ubparot/AQUAScan/deliverables/aquascan-nationals-update/AquaScan_Nationals_Update_Pages.docx

NATIONALS DEVELOPMENT UPDATE MAP

AquaScan did not remain frozen after the TSA States submission. The earlier portfolio documents the system that proved the core concept: a mobile vessel, deployable probe, Unity visualization, and field data workflow. The pages identified below document the next engineering cycle completed for Nationals.

How to read this revision: the original pages remain as evidence of the States baseline. These inserted pages show the problem identified after States, the refinement made, and the verified result.

Post-States Development Sequence

Stage | Engineering Focus | Result
States baseline | Prove collection, control, and visualization concept | Unity-based interface and working depth-aware data workflow
Field-access refinement | Reduce setup friction and improve operator access | Browser-based mission-control dashboard
Control-chain refinement | Improve communication reliability and safety feedback | WebSocket, ESP32, Arduino Mega, ESC, winch, and RS-485 telemetry chain
Data-use refinement | Move from viewing measurements toward interpreting patterns | MARIS experimental predictive-analysis model and research-analysis tools
Verification | Test software behavior and model pipeline | 26 web tests, production build, lint, and 7 ML tests passed on June 14, 2026

Inserted Page Guide

- Pages 16A-16B: web mission control and embedded communications iteration.
- Page 16C: MARIS experimental predictive analysis, placed directly before “What This Data Can Reveal.”
- Page 28A: problem-change-evidence-impact iteration record and current verification results.
- Page 29A: post-States development record showing continued engineering activity.

Current System Position

AquaScan is currently a working integrated prototype for calm, shallow, and sheltered water environments. Manual control, telemetry, mission replay, data visualization, probe communications, and the training/export path for MARIS have been implemented. Full autonomous route execution and field-validated MARIS inference remain future development.

POST-STATES ITERATION: FROM UNITY PROTOTYPE TO WEB MISSION CONTROL

The Unity interface shown on the preceding original portfolio page was the States baseline. It demonstrated that AquaScan data could be replayed, mapped, and connected to the vessel. After States, the team identified a field-use limitation: Unity required a dedicated installed application and made it harder to open the controls quickly on different operator devices.

Iteration decision: retain the proven mission-data and control concepts, but rebuild the operator interface as a browser-based field dashboard that can run locally and be opened from devices on the same network.

States Baseline | Post-States Web Refinement | Engineering Benefit
Unity desktop application | Local browser-based dashboard | Faster access and no Unity installation on the operator device
Mission replay and map layers | Replay, route planning, saved project files, and exportable bundles | Supports repeatable mission preparation and review
Live control concept | Direct WebSocket connection to the boat with visible connection state | Improves field awareness and troubleshooting
Single presentation-focused layout | Simple/advanced drive modes, light/dark themes, and tabbed controls | Separates essential control from detailed diagnostics

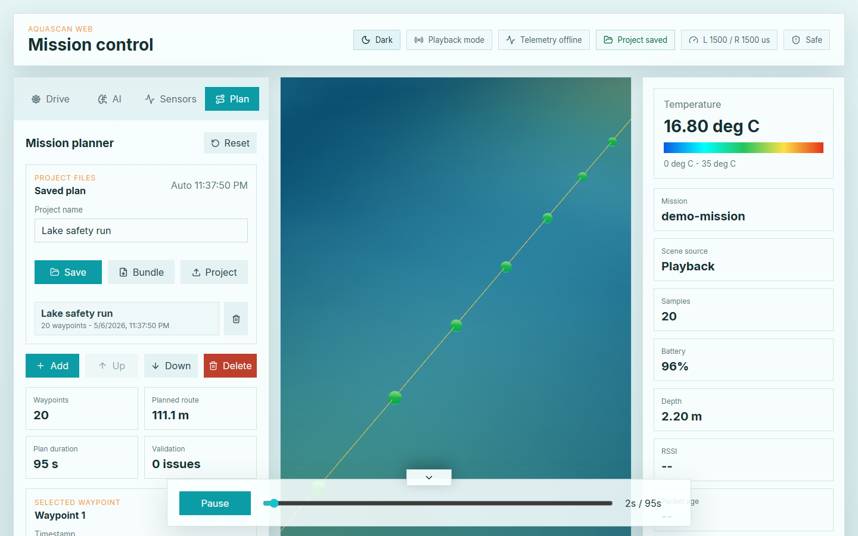
[picture p5: figure]

Current web mission planner showing saved route data, validation status, playback, and telemetry.

- Preserved capability: CSV/JSON mission loading, GPS route projection, sample points, heat maps, and timeline playback.
- Added capability: mission-plan editing, local project saving, preflight checks, direct live control, and browser-accessible operation.
- Current validation: the web application passes 26 automated tests, production build, and lint checks.

WEB FIELD SYSTEM AND EMBEDDED COMMUNICATIONS ITERATION

The interface change was paired with a deeper electronics and firmware refinement. The post-States system separates high-level operator commands, motor control, and probe sensing across communication links chosen for each task.

Current End-to-End Control and Data Path

Link | Current Function | Reason for Refinement
Browser dashboard → ESP32 | WebSocket commands, status, arming, E-stop, and live telemetry | Provides direct network control and immediate operator feedback
ESP32 → Arduino Mega | Full-duplex hardware UART control bridge | More reliable than the earlier bridge approach and keeps USB debug available
Arduino Mega → ESCs/winch | Applies motor pulses and deployment commands | Centralizes real-time actuator control and neutral-output behavior
Arduino Mega ↔ probe | Half-duplex RS-485 sensor communication | Supports longer tether communication and separates sensor traffic from drive control
Telemetry → dashboard | Sensor values, battery, RSSI, depth, motor output, and status | Turns hidden system state into visible diagnostic evidence


Browser mission-control dashboard showing route visualization, operator controls, and live system status.

Safety and Reliability Behaviors

- Safe startup: the system begins disarmed and commands neutral motor output.
- Loss-of-command response: disconnects, malformed messages, or command timeout force neutral output.
- Operator override: E-stop is visible in the dashboard and latches until reset.
- Debug visibility: Arduino and ESP32 status output makes command sequence, arm state, winch state, and motor outputs inspectable.

MARIS: EXPERIMENTAL PREDICTIVE ANALYSIS

MARIS is AquaScan’s first-pass machine-learning model for turning structured mission data into predictive research signals. It is an implemented proof of concept, not a field-validated decision system. MARIS demonstrates how future AquaScan missions could move beyond displaying measurements and begin forecasting or flagging conditions that deserve closer investigation.

Accurate framing: MARIS has been trained, evaluated, and exported as an ONNX model. The current primary dashboard still uses a transparent heuristic fallback while larger independent field datasets and live model integration are developed.

What MARIS Produces

- Current dissolved oxygen estimate: provides the model’s present-condition regression output.
- Dissolved oxygen forecasts: predicts values at +30, +60, and +120 minutes.
- Bloom-risk probability: identifies combinations of conditions associated with elevated bloom risk.
- Anomaly probability: flags unusual or potentially concerning water-quality patterns.

Development Evidence | Current Result | Interpretation
Training data | 3 real missions + 12 synthetic missions; 1,158 windows | Sufficient for proof of concept, not broad field validation
Evaluation data | 232 evaluation windows | Preliminary internal evaluation
Oxygen RMSE | 1.92 mg/L | Shows the current model still requires accuracy improvement
Forecast RMSE | 2.08 mg/L | Useful as a development benchmark, not a validated forecast claim
Bloom accuracy | 59.5% | Early-stage result; larger labeled datasets are required
Anomaly accuracy | 93.5% | Promising internal result, subject to label and dataset limitations
ONNX export | Validated; max output difference 0.00000095 | Confirms exported model matches the PyTorch output


Current dashboard research-analysis interface; the visible fallback label prevents experimental output from being presented as validated inference.

NATIONALS ITERATION EVIDENCE: PROBLEM → CHANGE → EVIDENCE → IMPACT

The largest post-States refinement was not one isolated feature. It was a system-level iteration focused on field usability, communications reliability, diagnostic visibility, and future data interpretation.

Problem Identified | Refinement Made | Evidence Available | Impact
Unity was effective for demonstration but less convenient across field devices. | Rebuilt the operator interface as a local React/Vite web dashboard. | Current dashboard screenshots; passing build and automated tests. | Faster access and a clearer path to use on laptops or tablets.
The earlier communications chain exposed limited diagnostic information. | Added explicit WebSocket status, sequence tracking, hardware UART bridge, and RS-485 probe telemetry. | Firmware source, serial-monitor output, and UI telemetry cards. | Makes failures easier to locate and system state easier to verify.
Operator controls needed stronger safety behavior. | Added disarmed startup, neutral timeout behavior, arm/disarm state, and latched E-stop. | Control contract and automated drive-mapping tests. | Reduces risk of unintended motor output during setup or communication loss.
Mission data existed as CSV/JSON but was difficult to organize as a repeatable project. | Added mission planning, validation, local project saving, and exportable bundles. | Saved-plan UI and route-tool tests. | Supports repeatable setup, review, and communication of mission data.
Visualizations explained the past but did not explore predictive use. | Developed MARIS training/export pipeline and research-analysis scaffolding. | PyTorch/ONNX artifacts, metrics report, and 7 passing ML tests. | Demonstrates a realistic future path while clearly documenting present limitations.

Verified June 14, 2026

- Web tests: 26 passed across mission loading, route planning, project files, control math, research metadata, and RS-485 sensor averaging.
- Web release checks: production build completed and lint completed without errors.
- ML checks: 7 tests passed across data loading, feature engineering, normalization, and training outputs.
- Model export: ONNX artifact exported and numerically validated against the PyTorch model.

Engineering significance: the system now preserves the functioning States prototype as evidence while showing a traceable cycle of limitation identification, redesign, implementation, and verification.

POST-STATES DEVELOPMENT RECORD

The following record supplements the original TSA work log by documenting major repository-backed development completed after the April 29, 2026 States portfolio submission.

Date | Development Activity | Result / Evidence
04/30/26 | Expanded live-control WebSocket and metrics integration. | Control and data behavior incorporated into the evolving software system.
05/05/26 | Developed and tested first-pass multi-task ML pipeline. | MARIS training code, PyTorch checkpoint, ONNX export, normalization data, and metrics report.
05/06/26 | Created the browser-based AquaScan dashboard. | React/Vite/Three.js dashboard with mission loading, visualization, drive controls, and tests.
05/08-05/10/26 | Integrated project-wide software, visualization, and control updates. | Consolidated system capable of playback, live control, and expanded data interpretation.
05/28/26 | Expanded planning, project-file, preflight, and research-analysis tools. | Saved routes, validation feedback, project bundles, and research-analysis scaffolding.
06/07/26 | Added RS-485 sensor pipeline and UI telemetry. | Separated probe sensing from motor-control communications and surfaced telemetry in the dashboard.
06/11-06/12/26 | Validated current bridge/control behavior and captured evidence. | Serial-monitor and connected-dashboard evidence of the control chain.
06/14/26 | Ran current verification suite and prepared Nationals portfolio update. | 26 web tests passed; build/lint passed; 7 ML tests passed.

Current Limitations Carried Forward

- MARIS validation: requires substantially more independent real-water mission data and external validation.
- Autonomy: manual control and mission planning are implemented; full autonomous route execution remains a planned refinement.
- Depth accuracy: probe depth is still estimated from tether deployment rather than measured with a pressure sensor.
- Sensor accuracy: continued calibration and optical-window refinement are required for stronger scientific claims.

These limitations are included because the purpose of iteration is not to claim that every problem is solved. They define the next measurable engineering cycle for AquaScan.
