ubparot/AQUAScan/.codex_arduino_monitor.png

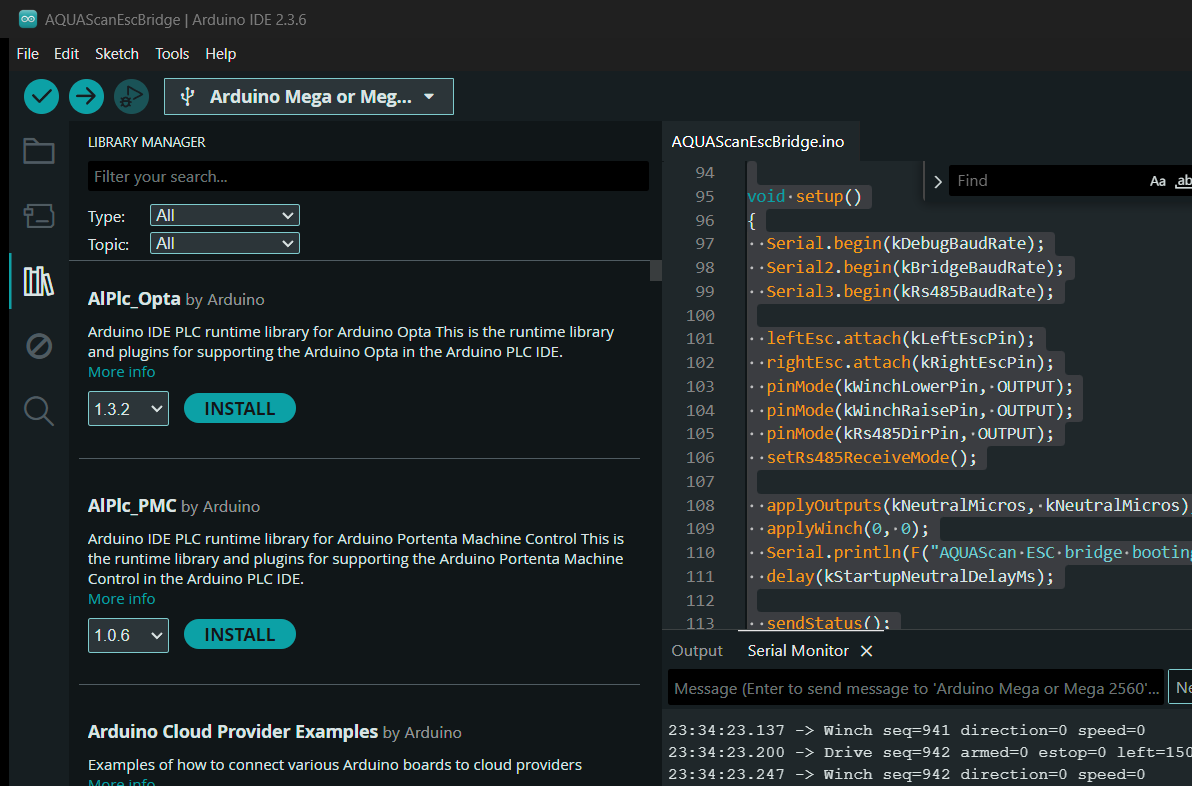
.codex_arduino_monitor.png
