ubparot/AQUAScan/.codex_arduino_monitor_crop.png

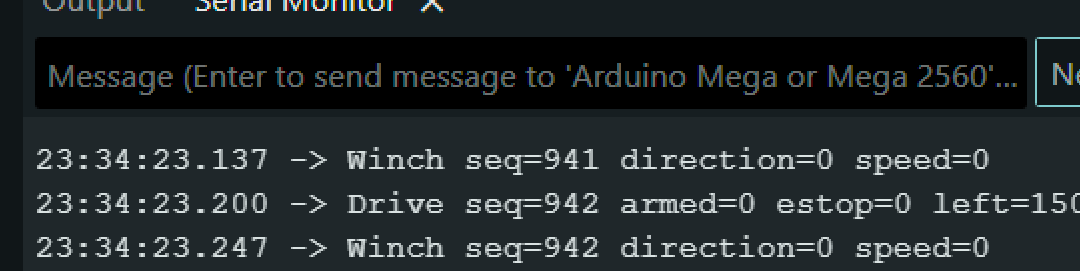
.codex_arduino_monitor_crop.png
