ubparot/AQUAScan/.codex_web_deep.png

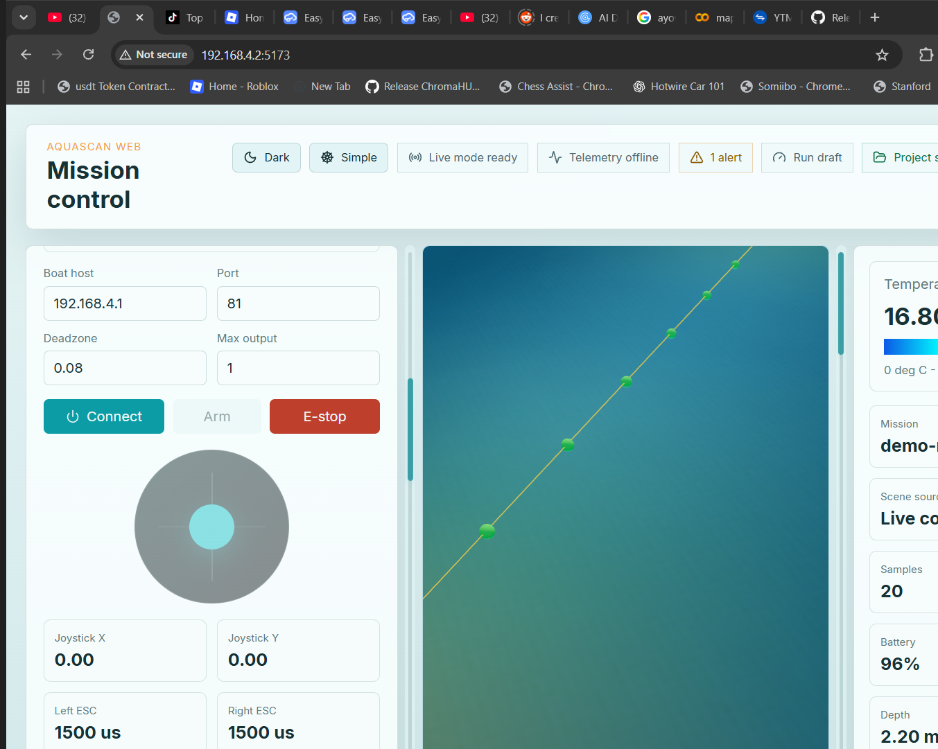
.codex_web_deep.png
