ubparot/AQUAScan/.codex_web_now.png

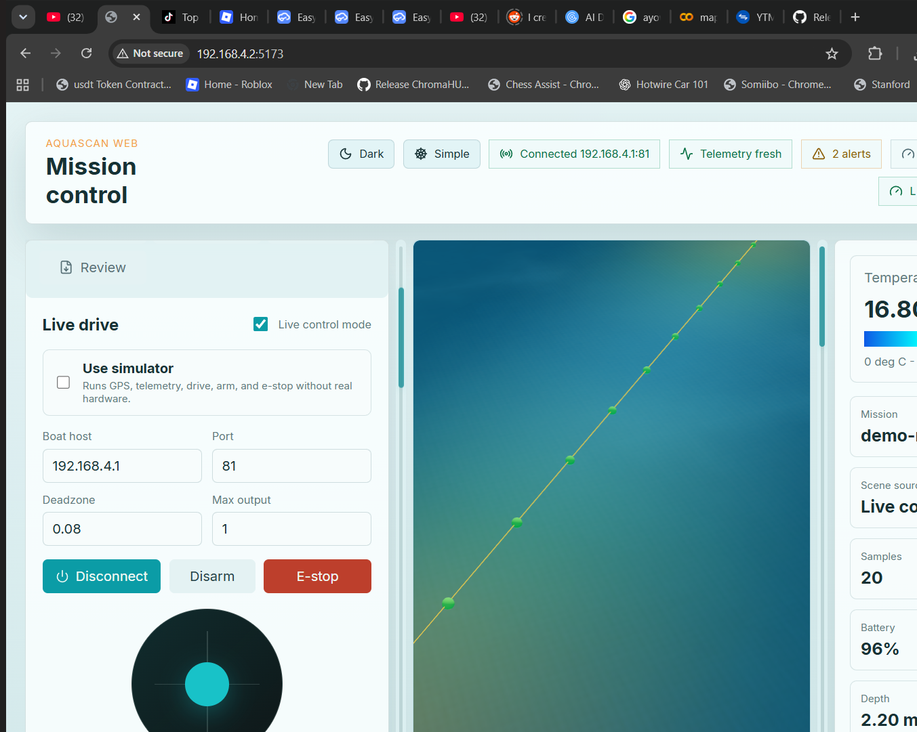
.codex_web_now.png
