ubparot/AQUAScan/Assets/Alstra Infinite/Props LowPoly/Previews/LowPoly_Furnace.png

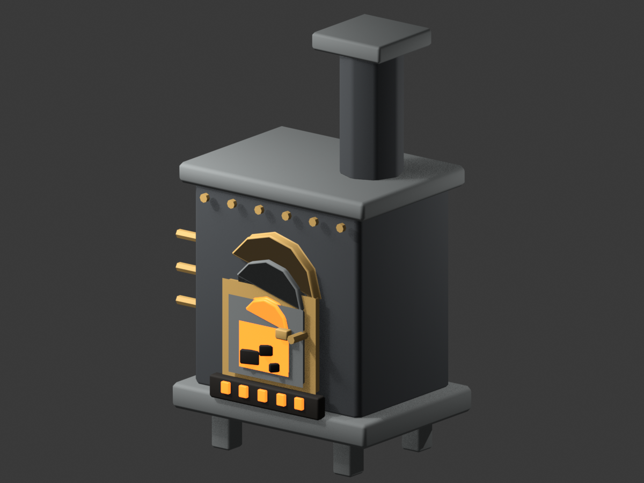
Assets/Alstra Infinite/Props LowPoly/Previews/LowPoly_Furnace.png
