ubparot/AQUAScan/deliverables/aquascan-nationals-update/merged-preview/page-01.png

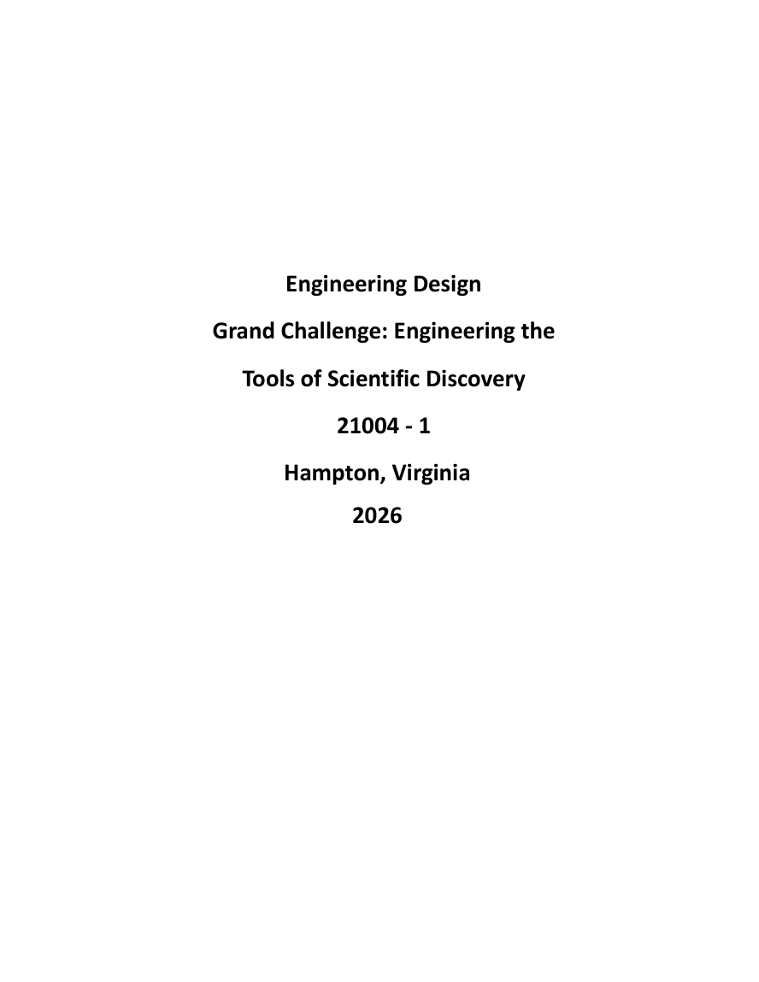
deliverables/aquascan-nationals-update/merged-preview/page-01.png
