ubparot/AQUAScan/deliverables/maris-visuals/maris-mission-interpretation.png

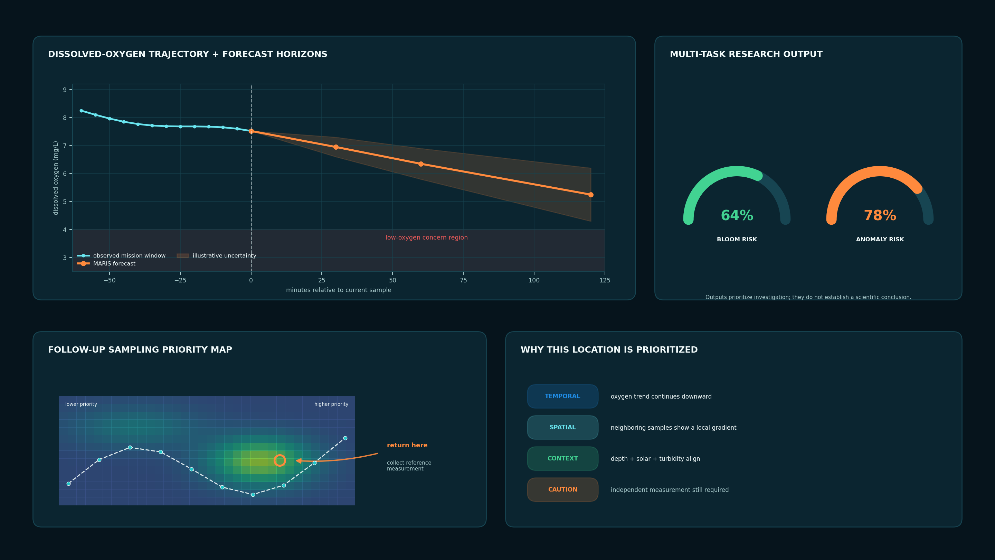
deliverables/maris-visuals/maris-mission-interpretation.png
