ubparot/AQUAScan/deliverables/maris-visuals/maris-model-architecture.png

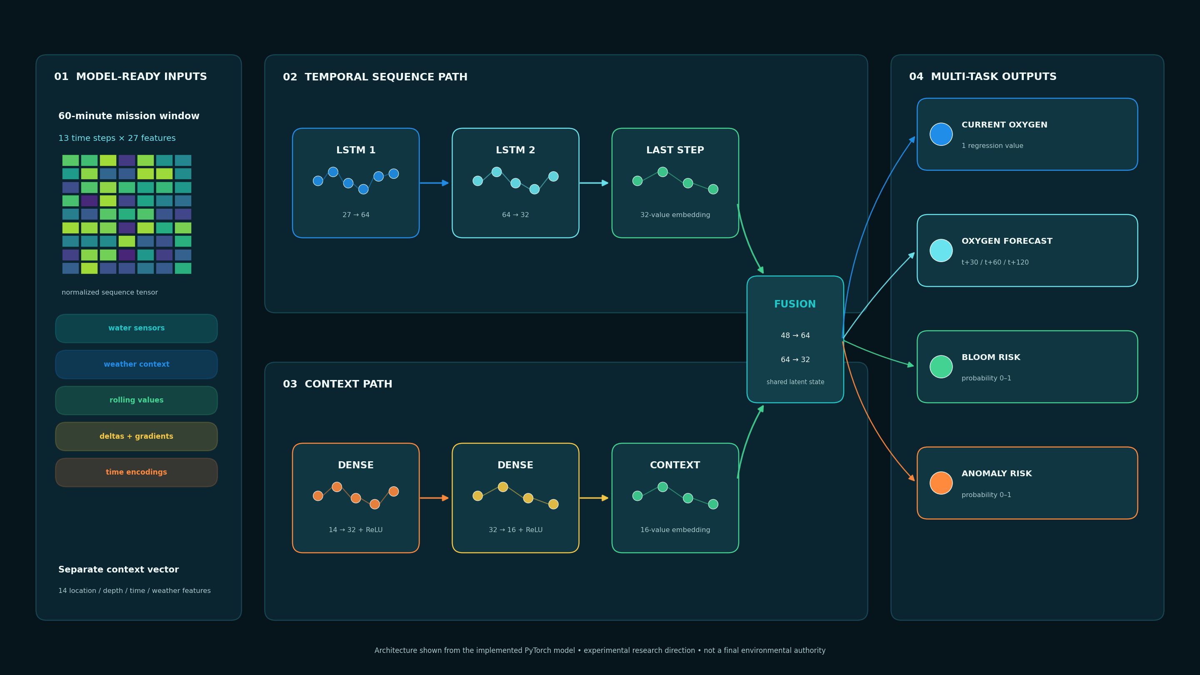
deliverables/maris-visuals/maris-model-architecture.png
