ubparot/AQUAScan/deliverables/visuals/aquascan-probe-deployment-system.png

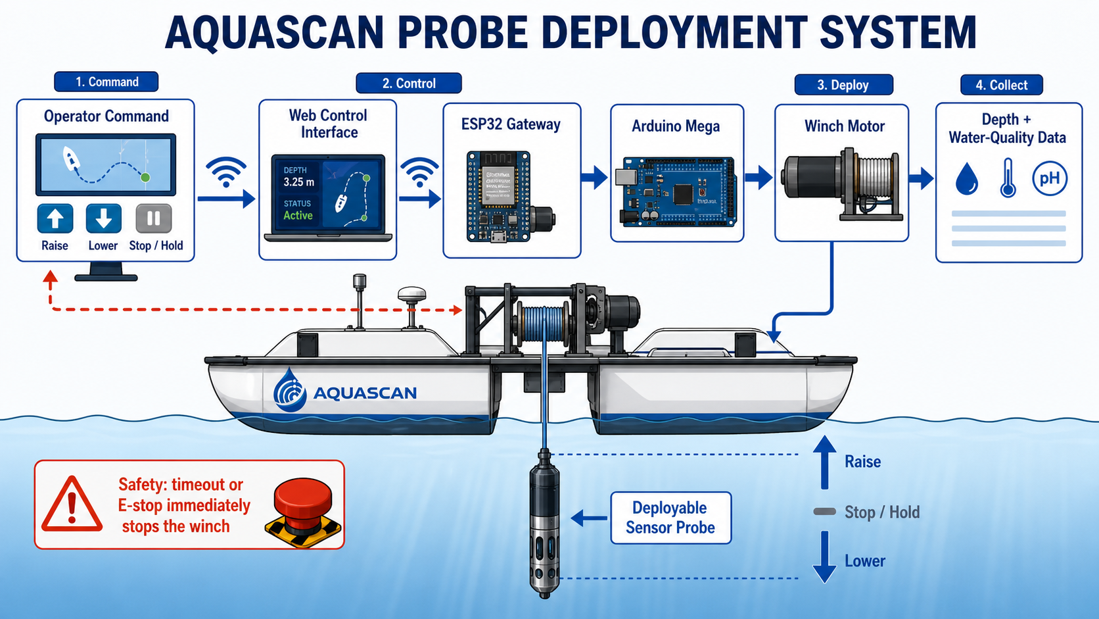
deliverables/visuals/aquascan-probe-deployment-system.png
