ubparot/AQUAScan/EngineeringDesignAQUASCAN/_analysis_outputs/21004 - 1_contact_sheet.png

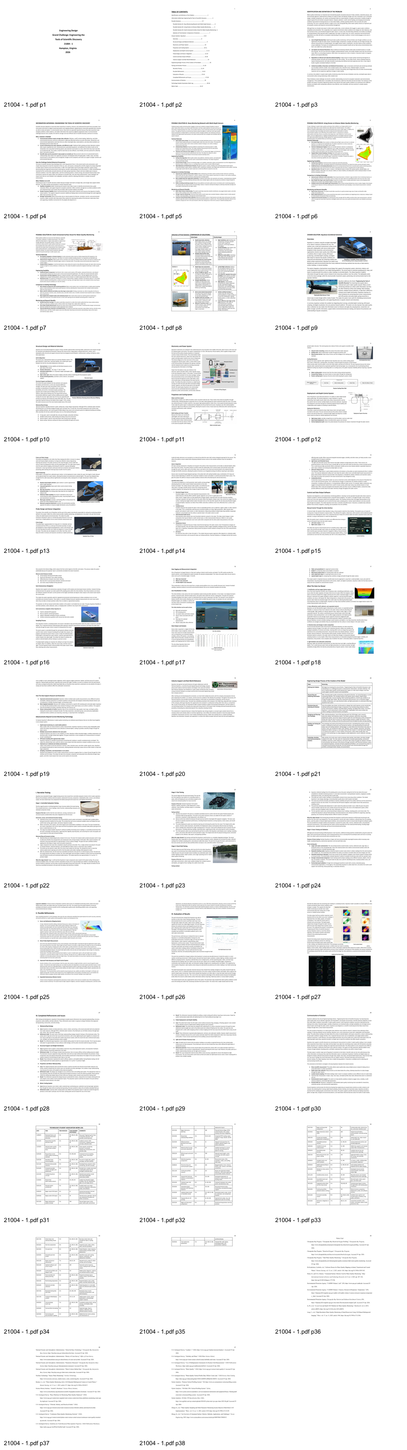
EngineeringDesignAQUASCAN/_analysis_outputs/21004 - 1_contact_sheet.png
