ubparot/AQUAScan/EngineeringDesignAQUASCAN/_analysis_outputs/21004 - 1_pages/page-20.png

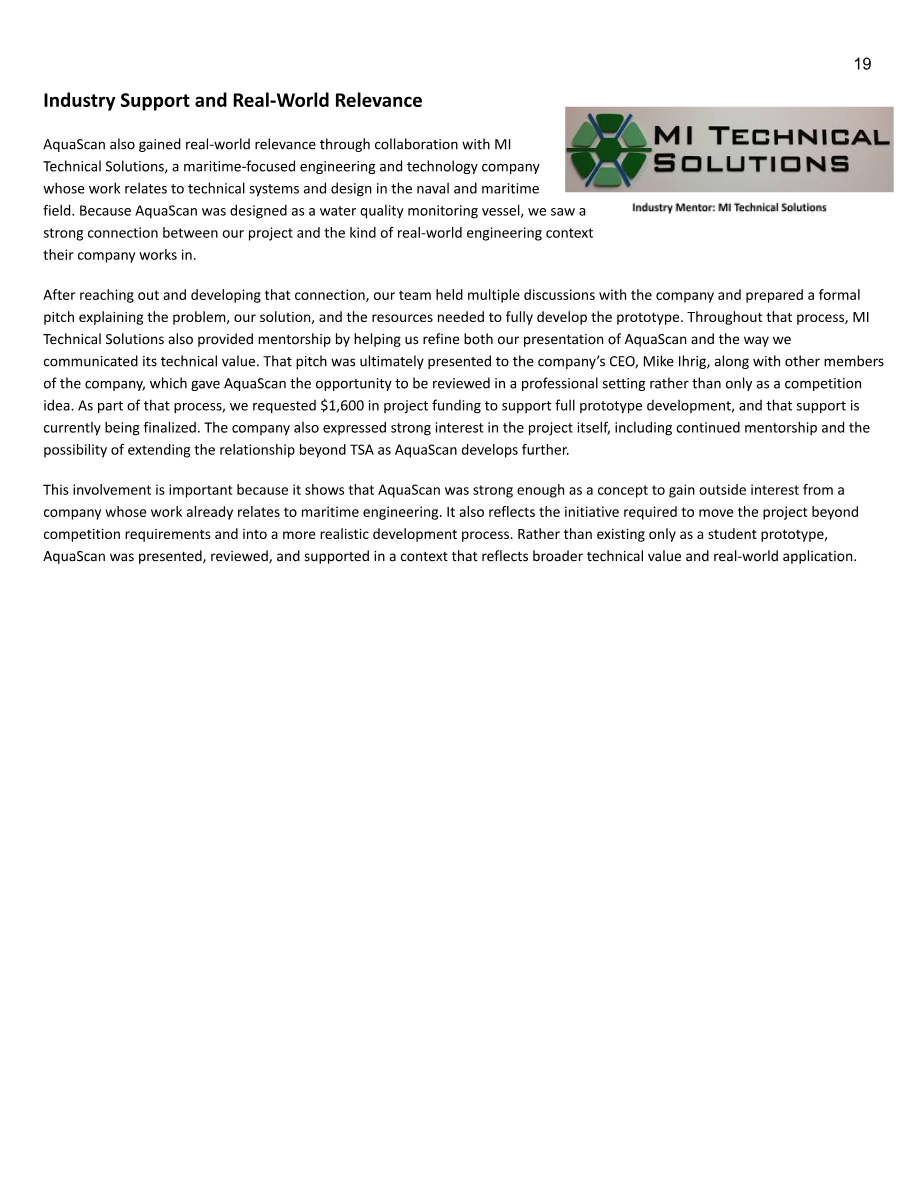
EngineeringDesignAQUASCAN/_analysis_outputs/21004 - 1_pages/page-20.png
