ubparot/AQUAScan/EngineeringDesignAQUASCAN/_analysis_outputs/21004 - 1_pages/page-35.png

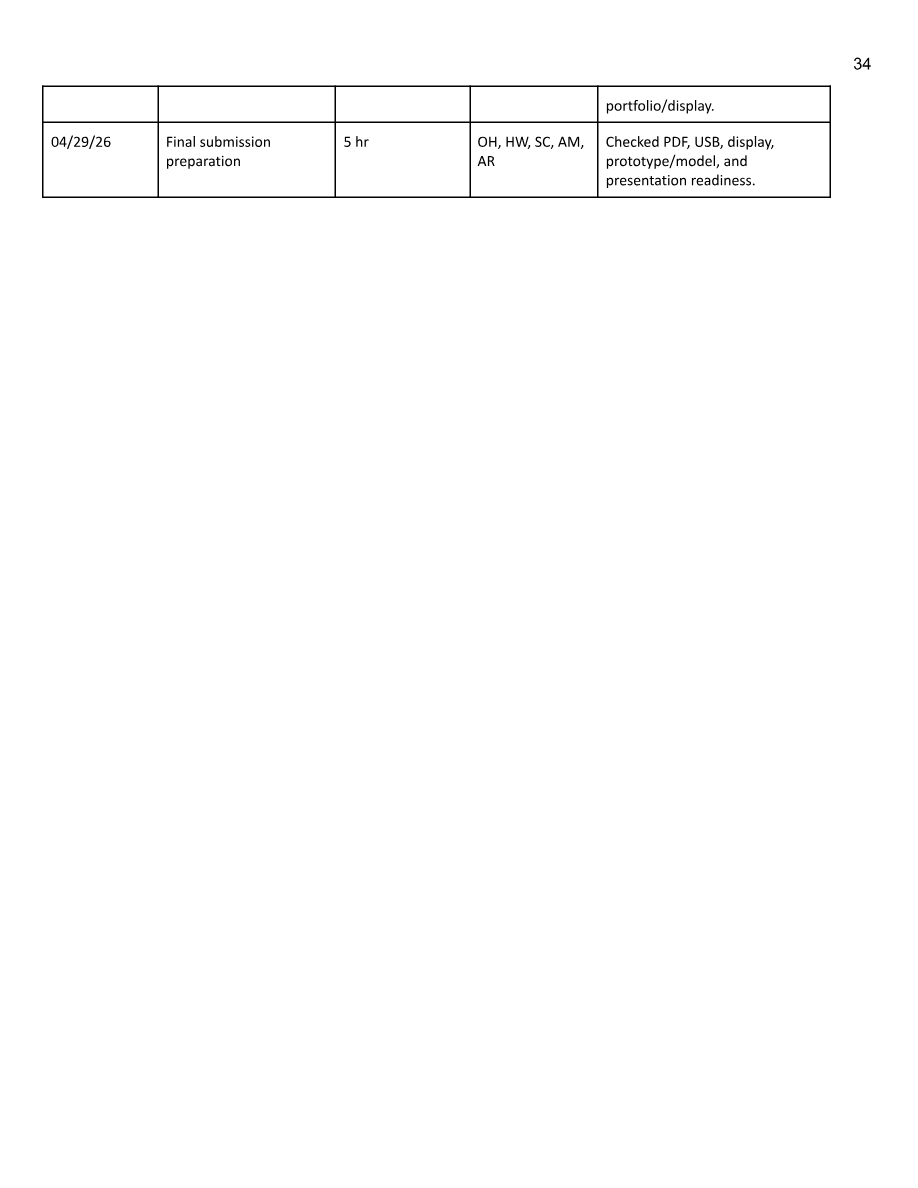
EngineeringDesignAQUASCAN/_analysis_outputs/21004 - 1_pages/page-35.png
