ubparot/AQUAScan/EngineeringDesignAQUASCAN/_analysis_outputs/21004 - 1_pages/thumb-31.png

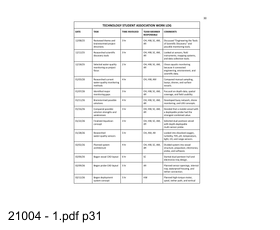
EngineeringDesignAQUASCAN/_analysis_outputs/21004 - 1_pages/thumb-31.png
