ubparot/AQUAScan/EngineeringDesignAQUASCAN/_analysis_outputs/AquaScan Presentation_contact_sheet.png

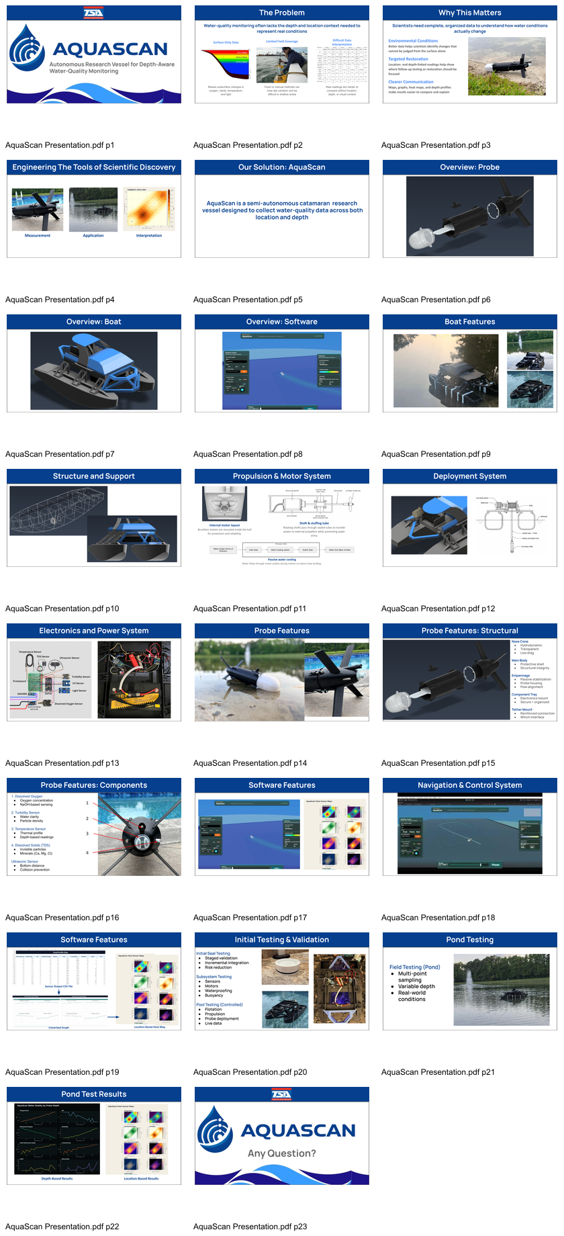
EngineeringDesignAQUASCAN/_analysis_outputs/AquaScan Presentation_contact_sheet.png
