ubparot/AQUAScan/EngineeringDesignAQUASCAN/_analysis_outputs/AquaScan Presentation_pages/page-13.png

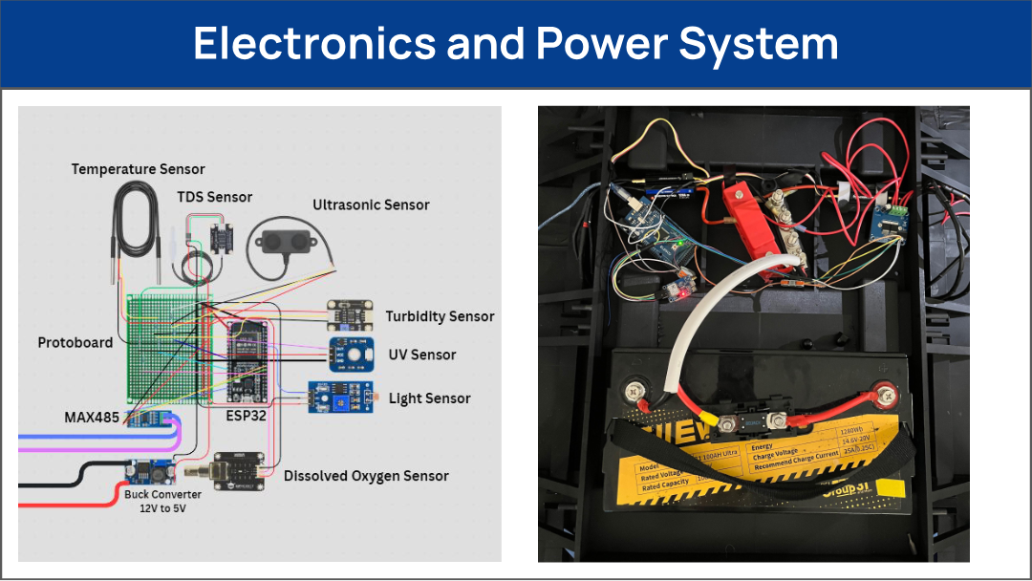
EngineeringDesignAQUASCAN/_analysis_outputs/AquaScan Presentation_pages/page-13.png
