ubparot/AQUAScan/EngineeringDesignAQUASCAN/_analysis_outputs/AquaScan Presentation_pages/page-19.png

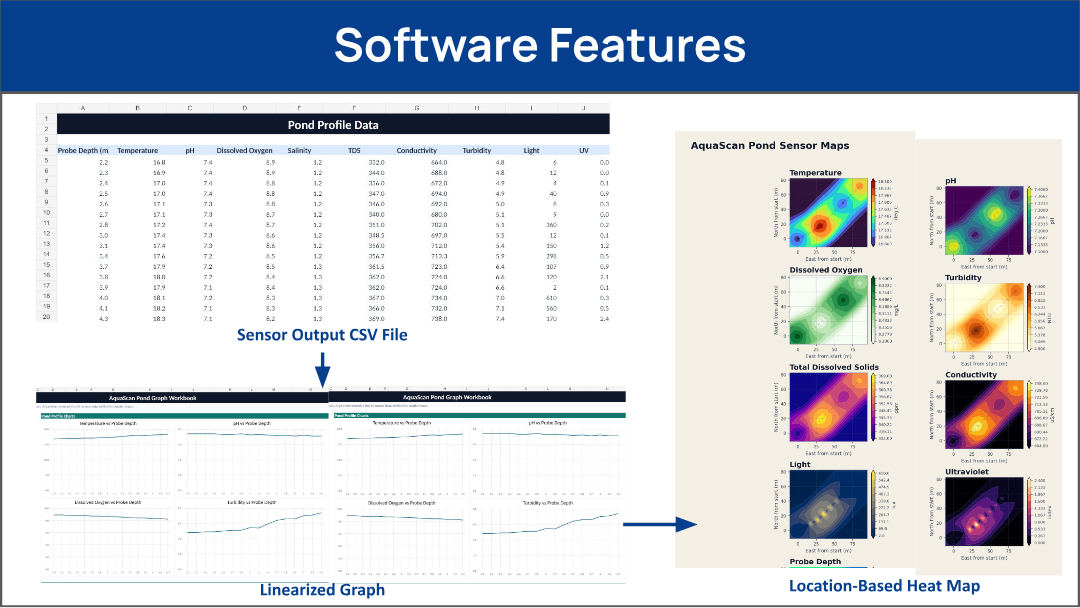
EngineeringDesignAQUASCAN/_analysis_outputs/AquaScan Presentation_pages/page-19.png
