ubparot/AQUAScan/EngineeringDesignAQUASCAN/_analysis_outputs/AquaScan Presentation_pages/page-22.png

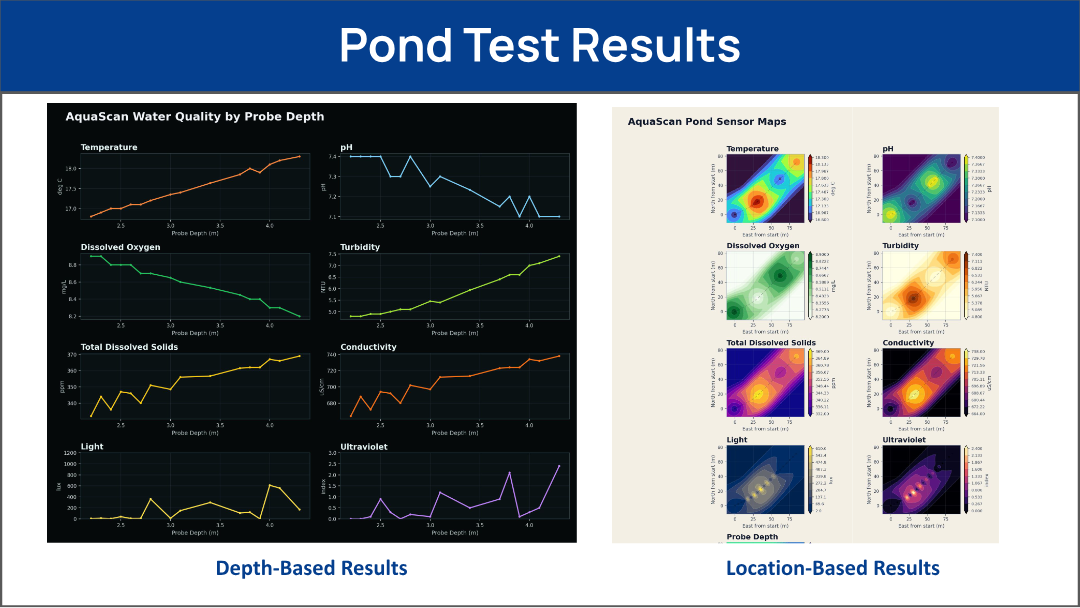
EngineeringDesignAQUASCAN/_analysis_outputs/AquaScan Presentation_pages/page-22.png
