ubparot/AQUAScan/EngineeringDesignAQUASCAN/_analysis_outputs/AquaScan Presentation_pages/page-23.png

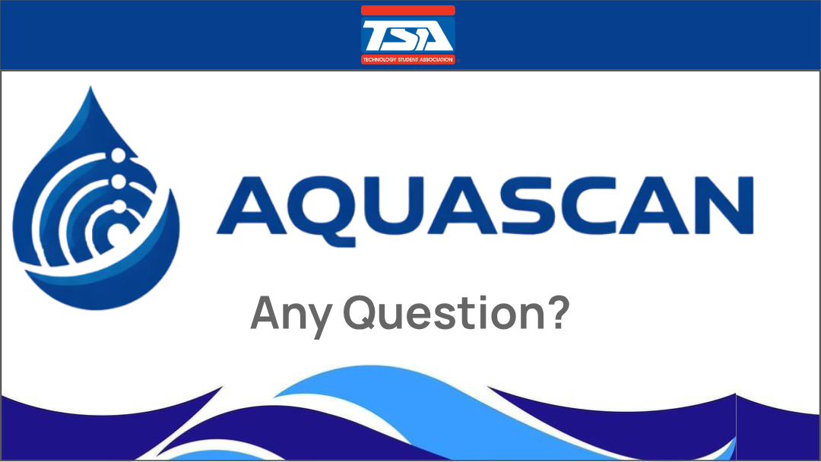
EngineeringDesignAQUASCAN/_analysis_outputs/AquaScan Presentation_pages/page-23.png
