ubparot/AQUAScan/EngineeringDesignAQUASCAN/_analysis_outputs/AquaScan Presentation_pages/thumb-02.png

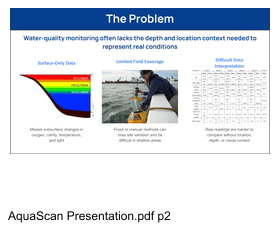
EngineeringDesignAQUASCAN/_analysis_outputs/AquaScan Presentation_pages/thumb-02.png
