ubparot/AQUAScan/EngineeringDesignAQUASCAN/_analysis_outputs/AquaScan Presentation_pages/thumb-03.png

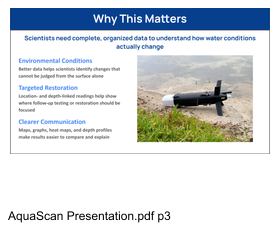
EngineeringDesignAQUASCAN/_analysis_outputs/AquaScan Presentation_pages/thumb-03.png
