ubparot/AQUAScan/EngineeringDesignAQUASCAN/_analysis_outputs/AquaScan Presentation_pages/thumb-05.png

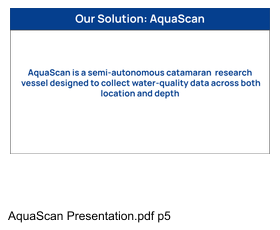
EngineeringDesignAQUASCAN/_analysis_outputs/AquaScan Presentation_pages/thumb-05.png
