ubparot/AQUAScan/EngineeringDesignAQUASCAN/_analysis_outputs/AquaScan_Nationals_Critique_preview/contact_sheet.png

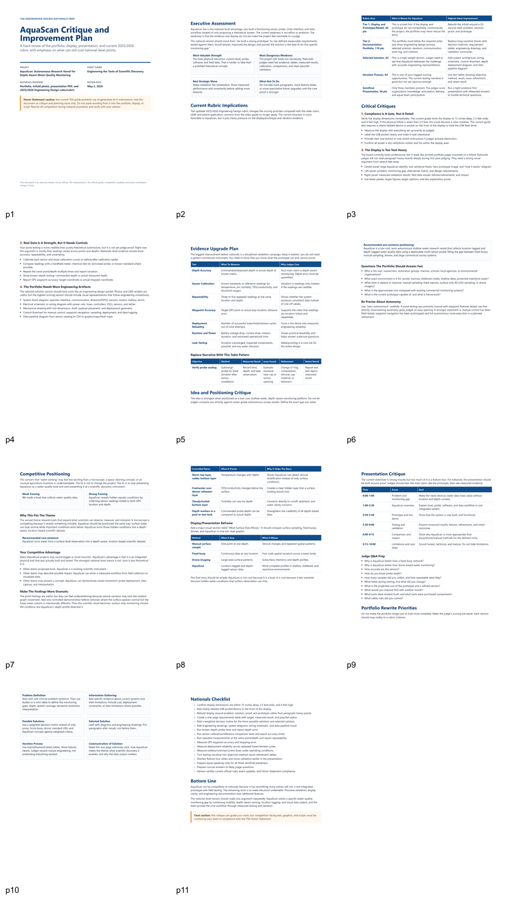
EngineeringDesignAQUASCAN/_analysis_outputs/AquaScan_Nationals_Critique_preview/contact_sheet.png
