ubparot/AQUAScan/EngineeringDesignAQUASCAN/_analysis_outputs/AquaScan_Nationals_Critique_preview/page-01.png

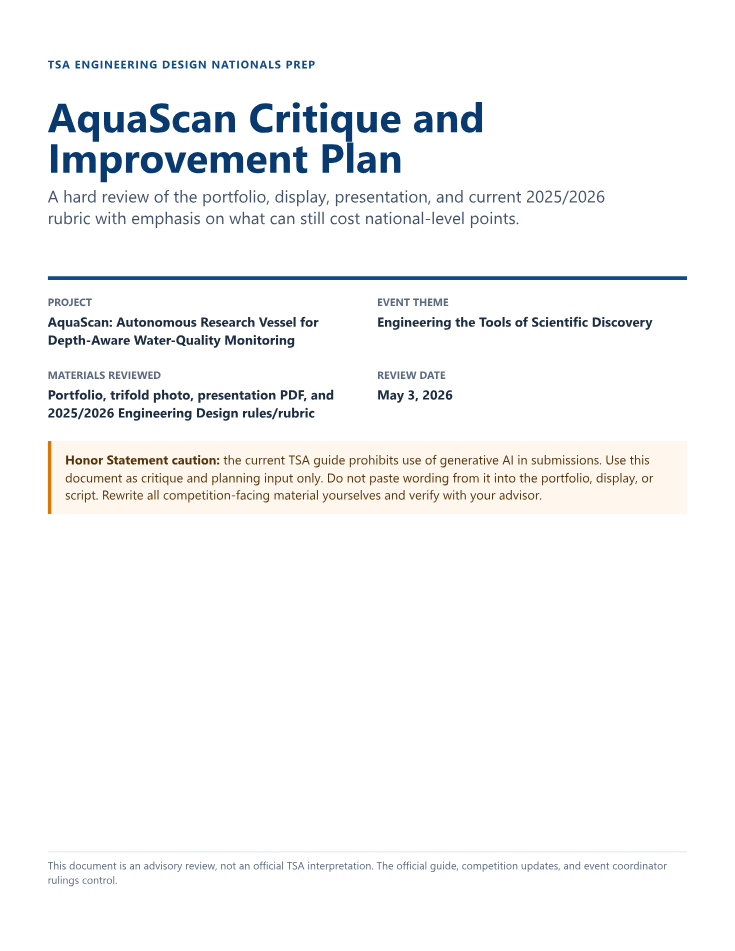
EngineeringDesignAQUASCAN/_analysis_outputs/AquaScan_Nationals_Critique_preview/page-01.png
