ubparot/AQUAScan/EngineeringDesignAQUASCAN/_analysis_outputs/AquaScan_Nationals_Critique_preview/page-04.png

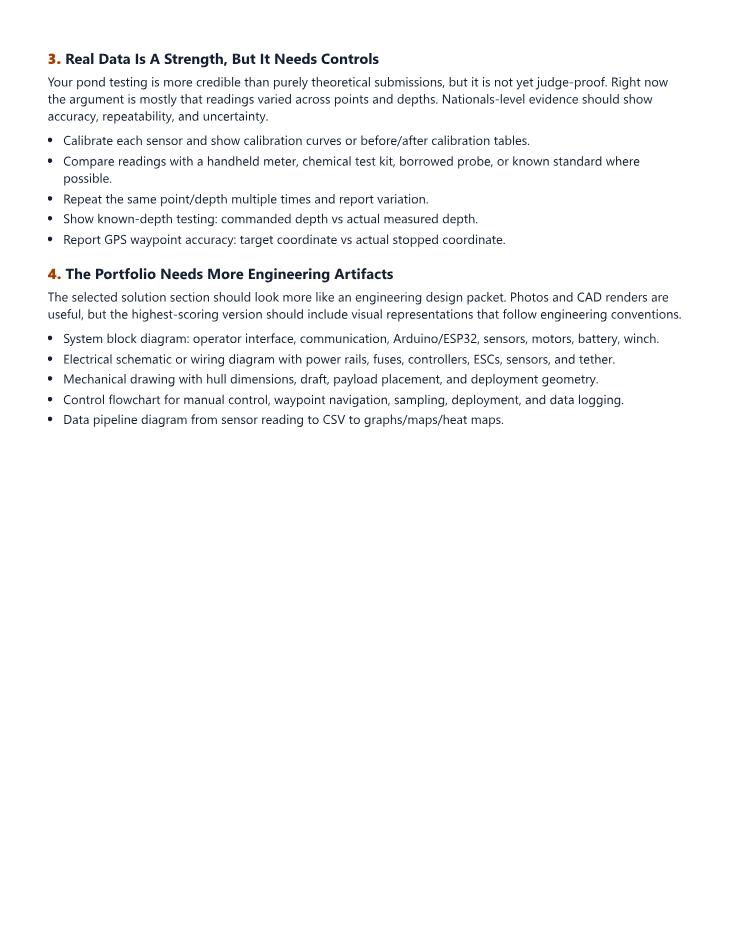
EngineeringDesignAQUASCAN/_analysis_outputs/AquaScan_Nationals_Critique_preview/page-04.png
