ubparot/AQUAScan/EngineeringDesignAQUASCAN/_analysis_outputs/engineering_design_contact_sheet.png

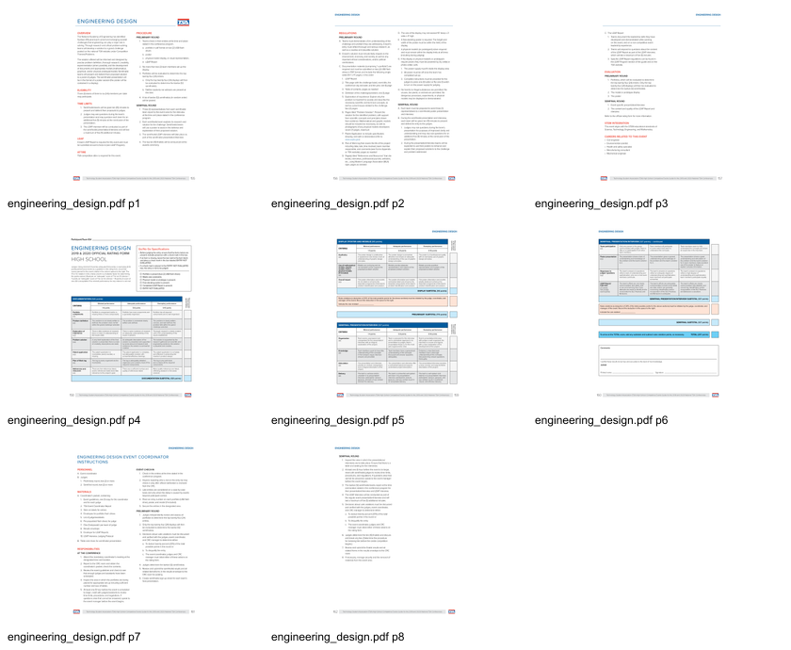
EngineeringDesignAQUASCAN/_analysis_outputs/engineering_design_contact_sheet.png
