ubparot/AQUAScan/EngineeringDesignAQUASCAN/_analysis_outputs/engineering_design_pages/page-04.png

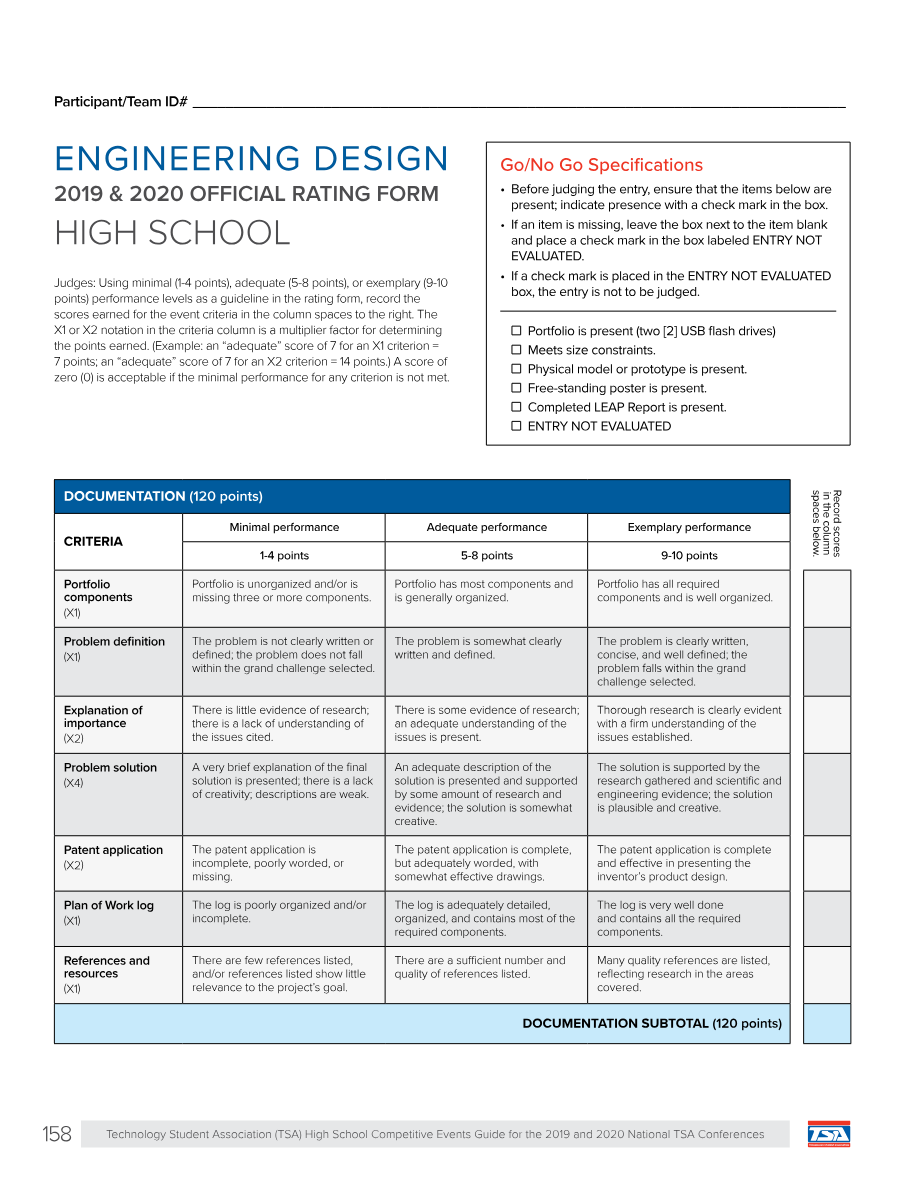
EngineeringDesignAQUASCAN/_analysis_outputs/engineering_design_pages/page-04.png
