ubparot/AQUAScan/EngineeringDesignAQUASCAN/_analysis_outputs/engineering_design_pages/page-05.png

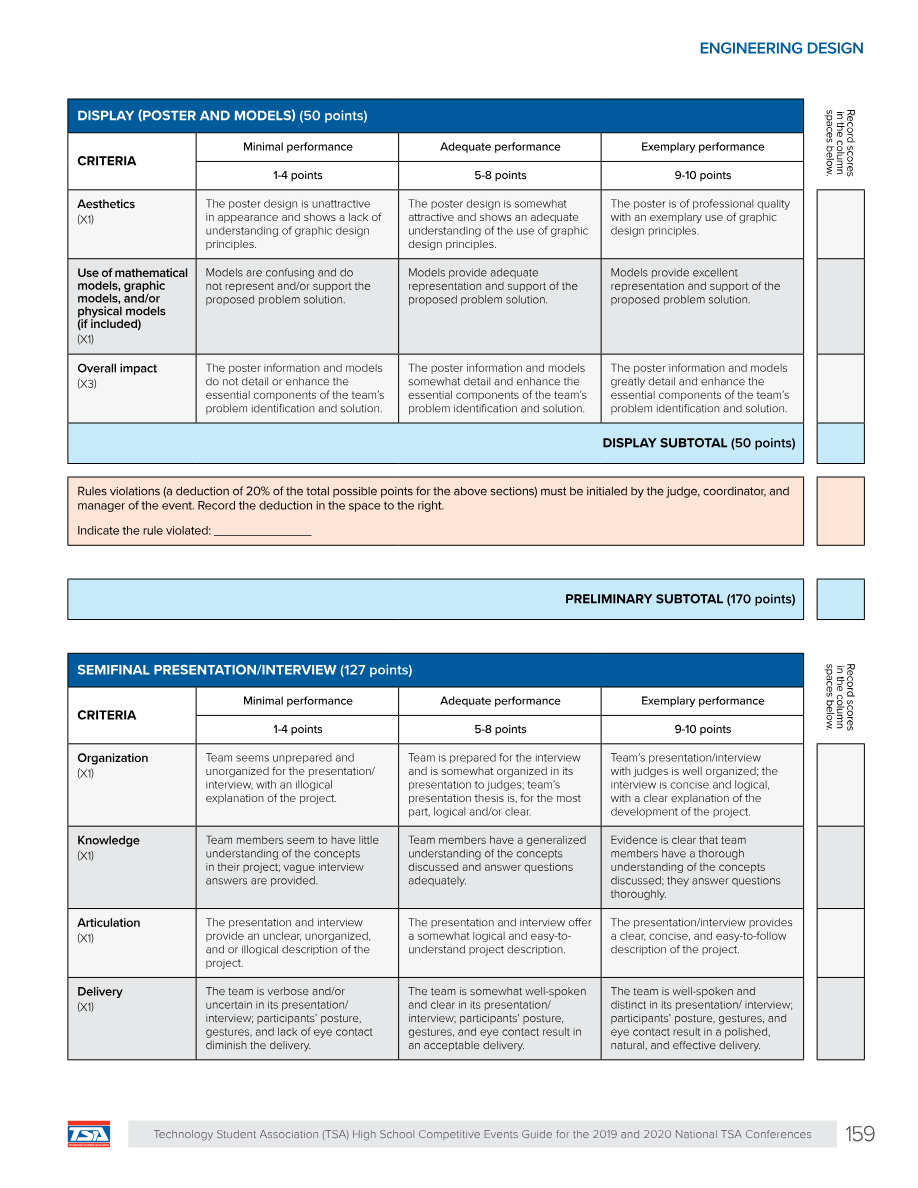
EngineeringDesignAQUASCAN/_analysis_outputs/engineering_design_pages/page-05.png
