ubparot/AQUAScan/EngineeringDesignAQUASCAN/_analysis_outputs/engineering_design_pages/page-08.png

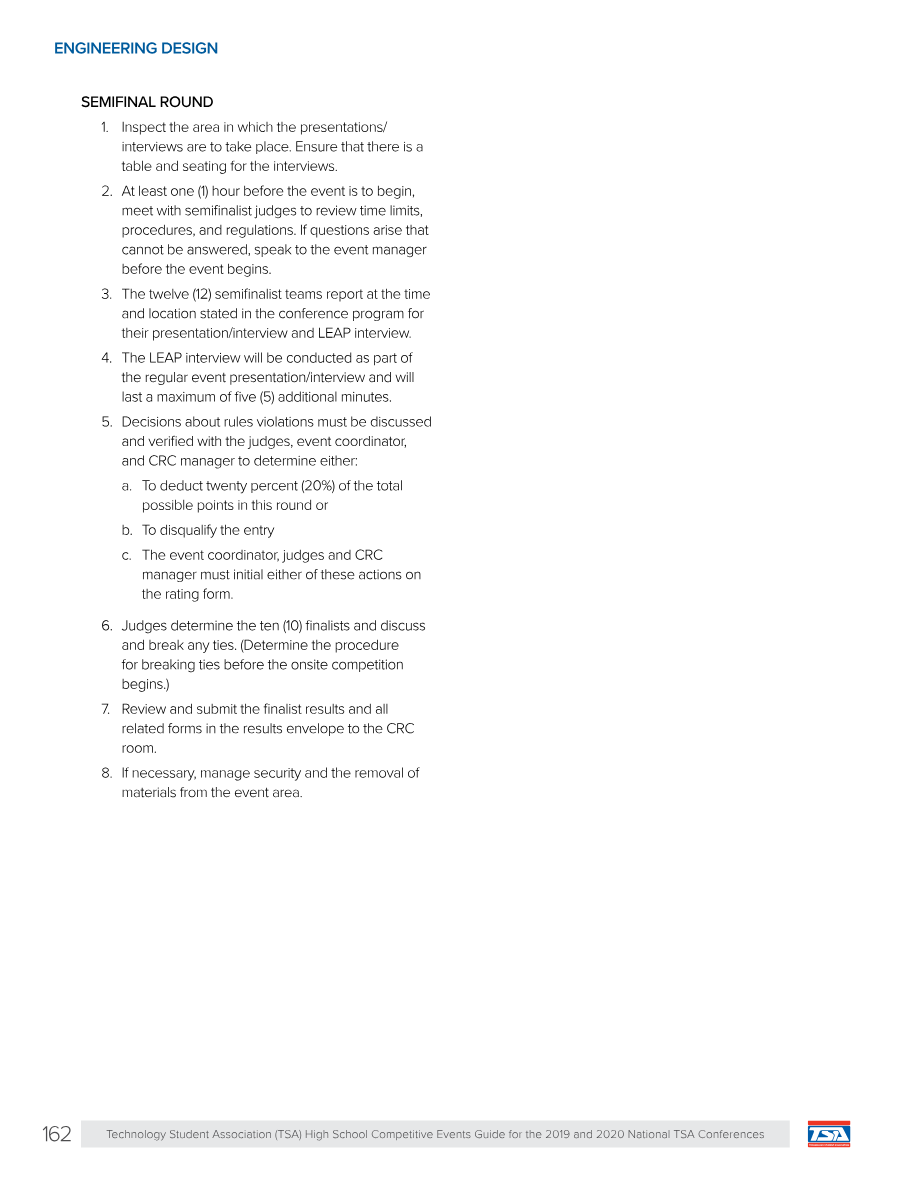
EngineeringDesignAQUASCAN/_analysis_outputs/engineering_design_pages/page-08.png
