ubparot/AQUAScan/EngineeringDesignAQUASCAN/_analysis_outputs/engineering_design_pages/thumb-02.png

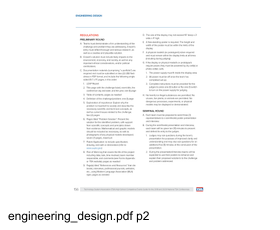
EngineeringDesignAQUASCAN/_analysis_outputs/engineering_design_pages/thumb-02.png
