ubparot/AQUAScan/EngineeringDesignAQUASCAN/_analysis_outputs/engineering_design_pages/thumb-03.png

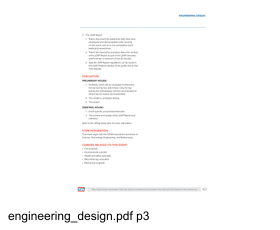
EngineeringDesignAQUASCAN/_analysis_outputs/engineering_design_pages/thumb-03.png
