ubparot/AQUAScan/EngineeringDesignAQUASCAN/_analysis_outputs/engineering_design_pages/thumb-04.png

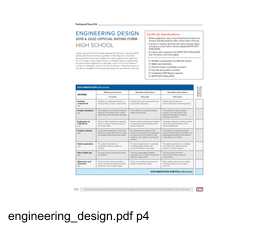
EngineeringDesignAQUASCAN/_analysis_outputs/engineering_design_pages/thumb-04.png
