ubparot/AQUAScan/EngineeringDesignAQUASCAN/_analysis_outputs/engineering_design_pages/thumb-06.png

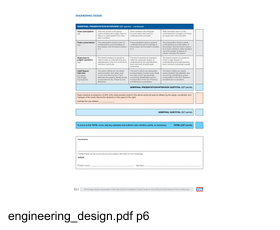
EngineeringDesignAQUASCAN/_analysis_outputs/engineering_design_pages/thumb-06.png
