ubparot/AQUAScan/EngineeringDesignAQUASCAN/_analysis_outputs/HS - Engineering Design_contact_sheet.png

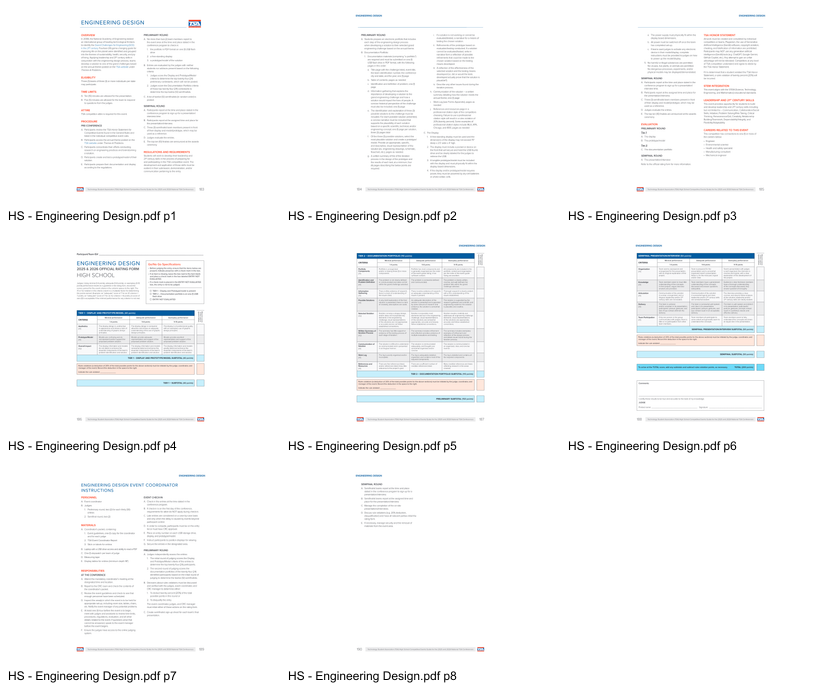
EngineeringDesignAQUASCAN/_analysis_outputs/HS - Engineering Design_contact_sheet.png
