ubparot/AQUAScan/EngineeringDesignAQUASCAN/_analysis_outputs/HS - Engineering Design_pages/page-02.png

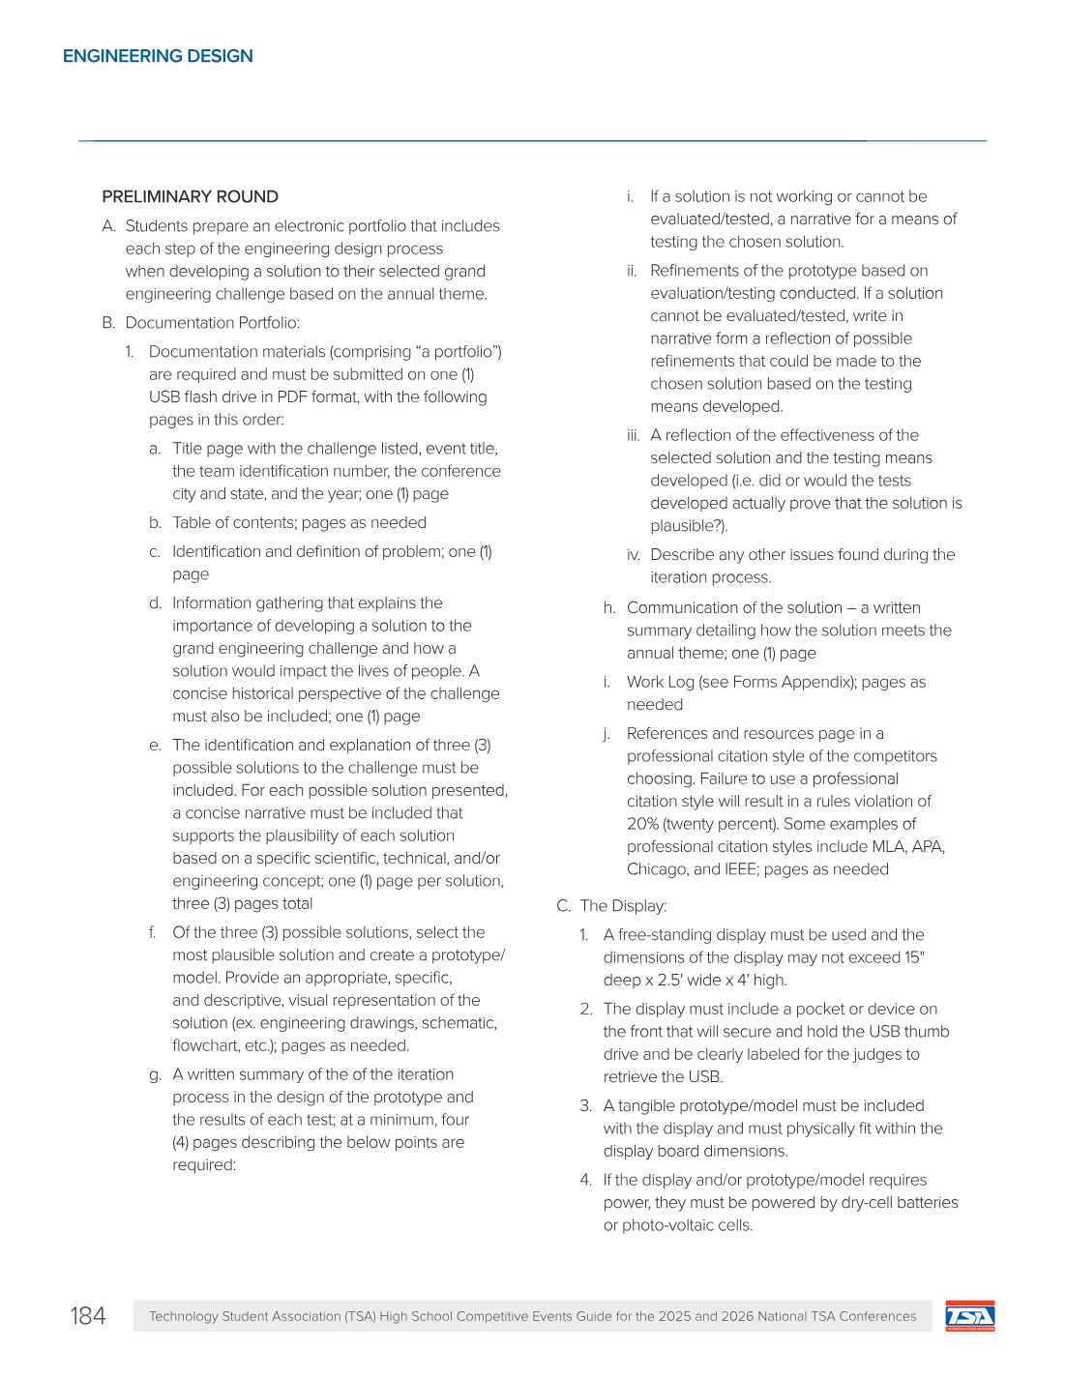
EngineeringDesignAQUASCAN/_analysis_outputs/HS - Engineering Design_pages/page-02.png
