ubparot/AQUAScan/EngineeringDesignAQUASCAN/_analysis_outputs/HS - Engineering Design_pages/page-03.png

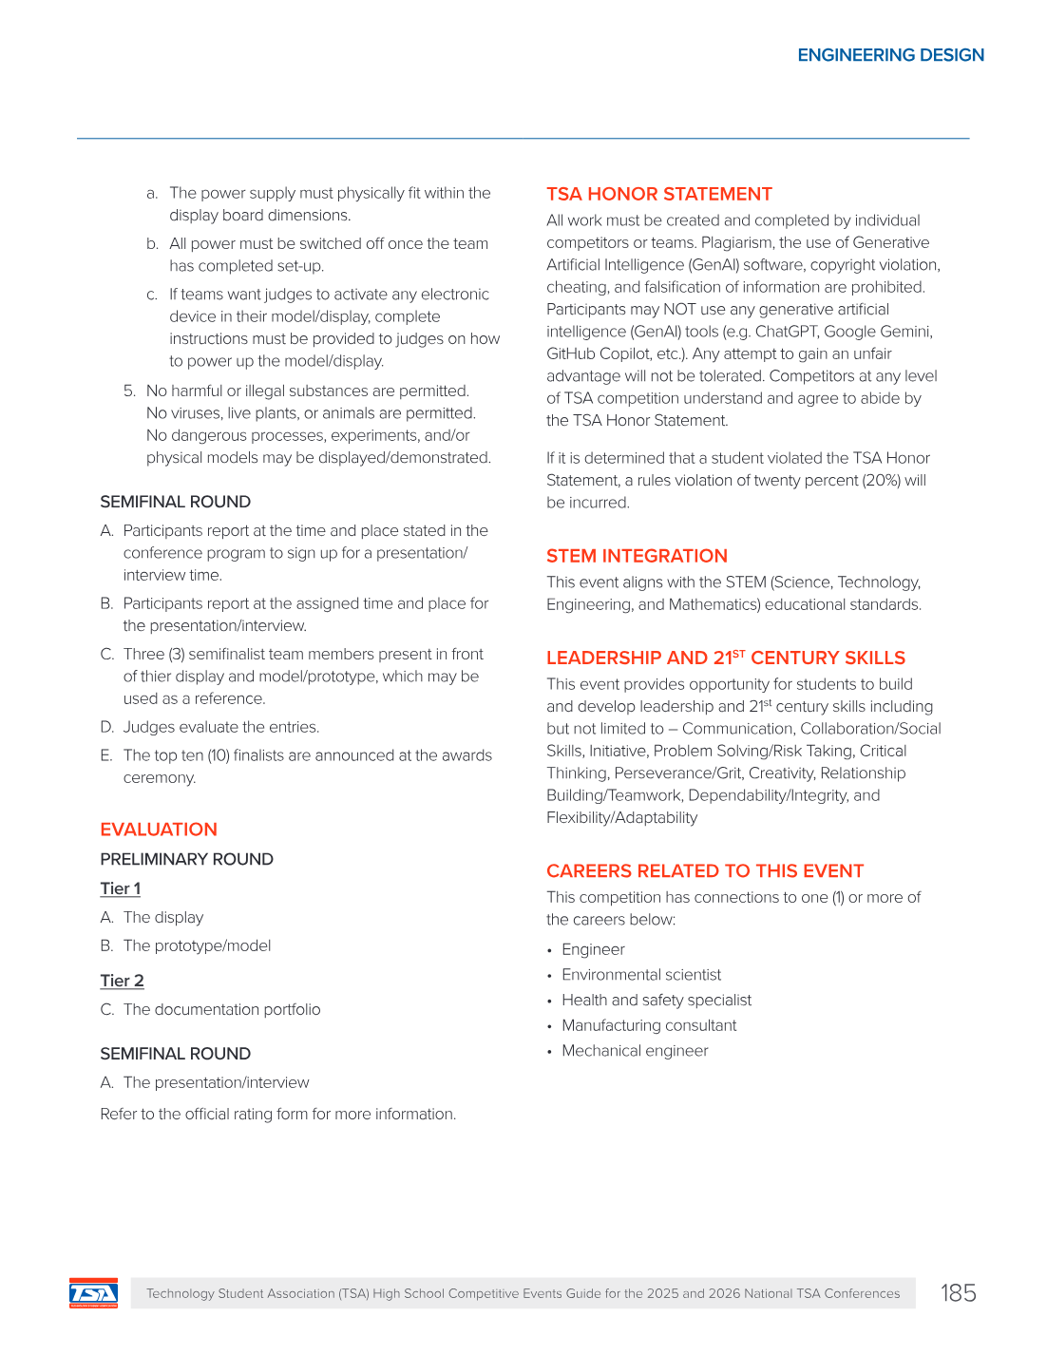
EngineeringDesignAQUASCAN/_analysis_outputs/HS - Engineering Design_pages/page-03.png
