ubparot/AQUAScan/EngineeringDesignAQUASCAN/_analysis_outputs/HS - Engineering Design_pages/page-05.png

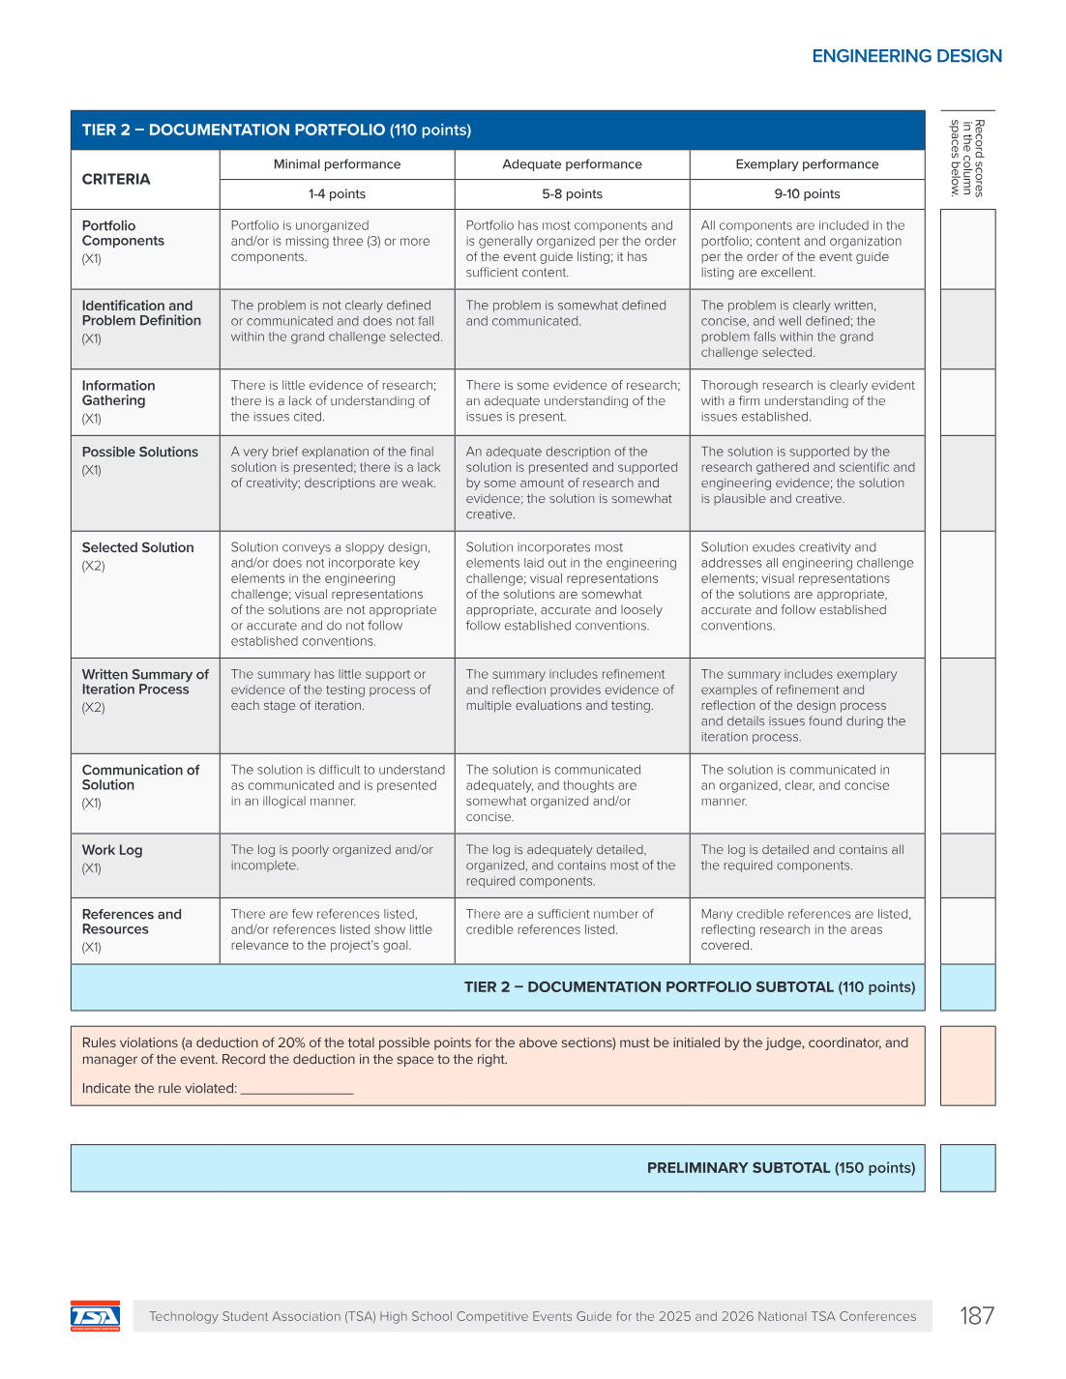
EngineeringDesignAQUASCAN/_analysis_outputs/HS - Engineering Design_pages/page-05.png
