ubparot/AQUAScan/EngineeringDesignAQUASCAN/_analysis_outputs/HS - Engineering Design_pages/thumb-02.png

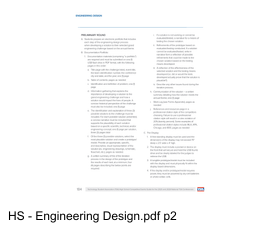
EngineeringDesignAQUASCAN/_analysis_outputs/HS - Engineering Design_pages/thumb-02.png
