ubparot/AQUAScan/EngineeringDesignAQUASCAN/_analysis_outputs/HS - Engineering Design_pages/thumb-04.png

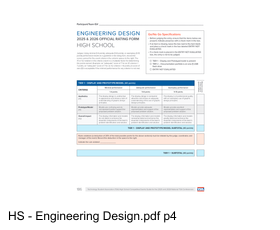
EngineeringDesignAQUASCAN/_analysis_outputs/HS - Engineering Design_pages/thumb-04.png
