ubparot/AQUAScan/PortfolioAreaGraphs/area_conductivity.png

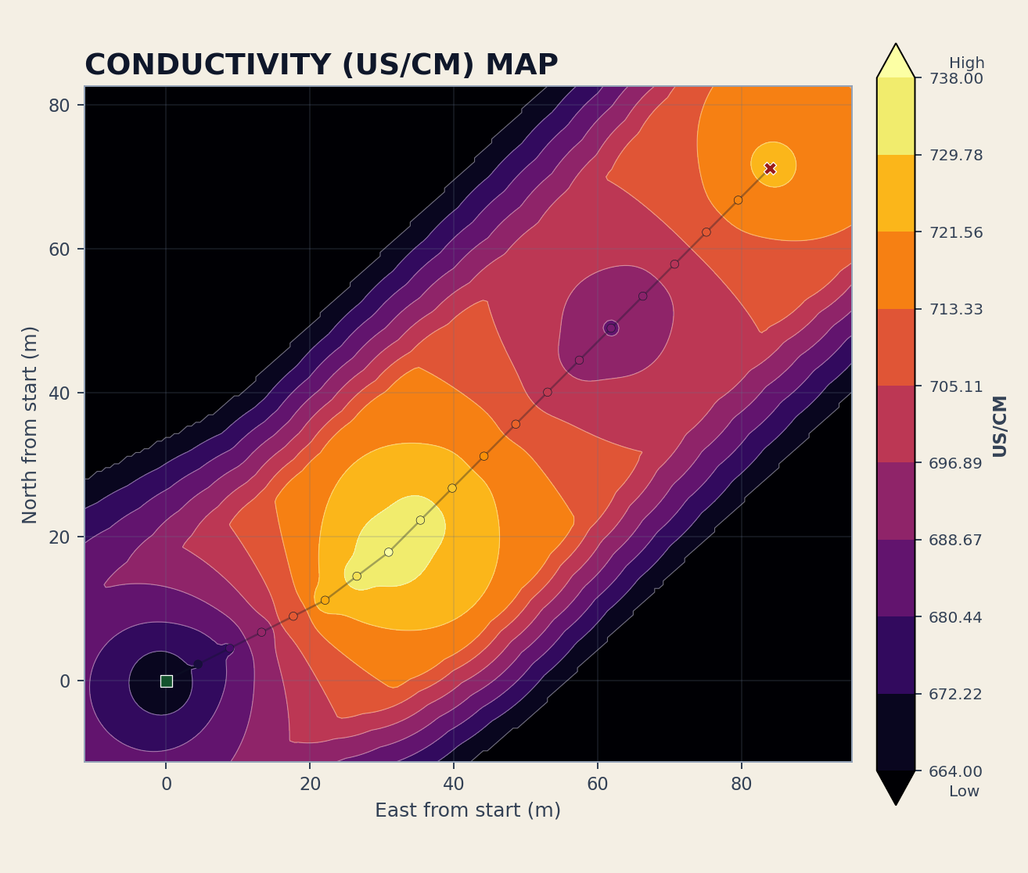
PortfolioAreaGraphs/area_conductivity.png
