ubparot/AQUAScan/PortfolioAreaGraphs/area_depth.png

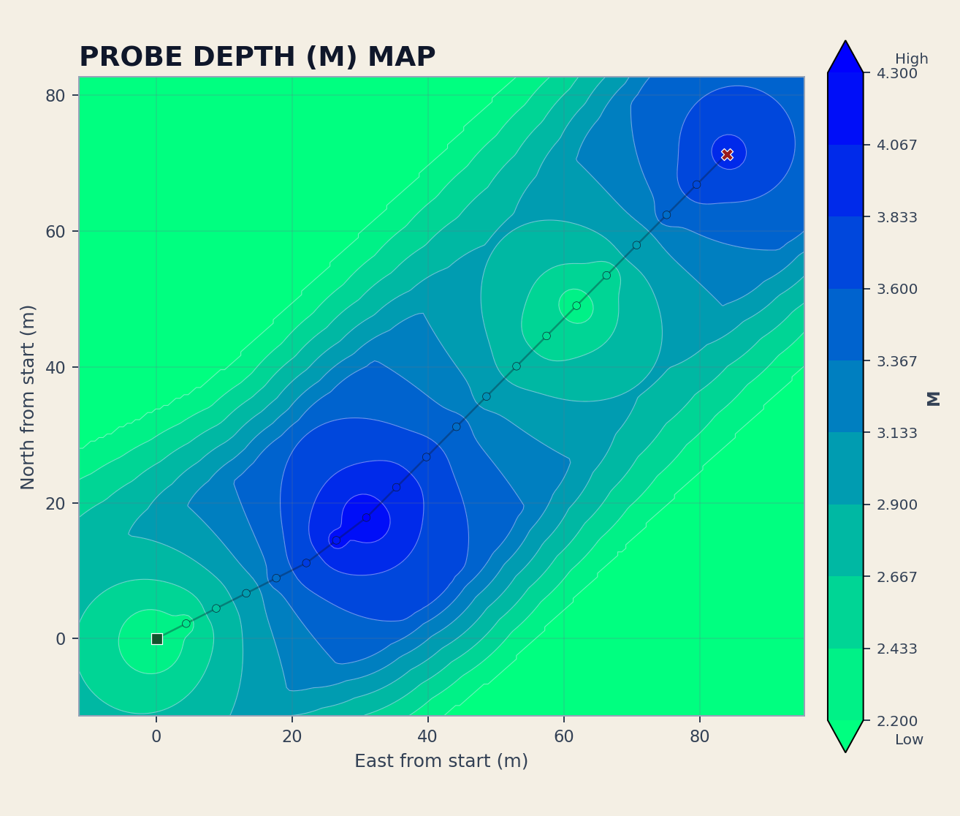
PortfolioAreaGraphs/area_depth.png
