ubparot/AQUAScan/PortfolioAreaGraphs/area_do.png

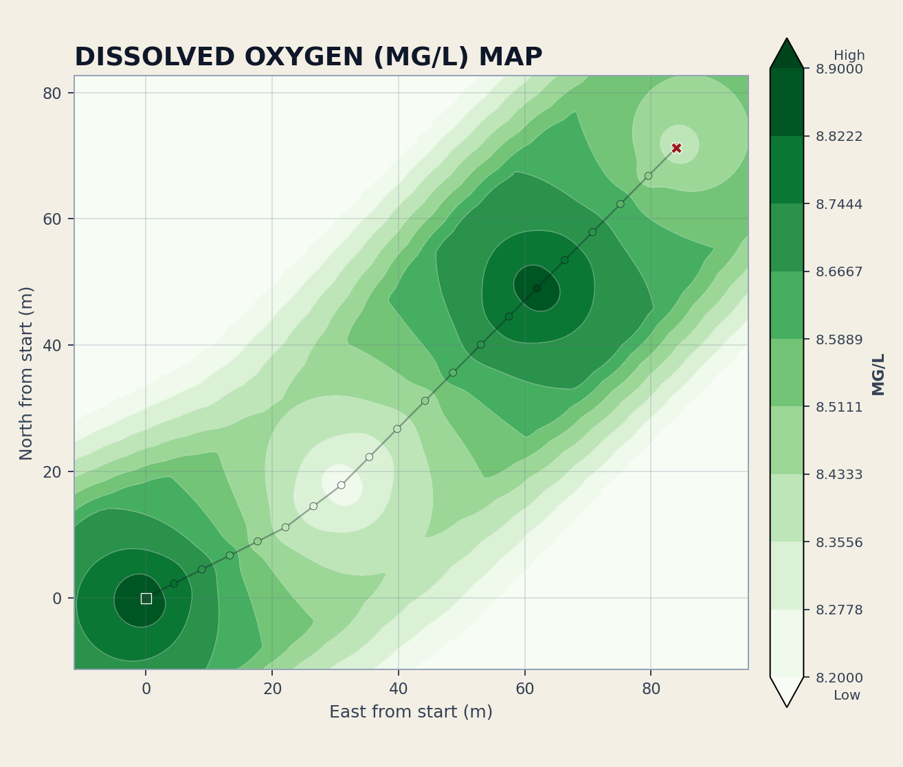
PortfolioAreaGraphs/area_do.png
