ubparot/AQUAScan/PortfolioAreaGraphs/area_light.png

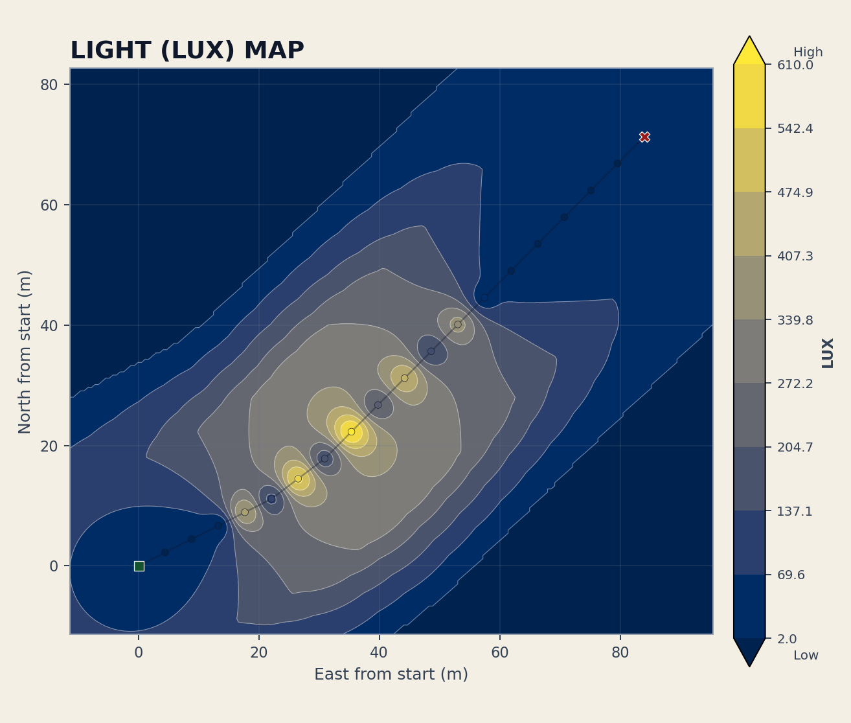
PortfolioAreaGraphs/area_light.png
