ubparot/AQUAScan/PortfolioAreaGraphs/area_ph.png

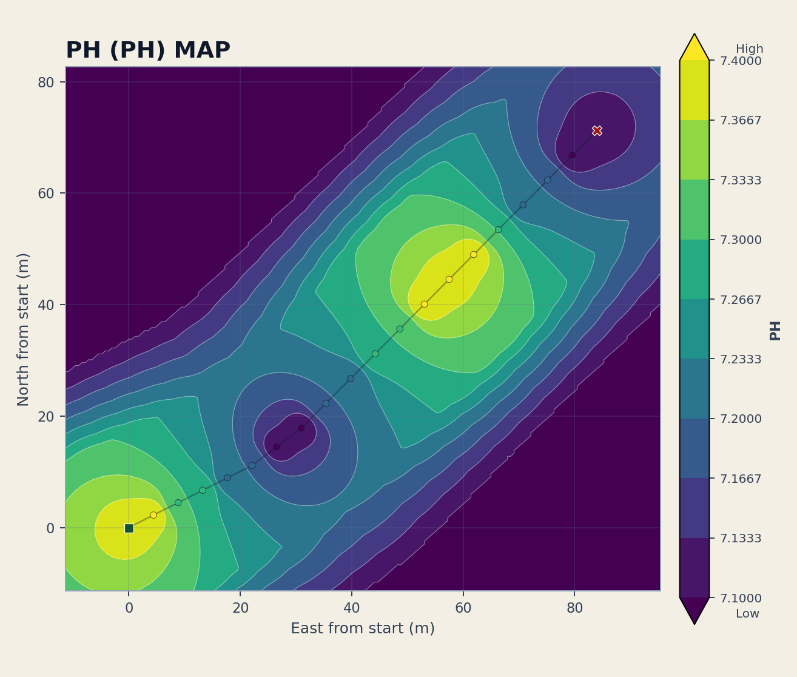
PortfolioAreaGraphs/area_ph.png
