ubparot/AQUAScan/PortfolioAreaGraphs/area_salinity.png

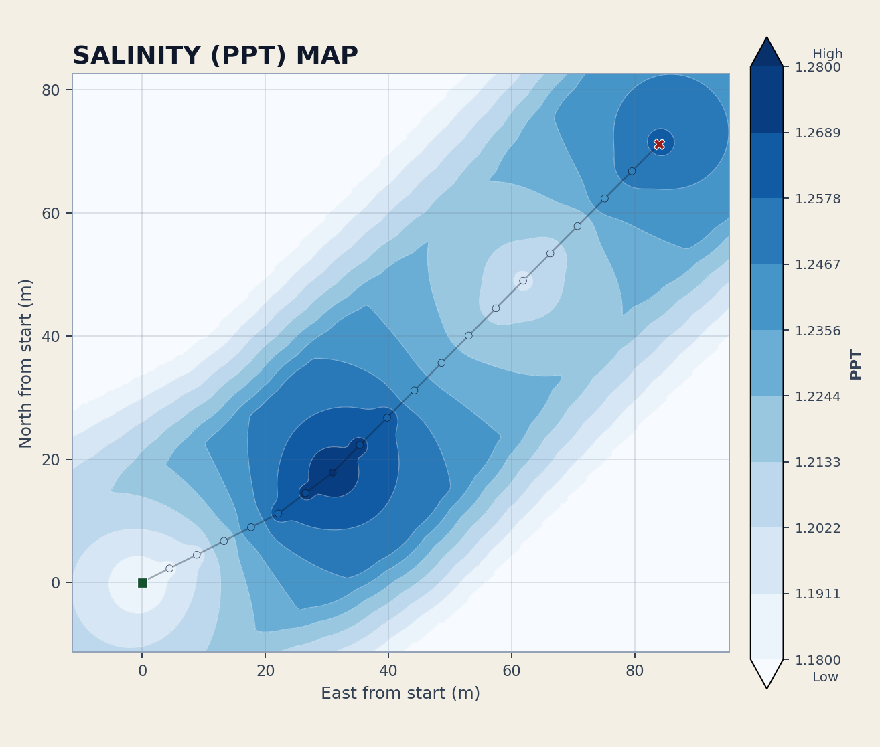
PortfolioAreaGraphs/area_salinity.png
