ubparot/AQUAScan/PortfolioAreaGraphs/area_temperature.png

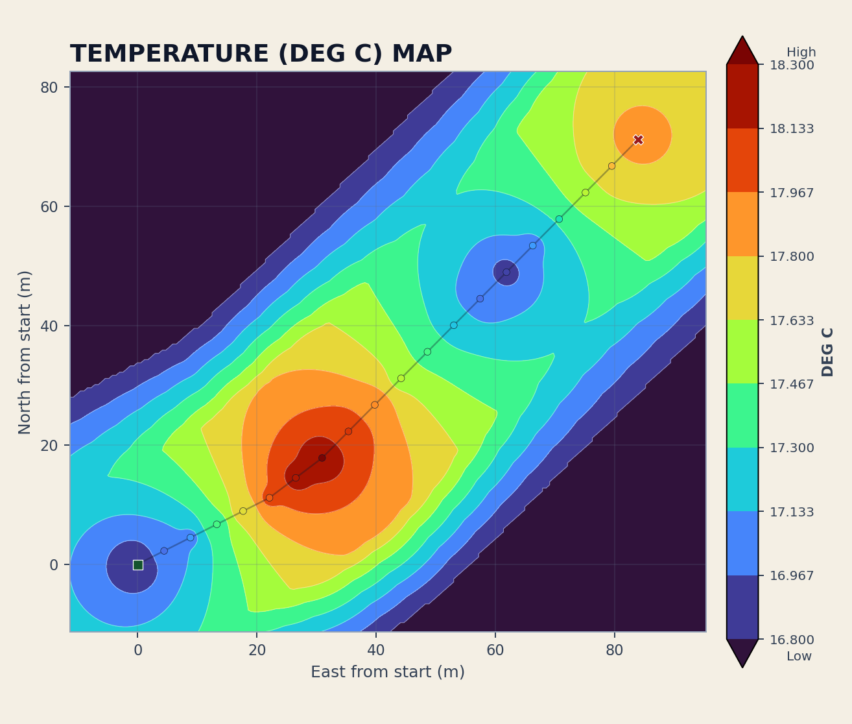
PortfolioAreaGraphs/area_temperature.png
