ubparot/AQUAScan/PortfolioAreaGraphs/area_turbidity.png

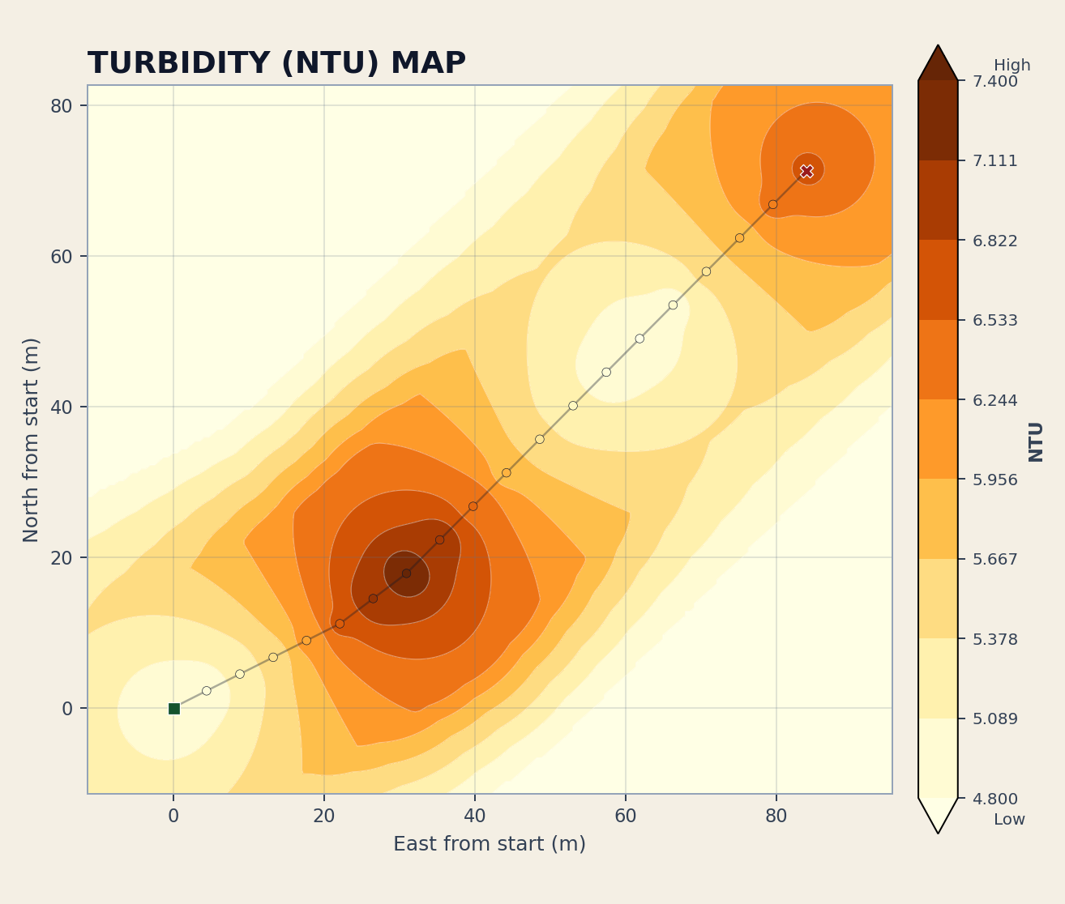
PortfolioAreaGraphs/area_turbidity.png
