ubparot/AQUAScan/PortfolioAreaGraphs/ops_battery.png

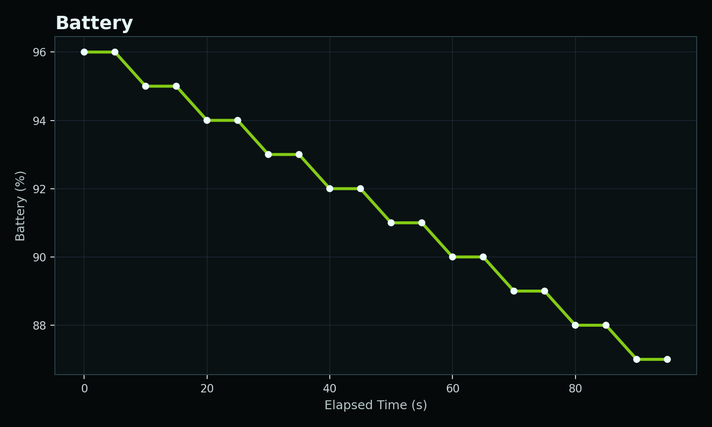
PortfolioAreaGraphs/ops_battery.png
