ubparot/AQUAScan/PortfolioAreaGraphs/ops_speed.png

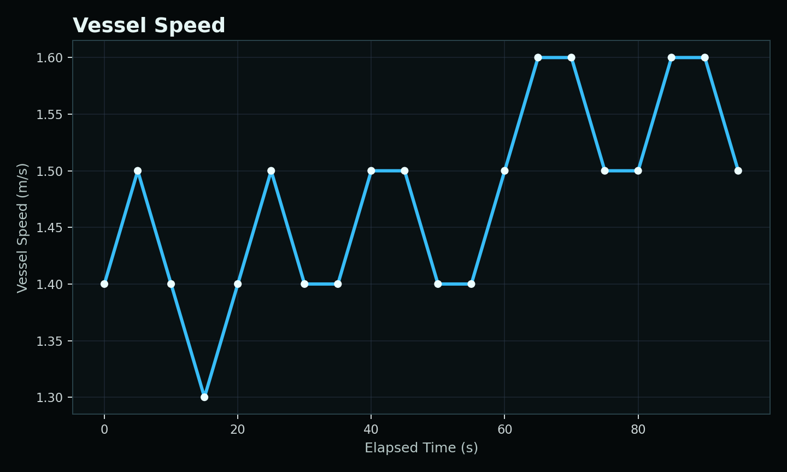
PortfolioAreaGraphs/ops_speed.png
