ubparot/AQUAScan/PortfolioGraphs/conductivity.png

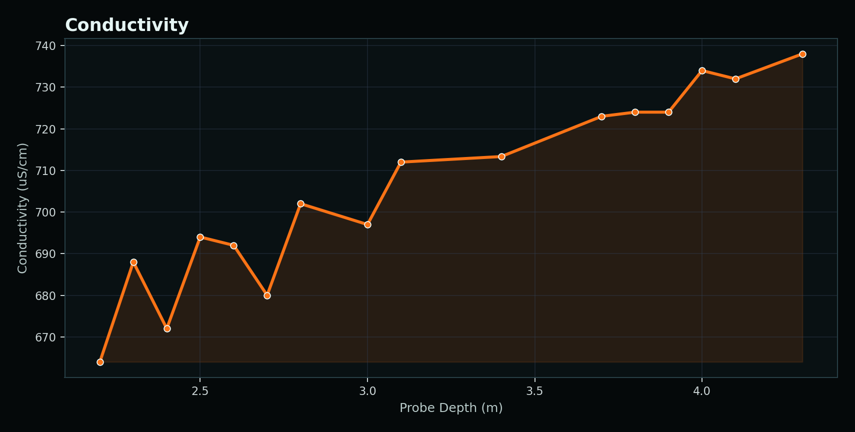
PortfolioGraphs/conductivity.png
