ubparot/AQUAScan/PortfolioGraphs/do.png

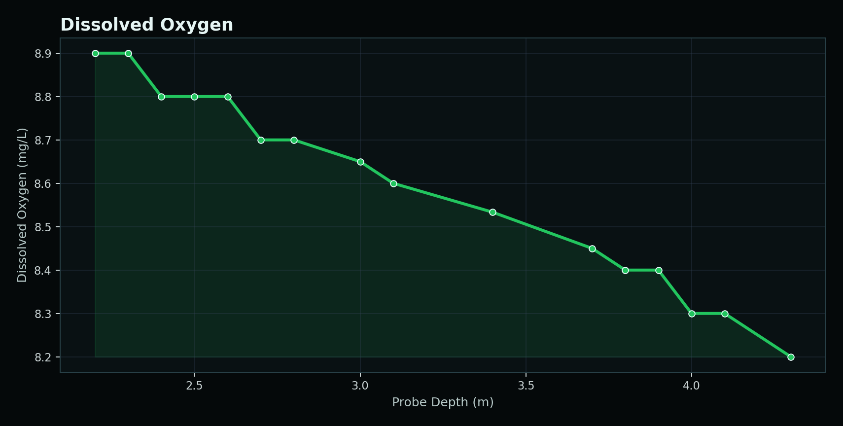
PortfolioGraphs/do.png
