ubparot/AQUAScan/PortfolioGraphs/gps_track_by_temperature.png

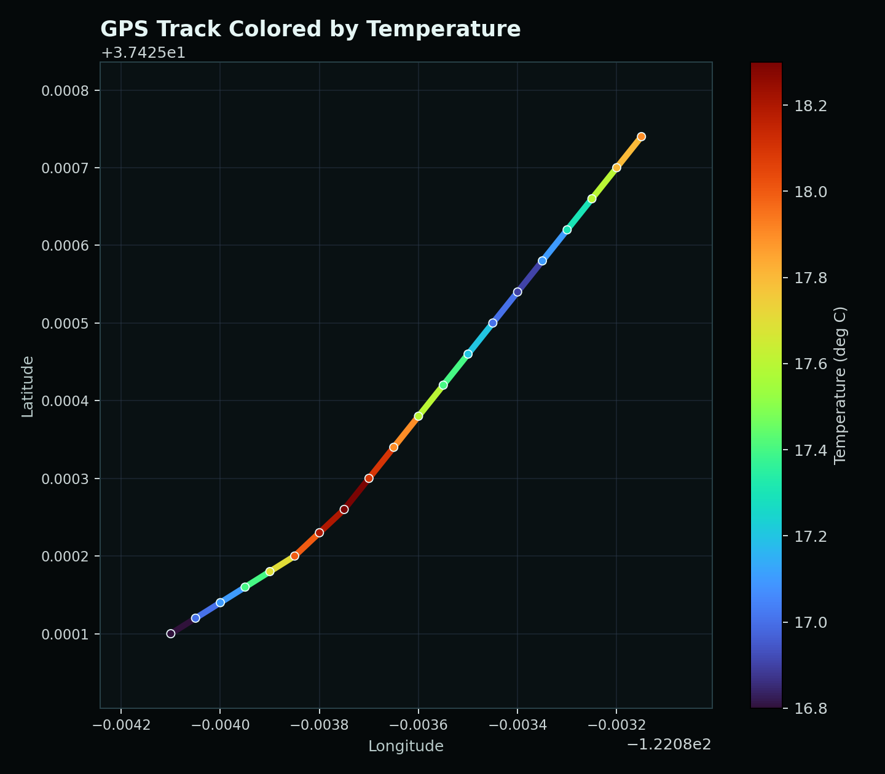
PortfolioGraphs/gps_track_by_temperature.png
