ubparot/AQUAScan/PortfolioGraphs/light.png

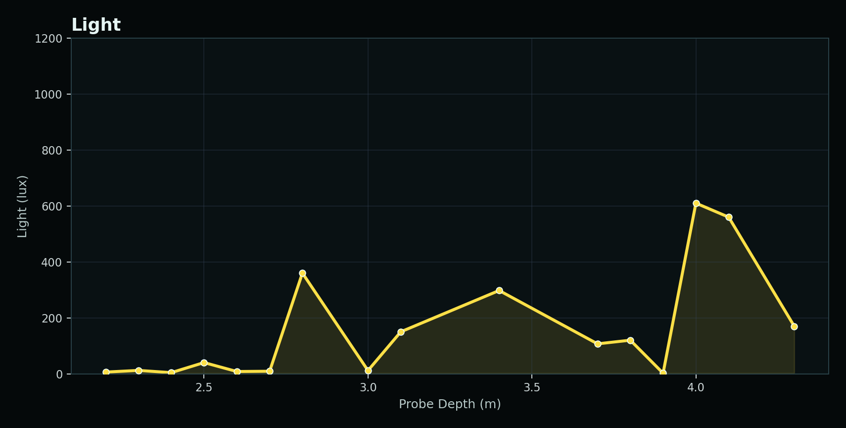
PortfolioGraphs/light.png
