ubparot/AQUAScan/PortfolioGraphs/ops_speed.png

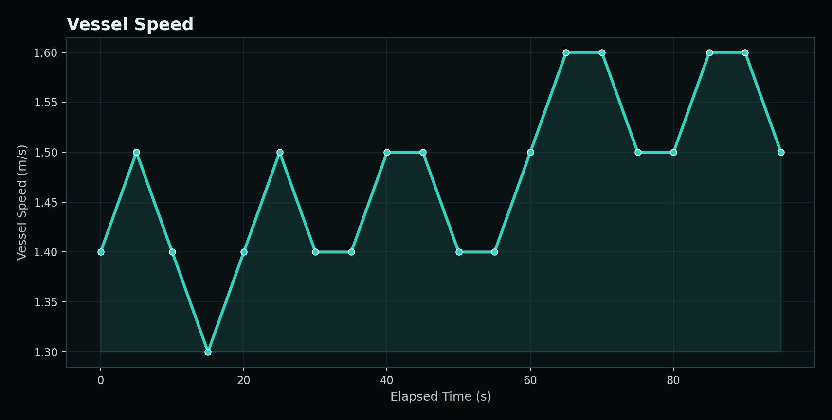
PortfolioGraphs/ops_speed.png
