ubparot/AQUAScan/PortfolioGraphs/ph.png

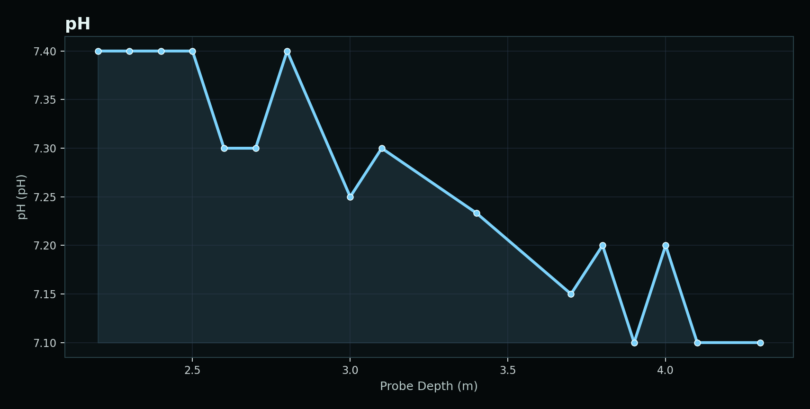
PortfolioGraphs/ph.png
