ubparot/AQUAScan/PortfolioGraphs/salinity.png

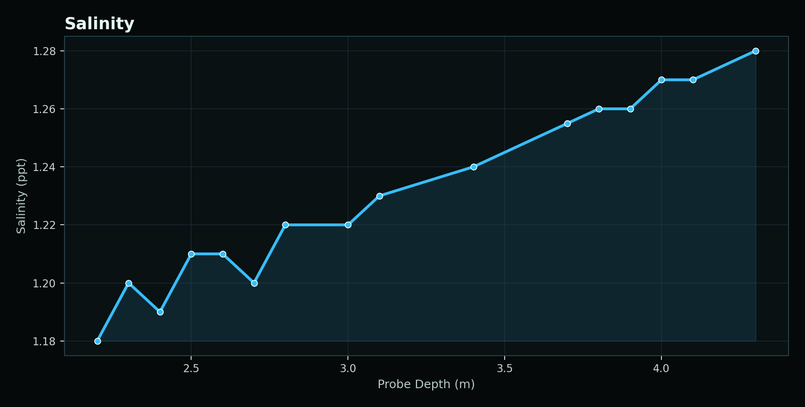
PortfolioGraphs/salinity.png
