ubparot/AQUAScan/PortfolioGraphs/sensor_overview.png

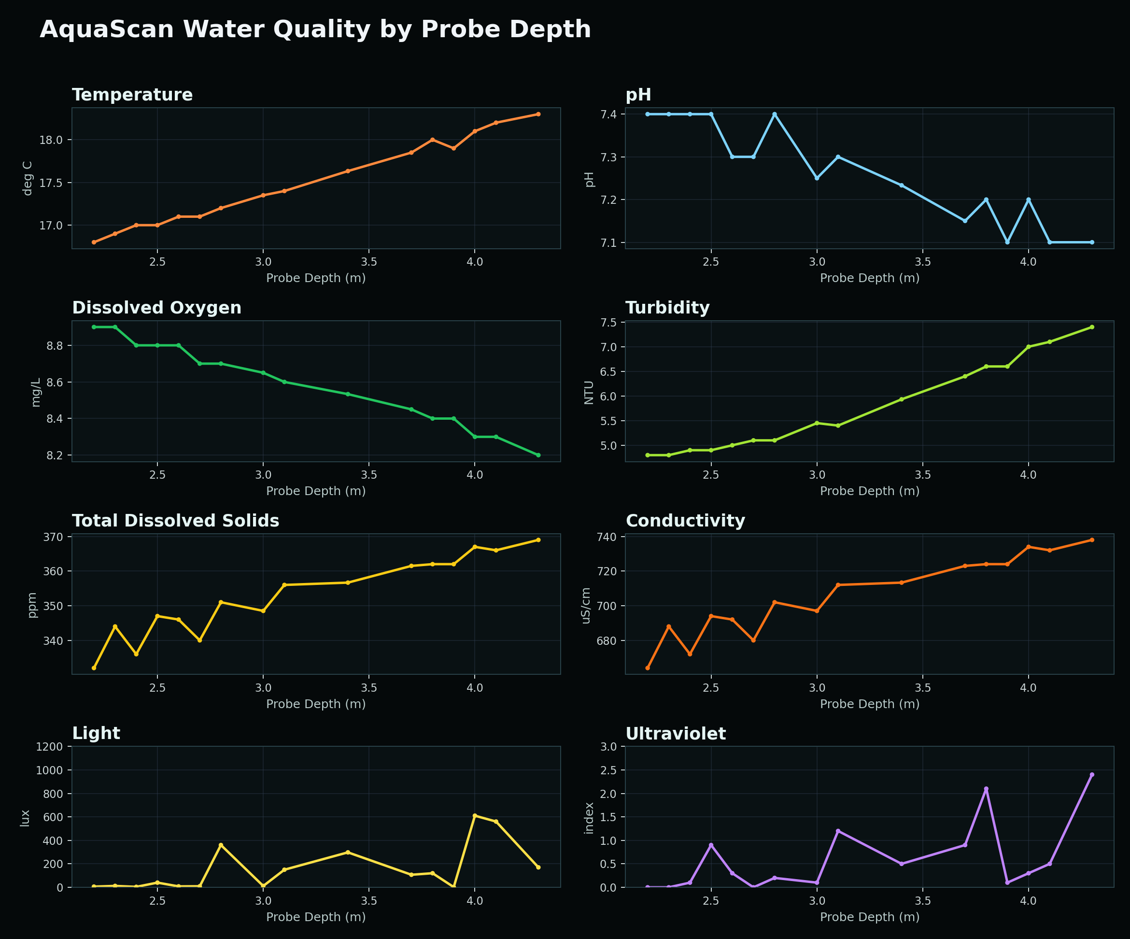
PortfolioGraphs/sensor_overview.png
