ubparot/AQUAScan/PortfolioGraphs/temperature.png

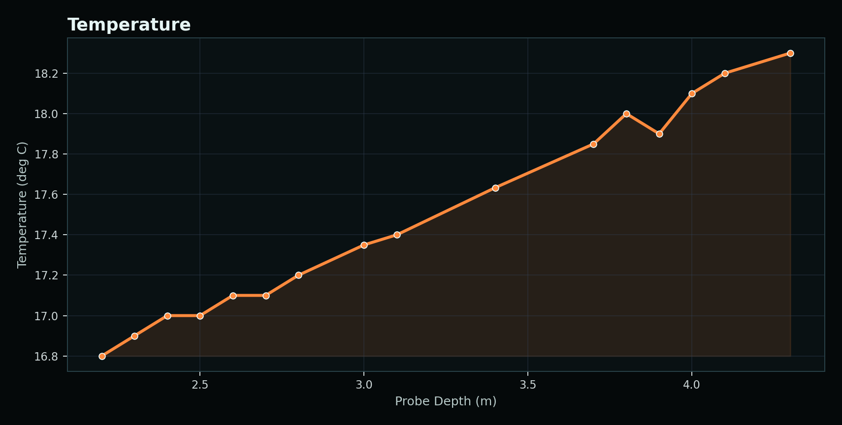
PortfolioGraphs/temperature.png
