ubparot/AQUAScan/PortfolioGraphs/turbidity.png

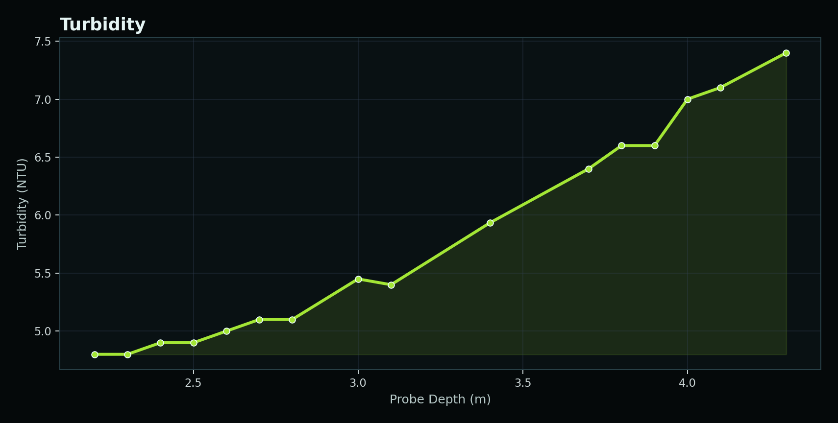
PortfolioGraphs/turbidity.png
