ubparot/AQUAScan/PortfolioGraphs/uv.png

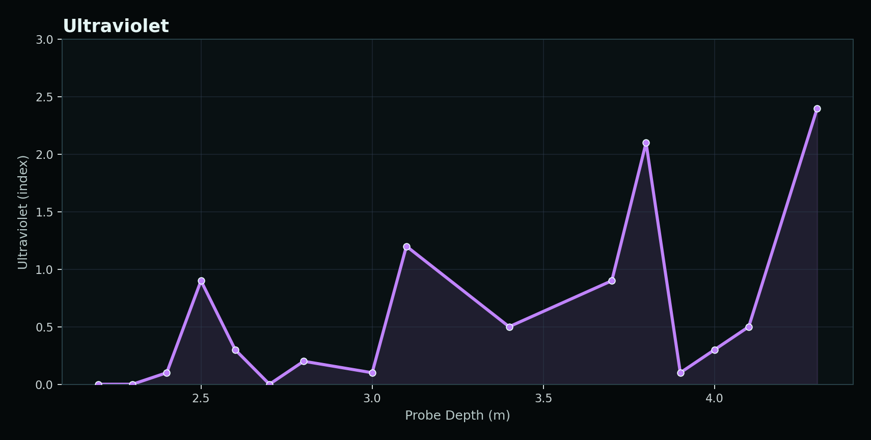
PortfolioGraphs/uv.png
