ubparot/AQUAScan/PortfolioGraphsPool/conductivity.png

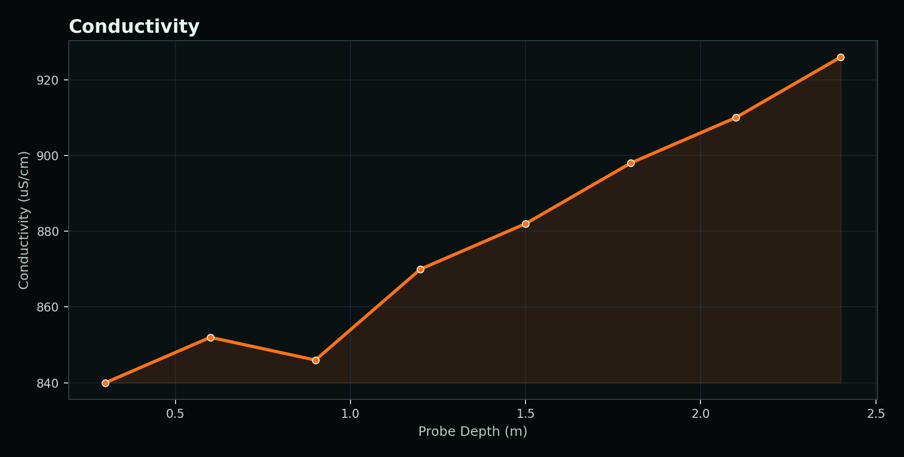
PortfolioGraphsPool/conductivity.png
