ubparot/AQUAScan/PortfolioGraphsPool/do.png

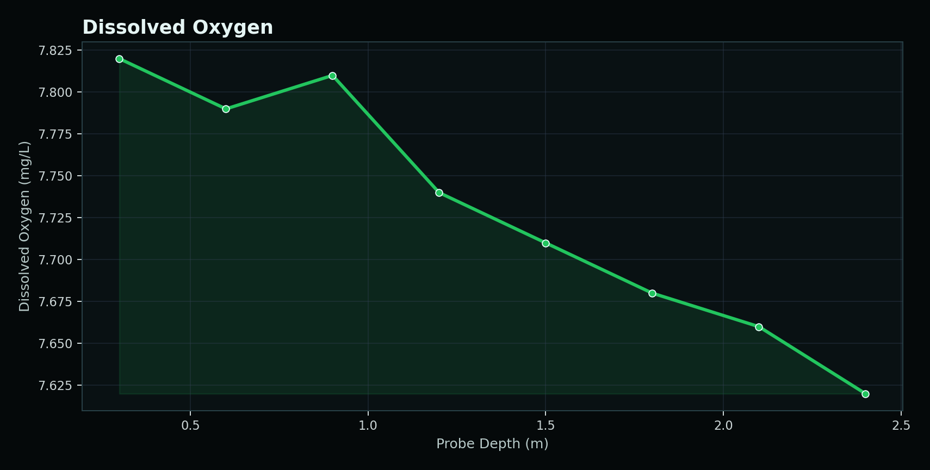
PortfolioGraphsPool/do.png
