ubparot/AQUAScan/PortfolioGraphsPool/light.png

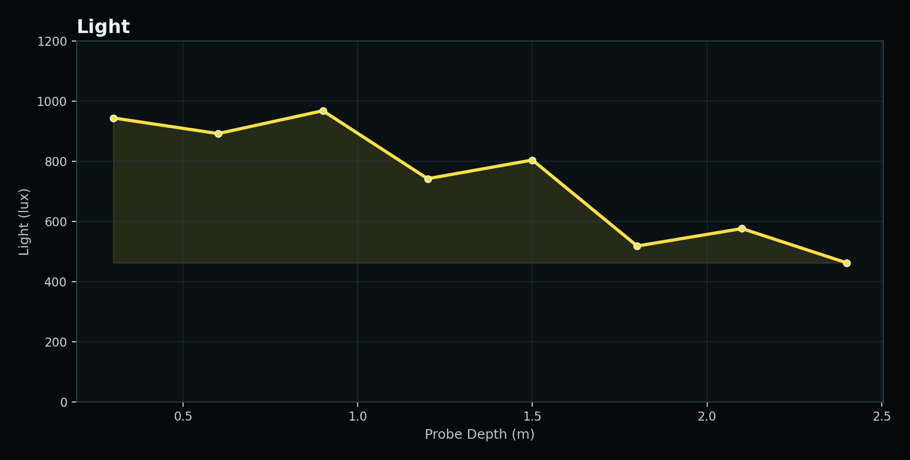
PortfolioGraphsPool/light.png
