ubparot/AQUAScan/PortfolioGraphsPool/ops_battery.png

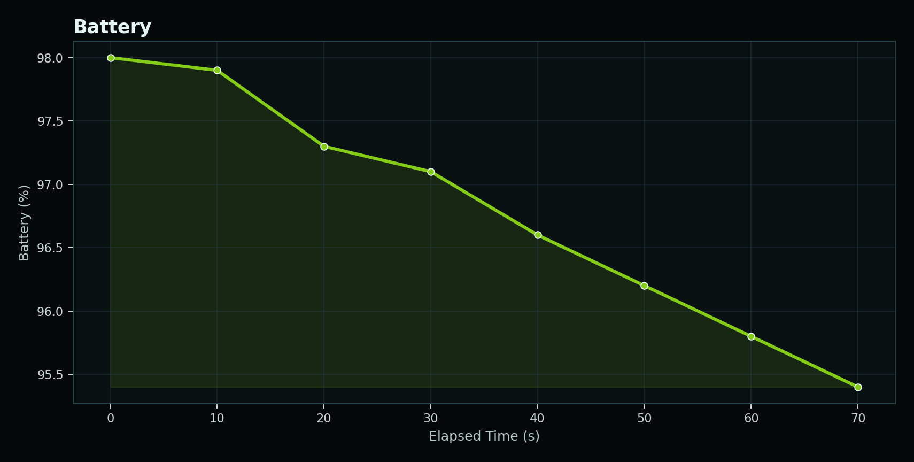
PortfolioGraphsPool/ops_battery.png
