ubparot/AQUAScan/PortfolioGraphsPool/ops_speed.png

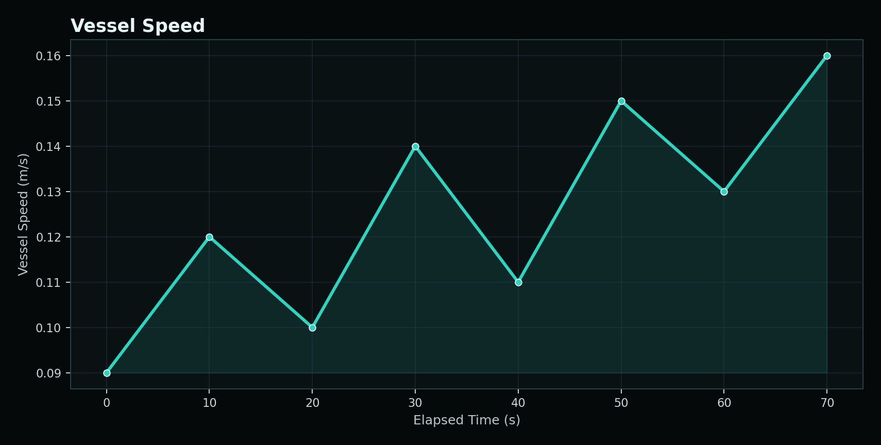
PortfolioGraphsPool/ops_speed.png
