ubparot/AQUAScan/PortfolioGraphsPool/ph.png

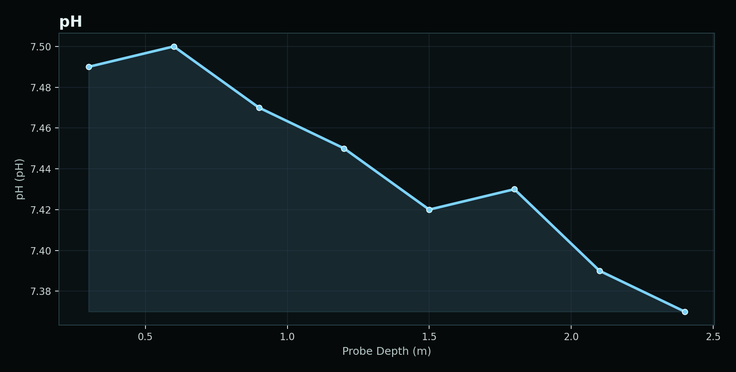
PortfolioGraphsPool/ph.png
