ubparot/AQUAScan/PortfolioGraphsPool/salinity.png

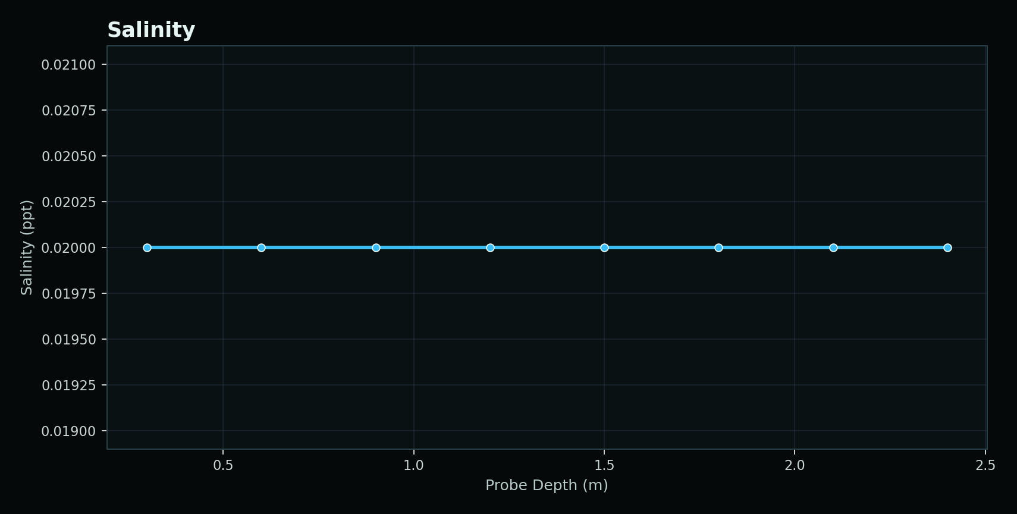
PortfolioGraphsPool/salinity.png
