ubparot/AQUAScan/PortfolioGraphsPool/sensor_overview.png

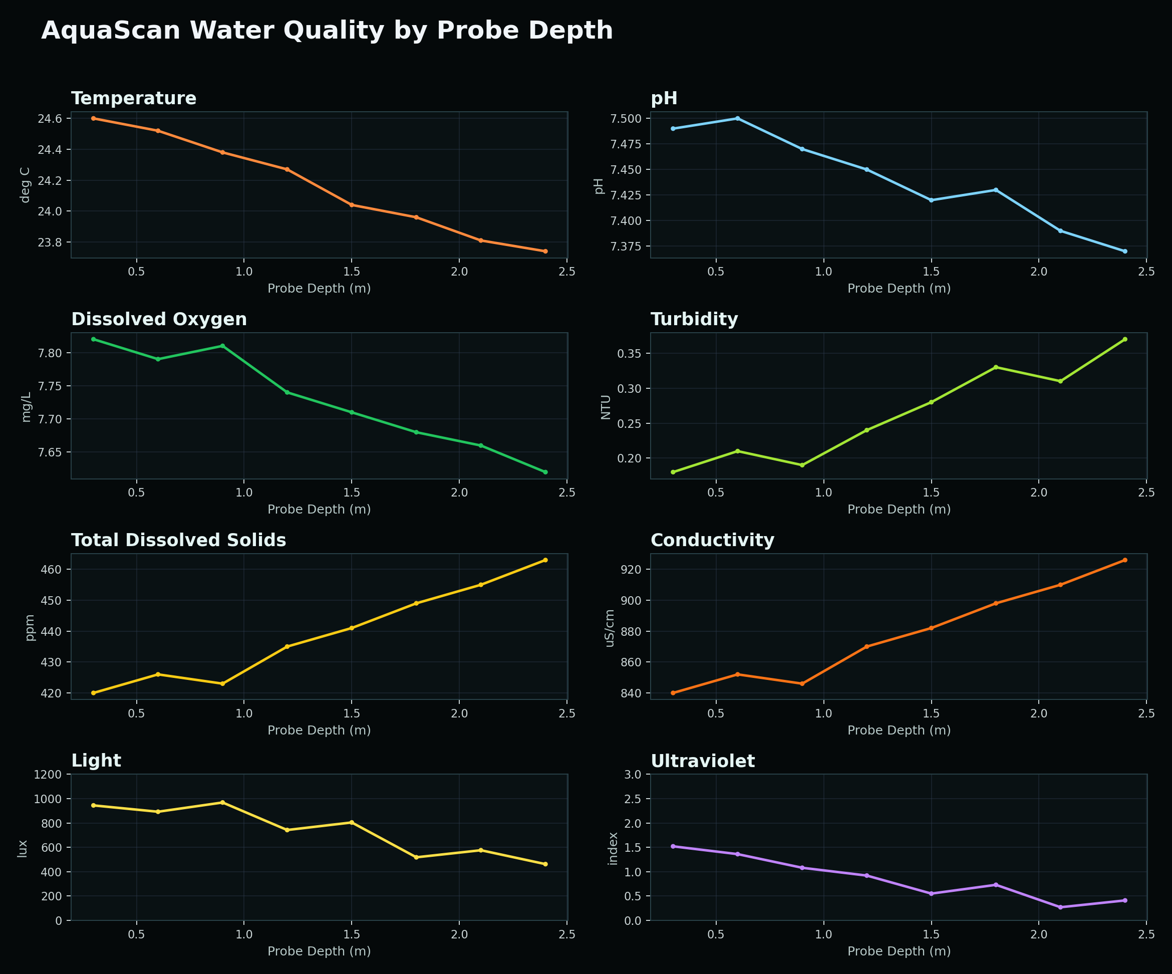
PortfolioGraphsPool/sensor_overview.png
