ubparot/AQUAScan/PortfolioGraphsPool/temperature.png

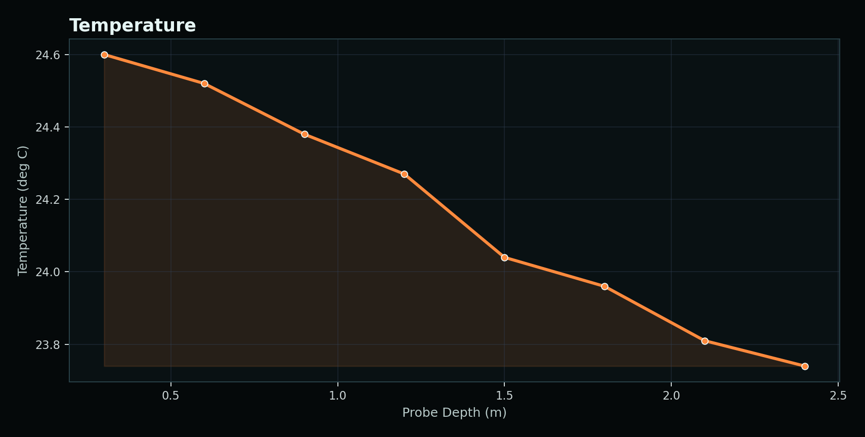
PortfolioGraphsPool/temperature.png
