ubparot/AQUAScan/PortfolioGraphsPool/turbidity.png

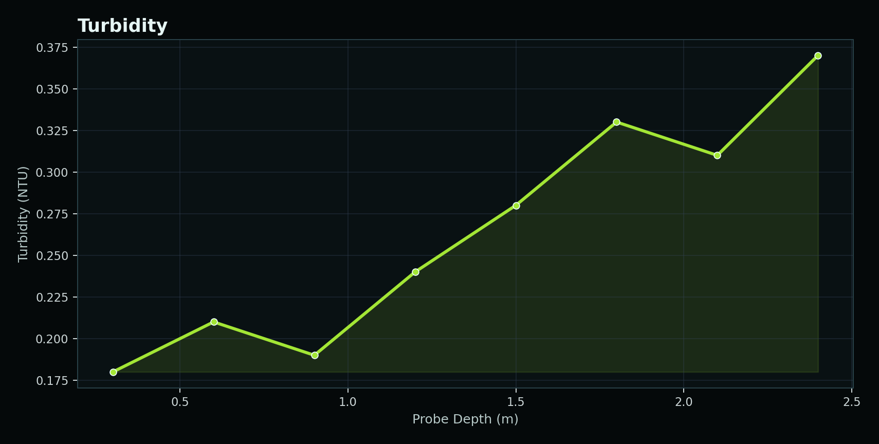
PortfolioGraphsPool/turbidity.png
