ubparot/AQUAScan/PortfolioGraphsPool/uv.png

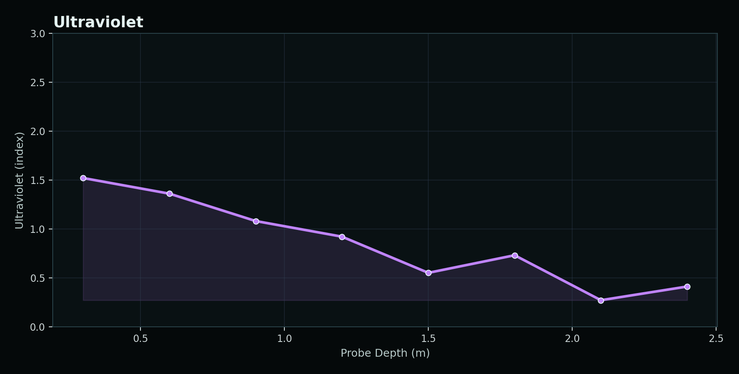
PortfolioGraphsPool/uv.png
