ubparot/AQUAScan/web/tmp-simulator-upload.png

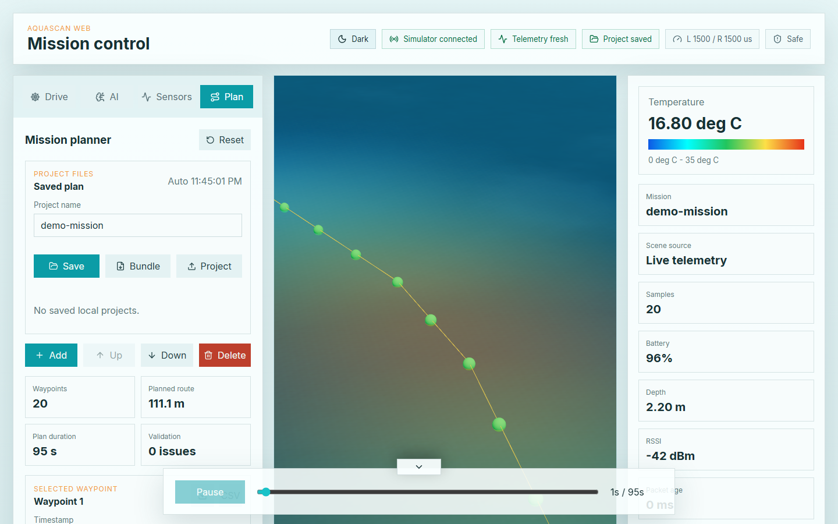
web/tmp-simulator-upload.png
