ubparot/AQUAScan/deliverables/aquascan-nationals-update/technical-symbol-inventory.txt

Firmware\ESP32\AQUAScanESP32\AQUAScanESP32.ino:42:  const char* kStaSsid = "SETUP-C4AF";
Firmware\ESP32\AQUAScanESP32\AQUAScanESP32.ino:43:  const char* kStaPassword = "county5845drain";
Firmware\ESP32\AQUAScanESP32\AQUAScanESP32.ino:44:  const unsigned long kStaConnectTimeoutMs = 15000;
Firmware\ESP32\AQUAScanESP32\AQUAScanESP32.ino:47:  const char* kApSsid = "Aquascan";
Firmware\ESP32\AQUAScanESP32\AQUAScanESP32.ino:48:  const char* kApPassword = "aquascan";
Firmware\ESP32\AQUAScanESP32\AQUAScanESP32.ino:50:  const uint16_t kWebSocketPort = 81;
Firmware\ESP32\AQUAScanESP32\AQUAScanESP32.ino:51:  const unsigned long kCommandTimeoutMs = 15000;
Firmware\ESP32\AQUAScanESP32\AQUAScanESP32.ino:52:  const unsigned long kBridgeKeepaliveIntervalMs = 100;
Firmware\ESP32\AQUAScanESP32\AQUAScanESP32.ino:53:  const unsigned long kStatusBroadcastIntervalMs = 250;
Firmware\ESP32\AQUAScanESP32\AQUAScanESP32.ino:54:  const unsigned long kBatterySampleIntervalMs = 1000;
Firmware\ESP32\AQUAScanESP32\AQUAScanESP32.ino:55:  const unsigned long kGpsFreshMs = 3000;
Firmware\ESP32\AQUAScanESP32\AQUAScanESP32.ino:56:  const unsigned long kSensorFreshMs = 3000;
Firmware\ESP32\AQUAScanESP32\AQUAScanESP32.ino:58:  const long kDebugBaudRate = 115200;
Firmware\ESP32\AQUAScanESP32\AQUAScanESP32.ino:59:  const long kBridgeBaudRate = 115200;
Firmware\ESP32\AQUAScanESP32\AQUAScanESP32.ino:60:  const int kBridgeRxPin = 16;
Firmware\ESP32\AQUAScanESP32\AQUAScanESP32.ino:61:  const int kBridgeTxPin = 17;
Firmware\ESP32\AQUAScanESP32\AQUAScanESP32.ino:62:  const bool kUseArduinoBridge = true;
Firmware\ESP32\AQUAScanESP32\AQUAScanESP32.ino:65:  const bool kUseDirectEscOutputs = false;
Firmware\ESP32\AQUAScanESP32\AQUAScanESP32.ino:66:  const int kLeftEscPin = 18;
Firmware\ESP32\AQUAScanESP32\AQUAScanESP32.ino:67:  const int kRightEscPin = 19;
Firmware\ESP32\AQUAScanESP32\AQUAScanESP32.ino:68:  const int kLeftEscChannel = 0;
Firmware\ESP32\AQUAScanESP32\AQUAScanESP32.ino:69:  const int kRightEscChannel = 1;
Firmware\ESP32\AQUAScanESP32\AQUAScanESP32.ino:70:  const int kEscPwmHz = 50;
Firmware\ESP32\AQUAScanESP32\AQUAScanESP32.ino:71:  const int kEscPwmResolutionBits = 16;
Firmware\ESP32\AQUAScanESP32\AQUAScanESP32.ino:72:  const uint32_t kEscPwmPeriodUs = 20000;
Firmware\ESP32\AQUAScanESP32\AQUAScanESP32.ino:73:  const uint32_t kEscPwmMaxDuty = (1UL << kEscPwmResolutionBits) - 1;
Firmware\ESP32\AQUAScanESP32\AQUAScanESP32.ino:76:  const long kGpsBaudRate = 9600;
Firmware\ESP32\AQUAScanESP32\AQUAScanESP32.ino:77:  const int kGpsRxPin = 25;
Firmware\ESP32\AQUAScanESP32\AQUAScanESP32.ino:78:  const int kGpsTxPin = 26;
Firmware\ESP32\AQUAScanESP32\AQUAScanESP32.ino:81:  const int kBatterySensePin = -1; // Example: 35
Firmware\ESP32\AQUAScanESP32\AQUAScanESP32.ino:82:  const float kAdcReferenceVoltage = 3.3f;
Firmware\ESP32\AQUAScanESP32\AQUAScanESP32.ino:83:  const float kAdcMaxValue = 4095.0f;
Firmware\ESP32\AQUAScanESP32\AQUAScanESP32.ino:84:  const float kBatteryDividerScale = 1.0f;
Firmware\ESP32\AQUAScanESP32\AQUAScanESP32.ino:85:  const float kBatteryEmptyVoltage = 10.5f;
Firmware\ESP32\AQUAScanESP32\AQUAScanESP32.ino:86:  const float kBatteryFullVoltage = 12.6f;
Firmware\ESP32\AQUAScanESP32\AQUAScanESP32.ino:88:  const int kNeutralMicros = 1500;
Firmware\ESP32\AQUAScanESP32\AQUAScanESP32.ino:89:  const int kMinMicros = 1000;
Firmware\ESP32\AQUAScanESP32\AQUAScanESP32.ino:90:  const int kMaxMicros = 2000;
Firmware\ESP32\AQUAScanESP32\AQUAScanESP32.ino:91:  const size_t kMaxBridgeCommandLength = 64;
Firmware\ESP32\AQUAScanESP32\AQUAScanESP32.ino:92:  const size_t kMaxBridgeLineLength = 256;
Firmware\ESP32\AQUAScanESP32\AQUAScanESP32.ino:93:  const size_t kBridgeReadBudget = 256;
Firmware\ESP32\AQUAScanESP32\AQUAScanESP32.ino:94:  const size_t kGpsReadBudget = 128;
Firmware\ESP32\AQUAScanESP32\AQUAScanESP32.ino:95:  const size_t kUsbReadBudget = 64;
Firmware\ESP32\AQUAScanESP32\AQUAScanESP32.ino:96:  const uint8_t kTrackedSocketSlots = 8;
Firmware\ESP32\AQUAScanESP32\AQUAScanESP32.ino:100:WebSocketsServer webSocket(kWebSocketPort);
Firmware\ESP32\AQUAScanESP32\AQUAScanESP32.ino:107:char bridgeLine[kMaxBridgeLineLength];
Firmware\ESP32\AQUAScanESP32\AQUAScanESP32.ino:111:bool socketSlots[kTrackedSocketSlots] = { false };
Firmware\ESP32\AQUAScanESP32\AQUAScanESP32.ino:117:int leftMicros = kNeutralMicros;
Firmware\ESP32\AQUAScanESP32\AQUAScanESP32.ino:118:int rightMicros = kNeutralMicros;
Firmware\ESP32\AQUAScanESP32\AQUAScanESP32.ino:124:int bridgeLeftMicros = kNeutralMicros;
Firmware\ESP32\AQUAScanESP32\AQUAScanESP32.ino:125:int bridgeRightMicros = kNeutralMicros;
Firmware\ESP32\AQUAScanESP32\AQUAScanESP32.ino:174:void startNetwork();
Firmware\ESP32\AQUAScanESP32\AQUAScanESP32.ino:176:void startFallbackAccessPoint();
Firmware\ESP32\AQUAScanESP32\AQUAScanESP32.ino:177:void handleSocketEvent(uint8_t clientNum, WStype_t type, uint8_t* payload, size_t length);
Firmware\ESP32\AQUAScanESP32\AQUAScanESP32.ino:178:void handleTextMessage(uint8_t clientNum, const char* payload, size_t length);
Firmware\ESP32\AQUAScanESP32\AQUAScanESP32.ino:179:void handleDriveMessage(uint8_t clientNum, const String& message);
Firmware\ESP32\AQUAScanESP32\AQUAScanESP32.ino:180:void handleEstopMessage(uint8_t clientNum, const String& message);
Firmware\ESP32\AQUAScanESP32\AQUAScanESP32.ino:181:void handleProbeControlMessage(uint8_t clientNum, const String& message);
Firmware\ESP32\AQUAScanESP32\AQUAScanESP32.ino:182:void handleMissionUploadMessage(uint8_t clientNum, const String& type, const String& message);
Firmware\ESP32\AQUAScanESP32\AQUAScanESP32.ino:183:void readUsbSerialCommands();
Firmware\ESP32\AQUAScanESP32\AQUAScanESP32.ino:184:void handleUsbSerialCommand(String command);
Firmware\ESP32\AQUAScanESP32\AQUAScanESP32.ino:185:void printUsbHelp();
Firmware\ESP32\AQUAScanESP32\AQUAScanESP32.ino:186:void applyManualEscCommand(int left, int right);
Firmware\ESP32\AQUAScanESP32\AQUAScanESP32.ino:187:void setupEscOutputs();
Firmware\ESP32\AQUAScanESP32\AQUAScanESP32.ino:188:void applyEscOutputs(int left, int right);
Firmware\ESP32\AQUAScanESP32\AQUAScanESP32.ino:189:void writeEscPulse(int pin, int channel, int micros);
Firmware\ESP32\AQUAScanESP32\AQUAScanESP32.ino:190:void readBridgeStatus();
Firmware\ESP32\AQUAScanESP32\AQUAScanESP32.ino:191:void applyBridgeStatus(const char* line);
Firmware\ESP32\AQUAScanESP32\AQUAScanESP32.ino:192:void applyBridgeProbeStatus(const char* line);
Firmware\ESP32\AQUAScanESP32\AQUAScanESP32.ino:193:void applyBridgeSensorStatus(const char* line);
Firmware\ESP32\AQUAScanESP32\AQUAScanESP32.ino:194:bool writeBridgeLine(const char* line);
Firmware\ESP32\AQUAScanESP32\AQUAScanESP32.ino:195:void sendBridgeCommand();
Firmware\ESP32\AQUAScanESP32\AQUAScanESP32.ino:196:void sendBridgeProbeCommand();
Firmware\ESP32\AQUAScanESP32\AQUAScanESP32.ino:197:void stopProbe(const char* reason);
Firmware\ESP32\AQUAScanESP32\AQUAScanESP32.ino:198:void neutralize(const char* reason);
Firmware\ESP32\AQUAScanESP32\AQUAScanESP32.ino:199:void updateTelemetry();
Firmware\ESP32\AQUAScanESP32\AQUAScanESP32.ino:200:void updateGps();
Firmware\ESP32\AQUAScanESP32\AQUAScanESP32.ino:201:void updateBattery();
Firmware\ESP32\AQUAScanESP32\AQUAScanESP32.ino:202:void sendStatus(uint8_t clientNum);
Firmware\ESP32\AQUAScanESP32\AQUAScanESP32.ino:203:void sendStatusBroadcast();
Firmware\ESP32\AQUAScanESP32\AQUAScanESP32.ino:204:void sendSensorBroadcast();
Firmware\ESP32\AQUAScanESP32\AQUAScanESP32.ino:207:void sendMissionAck(uint8_t clientNum, const String& missionId, int seq, bool accepted, const String& text);
Firmware\ESP32\AQUAScanESP32\AQUAScanESP32.ino:208:void sendMissionProgress(uint8_t clientNum);
Firmware\ESP32\AQUAScanESP32\AQUAScanESP32.ino:210:void markSocketConnected(uint8_t clientNum);
Firmware\ESP32\AQUAScanESP32\AQUAScanESP32.ino:211:void markSocketDisconnected(uint8_t clientNum);
Firmware\ESP32\AQUAScanESP32\AQUAScanESP32.ino:212:bool parseCsvIntegers(const char* line, int* values, int expectedCount);
Firmware\ESP32\AQUAScanESP32\AQUAScanESP32.ino:213:bool parseCsvFloats(const char* line, float* values, int expectedCount);
Firmware\ESP32\AQUAScanESP32\AQUAScanESP32.ino:215:String socketPayloadToString(const char* payload, size_t length);
Firmware\ESP32\AQUAScanESP32\AQUAScanESP32.ino:216:String readJsonString(const String& message, const char* key, const String& fallback);
Firmware\ESP32\AQUAScanESP32\AQUAScanESP32.ino:217:bool readJsonBool(const String& message, const char* key, bool fallback);
Firmware\ESP32\AQUAScanESP32\AQUAScanESP32.ino:218:int readJsonInt(const String& message, const char* key, int fallback);
Firmware\ESP32\AQUAScanESP32\AQUAScanESP32.ino:219:float readJsonFloat(const String& message, const char* key, float fallback);
Firmware\ESP32\AQUAScanESP32\AQUAScanESP32.ino:220:int findJsonValueStart(const String& message, const char* key);
Firmware\ESP32\AQUAScanESP32\AQUAScanESP32.ino:221:String escapeJson(const String& value);
Firmware\ESP32\AQUAScanESP32\AQUAScanESP32.ino:222:void appendSensorJsonFields(String& message);
Firmware\ESP32\AQUAScanESP32\AQUAScanESP32.ino:223:void appendJsonNumber(String& json, const char* key, double value, int decimals);
Firmware\ESP32\AQUAScanESP32\AQUAScanESP32.ino:225:void setup()
Firmware\ESP32\AQUAScanESP32\AQUAScanESP32.ino:227:  Serial.begin(kDebugBaudRate);
Firmware\ESP32\AQUAScanESP32\AQUAScanESP32.ino:235:  if (kUseArduinoBridge)
Firmware\ESP32\AQUAScanESP32\AQUAScanESP32.ino:237:    BridgeSerial.begin(kBridgeBaudRate, SERIAL_8N1, kBridgeRxPin, kBridgeTxPin);
Firmware\ESP32\AQUAScanESP32\AQUAScanESP32.ino:239:    Serial.print(kBridgeBaudRate);
Firmware\ESP32\AQUAScanESP32\AQUAScanESP32.ino:241:    Serial.print(kBridgeRxPin);
Firmware\ESP32\AQUAScanESP32\AQUAScanESP32.ino:243:    Serial.println(kBridgeTxPin);
Firmware\ESP32\AQUAScanESP32\AQUAScanESP32.ino:252:  GpsSerial.begin(kGpsBaudRate, SERIAL_8N1, kGpsRxPin, kGpsTxPin);
Firmware\ESP32\AQUAScanESP32\AQUAScanESP32.ino:258:  if (kBatterySensePin >= 0)
Firmware\ESP32\AQUAScanESP32\AQUAScanESP32.ino:261:    analogSetPinAttenuation(kBatterySensePin, ADC_11db);
Firmware\ESP32\AQUAScanESP32\AQUAScanESP32.ino:266:    Serial.println(F("Battery telemetry: disabled. Set kBatterySensePin after wiring a divider."));
Firmware\ESP32\AQUAScanESP32\AQUAScanESP32.ino:283:void loop()
Firmware\ESP32\AQUAScanESP32\AQUAScanESP32.ino:287:  if (kUseArduinoBridge)
Firmware\ESP32\AQUAScanESP32\AQUAScanESP32.ino:291:  const unsigned long now = millis();
Firmware\ESP32\AQUAScanESP32\AQUAScanESP32.ino:293:  if (hasSocketClient() && now - lastStatusBroadcastAt >= kStatusBroadcastIntervalMs)
Firmware\ESP32\AQUAScanESP32\AQUAScanESP32.ino:299:  if (kUseArduinoBridge && hasSocketClient() && lastCommandAt > 0 && now - lastBridgeCommandAt >= kBridgeKeepaliveIntervalMs)
Firmware\ESP32\AQUAScanESP32\AQUAScanESP32.ino:302:  if (kUseArduinoBridge && probeDirection != 0 && now - lastProbeBridgeCommandAt >= kBridgeKeepaliveIntervalMs)
Firmware\ESP32\AQUAScanESP32\AQUAScanESP32.ino:305:  if (armed && lastCommandAt > 0 && now - lastCommandAt > kCommandTimeoutMs)
Firmware\ESP32\AQUAScanESP32\AQUAScanESP32.ino:308:  if (lastProbeCommandAt > 0 && now - lastProbeCommandAt > kCommandTimeoutMs)
Firmware\ESP32\AQUAScanESP32\AQUAScanESP32.ino:312:void handleSocketEvent(uint8_t clientNum, WStype_t type, uint8_t* payload, size_t length)
Firmware\ESP32\AQUAScanESP32\AQUAScanESP32.ino:317:      markSocketConnected(clientNum);
Firmware\ESP32\AQUAScanESP32\AQUAScanESP32.ino:323:      markSocketDisconnected(clientNum);
Firmware\ESP32\AQUAScanESP32\AQUAScanESP32.ino:330:      handleTextMessage(clientNum, reinterpret_cast<const char*>(payload), length);
Firmware\ESP32\AQUAScanESP32\AQUAScanESP32.ino:338:void handleTextMessage(uint8_t clientNum, const char* payload, size_t length)
Firmware\ESP32\AQUAScanESP32\AQUAScanESP32.ino:343:  const String type = readJsonString(message, "type", "");
Firmware\ESP32\AQUAScanESP32\AQUAScanESP32.ino:345:  if (type == "hello")
Firmware\ESP32\AQUAScanESP32\AQUAScanESP32.ino:351:  if (type == "drive")
Firmware\ESP32\AQUAScanESP32\AQUAScanESP32.ino:357:  if (type == "estop")
Firmware\ESP32\AQUAScanESP32\AQUAScanESP32.ino:363:  if (type == "probe_control")
Firmware\ESP32\AQUAScanESP32\AQUAScanESP32.ino:369:  if (type == "mission_upload_begin" || type == "mission_waypoint" || type == "mission_upload_commit" || type == "mission_upload_abort")
Firmware\ESP32\AQUAScanESP32\AQUAScanESP32.ino:375:  Serial.printf("Ignoring unknown WebSocket message type '%s'.\n", type.c_str());
Firmware\ESP32\AQUAScanESP32\AQUAScanESP32.ino:379:void handleDriveMessage(uint8_t clientNum, const String& message)
Firmware\ESP32\AQUAScanESP32\AQUAScanESP32.ino:392:  const int nextSeq = readJsonInt(message, "seq", lastSeq);
Firmware\ESP32\AQUAScanESP32\AQUAScanESP32.ino:393:  const bool nextArmed = readJsonBool(message, "armed", armed);
Firmware\ESP32\AQUAScanESP32\AQUAScanESP32.ino:394:  const bool nextEstop = readJsonBool(message, "estop", estop);
Firmware\ESP32\AQUAScanESP32\AQUAScanESP32.ino:395:  const int nextLeft = readJsonInt(message, "left", leftMicros);
Firmware\ESP32\AQUAScanESP32\AQUAScanESP32.ino:396:  const int nextRight = readJsonInt(message, "right", rightMicros);
Firmware\ESP32\AQUAScanESP32\AQUAScanESP32.ino:398:  if (nextLeft < kMinMicros || nextLeft > kMaxMicros || nextRight < kMinMicros || nextRight > kMaxMicros)
Firmware\ESP32\AQUAScanESP32\AQUAScanESP32.ino:410:  leftMicros = armed ? nextLeft : kNeutralMicros;
Firmware\ESP32\AQUAScanESP32\AQUAScanESP32.ino:411:  rightMicros = armed ? nextRight : kNeutralMicros;
Firmware\ESP32\AQUAScanESP32\AQUAScanESP32.ino:416:  const unsigned long now = millis();
Firmware\ESP32\AQUAScanESP32\AQUAScanESP32.ino:424:void handleEstopMessage(uint8_t clientNum, const String& message)
Firmware\ESP32\AQUAScanESP32\AQUAScanESP32.ino:429:  leftMicros = kNeutralMicros;
Firmware\ESP32\AQUAScanESP32\AQUAScanESP32.ino:430:  rightMicros = kNeutralMicros;
Firmware\ESP32\AQUAScanESP32\AQUAScanESP32.ino:439:void handleProbeControlMessage(uint8_t clientNum, const String& message)
Firmware\ESP32\AQUAScanESP32\AQUAScanESP32.ino:442:  const String direction = readJsonString(message, "direction", "stop");
Firmware\ESP32\AQUAScanESP32\AQUAScanESP32.ino:443:  const int speed = constrain(readJsonInt(message, "speed", 0), 0, 255);
Firmware\ESP32\AQUAScanESP32\AQUAScanESP32.ino:473:void handleMissionUploadMessage(uint8_t clientNum, const String& type, const String& message)
Firmware\ESP32\AQUAScanESP32\AQUAScanESP32.ino:475:  const int seq = readJsonInt(message, "seq", lastSeq);
Firmware\ESP32\AQUAScanESP32\AQUAScanESP32.ino:476:  const String missionId = readJsonString(message, "missionId", uploadMissionId);
Firmware\ESP32\AQUAScanESP32\AQUAScanESP32.ino:478:  if (type == "mission_upload_begin")
Firmware\ESP32\AQUAScanESP32\AQUAScanESP32.ino:492:  if (type == "mission_waypoint")
Firmware\ESP32\AQUAScanESP32\AQUAScanESP32.ino:494:    const int index = readJsonInt(message, "index", -1);
Firmware\ESP32\AQUAScanESP32\AQUAScanESP32.ino:495:    const bool accepted = missionUploadActive && missionId == uploadMissionId && index >= 0 && index < uploadWaypointCount;
Firmware\ESP32\AQUAScanESP32\AQUAScanESP32.ino:505:  if (type == "mission_upload_commit")
Firmware\ESP32\AQUAScanESP32\AQUAScanESP32.ino:507:    const String checksum = readJsonString(message, "checksum", "");
Firmware\ESP32\AQUAScanESP32\AQUAScanESP32.ino:508:    const bool accepted = missionUploadActive && missionId == uploadMissionId && checksum == uploadChecksum && uploadReceivedWaypoints == uploadWaypointCount;
Firmware\ESP32\AQUAScanESP32\AQUAScanESP32.ino:518:  if (type == "mission_upload_abort")
Firmware\ESP32\AQUAScanESP32\AQUAScanESP32.ino:530:void readUsbSerialCommands()
Firmware\ESP32\AQUAScanESP32\AQUAScanESP32.ino:533:  while (Serial.available() > 0 && processed < kUsbReadBudget)
Firmware\ESP32\AQUAScanESP32\AQUAScanESP32.ino:535:    const char incoming = static_cast<char>(Serial.read());
Firmware\ESP32\AQUAScanESP32\AQUAScanESP32.ino:553:void handleUsbSerialCommand(String command)
Firmware\ESP32\AQUAScanESP32\AQUAScanESP32.ino:574:    leftMicros = kNeutralMicros;
Firmware\ESP32\AQUAScanESP32\AQUAScanESP32.ino:575:    rightMicros = kNeutralMicros;
Firmware\ESP32\AQUAScanESP32\AQUAScanESP32.ino:588:    leftMicros = kNeutralMicros;
Firmware\ESP32\AQUAScanESP32\AQUAScanESP32.ino:589:    rightMicros = kNeutralMicros;
Firmware\ESP32\AQUAScanESP32\AQUAScanESP32.ino:602:    leftMicros = kNeutralMicros;
Firmware\ESP32\AQUAScanESP32\AQUAScanESP32.ino:603:    rightMicros = kNeutralMicros;
Firmware\ESP32\AQUAScanESP32\AQUAScanESP32.ino:616:    leftMicros = kNeutralMicros;
Firmware\ESP32\AQUAScanESP32\AQUAScanESP32.ino:617:    rightMicros = kNeutralMicros;
Firmware\ESP32\AQUAScanESP32\AQUAScanESP32.ino:627:    const int separator = command.indexOf(' ', 4);
Firmware\ESP32\AQUAScanESP32\AQUAScanESP32.ino:634:    const int nextLeft = command.substring(4, separator).toInt();
Firmware\ESP32\AQUAScanESP32\AQUAScanESP32.ino:635:    const int nextRight = command.substring(separator + 1).toInt();
Firmware\ESP32\AQUAScanESP32\AQUAScanESP32.ino:642:    const int pulse = command.substring(5).toInt();
Firmware\ESP32\AQUAScanESP32\AQUAScanESP32.ino:650:void printUsbHelp()
Firmware\ESP32\AQUAScanESP32\AQUAScanESP32.ino:665:void applyManualEscCommand(int left, int right)
Firmware\ESP32\AQUAScanESP32\AQUAScanESP32.ino:679:  if (left < kMinMicros || left > kMaxMicros || right < kMinMicros || right > kMaxMicros)
Firmware\ESP32\AQUAScanESP32\AQUAScanESP32.ino:698:void setupEscOutputs()
Firmware\ESP32\AQUAScanESP32\AQUAScanESP32.ino:700:  if (!kUseDirectEscOutputs)
Firmware\ESP32\AQUAScanESP32\AQUAScanESP32.ino:707:  ledcAttach(kLeftEscPin, kEscPwmHz, kEscPwmResolutionBits);
Firmware\ESP32\AQUAScanESP32\AQUAScanESP32.ino:708:  ledcAttach(kRightEscPin, kEscPwmHz, kEscPwmResolutionBits);
Firmware\ESP32\AQUAScanESP32\AQUAScanESP32.ino:710:  ledcSetup(kLeftEscChannel, kEscPwmHz, kEscPwmResolutionBits);
Firmware\ESP32\AQUAScanESP32\AQUAScanESP32.ino:711:  ledcSetup(kRightEscChannel, kEscPwmHz, kEscPwmResolutionBits);
Firmware\ESP32\AQUAScanESP32\AQUAScanESP32.ino:712:  ledcAttachPin(kLeftEscPin, kLeftEscChannel);
Firmware\ESP32\AQUAScanESP32\AQUAScanESP32.ino:713:  ledcAttachPin(kRightEscPin, kRightEscChannel);
Firmware\ESP32\AQUAScanESP32\AQUAScanESP32.ino:716:  applyEscOutputs(kNeutralMicros, kNeutralMicros);
Firmware\ESP32\AQUAScanESP32\AQUAScanESP32.ino:718:  Serial.print(kLeftEscPin);
Firmware\ESP32\AQUAScanESP32\AQUAScanESP32.ino:720:  Serial.print(kRightEscPin);
Firmware\ESP32\AQUAScanESP32\AQUAScanESP32.ino:724:void applyEscOutputs(int left, int right)
Firmware\ESP32\AQUAScanESP32\AQUAScanESP32.ino:726:  if (!kUseDirectEscOutputs)
Firmware\ESP32\AQUAScanESP32\AQUAScanESP32.ino:729:  writeEscPulse(kLeftEscPin, kLeftEscChannel, left);
Firmware\ESP32\AQUAScanESP32\AQUAScanESP32.ino:730:  writeEscPulse(kRightEscPin, kRightEscChannel, right);
Firmware\ESP32\AQUAScanESP32\AQUAScanESP32.ino:733:void writeEscPulse(int pin, int channel, int micros)
Firmware\ESP32\AQUAScanESP32\AQUAScanESP32.ino:735:  const int clampedMicros = clampPulse(micros);
Firmware\ESP32\AQUAScanESP32\AQUAScanESP32.ino:736:  const uint32_t duty = (static_cast<uint32_t>(clampedMicros) * kEscPwmMaxDuty + (kEscPwmPeriodUs / 2)) / kEscPwmPeriodUs;
Firmware\ESP32\AQUAScanESP32\AQUAScanESP32.ino:745:void readBridgeStatus()
Firmware\ESP32\AQUAScanESP32\AQUAScanESP32.ino:748:  while (BridgeSerial.available() > 0 && processed < kBridgeReadBudget)
Firmware\ESP32\AQUAScanESP32\AQUAScanESP32.ino:750:    const char incoming = static_cast<char>(BridgeSerial.read());
Firmware\ESP32\AQUAScanESP32\AQUAScanESP32.ino:783:    if (bridgeLineLength < kMaxBridgeLineLength - 1)
Firmware\ESP32\AQUAScanESP32\AQUAScanESP32.ino:795:void applyBridgeStatus(const char* line)
Firmware\ESP32\AQUAScanESP32\AQUAScanESP32.ino:808:void applyBridgeProbeStatus(const char* line)
Firmware\ESP32\AQUAScanESP32\AQUAScanESP32.ino:819:void applyBridgeSensorStatus(const char* line)
Firmware\ESP32\AQUAScanESP32\AQUAScanESP32.ino:824:  const char* payload = line + 2;
Firmware\ESP32\AQUAScanESP32\AQUAScanESP32.ino:862:void sendBridgeCommand()
Firmware\ESP32\AQUAScanESP32\AQUAScanESP32.ino:864:  if (!kUseArduinoBridge)
Firmware\ESP32\AQUAScanESP32\AQUAScanESP32.ino:867:  char line[kMaxBridgeCommandLength];
Firmware\ESP32\AQUAScanESP32\AQUAScanESP32.ino:868:  const int length = snprintf(
Firmware\ESP32\AQUAScanESP32\AQUAScanESP32.ino:882:void sendBridgeProbeCommand()
Firmware\ESP32\AQUAScanESP32\AQUAScanESP32.ino:884:  if (!kUseArduinoBridge)
Firmware\ESP32\AQUAScanESP32\AQUAScanESP32.ino:887:  char line[kMaxBridgeCommandLength];
Firmware\ESP32\AQUAScanESP32\AQUAScanESP32.ino:888:  const int length = snprintf(
Firmware\ESP32\AQUAScanESP32\AQUAScanESP32.ino:900:bool writeBridgeLine(const char* line)
Firmware\ESP32\AQUAScanESP32\AQUAScanESP32.ino:902:  const size_t length = strlen(line);
Firmware\ESP32\AQUAScanESP32\AQUAScanESP32.ino:903:  const size_t written = BridgeSerial.write(
Firmware\ESP32\AQUAScanESP32\AQUAScanESP32.ino:904:    reinterpret_cast<const uint8_t*>(line),
Firmware\ESP32\AQUAScanESP32\AQUAScanESP32.ino:918:void stopProbe(const char* reason)
Firmware\ESP32\AQUAScanESP32\AQUAScanESP32.ino:930:void neutralize(const char* reason)
Firmware\ESP32\AQUAScanESP32\AQUAScanESP32.ino:935:  leftMicros = kNeutralMicros;
Firmware\ESP32\AQUAScanESP32\AQUAScanESP32.ino:936:  rightMicros = kNeutralMicros;
Firmware\ESP32\AQUAScanESP32\AQUAScanESP32.ino:951:void updateTelemetry()
Firmware\ESP32\AQUAScanESP32\AQUAScanESP32.ino:957:void updateGps()
Firmware\ESP32\AQUAScanESP32\AQUAScanESP32.ino:961:  while (GpsSerial.available() > 0 && processed < kGpsReadBudget)
Firmware\ESP32\AQUAScanESP32\AQUAScanESP32.ino:982:  if (gpsFix && millis() - lastGpsFixAt > kGpsFreshMs)
Firmware\ESP32\AQUAScanESP32\AQUAScanESP32.ino:987:void updateBattery()
Firmware\ESP32\AQUAScanESP32\AQUAScanESP32.ino:989:  if (kBatterySensePin < 0)
Firmware\ESP32\AQUAScanESP32\AQUAScanESP32.ino:992:  const unsigned long now = millis();
Firmware\ESP32\AQUAScanESP32\AQUAScanESP32.ino:993:  if (now - lastBatterySampleAt < kBatterySampleIntervalMs)
Firmware\ESP32\AQUAScanESP32\AQUAScanESP32.ino:997:  const int raw = analogRead(kBatterySensePin);
Firmware\ESP32\AQUAScanESP32\AQUAScanESP32.ino:998:  const float sensedVoltage = (static_cast<float>(raw) / kAdcMaxValue) * kAdcReferenceVoltage;
Firmware\ESP32\AQUAScanESP32\AQUAScanESP32.ino:999:  batteryVoltage = sensedVoltage * kBatteryDividerScale;
Firmware\ESP32\AQUAScanESP32\AQUAScanESP32.ino:1000:  batteryPercent = constrain(((batteryVoltage - kBatteryEmptyVoltage) / (kBatteryFullVoltage - kBatteryEmptyVoltage)) * 100.0f, 0.0f, 100.0f);
Firmware\ESP32\AQUAScanESP32\AQUAScanESP32.ino:1003:void sendStatus(uint8_t clientNum)
Firmware\ESP32\AQUAScanESP32\AQUAScanESP32.ino:1009:void sendStatusBroadcast()
Firmware\ESP32\AQUAScanESP32\AQUAScanESP32.ino:1015:void sendSensorBroadcast()
Firmware\ESP32\AQUAScanESP32\AQUAScanESP32.ino:1083:void sendMissionAck(uint8_t clientNum, const String& missionId, int seq, bool accepted, const String& text)
Firmware\ESP32\AQUAScanESP32\AQUAScanESP32.ino:1099:void sendMissionProgress(uint8_t clientNum)
Firmware\ESP32\AQUAScanESP32\AQUAScanESP32.ino:1127:void markSocketConnected(uint8_t clientNum)
Firmware\ESP32\AQUAScanESP32\AQUAScanESP32.ino:1129:  if (clientNum >= kTrackedSocketSlots)
Firmware\ESP32\AQUAScanESP32\AQUAScanESP32.ino:1143:void markSocketDisconnected(uint8_t clientNum)
Firmware\ESP32\AQUAScanESP32\AQUAScanESP32.ino:1145:  if (clientNum >= kTrackedSocketSlots)
Firmware\ESP32\AQUAScanESP32\AQUAScanESP32.ino:1160:bool parseCsvIntegers(const char* line, int* values, int expectedCount)
Firmware\ESP32\AQUAScanESP32\AQUAScanESP32.ino:1165:  const char* cursor = line + 2;
Firmware\ESP32\AQUAScanESP32\AQUAScanESP32.ino:1169:    const long parsed = strtol(cursor, &endPointer, 10);
Firmware\ESP32\AQUAScanESP32\AQUAScanESP32.ino:1188:bool parseCsvFloats(const char* line, float* values, int expectedCount)
Firmware\ESP32\AQUAScanESP32\AQUAScanESP32.ino:1190:  const char* cursor = line;
Firmware\ESP32\AQUAScanESP32\AQUAScanESP32.ino:1195:    const float parsed = strtof(cursor, &endPointer);
Firmware\ESP32\AQUAScanESP32\AQUAScanESP32.ino:1216:  if (value < kMinMicros)
Firmware\ESP32\AQUAScanESP32\AQUAScanESP32.ino:1217:    return kMinMicros;
Firmware\ESP32\AQUAScanESP32\AQUAScanESP32.ino:1218:  if (value > kMaxMicros)
Firmware\ESP32\AQUAScanESP32\AQUAScanESP32.ino:1219:    return kMaxMicros;
Firmware\ESP32\AQUAScanESP32\AQUAScanESP32.ino:1223:String socketPayloadToString(const char* payload, size_t length)
Firmware\ESP32\AQUAScanESP32\AQUAScanESP32.ino:1232:String readJsonString(const String& message, const char* key, const String& fallback)
Firmware\ESP32\AQUAScanESP32\AQUAScanESP32.ino:1242:    const char current = message[index++];
Firmware\ESP32\AQUAScanESP32\AQUAScanESP32.ino:1254:bool readJsonBool(const String& message, const char* key, bool fallback)
Firmware\ESP32\AQUAScanESP32\AQUAScanESP32.ino:1256:  const int index = findJsonValueStart(message, key);
Firmware\ESP32\AQUAScanESP32\AQUAScanESP32.ino:1267:int readJsonInt(const String& message, const char* key, int fallback)
Firmware\ESP32\AQUAScanESP32\AQUAScanESP32.ino:1269:  const int index = findJsonValueStart(message, key);
Firmware\ESP32\AQUAScanESP32\AQUAScanESP32.ino:1274:  const char* start = message.c_str() + index;
Firmware\ESP32\AQUAScanESP32\AQUAScanESP32.ino:1275:  const long parsed = strtol(start, &endPointer, 10);
Firmware\ESP32\AQUAScanESP32\AQUAScanESP32.ino:1282:float readJsonFloat(const String& message, const char* key, float fallback)
Firmware\ESP32\AQUAScanESP32\AQUAScanESP32.ino:1284:  const int index = findJsonValueStart(message, key);
Firmware\ESP32\AQUAScanESP32\AQUAScanESP32.ino:1289:  const char* start = message.c_str() + index;
Firmware\ESP32\AQUAScanESP32\AQUAScanESP32.ino:1290:  const float parsed = strtof(start, &endPointer);
Firmware\ESP32\AQUAScanESP32\AQUAScanESP32.ino:1297:int findJsonValueStart(const String& message, const char* key)
Firmware\ESP32\AQUAScanESP32\AQUAScanESP32.ino:1318:String escapeJson(const String& value)
Firmware\ESP32\AQUAScanESP32\AQUAScanESP32.ino:1324:    const char current = value[i];
Firmware\ESP32\AQUAScanESP32\AQUAScanESP32.ino:1332:void appendSensorJsonFields(String& message)
Firmware\ESP32\AQUAScanESP32\AQUAScanESP32.ino:1337:  const unsigned long sensorAgeMs = millis() - lastSensorAt;
Firmware\ESP32\AQUAScanESP32\AQUAScanESP32.ino:1339:  message += sensorAgeMs <= kSensorFreshMs ? F("true") : F("false");
Firmware\ESP32\AQUAScanESP32\AQUAScanESP32.ino:1377:void appendJsonNumber(String& json, const char* key, double value, int decimals)
Firmware\ESP32\AQUAScanESP32\AQUAScanESP32.ino:1385:void startNetwork()
Firmware\ESP32\AQUAScanESP32\AQUAScanESP32.ino:1389:  startFallbackAccessPoint();
Firmware\ESP32\AQUAScanESP32\AQUAScanESP32.ino:1394:  if (String(kStaSsid) == "YOUR_ROUTER_SSID" || String(kStaPassword) == "YOUR_ROUTER_PASSWORD" || strlen(kStaSsid) == 0)
Firmware\ESP32\AQUAScanESP32\AQUAScanESP32.ino:1401:  WiFi.begin(kStaSsid, kStaPassword);
Firmware\ESP32\AQUAScanESP32\AQUAScanESP32.ino:1403:  Serial.printf("Connecting to router SSID '%s'", kStaSsid);
Firmware\ESP32\AQUAScanESP32\AQUAScanESP32.ino:1404:  const unsigned long startedAt = millis();
Firmware\ESP32\AQUAScanESP32\AQUAScanESP32.ino:1405:  while (WiFi.status() != WL_CONNECTED && millis() - startedAt < kStaConnectTimeoutMs)
Firmware\ESP32\AQUAScanESP32\AQUAScanESP32.ino:1424:void startFallbackAccessPoint()
Firmware\ESP32\AQUAScanESP32\AQUAScanESP32.ino:1427:  WiFi.softAP(kApSsid, kApPassword);
Firmware\ESP32\AQUAScanESP32\AQUAScanESP32.ino:1429:  Serial.println(kApSsid);
Firmware\Arduino\AQUAScanEscBridge\AQUAScanEscBridge.ino:29:  const uint8_t kLeftEscPin = 9;
Firmware\Arduino\AQUAScanEscBridge\AQUAScanEscBridge.ino:30:  const uint8_t kRightEscPin = 10;
Firmware\Arduino\AQUAScanEscBridge\AQUAScanEscBridge.ino:31:  const uint8_t kWinchLowerPin = 7;
Firmware\Arduino\AQUAScanEscBridge\AQUAScanEscBridge.ino:32:  const uint8_t kWinchRaisePin = 6;
Firmware\Arduino\AQUAScanEscBridge\AQUAScanEscBridge.ino:33:  const uint8_t kRs485DirPin = 45;
Firmware\Arduino\AQUAScanEscBridge\AQUAScanEscBridge.ino:35:  const unsigned long kBridgeBaudRate = 115200;
Firmware\Arduino\AQUAScanEscBridge\AQUAScanEscBridge.ino:36:  const unsigned long kRs485BaudRate = 19200;
Firmware\Arduino\AQUAScanEscBridge\AQUAScanEscBridge.ino:37:  const unsigned long kDebugBaudRate = 115200;
Firmware\Arduino\AQUAScanEscBridge\AQUAScanEscBridge.ino:38:  const unsigned long kStartupNeutralDelayMs = 5000;
Firmware\Arduino\AQUAScanEscBridge\AQUAScanEscBridge.ino:39:  const unsigned long kCommandTimeoutMs = 3500;
Firmware\Arduino\AQUAScanEscBridge\AQUAScanEscBridge.ino:40:  const unsigned long kStatusIntervalMs = 1000;
Firmware\Arduino\AQUAScanEscBridge\AQUAScanEscBridge.ino:41:  const unsigned long kRs485DiagnosticIntervalMs = 2000;
Firmware\Arduino\AQUAScanEscBridge\AQUAScanEscBridge.ino:42:  const size_t kBridgeReadBudget = 48;
Firmware\Arduino\AQUAScanEscBridge\AQUAScanEscBridge.ino:43:  const size_t kRs485ReadBudget = 128;
Firmware\Arduino\AQUAScanEscBridge\AQUAScanEscBridge.ino:45:  const int kNeutralMicros = 1500;
Firmware\Arduino\AQUAScanEscBridge\AQUAScanEscBridge.ino:46:  const int kMinMicros = 1000;
Firmware\Arduino\AQUAScanEscBridge\AQUAScanEscBridge.ino:47:  const int kMaxMicros = 2000;
Firmware\Arduino\AQUAScanEscBridge\AQUAScanEscBridge.ino:48:  const size_t kMaxLineLength = 96;
Firmware\Arduino\AQUAScanEscBridge\AQUAScanEscBridge.ino:49:  const size_t kMaxRs485LineLength = 220;
Firmware\Arduino\AQUAScanEscBridge\AQUAScanEscBridge.ino:55:char serialLine[kMaxLineLength];
Firmware\Arduino\AQUAScanEscBridge\AQUAScanEscBridge.ino:57:char rs485Line[kMaxRs485LineLength];
Firmware\Arduino\AQUAScanEscBridge\AQUAScanEscBridge.ino:63:int leftMicros = kNeutralMicros;
Firmware\Arduino\AQUAScanEscBridge\AQUAScanEscBridge.ino:64:int rightMicros = kNeutralMicros;
Firmware\Arduino\AQUAScanEscBridge\AQUAScanEscBridge.ino:76:void applyOutputs(int left, int right);
Firmware\Arduino\AQUAScanEscBridge\AQUAScanEscBridge.ino:77:void readBridgeCommands();
Firmware\Arduino\AQUAScanEscBridge\AQUAScanEscBridge.ino:78:void setRs485ReceiveMode();
Firmware\Arduino\AQUAScanEscBridge\AQUAScanEscBridge.ino:79:void readRs485Probe();
Firmware\Arduino\AQUAScanEscBridge\AQUAScanEscBridge.ino:80:void printRs485Diagnostics();
Firmware\Arduino\AQUAScanEscBridge\AQUAScanEscBridge.ino:81:void forwardRs485ProbeLine(const char* line);
Firmware\Arduino\AQUAScanEscBridge\AQUAScanEscBridge.ino:82:void handleCommand(const char* line);
Firmware\Arduino\AQUAScanEscBridge\AQUAScanEscBridge.ino:83:void handleDriveCommand(const char* line);
Firmware\Arduino\AQUAScanEscBridge\AQUAScanEscBridge.ino:84:void handleWinchCommand(const char* line);
Firmware\Arduino\AQUAScanEscBridge\AQUAScanEscBridge.ino:85:void neutralize(const char* reason, bool clearEstop);
Firmware\Arduino\AQUAScanEscBridge\AQUAScanEscBridge.ino:86:void stopWinch(const char* reason);
Firmware\Arduino\AQUAScanEscBridge\AQUAScanEscBridge.ino:87:void sendStatus();
Firmware\Arduino\AQUAScanEscBridge\AQUAScanEscBridge.ino:88:void sendWinchStatus();
Firmware\Arduino\AQUAScanEscBridge\AQUAScanEscBridge.ino:89:bool parseDriveCommand(const char* line, int* values, int expectedCount);
Firmware\Arduino\AQUAScanEscBridge\AQUAScanEscBridge.ino:90:bool parseWinchCommand(const char* line, int* values, int expectedCount);
Firmware\Arduino\AQUAScanEscBridge\AQUAScanEscBridge.ino:93:void applyWinch(int direction, int speed);
Firmware\Arduino\AQUAScanEscBridge\AQUAScanEscBridge.ino:94:void printLineHex(const char* line);
Firmware\Arduino\AQUAScanEscBridge\AQUAScanEscBridge.ino:96:void setup()
Firmware\Arduino\AQUAScanEscBridge\AQUAScanEscBridge.ino:98:  Serial.begin(kDebugBaudRate);
Firmware\Arduino\AQUAScanEscBridge\AQUAScanEscBridge.ino:99:  Serial2.begin(kBridgeBaudRate);
Firmware\Arduino\AQUAScanEscBridge\AQUAScanEscBridge.ino:100:  Serial3.begin(kRs485BaudRate);
Firmware\Arduino\AQUAScanEscBridge\AQUAScanEscBridge.ino:102:  leftEsc.attach(kLeftEscPin);
Firmware\Arduino\AQUAScanEscBridge\AQUAScanEscBridge.ino:103:  rightEsc.attach(kRightEscPin);
Firmware\Arduino\AQUAScanEscBridge\AQUAScanEscBridge.ino:104:  pinMode(kWinchLowerPin, OUTPUT);
Firmware\Arduino\AQUAScanEscBridge\AQUAScanEscBridge.ino:105:  pinMode(kWinchRaisePin, OUTPUT);
Firmware\Arduino\AQUAScanEscBridge\AQUAScanEscBridge.ino:106:  pinMode(kRs485DirPin, OUTPUT);
Firmware\Arduino\AQUAScanEscBridge\AQUAScanEscBridge.ino:109:  applyOutputs(kNeutralMicros, kNeutralMicros);
Firmware\Arduino\AQUAScanEscBridge\AQUAScanEscBridge.ino:112:  delay(kStartupNeutralDelayMs);
Firmware\Arduino\AQUAScanEscBridge\AQUAScanEscBridge.ino:119:void loop()
Firmware\Arduino\AQUAScanEscBridge\AQUAScanEscBridge.ino:125:  const unsigned long now = millis();
Firmware\Arduino\AQUAScanEscBridge\AQUAScanEscBridge.ino:127:  if (armed && lastCommandAt > 0 && now - lastCommandAt > kCommandTimeoutMs)
Firmware\Arduino\AQUAScanEscBridge\AQUAScanEscBridge.ino:130:  if (lastWinchCommandAt > 0 && now - lastWinchCommandAt > kCommandTimeoutMs)
Firmware\Arduino\AQUAScanEscBridge\AQUAScanEscBridge.ino:133:  if (now - lastStatusAt >= kStatusIntervalMs)
Firmware\Arduino\AQUAScanEscBridge\AQUAScanEscBridge.ino:140:void setRs485ReceiveMode()
Firmware\Arduino\AQUAScanEscBridge\AQUAScanEscBridge.ino:143:  digitalWrite(kRs485DirPin, LOW);
Firmware\Arduino\AQUAScanEscBridge\AQUAScanEscBridge.ino:146:void readRs485Probe()
Firmware\Arduino\AQUAScanEscBridge\AQUAScanEscBridge.ino:149:  while (Serial3.available() > 0 && processed < kRs485ReadBudget)
Firmware\Arduino\AQUAScanEscBridge\AQUAScanEscBridge.ino:151:    const char incoming = static_cast<char>(Serial3.read());
Firmware\Arduino\AQUAScanEscBridge\AQUAScanEscBridge.ino:169:    if (rs485LineLength < kMaxRs485LineLength - 1)
Firmware\Arduino\AQUAScanEscBridge\AQUAScanEscBridge.ino:181:void printRs485Diagnostics()
Firmware\Arduino\AQUAScanEscBridge\AQUAScanEscBridge.ino:186:  const unsigned long now = millis();
Firmware\Arduino\AQUAScanEscBridge\AQUAScanEscBridge.ino:187:  if (now - lastRs485DiagnosticAt < kRs485DiagnosticIntervalMs)
Firmware\Arduino\AQUAScanEscBridge\AQUAScanEscBridge.ino:199:void forwardRs485ProbeLine(const char* line)
Firmware\Arduino\AQUAScanEscBridge\AQUAScanEscBridge.ino:210:  const bool prefixedProbeLine = line[0] == 'P' && line[1] == ',';
Firmware\Arduino\AQUAScanEscBridge\AQUAScanEscBridge.ino:211:  const bool bareSensorCsv = line[0] >= '0' && line[0] <= '9';
Firmware\Arduino\AQUAScanEscBridge\AQUAScanEscBridge.ino:230:void readBridgeCommands()
Firmware\Arduino\AQUAScanEscBridge\AQUAScanEscBridge.ino:233:  while (Serial2.available() > 0 && processed < kBridgeReadBudget)
Firmware\Arduino\AQUAScanEscBridge\AQUAScanEscBridge.ino:235:    const char incoming = static_cast<char>(Serial2.read());
Firmware\Arduino\AQUAScanEscBridge\AQUAScanEscBridge.ino:261:    if (serialLineLength < kMaxLineLength - 1)
Firmware\Arduino\AQUAScanEscBridge\AQUAScanEscBridge.ino:273:void handleCommand(const char* line)
Firmware\Arduino\AQUAScanEscBridge\AQUAScanEscBridge.ino:295:void handleDriveCommand(const char* line)
Firmware\Arduino\AQUAScanEscBridge\AQUAScanEscBridge.ino:297:  int values[5] = { lastSeq, 0, 0, kNeutralMicros, kNeutralMicros };
Firmware\Arduino\AQUAScanEscBridge\AQUAScanEscBridge.ino:306:  const int nextSeq = values[0];
Firmware\Arduino\AQUAScanEscBridge\AQUAScanEscBridge.ino:307:  const bool nextArmed = values[1] != 0;
Firmware\Arduino\AQUAScanEscBridge\AQUAScanEscBridge.ino:308:  const bool nextEstop = values[2] != 0;
Firmware\Arduino\AQUAScanEscBridge\AQUAScanEscBridge.ino:309:  const int nextLeft = clampPulse(values[3]);
Firmware\Arduino\AQUAScanEscBridge\AQUAScanEscBridge.ino:310:  const int nextRight = clampPulse(values[4]);
Firmware\Arduino\AQUAScanEscBridge\AQUAScanEscBridge.ino:315:  leftMicros = armed ? nextLeft : kNeutralMicros;
Firmware\Arduino\AQUAScanEscBridge\AQUAScanEscBridge.ino:316:  rightMicros = armed ? nextRight : kNeutralMicros;
Firmware\Arduino\AQUAScanEscBridge\AQUAScanEscBridge.ino:321:  const unsigned long now = millis();
Firmware\Arduino\AQUAScanEscBridge\AQUAScanEscBridge.ino:334:void handleWinchCommand(const char* line)
Firmware\Arduino\AQUAScanEscBridge\AQUAScanEscBridge.ino:364:void applyOutputs(int left, int right)
Firmware\Arduino\AQUAScanEscBridge\AQUAScanEscBridge.ino:370:void neutralize(const char* reason, bool clearEstop)
Firmware\Arduino\AQUAScanEscBridge\AQUAScanEscBridge.ino:376:  leftMicros = kNeutralMicros;
Firmware\Arduino\AQUAScanEscBridge\AQUAScanEscBridge.ino:377:  rightMicros = kNeutralMicros;
Firmware\Arduino\AQUAScanEscBridge\AQUAScanEscBridge.ino:389:void stopWinch(const char* reason)
Firmware\Arduino\AQUAScanEscBridge\AQUAScanEscBridge.ino:401:void sendStatus()
Firmware\Arduino\AQUAScanEscBridge\AQUAScanEscBridge.ino:417:void sendWinchStatus()
Firmware\Arduino\AQUAScanEscBridge\AQUAScanEscBridge.ino:427:bool parseDriveCommand(const char* line, int* values, int expectedCount)
Firmware\Arduino\AQUAScanEscBridge\AQUAScanEscBridge.ino:432:  const char* cursor = line + 2;
Firmware\Arduino\AQUAScanEscBridge\AQUAScanEscBridge.ino:437:    const long parsed = strtol(cursor, &endPointer, 10);
Firmware\Arduino\AQUAScanEscBridge\AQUAScanEscBridge.ino:456:bool parseWinchCommand(const char* line, int* values, int expectedCount)
Firmware\Arduino\AQUAScanEscBridge\AQUAScanEscBridge.ino:461:  const char* cursor = line + 2;
Firmware\Arduino\AQUAScanEscBridge\AQUAScanEscBridge.ino:466:    const long parsed = strtol(cursor, &endPointer, 10);
Firmware\Arduino\AQUAScanEscBridge\AQUAScanEscBridge.ino:487:  if (value < kMinMicros)
Firmware\Arduino\AQUAScanEscBridge\AQUAScanEscBridge.ino:488:    return kMinMicros;
Firmware\Arduino\AQUAScanEscBridge\AQUAScanEscBridge.ino:489:  if (value > kMaxMicros)
Firmware\Arduino\AQUAScanEscBridge\AQUAScanEscBridge.ino:490:    return kMaxMicros;
Firmware\Arduino\AQUAScanEscBridge\AQUAScanEscBridge.ino:503:void applyWinch(int direction, int speed)
Firmware\Arduino\AQUAScanEscBridge\AQUAScanEscBridge.ino:505:  const int clampedSpeed = clampWinchSpeed(speed);
Firmware\Arduino\AQUAScanEscBridge\AQUAScanEscBridge.ino:509:    analogWrite(kWinchLowerPin, clampedSpeed);
Firmware\Arduino\AQUAScanEscBridge\AQUAScanEscBridge.ino:510:    analogWrite(kWinchRaisePin, 0);
Firmware\Arduino\AQUAScanEscBridge\AQUAScanEscBridge.ino:516:    analogWrite(kWinchLowerPin, 0);
Firmware\Arduino\AQUAScanEscBridge\AQUAScanEscBridge.ino:517:    analogWrite(kWinchRaisePin, clampedSpeed);
Firmware\Arduino\AQUAScanEscBridge\AQUAScanEscBridge.ino:521:  analogWrite(kWinchLowerPin, 0);
Firmware\Arduino\AQUAScanEscBridge\AQUAScanEscBridge.ino:522:  analogWrite(kWinchRaisePin, 0);
Firmware\Arduino\AQUAScanEscBridge\AQUAScanEscBridge.ino:525:void printLineHex(const char* line)
Firmware\Arduino\AQUAScanEscBridge\AQUAScanEscBridge.ino:530:    const uint8_t value = static_cast<uint8_t>(line[i]);
Firmware\ESP32\AQUAScanSensors\AQUAScanSensors.ino:33:  const int kTempPin = 4;
Firmware\ESP32\AQUAScanSensors\AQUAScanSensors.ino:35:  const int kTurbidityAnalogPin = 35;
Firmware\ESP32\AQUAScanSensors\AQUAScanSensors.ino:36:  const int kPhAnalogPin = 34;
Firmware\ESP32\AQUAScanSensors\AQUAScanSensors.ino:37:  const int kDissolvedOxygenAnalogPin = 32;
Firmware\ESP32\AQUAScanSensors\AQUAScanSensors.ino:38:  const int kTdsAnalogPin = 33;
Firmware\ESP32\AQUAScanSensors\AQUAScanSensors.ino:39:  const int kUvAnalogPin = 36;      // ESP32 SVP/SUP/VP input-only analog pin
Firmware\ESP32\AQUAScanSensors\AQUAScanSensors.ino:40:  const int kLightAnalogPin = 39;   // ESP32 SVN/VN input-only analog pin
Firmware\ESP32\AQUAScanSensors\AQUAScanSensors.ino:42:  const int kUltrasonicTrigPin = 25;
Firmware\ESP32\AQUAScanSensors\AQUAScanSensors.ino:43:  const int kUltrasonicEchoPin = 27;
Firmware\ESP32\AQUAScanSensors\AQUAScanSensors.ino:45:  const int kRs485TxPin = 17;
Firmware\ESP32\AQUAScanSensors\AQUAScanSensors.ino:46:  const int kRs485RxPin = 16;
Firmware\ESP32\AQUAScanSensors\AQUAScanSensors.ino:47:  const int kRs485ControlPin = 5;
Firmware\ESP32\AQUAScanSensors\AQUAScanSensors.ino:49:  const unsigned long kSerialBaud = 19200;
Firmware\ESP32\AQUAScanSensors\AQUAScanSensors.ino:50:  const unsigned long kRs485Baud = 19200;
Firmware\ESP32\AQUAScanSensors\AQUAScanSensors.ino:51:  const unsigned long kSampleIntervalMs = 1000;
Firmware\ESP32\AQUAScanSensors\AQUAScanSensors.ino:52:  const unsigned long kUltrasonicTimeoutUs = 30000;
Firmware\ESP32\AQUAScanSensors\AQUAScanSensors.ino:54:  const float kAdcReferenceVoltage = 3.3f;
Firmware\ESP32\AQUAScanSensors\AQUAScanSensors.ino:55:  const float kAdcMaxValue = 4095.0f;
Firmware\ESP32\AQUAScanSensors\AQUAScanSensors.ino:59:OneWire oneWire(kTempPin);
Firmware\ESP32\AQUAScanSensors\AQUAScanSensors.ino:70:  return (static_cast<float>(raw) / kAdcMaxValue) * kAdcReferenceVoltage;
Firmware\ESP32\AQUAScanSensors\AQUAScanSensors.ino:88:  digitalWrite(kUltrasonicTrigPin, LOW);
Firmware\ESP32\AQUAScanSensors\AQUAScanSensors.ino:90:  digitalWrite(kUltrasonicTrigPin, HIGH);
Firmware\ESP32\AQUAScanSensors\AQUAScanSensors.ino:92:  digitalWrite(kUltrasonicTrigPin, LOW);
Firmware\ESP32\AQUAScanSensors\AQUAScanSensors.ino:94:  unsigned long durationUs = pulseIn(kUltrasonicEchoPin, HIGH, kUltrasonicTimeoutUs);
Firmware\ESP32\AQUAScanSensors\AQUAScanSensors.ino:101:void setRs485ReceiveMode()
Firmware\ESP32\AQUAScanSensors\AQUAScanSensors.ino:103:  digitalWrite(kRs485ControlPin, LOW);
Firmware\ESP32\AQUAScanSensors\AQUAScanSensors.ino:106:void setRs485TransmitMode()
Firmware\ESP32\AQUAScanSensors\AQUAScanSensors.ino:108:  digitalWrite(kRs485ControlPin, HIGH);
Firmware\ESP32\AQUAScanSensors\AQUAScanSensors.ino:111:void drainRs485ToSerial()
Firmware\ESP32\AQUAScanSensors\AQUAScanSensors.ino:120:void printCsvHeader()
Firmware\ESP32\AQUAScanSensors\AQUAScanSensors.ino:134:void printValueOrNaN(Print& output, float value, int decimals)
Firmware\ESP32\AQUAScanSensors\AQUAScanSensors.ino:142:void printSensorCsv(
Firmware\ESP32\AQUAScanSensors\AQUAScanSensors.ino:189:void sampleAndPrint()
Firmware\ESP32\AQUAScanSensors\AQUAScanSensors.ino:192:  int tempRawGpio = digitalRead(kTempPin);
Firmware\ESP32\AQUAScanSensors\AQUAScanSensors.ino:194:  int turbidityRaw = analogRead(kTurbidityAnalogPin);
Firmware\ESP32\AQUAScanSensors\AQUAScanSensors.ino:195:  int phRaw = analogRead(kPhAnalogPin);
Firmware\ESP32\AQUAScanSensors\AQUAScanSensors.ino:196:  int dissolvedOxygenRaw = analogRead(kDissolvedOxygenAnalogPin);
Firmware\ESP32\AQUAScanSensors\AQUAScanSensors.ino:197:  int tdsRaw = analogRead(kTdsAnalogPin);
Firmware\ESP32\AQUAScanSensors\AQUAScanSensors.ino:198:  int uvRaw = analogRead(kUvAnalogPin);
Firmware\ESP32\AQUAScanSensors\AQUAScanSensors.ino:199:  int lightAnalogRaw = analogRead(kLightAnalogPin);
Firmware\ESP32\AQUAScanSensors\AQUAScanSensors.ino:202:  const unsigned long sequence = sampleSeq++;
Firmware\ESP32\AQUAScanSensors\AQUAScanSensors.ino:237:void setup()
Firmware\ESP32\AQUAScanSensors\AQUAScanSensors.ino:239:  Serial.begin(kSerialBaud);
Firmware\ESP32\AQUAScanSensors\AQUAScanSensors.ino:242:  pinMode(kTempPin, INPUT);
Firmware\ESP32\AQUAScanSensors\AQUAScanSensors.ino:243:  pinMode(kUltrasonicTrigPin, OUTPUT);
Firmware\ESP32\AQUAScanSensors\AQUAScanSensors.ino:244:  pinMode(kUltrasonicEchoPin, INPUT);
Firmware\ESP32\AQUAScanSensors\AQUAScanSensors.ino:245:  pinMode(kRs485ControlPin, OUTPUT);
Firmware\ESP32\AQUAScanSensors\AQUAScanSensors.ino:249:  analogSetPinAttenuation(kTurbidityAnalogPin, ADC_11db);
Firmware\ESP32\AQUAScanSensors\AQUAScanSensors.ino:250:  analogSetPinAttenuation(kPhAnalogPin, ADC_11db);
Firmware\ESP32\AQUAScanSensors\AQUAScanSensors.ino:251:  analogSetPinAttenuation(kDissolvedOxygenAnalogPin, ADC_11db);
Firmware\ESP32\AQUAScanSensors\AQUAScanSensors.ino:252:  analogSetPinAttenuation(kTdsAnalogPin, ADC_11db);
Firmware\ESP32\AQUAScanSensors\AQUAScanSensors.ino:253:  analogSetPinAttenuation(kUvAnalogPin, ADC_11db);
Firmware\ESP32\AQUAScanSensors\AQUAScanSensors.ino:254:  analogSetPinAttenuation(kLightAnalogPin, ADC_11db);
Firmware\ESP32\AQUAScanSensors\AQUAScanSensors.ino:260:  Rs485Serial.begin(kRs485Baud, SERIAL_8N1, kRs485RxPin, kRs485TxPin);
Firmware\ESP32\AQUAScanSensors\AQUAScanSensors.ino:272:void loop()
Firmware\ESP32\AQUAScanSensors\AQUAScanSensors.ino:275:  if (now - lastSampleAt >= kSampleIntervalMs)
Assets\Scripts\Config\MetricRegistry.cs:10:    public class MetricDescriptor
Assets\Scripts\Config\MetricRegistry.cs:31:    public static class MetricRegistry
Assets\Scripts\Config\MetricRegistry.cs:64:        public static void AddOrUpdate(MetricDescriptor descriptor)
Assets\Scripts\Config\MetricRegistry.cs:71:        private static void InitDefaults()
Assets\Scripts\AquaData\AquaMission.cs:9:    public class AquaMission
Assets\Scripts\AquaData\AquaMission.cs:22:    public class GeoReference
Assets\Scripts\AquaData\SpoolDepthEstimator.cs:9:    public static class SpoolDepthEstimator
ML\aquascan_ml\data.py:12:class MissionSample:
ML\aquascan_ml\data.py:20:class Mission:
Assets\Scripts\Controllers\AquaMissionController.cs:21:    public class AquaMissionController : MonoBehaviour
Assets\Scripts\Controllers\AquaMissionController.cs:23:        private const string BoatHostPrefKey = "AQUAScan.Live.BoatHost";
Assets\Scripts\Controllers\AquaMissionController.cs:24:        private const string BoatPortPrefKey = "AQUAScan.Live.BoatPort";
Assets\Scripts\Controllers\AquaMissionController.cs:25:        private const string DeadzonePrefKey = "AQUAScan.Live.Deadzone";
Assets\Scripts\Controllers\AquaMissionController.cs:26:        private const string MaxOutputPrefKey = "AQUAScan.Live.MaxOutput";
Assets\Scripts\Controllers\AquaMissionController.cs:27:        private const string ModePrefKey = "AQUAScan.Live.Mode";
Assets\Scripts\Controllers\AquaMissionController.cs:34:        public BoatTrackRenderer TrackRenderer;
Assets\Scripts\Controllers\AquaMissionController.cs:56:        public Toggle TrackToggle;
Assets\Scripts\Controllers\AquaMissionController.cs:110:        private void Awake()
Assets\Scripts\Controllers\AquaMissionController.cs:117:        private void Start()
Assets\Scripts\Controllers\AquaMissionController.cs:137:        private void Update()
Assets\Scripts\Controllers\AquaMissionController.cs:161:        private void OnDestroy()
Assets\Scripts\Controllers\AquaMissionController.cs:176:        public void RefreshUiBindings()
Assets\Scripts\Controllers\AquaMissionController.cs:182:            ApplyPlaybackUiState();
Assets\Scripts\Controllers\AquaMissionController.cs:186:        public void SetOperationMode(AquaOperationMode mode)
Assets\Scripts\Controllers\AquaMissionController.cs:191:        public void SetOperationMode(AquaOperationMode mode, bool savePreference)
Assets\Scripts\Controllers\AquaMissionController.cs:197:                UpdatePlaybackButtonLabel();
Assets\Scripts\Controllers\AquaMissionController.cs:207:            ApplyPlaybackUiState();
Assets\Scripts\Controllers\AquaMissionController.cs:214:        public void LoadMission(string path)
Assets\Scripts\Controllers\AquaMissionController.cs:239:            TrackRenderer?.RenderTrack(mission);
Assets\Scripts\Controllers\AquaMissionController.cs:245:            UpdatePlaybackButtonLabel();
Assets\Scripts\Controllers\AquaMissionController.cs:251:        public void TogglePlayPause()
Assets\Scripts\Controllers\AquaMissionController.cs:257:            UpdatePlaybackButtonLabel();
Assets\Scripts\Controllers\AquaMissionController.cs:260:        public void UpdateLiveUi()
Assets\Scripts\Controllers\AquaMissionController.cs:265:        private void SetupMetricDropdown()
Assets\Scripts\Controllers\AquaMissionController.cs:275:        private void RebuildMetricDropdown(AquaMission mission)
Assets\Scripts\Controllers\AquaMissionController.cs:314:        private void WireMissionUiCallbacks()
Assets\Scripts\Controllers\AquaMissionController.cs:316:            if (TrackToggle != null)
Assets\Scripts\Controllers\AquaMissionController.cs:318:                TrackToggle.onValueChanged.RemoveListener(OnTrackToggle);
Assets\Scripts\Controllers\AquaMissionController.cs:319:                TrackToggle.onValueChanged.AddListener(OnTrackToggle);
Assets\Scripts\Controllers\AquaMissionController.cs:353:        private void WireLiveUiCallbacks()
Assets\Scripts\Controllers\AquaMissionController.cs:404:        private void OnLoadMissionButtonClicked()
Assets\Scripts\Controllers\AquaMissionController.cs:410:        private void OnMetricDropdownChanged(int index)
Assets\Scripts\Controllers\AquaMissionController.cs:416:        public void SetActiveMetric(string metricId)
Assets\Scripts\Controllers\AquaMissionController.cs:425:        private void OnTrackToggle(bool state)
Assets\Scripts\Controllers\AquaMissionController.cs:427:            TrackRenderer?.ToggleVisibility(state);
Assets\Scripts\Controllers\AquaMissionController.cs:430:        private void OnPointsToggle(bool state)
Assets\Scripts\Controllers\AquaMissionController.cs:435:        private void OnHeatmapToggle(bool state)
Assets\Scripts\Controllers\AquaMissionController.cs:440:        private void OnTimelineScrubbed(float normalized)
Assets\Scripts\Controllers\AquaMissionController.cs:449:        private void OnLiveModeToggleChanged(bool isOn)
Assets\Scripts\Controllers\AquaMissionController.cs:454:        private async void OnConnectButtonClicked()
Assets\Scripts\Controllers\AquaMissionController.cs:468:        private void OnArmButtonClicked()
Assets\Scripts\Controllers\AquaMissionController.cs:481:        private async void OnEStopButtonClicked()
Assets\Scripts\Controllers\AquaMissionController.cs:505:        private void OnBoatHostEdited(string value)
Assets\Scripts\Controllers\AquaMissionController.cs:513:        private void OnBoatPortEdited(string value)
Assets\Scripts\Controllers\AquaMissionController.cs:521:        private void OnDeadzoneEdited(string value)
Assets\Scripts\Controllers\AquaMissionController.cs:529:        private void OnMaxOutputEdited(string value)
Assets\Scripts\Controllers\AquaMissionController.cs:592:        private void SendCurrentDriveFrame()
Assets\Scripts\Controllers\AquaMissionController.cs:619:                JoystickX = rawInput.x,
Assets\Scripts\Controllers\AquaMissionController.cs:620:                JoystickY = rawInput.y,
Assets\Scripts\Controllers\AquaMissionController.cs:628:        private void DrainLiveTransport()
Assets\Scripts\Controllers\AquaMissionController.cs:640:        private void HandleLiveTransportEvent(LiveTransportEvent transportEvent)
Assets\Scripts\Controllers\AquaMissionController.cs:670:        private void HandleLiveStatus(DriveStatus status)
Assets\Scripts\Controllers\AquaMissionController.cs:684:        private void HandleTimeChanged(float normalized)
Assets\Scripts\Controllers\AquaMissionController.cs:689:            if (Player != null && TrackRenderer != null && Player.TryGetSegment(out var from, out var to, out var lerp))
Assets\Scripts\Controllers\AquaMissionController.cs:691:                TrackRenderer.UpdateBoatPosition(from, to, lerp);
Assets\Scripts\Controllers\AquaMissionController.cs:703:        private void UpdateLegend(string metricId)
Assets\Scripts\Controllers\AquaMissionController.cs:719:            const int width = 192;
Assets\Scripts\Controllers\AquaMissionController.cs:720:            const int height = 18;
Assets\Scripts\Controllers\AquaMissionController.cs:721:            const float radius = 7f;
Assets\Scripts\Controllers\AquaMissionController.cs:748:        private void UpdateCurrentValueLabel()
Assets\Scripts\Controllers\AquaMissionController.cs:796:        private void UpdateLayerVisibility()
Assets\Scripts\Controllers\AquaMissionController.cs:798:            if (TrackToggle != null)
Assets\Scripts\Controllers\AquaMissionController.cs:799:                TrackRenderer?.ToggleVisibility(TrackToggle.isOn);
Assets\Scripts\Controllers\AquaMissionController.cs:823:        private void LoadLivePreferences()
Assets\Scripts\Controllers\AquaMissionController.cs:832:        private void SaveLivePreferences()
Assets\Scripts\Controllers\AquaMissionController.cs:842:        private void SyncLiveSettingsFromUi()
Assets\Scripts\Controllers\AquaMissionController.cs:873:        private void RefreshLiveInputFields()
Assets\Scripts\Controllers\AquaMissionController.cs:885:        private void ApplyPlaybackUiState()
Assets\Scripts\Controllers\AquaMissionController.cs:887:            bool playbackMode = OperationMode == AquaOperationMode.Playback;
Assets\Scripts\Controllers\AquaMissionController.cs:888:            SetInteractable(TimeSlider, playbackMode);
Assets\Scripts\Controllers\AquaMissionController.cs:889:            SetInteractable(PlayPauseButton, playbackMode);
Assets\Scripts\Controllers\AquaMissionController.cs:890:            SetInteractable(PathInputField, playbackMode);
Assets\Scripts\Controllers\AquaMissionController.cs:891:            SetInteractable(LoadButton, playbackMode);
Assets\Scripts\Controllers\AquaMissionController.cs:892:            UpdatePlaybackButtonLabel();
Assets\Scripts\Controllers\AquaMissionController.cs:895:        private void UpdatePlaybackButtonLabel()
Assets\Scripts\Controllers\AquaMissionController.cs:901:        private void RefreshLiveUi()
Assets\Scripts\Controllers\AquaMissionController.cs:962:        private void UpdateConnectionStatus(string message)
Assets\Scripts\Controllers\AquaMissionController.cs:980:        private static void SetInteractable(Selectable selectable, bool interactable)
Assets\Scripts\Control\VirtualJoystick.cs:7:    public class VirtualJoystick : MonoBehaviour, IPointerDownHandler, IDragHandler, IPointerUpHandler
Assets\Scripts\Control\VirtualJoystick.cs:18:        public void Configure(RectTransform background, RectTransform handle)
Assets\Scripts\Control\VirtualJoystick.cs:25:        public void OnPointerDown(PointerEventData eventData)
Assets\Scripts\Control\VirtualJoystick.cs:33:        public void OnDrag(PointerEventData eventData)
Assets\Scripts\Control\VirtualJoystick.cs:41:        public void OnPointerUp(PointerEventData eventData)
Assets\Scripts\Control\VirtualJoystick.cs:49:        public void ResetState()
Assets\Scripts\Control\VirtualJoystick.cs:54:        private void UpdatePointer(PointerEventData eventData)
Assets\Scripts\Control\VirtualJoystick.cs:73:        private void SetValue(Vector2 value)
Assets\Scripts\Visualization\SamplePointCloud.cs:12:    public class SamplePointCloud : MonoBehaviour
Assets\Scripts\Visualization\SamplePointCloud.cs:23:        private void Awake()
Assets\Scripts\Visualization\SamplePointCloud.cs:28:        private void OnEnable()
Assets\Scripts\Visualization\SamplePointCloud.cs:33:        private void EnsureParticleSystem()
Assets\Scripts\Visualization\SamplePointCloud.cs:41:        private void ConfigureParticleSystem()
Assets\Scripts\Visualization\SamplePointCloud.cs:55:        public void Render(AquaMission mission, string metricId)
Assets\Scripts\Visualization\SamplePointCloud.cs:86:        public void UpdateMetric(string metricId)
Assets\Scripts\Visualization\SamplePointCloud.cs:108:        public void ToggleVisibility(bool visible)
Assets\Scripts\Control\Esp8266WebSocketClient.cs:12:    public sealed class Esp8266WebSocketClient : IDisposable
Assets\Scripts\Control\Esp8266WebSocketClient.cs:89:                type = "hello",
Assets\Scripts\Control\Esp8266WebSocketClient.cs:100:                type = "drive",
Assets\Scripts\Control\Esp8266WebSocketClient.cs:104:                x = command.JoystickX,
Assets\Scripts\Control\Esp8266WebSocketClient.cs:105:                y = command.JoystickY,
Assets\Scripts\Control\Esp8266WebSocketClient.cs:116:                type = "estop",
Assets\Scripts\Control\Esp8266WebSocketClient.cs:132:        public void Dispose()
Assets\Scripts\Control\Esp8266WebSocketClient.cs:209:        private void ParseIncomingMessage(string json)
Assets\Scripts\Control\Esp8266WebSocketClient.cs:243:        private void QueueEvent(LiveTransportEventType type, bool connected, string message)
Assets\Scripts\Control\Esp8266WebSocketClient.cs:255:        private sealed class HelloMessage
Assets\Scripts\Control\Esp8266WebSocketClient.cs:263:        private sealed class DriveMessage
Assets\Scripts\Control\Esp8266WebSocketClient.cs:276:        private sealed class EStopMessage
Assets\Scripts\Control\Esp8266WebSocketClient.cs:283:        private sealed class StatusMessage
Assets\Scripts\Control\EscPulseMapper.cs:5:    public static class EscPulseMapper
Assets\Scripts\Control\EscPulseMapper.cs:7:        public const int NeutralMicros = 1500;
Assets\Scripts\Control\EscPulseMapper.cs:8:        public const int RangeMicros = 500;
Assets\Scripts\Control\EscPulseMapper.cs:9:        public const int MinMicros = NeutralMicros - RangeMicros;
Assets\Scripts\Control\EscPulseMapper.cs:10:        public const int MaxMicros = NeutralMicros + RangeMicros;
Assets\Scripts\Visualization\CameraBoatOrbit.cs:11:    public class CameraBoatOrbit : MonoBehaviour
Assets\Scripts\Visualization\CameraBoatOrbit.cs:26:        private void Start()
Assets\Scripts\Visualization\CameraBoatOrbit.cs:41:        private void LateUpdate()
Assets\Scripts\Visualization\CameraBoatOrbit.cs:59:        private void HandleInput()
ML\aquascan_ml\model.py:7:class AquaScanMultiTaskModel(nn.Module):
ML\aquascan_ml\model.py:43:class AquaScanOnnxWrapper(nn.Module):
ML\aquascan_ml\model.py:44:    def __init__(self, model: AquaScanMultiTaskModel):
Assets\Scripts\IO\SimpleJson.cs:1:// Lightweight JSON parser (derived from Unity MiniJSON) to avoid external dependencies.
Assets\Scripts\IO\SimpleJson.cs:10:    public static class SimpleJson
Assets\Scripts\IO\SimpleJson.cs:20:        private class Parser : IDisposable
Assets\Scripts\IO\SimpleJson.cs:22:            private const string WORD_BREAK = "{}[],:\"";
Assets\Scripts\IO\SimpleJson.cs:39:            public void Dispose()
Assets\Scripts\IO\SimpleJson.cs:209:            private void EatWhitespace()
Assets\Scripts\IO\SimpleJson.cs:211:                while (char.IsWhiteSpace(PeekChar))
Assets\Scripts\IO\SimpleJson.cs:220:            private char PeekChar => Convert.ToChar(_json.Peek());
Assets\Scripts\IO\SimpleJson.cs:228:                    while (!IsWordBreak(PeekChar))
Assets\Scripts\IO\SimpleJson.cs:246:                    switch (PeekChar)
Assets\Scripts\AI\AquaPredictionResult.cs:6:    public class AquaPredictionResult
Assets\Scripts\AquaData\AquaSample.cs:11:    public class AquaSample
Assets\Scripts\AquaData\AquaSample.cs:35:        public void DebugLogMetrics()
Assets\Scripts\AquaData\AquaSample.cs:43:        public void SetMetric(string metricId, float value)
Assets\Scripts\AI\AquaAiInferenceController.cs:10:    public class AquaAiInferenceController : MonoBehaviour
Assets\Scripts\AI\AquaAiInferenceController.cs:31:        private void Awake()
Assets\Scripts\AI\AquaAiInferenceController.cs:37:        private void OnEnable()
Assets\Scripts\AI\AquaAiInferenceController.cs:42:        private void OnDisable()
Assets\Scripts\AI\AquaAiInferenceController.cs:48:        private void Update()
Assets\Scripts\AI\AquaAiInferenceController.cs:57:        public void WireCallbacks()
Assets\Scripts\AI\AquaAiInferenceController.cs:66:        public void RefreshPrediction()
Assets\Scripts\AI\AquaAiInferenceController.cs:90:        private void UpdateHud(AquaPredictionResult result)
Assets\Scripts\AI\AquaAiInferenceController.cs:110:        private void UpdateHudUnavailable(string message)
Assets\Scripts\Visualization\BoatWakeEffect.cs:10:    public class BoatWakeEffect : MonoBehaviour
Assets\Scripts\Visualization\BoatWakeEffect.cs:22:        private void Awake()
Assets\Scripts\Visualization\BoatWakeEffect.cs:35:        public void UpdateWake(float speedMps, Vector3 moveDirection)
Assets\Scripts\Visualization\BoatWakeEffect.cs:59:                var targetRot = Quaternion.LookRotation(-flatDir, Vector3.up); // emit backwards
Assets\Scripts\AquaData\GeoUtils.cs:9:    public static class GeoUtils
Assets\Scripts\AquaData\GeoUtils.cs:12:        private const double EarthRadius = 6378137.0;
Assets\Scripts\Control\DriveCommand.cs:11:        public float JoystickX;
Assets\Scripts\Control\DriveCommand.cs:12:        public float JoystickY;
Assets\Scripts\Control\DriveCommand.cs:25:                JoystickX = 0f,
Assets\Scripts\Control\DriveCommand.cs:26:                JoystickY = 0f,
ML\aquascan_ml\features.py:62:class Dataset:
ML\aquascan_ml\features.py:72:class NormalizationStats:
Assets\Scripts\Control\DifferentialDriveMixer.cs:5:    public static class DifferentialDriveMixer
Assets\Scripts\AI\AquaOnnxInferenceService.cs:16:    public class AquaOnnxInferenceService
Assets\Scripts\AI\AquaOnnxInferenceService.cs:18:        private const string DefaultBackendName = "Heuristic fallback";
Assets\Scripts\AI\AquaOnnxInferenceService.cs:30:        public void Initialize(string modelPath, string normalizationPath)
Assets\Scripts\AI\AquaOnnxInferenceService.cs:162:        private static void LoadFeatureList(Dictionary<string, object> root, string key, Dictionary<string, int> target)
Assets\Scripts\Visualization\AquaHudTabController.cs:6:    public class AquaHudTabController : MonoBehaviour
Assets\Scripts\Visualization\AquaHudTabController.cs:27:        private void Awake()
Assets\Scripts\Visualization\AquaHudTabController.cs:34:        private void OnEnable()
Assets\Scripts\Visualization\AquaHudTabController.cs:40:        private void OnDisable()
Assets\Scripts\Visualization\AquaHudTabController.cs:50:        public void ShowDriving()
Assets\Scripts\Visualization\AquaHudTabController.cs:55:        public void ShowAiInference()
Assets\Scripts\Visualization\AquaHudTabController.cs:60:        public void ShowSensorData()
Assets\Scripts\Visualization\AquaHudTabController.cs:65:        private void ResolveReferences()
Assets\Scripts\Visualization\AquaHudTabController.cs:75:        private void WireButtons()
Assets\Scripts\Visualization\AquaHudTabController.cs:96:        private void SetActiveTab(HudTab tab)
Assets\Scripts\Visualization\AquaHudTabController.cs:110:        private static void StyleTabButton(Button button, bool active)
Assets\Scripts\IO\MissionLoader.cs:14:    public static class MissionLoader
Assets\Scripts\IO\MissionLoader.cs:214:        private static void FinalizeMission(AquaMission mission)
web\src\domain\drive.ts:1:import type { DriveCommand, LiveSettings } from '../types/aqua'
web\src\domain\drive.ts:3:export const neutralMicros = 1500
web\src\domain\drive.ts:4:export const rangeMicros = 500
web\src\domain\drive.ts:5:export const minMicros = neutralMicros - rangeMicros
web\src\domain\drive.ts:6:export const maxMicros = neutralMicros + rangeMicros
web\src\domain\drive.ts:8:export function applyRadialDeadzone(input: [number, number], deadzone: number): [number, number] {
web\src\domain\drive.ts:9:  const clampedDeadzone = clamp(deadzone, 0, 0.99)
web\src\domain\drive.ts:10:  const magnitude = Math.hypot(input[0], input[1])
web\src\domain\drive.ts:12:  const scaledMagnitude = inverseLerp(clampedDeadzone, 1, Math.min(1, magnitude))
web\src\domain\drive.ts:16:export function mixArcade(joystick: [number, number]): [number, number] {
web\src\domain\drive.ts:17:  const left = joystick[1] + joystick[0]
web\src\domain\drive.ts:18:  const right = joystick[1] - joystick[0]
web\src\domain\drive.ts:19:  const maxMagnitude = Math.max(1, Math.abs(left), Math.abs(right))
web\src\domain\drive.ts:23:export function toMicros(normalized: number, maxOutput: number) {
web\src\domain\drive.ts:24:  const scaled = clamp(normalized, -1, 1) * clamp(maxOutput, 0, 1)
web\src\domain\drive.ts:29:export function buildDriveCommand(
web\src\domain\drive.ts:36:  const raw = [clamp(joystick[0], -1, 1), clamp(joystick[1], -1, 1)] as [number, number]
web\src\domain\drive.ts:37:  const shaped = applyRadialDeadzone(raw, settings.deadzone)
web\src\domain\drive.ts:38:  const mixed = armed && !estop ? mixArcade(shaped) : [0, 0]
web\src\domain\drive.ts:43:    joystickX: raw[0],
web\src\domain\drive.ts:44:    joystickY: raw[1],
web\src\domain\drive.ts:50:function inverseLerp(a: number, b: number, value: number) {
web\src\domain\drive.ts:55:function clamp(value: number, min: number, max: number) {
Assets\Scripts\Visualization\HeatmapSurface.cs:9:    public class HeatmapSurface : MonoBehaviour
Assets\Scripts\Visualization\HeatmapSurface.cs:39:        private void Awake()
Assets\Scripts\Visualization\HeatmapSurface.cs:44:        private void OnEnable()
Assets\Scripts\Visualization\HeatmapSurface.cs:49:        private void EnsureComponents()
Assets\Scripts\Visualization\HeatmapSurface.cs:58:        private void EnsureMaterial()
Assets\Scripts\Visualization\HeatmapSurface.cs:81:        public void ToggleVisibility(bool visible)
Assets\Scripts\Visualization\HeatmapSurface.cs:87:        private void OnValidate()
Assets\Scripts\Visualization\HeatmapSurface.cs:93:        private void Update()
Assets\Scripts\Visualization\HeatmapSurface.cs:103:        public void Generate(AquaMission mission, string metricId)
Assets\Scripts\Visualization\HeatmapSurface.cs:110:        private void GenerateInternal(AquaMission mission, string metricId)
Assets\Scripts\Visualization\HeatmapSurface.cs:246:        public void ConfigurePresentation(float cellSize, float influenceRadius, float trailSoftness, float verticalOffset)
web\src\components\BoatScene.tsx:8:import type { AquaMission, LayerVisibility, Vec3 } from '../types/aqua'
web\src\components\BoatScene.tsx:10:type BoatSceneProps = {
web\src\components\BoatScene.tsx:22:export function BoatScene({ mission, metricId, boatPosition, boatHeadingRad, layers, selectedSampleIndex, onSelectSample, editableWaypoints, onMoveSampleLocal }: BoatSceneProps) {
web\src\components\BoatScene.tsx:23:  const bounds = useMemo(() => missionBounds(mission), [mission])
web\src\components\BoatScene.tsx:24:  const [draggingSampleIndex, setDraggingSampleIndex] = useState<number>()
web\src\components\BoatScene.tsx:56:function SceneContent({
web\src\components\BoatScene.tsx:72:  const points = useMemo(() => buildScenePoints(mission, metricId), [mission, metricId])
web\src\components\BoatScene.tsx:73:  const linePoints = useMemo(
web\src\components\BoatScene.tsx:77:  const bounds = useMemo(() => missionBounds(mission), [mission])
web\src\components\BoatScene.tsx:83:      {layers.track && linePoints.length > 1 && <TrackLine points={linePoints} />}
web\src\components\BoatScene.tsx:104:function CameraWaterGuard({ waterY }: { waterY: number }) {
web\src\components\BoatScene.tsx:106:    const minimumCameraY = waterY + 2.2
web\src\components\BoatScene.tsx:115:function Boat({ position, headingRad }: { position: Vec3; headingRad?: number }) {
web\src\components\BoatScene.tsx:116:  const group = useRef<THREE.Group>(null)
web\src\components\BoatScene.tsx:129:function ModelBoat() {
web\src\components\BoatScene.tsx:130:  const [model, setModel] = useState<THREE.Object3D | null>(null)
web\src\components\BoatScene.tsx:131:  const [failed, setFailed] = useState(false)
web\src\components\BoatScene.tsx:135:    const loader = new GLTFLoader()
web\src\components\BoatScene.tsx:151:  const instance = useMemo(() => model?.clone(), [model])
web\src\components\BoatScene.tsx:152:  if (failed || !instance) return <FallbackBoat />
web\src\components\BoatScene.tsx:156:function FallbackBoat() {
web\src\components\BoatScene.tsx:175:function WaterPlane({ center, radius }: { center: Vec3; radius: number }) {
web\src\components\BoatScene.tsx:176:  const material = useRef<THREE.ShaderMaterial>(null)
web\src\components\BoatScene.tsx:177:  const waterSize = Math.max(radius * 14, 900)
web\src\components\BoatScene.tsx:178:  const waterMaps = useMemo(() => createWaterMaps(), [])
web\src\components\BoatScene.tsx:179:  const uniforms = useMemo(
web\src\components\BoatScene.tsx:221:const waterVertexShader = `
web\src\components\BoatScene.tsx:228:  void main() {
web\src\components\BoatScene.tsx:246:const waterFragmentShader = `
web\src\components\BoatScene.tsx:258:  void main() {
web\src\components\BoatScene.tsx:284:function createWaterMaps() {
web\src\components\BoatScene.tsx:291:function createNoiseTexture(size: number, frequency: number, contrast: number) {
web\src\components\BoatScene.tsx:292:  const canvas = document.createElement('canvas')
web\src\components\BoatScene.tsx:295:  const context = canvas.getContext('2d')
web\src\components\BoatScene.tsx:297:    const image = context.createImageData(size, size)
web\src\components\BoatScene.tsx:300:        const nx = x / size
web\src\components\BoatScene.tsx:301:        const ny = y / size
web\src\components\BoatScene.tsx:302:        const base = fbmNoise(nx, ny, frequency)
web\src\components\BoatScene.tsx:303:        const secondary = fbmNoise(nx + 17.31, ny - 9.73, frequency * 1.9)
web\src\components\BoatScene.tsx:304:        const ridge = 1 - Math.abs(secondary * 2 - 1)
web\src\components\BoatScene.tsx:305:        const value = THREE.MathUtils.clamp(0.5 + (base - 0.5) * contrast + (ridge - 0.5) * contrast * 0.28, 0, 1)
web\src\components\BoatScene.tsx:306:        const offset = (y * size + x) * 4
web\src\components\BoatScene.tsx:315:  const texture = new THREE.CanvasTexture(canvas)
web\src\components\BoatScene.tsx:323:function fbmNoise(x: number, y: number, frequency: number) {
web\src\components\BoatScene.tsx:337:function smoothValueNoise(x: number, y: number) {
web\src\components\BoatScene.tsx:338:  const x0 = Math.floor(x)
web\src\components\BoatScene.tsx:339:  const y0 = Math.floor(y)
web\src\components\BoatScene.tsx:340:  const tx = smoothStep(x - x0)
web\src\components\BoatScene.tsx:341:  const ty = smoothStep(y - y0)
web\src\components\BoatScene.tsx:342:  const a = seededNoise(x0, y0)
web\src\components\BoatScene.tsx:343:  const b = seededNoise(x0 + 1, y0)
web\src\components\BoatScene.tsx:344:  const c = seededNoise(x0, y0 + 1)
web\src\components\BoatScene.tsx:345:  const d = seededNoise(x0 + 1, y0 + 1)
web\src\components\BoatScene.tsx:349:function seededNoise(x: number, y: number) {
web\src\components\BoatScene.tsx:350:  const value = Math.sin(x * 127.1 + y * 311.7) * 43758.5453123
web\src\components\BoatScene.tsx:354:function smoothStep(value: number) {
web\src\components\BoatScene.tsx:358:function lerp(a: number, b: number, t: number) {
web\src\components\BoatScene.tsx:362:function TrackLine({ points }: { points: THREE.Vector3[] }) {
web\src\components\BoatScene.tsx:363:  const line = useMemo(() => {
web\src\components\BoatScene.tsx:364:    const geometry = new THREE.BufferGeometry().setFromPoints(points)
web\src\components\BoatScene.tsx:370:function SamplePoint({
web\src\components\BoatScene.tsx:389:  const dragPlane = useMemo(() => new THREE.Plane(new THREE.Vector3(0, 1, 0), -point.position[1]), [point.position])
web\src\components\BoatScene.tsx:390:  const dragPoint = useMemo(() => new THREE.Vector3(), [])
web\src\components\BoatScene.tsx:405:        const target = event.target as Element | null
web\src\components\BoatScene.tsx:418:        const target = event.target as Element | null
web\src\components\BoatScene.tsx:436:function SmoothHeatmap({ mission, metricId, center, radius }: { mission: AquaMission; metricId: string; center: Vec3; radius: number }) {
web\src\components\BoatScene.tsx:437:  const span = radius * 2.45
web\src\components\BoatScene.tsx:438:  const texture = useMemo(() => {
web\src\components\BoatScene.tsx:439:    const descriptor = getMetricDescriptor(metricId)
web\src\components\BoatScene.tsx:440:    const canvas = document.createElement('canvas')
web\src\components\BoatScene.tsx:441:    const size = 768
web\src\components\BoatScene.tsx:444:    const context = canvas.getContext('2d')
web\src\components\BoatScene.tsx:447:    const originX = center[0] - span / 2
web\src\components\BoatScene.tsx:448:    const originZ = center[2] - span / 2
web\src\components\BoatScene.tsx:449:    const brushRadius = Math.max(82, Math.min(150, size * 0.132))
web\src\components\BoatScene.tsx:450:    const values = mission.samples.map((sample) => metricValue(sample, metricId)).filter((value): value is number => value !== undefined)
web\src\components\BoatScene.tsx:451:    const localMin = values.length > 0 ? Math.min(...values) : descriptor.expectedRange[0]
web\src\components\BoatScene.tsx:452:    const localMax = values.length > 0 ? Math.max(...values) : descriptor.expectedRange[1]
web\src\components\BoatScene.tsx:453:    const localSpan = localMax - localMin
web\src\components\BoatScene.tsx:458:      const value = metricValue(sample, metricId)
web\src\components\BoatScene.tsx:459:      const [min, max] = descriptor.expectedRange
web\src\components\BoatScene.tsx:460:      const normalized = value === undefined || max <= min ? 0.32 : THREE.MathUtils.clamp((value - min) / (max - min), 0.12, 1)
web\src\components\BoatScene.tsx:461:      const colorPosition = value === undefined ? 0.5 : localSpan > 0.0001 ? THREE.MathUtils.clamp((value - localMin) / localSpan, 0, 1) : 0.5
web\src\components\BoatScene.tsx:462:      const x = ((sample.localPosition[0] - originX) / span) * size
web\src\components\BoatScene.tsx:463:      const y = size - ((sample.localPosition[2] - originZ) / span) * size
web\src\components\BoatScene.tsx:464:      const color = colorFromGradient(descriptor.gradient, colorPosition)
web\src\components\BoatScene.tsx:465:      const gradient = context.createRadialGradient(x, y, 0, x, y, brushRadius)
web\src\components\BoatScene.tsx:474:    const canvasTexture = new THREE.CanvasTexture(canvas)
web\src\components\BoatScene.tsx:481:  const geometry = useMemo(() => {
web\src\components\BoatScene.tsx:482:    const half = span / 2
web\src\components\BoatScene.tsx:483:    const bufferGeometry = new THREE.BufferGeometry()
web\src\components\BoatScene.tsx:526:function withAlpha(color: string, alpha: number) {
web\src\components\BoatScene.tsx:527:  const clamped = THREE.MathUtils.clamp(alpha, 0, 1)
web\src\components\BoatScene.tsx:530:    const red = Number.parseInt(color.slice(1, 3), 16)
web\src\components\BoatScene.tsx:531:    const green = Number.parseInt(color.slice(3, 5), 16)
web\src\components\BoatScene.tsx:532:    const blue = Number.parseInt(color.slice(5, 7), 16)
web\src\components\BoatScene.tsx:538:function colorFromGradient(colors: string[], t: number) {
web\src\components\BoatScene.tsx:541:  const scaled = THREE.MathUtils.clamp(t, 0, 1) * (colors.length - 1)
web\src\components\BoatScene.tsx:542:  const index = Math.min(colors.length - 2, Math.floor(scaled))
web\src\components\BoatScene.tsx:543:  const localT = scaled - index
web\src\components\BoatScene.tsx:544:  const a = parseColor(colors[index])
web\src\components\BoatScene.tsx:545:  const b = parseColor(colors[index + 1])
web\src\components\BoatScene.tsx:546:  const red = Math.round(a[0] + (b[0] - a[0]) * localT)
web\src\components\BoatScene.tsx:547:  const green = Math.round(a[1] + (b[1] - a[1]) * localT)
web\src\components\BoatScene.tsx:548:  const blue = Math.round(a[2] + (b[2] - a[2]) * localT)
web\src\components\BoatScene.tsx:552:function parseColor(color: string): [number, number, number] {
web\src\components\BoatScene.tsx:554:    const values = color
web\src\components\BoatScene.tsx:567:function ProbeMarker({ position }: { position: Vec3 }) {
web\src\App.test.tsx:9:const demoCsv = `timestamp,latitude,longitude,temperature,ph,do,depth,heading,speed,battery
web\src\App.test.tsx:81:    const { container } = render(<App />)
web\src\App.test.tsx:100:    const latitudeInput = screen.getByLabelText('Latitude')
web\src\domain\playback.ts:1:import type { AquaMission, AquaSample, Vec3 } from '../types/aqua'
web\src\domain\playback.ts:3:export type PlaybackSegment = {
web\src\domain\playback.ts:11:export function missionDurationSeconds(mission: AquaMission | undefined) {
web\src\domain\playback.ts:16:export function getPlaybackSegment(mission: AquaMission | undefined, normalizedTime: number): PlaybackSegment | undefined {
web\src\domain\playback.ts:18:  const samples = mission.samples
web\src\domain\playback.ts:19:  const start = sampleSeconds(samples[0])
web\src\domain\playback.ts:20:  const duration = missionDurationSeconds(mission)
web\src\domain\playback.ts:21:  const target = start + clamp01(normalizedTime) * duration
web\src\domain\playback.ts:22:  const index = findSegmentIndex(samples, target)
web\src\domain\playback.ts:23:  const from = samples[index]
web\src\domain\playback.ts:24:  const to = samples[index + 1]
web\src\domain\playback.ts:25:  const fromTime = sampleSeconds(from)
web\src\domain\playback.ts:26:  const toTime = sampleSeconds(to)
web\src\domain\playback.ts:27:  const lerp = toTime > fromTime ? clamp01((target - fromTime) / (toTime - fromTime)) : 0
web\src\domain\playback.ts:37:export function findSegmentIndex(samples: AquaSample[], targetSeconds: number) {
web\src\domain\playback.ts:44:export function sampleSeconds(sample: AquaSample) {
web\src\domain\playback.ts:48:function lerpVec3(a: Vec3, b: Vec3, t: number): Vec3 {
web\src\domain\playback.ts:52:function clamp01(value: number) {
web\src\hooks\useLiveBoat.ts:4:import type { AquaMission, AquaSample, DriveCommand, DriveStatus, LiveSettings, TelemetryHealth, TelemetrySnapshot } from '../types/aqua'
web\src\hooks\useLiveBoat.ts:6:type SocketState = 'idle' | 'connecting' | 'connected' | 'error'
web\src\hooks\useLiveBoat.ts:7:type BoatSocketMessage = Partial<DriveStatus> & {
web\src\hooks\useLiveBoat.ts:31:const telemetryUiIntervalMs = 300
web\src\hooks\useLiveBoat.ts:32:const telemetryAgeIntervalMs = 1000
web\src\hooks\useLiveBoat.ts:33:const telemetryHistoryLimit = 24
web\src\hooks\useLiveBoat.ts:35:const initialStatus: DriveStatus = {
web\src\hooks\useLiveBoat.ts:45:export function useLiveBoat(settings: LiveSettings, liveMode: boolean, joystick: [number, number], simulator?: { enabled: boolean; mission?: AquaMission }) {
web\src\hooks\useLiveBoat.ts:46:  const [socketState, setSocketState] = useState<SocketState>('idle')
web\src\hooks\useLiveBoat.ts:47:  const [status, setStatus] = useState<DriveStatus>(initialStatus)
web\src\hooks\useLiveBoat.ts:48:  const [packetAgeMs, setPacketAgeMs] = useState<number>()
web\src\hooks\useLiveBoat.ts:49:  const [history, setHistory] = useState<TelemetrySnapshot[]>([])
web\src\hooks\useLiveBoat.ts:50:  const [armed, setArmed] = useState(false)
web\src\hooks\useLiveBoat.ts:51:  const [estop, setEstop] = useState(false)
web\src\hooks\useLiveBoat.ts:52:  const [sensorAverages, setSensorAverages] = useState(() => calculateSensorAverages(createSensorAverageAccumulator()))
web\src\hooks\useLiveBoat.ts:53:  const [lastCommand, setLastCommand] = useState<DriveCommand>(() =>
web\src\hooks\useLiveBoat.ts:56:  const socketRef = useRef<WebSocket | null>(null)
web\src\hooks\useLiveBoat.ts:57:  const statusRef = useRef<DriveStatus>(initialStatus)
web\src\hooks\useLiveBoat.ts:58:  const seqRef = useRef(0)
web\src\hooks\useLiveBoat.ts:59:  const lastSeenRef = useRef(0)
web\src\hooks\useLiveBoat.ts:60:  const lastUiStatusAtRef = useRef(0)
web\src\hooks\useLiveBoat.ts:61:  const pendingStatusRef = useRef<{ status: DriveStatus; receivedAtMs: number } | undefined>(undefined)
web\src\hooks\useLiveBoat.ts:62:  const uiFlushTimerRef = useRef<number | undefined>(undefined)
web\src\hooks\useLiveBoat.ts:63:  const simProgressRef = useRef(0)
web\src\hooks\useLiveBoat.ts:64:  const simLastTickRef = useRef(0)
web\src\hooks\useLiveBoat.ts:65:  const sensorAverageAccumulatorRef = useRef(createSensorAverageAccumulator())
web\src\hooks\useLiveBoat.ts:67:  const recordSensorPacket = useCallback((message: BoatSocketMessage) => {
web\src\hooks\useLiveBoat.ts:68:    const next = addSensorPacket(sensorAverageAccumulatorRef.current, message)
web\src\hooks\useLiveBoat.ts:74:  const resetSensorAverages = useCallback(() => {
web\src\hooks\useLiveBoat.ts:75:    const next = createSensorAverageAccumulator(statusRef.current.sensorSeq)
web\src\hooks\useLiveBoat.ts:80:  const publishPendingStatus = useCallback(() => {
web\src\hooks\useLiveBoat.ts:81:    const pending = pendingStatusRef.current
web\src\hooks\useLiveBoat.ts:100:  const queueStatusForUi = useCallback((status: DriveStatus, receivedAtMs: number) => {
web\src\hooks\useLiveBoat.ts:103:    const elapsed = receivedAtMs - lastUiStatusAtRef.current
web\src\hooks\useLiveBoat.ts:118:  const disconnect = useCallback((reason = 'Disconnected') => {
web\src\hooks\useLiveBoat.ts:119:    const socket = socketRef.current
web\src\hooks\useLiveBoat.ts:129:    const nextStatus = { ...statusRef.current, connected: false, armed: false, leftMicros: neutralMicros, rightMicros: neutralMicros }
web\src\hooks\useLiveBoat.ts:135:  const sendJson = useCallback((payload: unknown) => {
web\src\hooks\useLiveBoat.ts:136:    const socket = socketRef.current
web\src\hooks\useLiveBoat.ts:142:  const connect = useCallback(() => {
web\src\hooks\useLiveBoat.ts:145:      const receivedAtMs = Date.now()
web\src\hooks\useLiveBoat.ts:147:      simLastTickRef.current = receivedAtMs
web\src\hooks\useLiveBoat.ts:161:    const socket = new WebSocket(`ws://${settings.host}:${settings.port}/`)
web\src\hooks\useLiveBoat.ts:172:        const message = JSON.parse(String(event.data)) as BoatSocketMessage
web\src\hooks\useLiveBoat.ts:173:        if (message.type !== 'status' && message.type !== 'sensor') return
web\src\hooks\useLiveBoat.ts:175:        const receivedAtMs = Date.now()
web\src\hooks\useLiveBoat.ts:177:        const previousStatus = pendingStatusRef.current?.status ?? statusRef.current
web\src\hooks\useLiveBoat.ts:178:        const nextStatus = message.type === 'sensor'
web\src\hooks\useLiveBoat.ts:225:  const toggleArm = useCallback(() => {
web\src\hooks\useLiveBoat.ts:228:      const nextArmed = !value
web\src\hooks\useLiveBoat.ts:229:      const command = buildDriveCommand(seqRef.current + 1, nextArmed ? joystick : [0, 0], settings, nextArmed, false)
web\src\hooks\useLiveBoat.ts:238:          x: command.joystickX,
web\src\hooks\useLiveBoat.ts:239:          y: command.joystickY,
web\src\hooks\useLiveBoat.ts:248:  const triggerEstop = useCallback(() => {
web\src\hooks\useLiveBoat.ts:249:    const nextSeq = seqRef.current + 1
web\src\hooks\useLiveBoat.ts:256:  const resetEstop = useCallback(() => {
web\src\hooks\useLiveBoat.ts:261:  const sendProbeCommand = useCallback((direction: 'raise' | 'lower' | 'stop', speed: number) => {
web\src\hooks\useLiveBoat.ts:263:    const nextSeq = seqRef.current + 1
web\src\hooks\useLiveBoat.ts:265:    const clampedSpeed = Math.max(0, Math.min(255, Math.round(speed)))
web\src\hooks\useLiveBoat.ts:288:      const timer = window.setTimeout(() => disconnect('Switched to playback'), 0)
web\src\hooks\useLiveBoat.ts:295:    const intervalMs = Math.max(20, 1000 / Math.max(1, settings.sendRateHz))
web\src\hooks\useLiveBoat.ts:296:    const timer = window.setInterval(() => {
web\src\hooks\useLiveBoat.ts:297:      const connected = socketRef.current?.readyState === WebSocket.OPEN
web\src\hooks\useLiveBoat.ts:299:      const timeoutMs = Math.max(3000, settings.timeoutSeconds * 1000)
web\src\hooks\useLiveBoat.ts:305:      const command = buildDriveCommand(seqRef.current + 1, joystick, settings, armed, estop)
web\src\hooks\useLiveBoat.ts:313:        x: command.joystickX,
web\src\hooks\useLiveBoat.ts:314:        y: command.joystickY,
web\src\hooks\useLiveBoat.ts:325:    const command = buildDriveCommand(seqRef.current + 1, [0, 0], settings, false, false)
web\src\hooks\useLiveBoat.ts:342:    const timer = window.setInterval(() => {
web\src\hooks\useLiveBoat.ts:343:      const now = Date.now()
web\src\hooks\useLiveBoat.ts:344:      const deltaSeconds = simLastTickRef.current > 0 ? Math.min(1, (now - simLastTickRef.current) / 1000) : 0
web\src\hooks\useLiveBoat.ts:345:      simLastTickRef.current = now
web\src\hooks\useLiveBoat.ts:347:        const throttle = Math.max(0, joystick[1])
web\src\hooks\useLiveBoat.ts:350:      const pose = simulatorPose(simulator.mission, simProgressRef.current)
web\src\hooks\useLiveBoat.ts:351:      const nextStatus: DriveStatus = {
web\src\hooks\useLiveBoat.ts:378:    const timer = window.setInterval(() => {
web\src\hooks\useLiveBoat.ts:379:      const age = Date.now() - lastSeenRef.current
web\src\hooks\useLiveBoat.ts:387:  const health: TelemetryHealth =
web\src\hooks\useLiveBoat.ts:418:function sensorFieldsFromMessage(message: BoatSocketMessage, previous: DriveStatus) {
web\src\hooks\useLiveBoat.ts:441:function firstNumber(...values: Array<number | undefined>) {
web\src\hooks\useLiveBoat.ts:445:function simulatorPose(mission: AquaMission | undefined, progress: number) {
web\src\hooks\useLiveBoat.ts:446:  const samples = mission?.samples
web\src\hooks\useLiveBoat.ts:457:  const scaled = Math.max(0, Math.min(0.999999, progress)) * (samples.length - 1)
web\src\hooks\useLiveBoat.ts:458:  const index = Math.min(samples.length - 2, Math.floor(scaled))
web\src\hooks\useLiveBoat.ts:462:function poseFromSample(from: AquaSample, to: AquaSample, t: number) {
web\src\hooks\useLiveBoat.ts:463:  const latitude = lerp(from.latitude, to.latitude, t)
web\src\hooks\useLiveBoat.ts:464:  const longitude = lerp(from.longitude, to.longitude, t)
web\src\hooks\useLiveBoat.ts:465:  const dx = to.localPosition[0] - from.localPosition[0]
web\src\hooks\useLiveBoat.ts:466:  const dz = to.localPosition[2] - from.localPosition[2]
web\src\hooks\useLiveBoat.ts:467:  const heading = Math.hypot(dx, dz) > 0.001 ? (Math.atan2(dx, dz) * 180) / Math.PI : (from.headingDeg ?? 0)
web\src\hooks\useLiveBoat.ts:477:function lerpOptional(a: number | undefined, b: number | undefined, t: number) {
web\src\hooks\useLiveBoat.ts:483:function lerp(a: number, b: number, t: number) {
web\src\types\aqua.ts:1:export type Vec3 = [number, number, number]
web\src\types\aqua.ts:3:export type AquaSample = {
web\src\types\aqua.ts:16:export type GeoReference = {
web\src\types\aqua.ts:22:export type AquaMission = {
web\src\types\aqua.ts:29:export type MetricDescriptor = {
web\src\types\aqua.ts:37:export type PredictionResult = {
web\src\types\aqua.ts:48:export type DriveCommand = {
web\src\types\aqua.ts:52:  joystickX: number
web\src\types\aqua.ts:53:  joystickY: number
web\src\types\aqua.ts:58:export type DriveStatus = {
web\src\types\aqua.ts:98:export type TelemetryHealth = 'offline' | 'connecting' | 'fresh' | 'stale' | 'error'
web\src\types\aqua.ts:100:export type TelemetrySnapshot = DriveStatus & {
web\src\types\aqua.ts:105:export type LiveSettings = {
web\src\types\aqua.ts:114:export type LayerVisibility = {
web\src\types\aqua.ts:120:export type TabId = 'setup' | 'run' | 'drive' | 'ai' | 'sensors' | 'planner' | 'review'
web\src\App.tsx:29:import type { CSSProperties, ReactNode, RefObject } from 'react'
web\src\App.tsx:50:  type MissionPlanWarning,
web\src\App.tsx:54:import { getPlaybackSegment, missionDurationSeconds } from './domain/playback'
web\src\App.tsx:56:import { createProjectFile, parseProjectFile, serializeProjectFile, type AquaProjectFile } from './domain/projectFiles'
web\src\App.tsx:57:import { defaultResearchModelMetadataUrl, loadResearchModelBackend, loadingResearchModelStatus, type ResearchModelBackendStatus, type ResearchModelDefinition } from './domain/researchModel'
web\src\App.tsx:58:import { analyzeResearchPhenomena, type ResearchPhenomenonAnalysis } from './domain/researchPhenomena'
web\src\App.tsx:61:import type { AquaMission, DriveStatus, LayerVisibility, TabId, TelemetryHealth } from './types/aqua'
web\src\App.tsx:63:type RunState = 'draft' | 'prepared' | 'armed' | 'running' | 'paused' | 'completed' | 'aborted'
web\src\App.tsx:65:type RunEvent = {
web\src\App.tsx:72:type OperatorAlertSeverity = 'ok' | 'notice' | 'warning' | 'critical'
web\src\App.tsx:74:type OperatorAlert = {
web\src\App.tsx:81:const defaultLayers: LayerVisibility = {
web\src\App.tsx:87:function App() {
web\src\App.tsx:88:  const [mission, setMission] = useState<AquaMission>()
web\src\App.tsx:89:  const [loadedMission, setLoadedMission] = useState<AquaMission>()
web\src\App.tsx:90:  const [missionError, setMissionError] = useState('')
web\src\App.tsx:91:  const [projectName, setProjectName] = useState('AQUAScan Mission')
web\src\App.tsx:92:  const [activeProjectId, setActiveProjectId] = useState<string>()
web\src\App.tsx:93:  const [isDirty, setIsDirty] = useState(false)
web\src\App.tsx:94:  const [autosavedAt, setAutosavedAt] = useState('')
web\src\App.tsx:95:  const [executionPreparedAt, setExecutionPreparedAt] = useState('')
web\src\App.tsx:96:  const [runState, setRunState] = useState<RunState>('draft')
web\src\App.tsx:97:  const [runEvents, setRunEvents] = useState<RunEvent[]>([])
web\src\App.tsx:98:  const [metricId, setMetricId] = useState('temperature')
web\src\App.tsx:99:  const [normalizedTime, setNormalizedTime] = useState(0)
web\src\App.tsx:100:  const [isPlaying, setIsPlaying] = useState(true)
web\src\App.tsx:101:  const [activeTab, setActiveTab] = useState<TabId>('sensors')
web\src\App.tsx:102:  const [setupStep, setSetupStep] = useState(0)
web\src\App.tsx:103:  const [liveMode, setLiveMode] = useState(true)
web\src\App.tsx:104:  const [simulatorEnabled, setSimulatorEnabled] = useLocalStorageState('aquascan.simulatorEnabled', false)
web\src\App.tsx:105:  const [interfaceMode, setInterfaceMode] = useLocalStorageState<'simple' | 'advanced'>('aquascan.interfaceMode', 'simple')
web\src\App.tsx:106:  const [joystick, setJoystick] = useState<[number, number]>([0, 0])
web\src\App.tsx:107:  const [probeSpeed, setProbeSpeed] = useState(160)
web\src\App.tsx:108:  const [selectedSampleIndex, setSelectedSampleIndex] = useState<number>()
web\src\App.tsx:109:  const [timelineCollapsed, setTimelineCollapsed] = useState(false)
web\src\App.tsx:110:  const [theme, setTheme] = useLocalStorageState<'light' | 'dark'>('aquascan.theme', 'light')
web\src\App.tsx:111:  const [layers, setLayers] = useLocalStorageState('aquascan.layers', defaultLayers)
web\src\App.tsx:112:  const [settings, setSettings] = useLocalStorageState('aquascan.liveSettings', defaultLiveSettings)
web\src\App.tsx:113:  const [savedProjects, setSavedProjects] = useLocalStorageState<AquaProjectFile[]>('aquascan.projects', [])
web\src\App.tsx:114:  const [controlPanelWidth, setControlPanelWidth] = useLocalStorageState('aquascan.controlPanelWidth', 430)
web\src\App.tsx:115:  const [infoPanelWidth, setInfoPanelWidth] = useLocalStorageState('aquascan.infoPanelWidth', 340)
web\src\App.tsx:116:  const [researchModelMetadataUrl, setResearchModelMetadataUrl] = useLocalStorageState('aquascan.researchModelMetadataUrl', defaultResearchModelMetadataUrl)
web\src\App.tsx:117:  const [researchModelRefreshKey, setResearchModelRefreshKey] = useState(0)
web\src\App.tsx:118:  const [researchModelStatus, setResearchModelStatus] = useState<ResearchModelBackendStatus>(() => loadingResearchModelStatus())
web\src\App.tsx:119:  const workspaceRef = useRef<HTMLElement>(null)
web\src\App.tsx:120:  const controlPanelRef = useRef<HTMLElement>(null)
web\src\App.tsx:121:  const infoPanelRef = useRef<HTMLElement>(null)
web\src\App.tsx:122:  const controlHandleRef = useRef<HTMLButtonElement>(null)
web\src\App.tsx:123:  const infoHandleRef = useRef<HTMLButtonElement>(null)
web\src\App.tsx:124:  const probeHoldTimerRef = useRef<number | undefined>(undefined)
web\src\App.tsx:125:  const live = useLiveBoat(settings, liveMode, joystick, { enabled: simulatorEnabled, mission })
web\src\App.tsx:127:  const segment = useMemo(() => getPlaybackSegment(mission, normalizedTime), [mission, normalizedTime])
web\src\App.tsx:128:  const liveLocalPosition = useMemo(() => {
web\src\App.tsx:132:  const boatHeadingRad = useMemo(() => {
web\src\App.tsx:135:    const dx = segment.to.localPosition[0] - segment.from.localPosition[0]
web\src\App.tsx:136:    const dz = segment.to.localPosition[2] - segment.from.localPosition[2]
web\src\App.tsx:139:  const metrics = useMemo(() => listMissionMetrics(mission), [mission])
web\src\App.tsx:140:  const descriptor = useMemo(() => getMetricDescriptor(metricId), [metricId])
web\src\App.tsx:141:  const selectedSample = selectedSampleIndex !== undefined ? mission?.samples[selectedSampleIndex] : undefined
web\src\App.tsx:142:  const routeSummary = useMemo(() => summarizeMissionRoute(mission), [mission])
web\src\App.tsx:143:  const metricSummary = useMemo(() => summarizeMetricRoute(mission, metricId), [mission, metricId])
web\src\App.tsx:144:  const planWarnings = useMemo(() => validateMissionPlan(mission), [mission])
web\src\App.tsx:145:  const uploadPlan = useMemo(() => (mission ? buildMissionUploadPlan(mission, live.status.lastSeq + 1) : undefined), [live.status.lastSeq, mission])
web\src\App.tsx:146:  const preflightChecks = useMemo(
web\src\App.tsx:159:  const isPreflightReady = preflightReady(preflightChecks)
web\src\App.tsx:160:  const currentValue = metricValue(segment?.sample, metricId)
web\src\App.tsx:161:  const selectedValue = metricValue(selectedSample, metricId)
web\src\App.tsx:162:  const prediction = useMemo(() => predictWaterQuality(mission, segment?.sample), [mission, segment?.sample])
web\src\App.tsx:163:  const researchAnalyses = useMemo(() => analyzeResearchPhenomena(mission), [mission])
web\src\App.tsx:164:  const planHasBlockingErrors = planWarnings.some((warning) => warning.severity === 'error')
web\src\App.tsx:165:  const setupSteps = useMemo(
web\src\App.tsx:175:  const activeSetupStep = setupSteps[Math.min(setupStep, setupSteps.length - 1)]
web\src\App.tsx:176:  const modelFeatureReports = useMemo(() => researchModelStatus.modelDefinitions.map((definition) => buildModelFeatureReport(definition, mission)), [mission, researchModelStatus.modelDefinitions])
web\src\App.tsx:177:  const reviewProgressPercent = mission ? Math.round(normalizedTime * 100) : 0
web\src\App.tsx:178:  const researchCandidateCount = researchAnalyses.filter((analysis) => analysis.readinessPercent >= 50).length
web\src\App.tsx:179:  const durationSeconds = missionDurationSeconds(mission)
web\src\App.tsx:180:  const runProgress = useMemo(() => summarizeRunProgress(mission, normalizedTime), [mission, normalizedTime])
web\src\App.tsx:181:  const telemetrySource = liveMode && liveLocalPosition ? 'Live telemetry' : liveMode ? 'Live control' : 'Playback'
web\src\App.tsx:182:  const boatPosition = liveMode && liveLocalPosition ? liveLocalPosition : (segment?.position ?? [0, 0, 0])
web\src\App.tsx:183:  const packetAgeLabel = live.packetAgeMs === undefined ? '--' : live.packetAgeMs < 1000 ? `${Math.round(live.packetAgeMs)} ms` : `${(live.packetAgeMs / 1000).toFixed(1)} s`
web\src\App.tsx:184:  const healthLabel = live.health === 'fresh' ? 'Telemetry fresh' : live.health === 'stale' ? 'Telemetry stale' : live.health === 'connecting' ? 'Connecting telemetry' : live.health === 'error' ? 'Telemetry error' : 'Telemetry offline'
web\src\App.tsx:185:  const healthTone = live.health === 'fresh' ? 'good' : live.health === 'stale' || live.health === 'connecting' ? 'warn' : live.health === 'error' ? 'bad' : 'neutral'
web\src\App.tsx:186:  const operatorAlerts = useMemo(
web\src\App.tsx:205:  const activeOperatorAlerts = operatorAlerts.filter((alert) => alert.severity !== 'ok')
web\src\App.tsx:206:  const primaryOperatorAlert = operatorAlerts[0]
web\src\App.tsx:207:  const alertTone = primaryOperatorAlert.severity === 'critical' ? 'bad' : primaryOperatorAlert.severity === 'warning' ? 'warn' : primaryOperatorAlert.severity === 'ok' ? 'good' : 'neutral'
web\src\App.tsx:208:  const chartData = useMemo(
web\src\App.tsx:217:  const workspaceStyle = {
web\src\App.tsx:222:  const getPanelElement = useCallback((panel: 'control' | 'info') => (panel === 'control' ? controlPanelRef.current : infoPanelRef.current), [])
web\src\App.tsx:223:  const getHandleElement = useCallback((panel: 'control' | 'info') => (panel === 'control' ? controlHandleRef.current : infoHandleRef.current), [])
web\src\App.tsx:225:  const updatePanelHandle = useCallback(
web\src\App.tsx:227:      const panelElement = getPanelElement(panel)
web\src\App.tsx:228:      const handleElement = getHandleElement(panel)
web\src\App.tsx:231:      const { scrollableDistance, thumbHeight, thumbOffset } = getPanelHandleMetrics(panelElement, handleElement)
web\src\App.tsx:240:  const updateAllPanelHandles = useCallback(() => {
web\src\App.tsx:245:  const scrollPanelFromHandle = useCallback(
web\src\App.tsx:247:      const panelElement = getPanelElement(panel)
web\src\App.tsx:255:  const startPanelInteraction = (panel: 'control' | 'info', event: React.PointerEvent<HTMLButtonElement>) => {
web\src\App.tsx:257:    const bounds = workspaceRef.current?.getBoundingClientRect()
web\src\App.tsx:258:    const panelElement = getPanelElement(panel)
web\src\App.tsx:260:    const handleBounds = event.currentTarget.getBoundingClientRect()
web\src\App.tsx:261:    const { scrollableDistance: startScrollableDistance, thumbHeight, thumbOffset } = getPanelHandleMetrics(panelElement, event.currentTarget)
web\src\App.tsx:262:    const trackHeight = Math.max(0, event.currentTarget.clientHeight - 16)
web\src\App.tsx:263:    const maxThumbOffset = Math.max(0, trackHeight - thumbHeight)
web\src\App.tsx:264:    const pointerTrackY = event.clientY - handleBounds.top - 8
web\src\App.tsx:265:    const isPointerOnThumb = pointerTrackY >= thumbOffset && pointerTrackY <= thumbOffset + thumbHeight
web\src\App.tsx:266:    const thumbGrabOffset = isPointerOnThumb ? pointerTrackY - thumbOffset : thumbHeight / 2
web\src\App.tsx:267:    const startX = event.clientX
web\src\App.tsx:268:    const startY = event.clientY
web\src\App.tsx:271:    const handleMove = (moveEvent: PointerEvent) => {
web\src\App.tsx:272:      const deltaX = moveEvent.clientX - startX
web\src\App.tsx:273:      const deltaY = moveEvent.clientY - startY
web\src\App.tsx:281:        const nextPointerTrackY = moveEvent.clientY - handleBounds.top - 8
web\src\App.tsx:282:        const nextThumbOffset = clamp(nextPointerTrackY - thumbGrabOffset, 0, maxThumbOffset)
web\src\App.tsx:283:        const scrollRatio = maxThumbOffset > 0 ? nextThumbOffset / maxThumbOffset : 0
web\src\App.tsx:291:        const maxWidth = Math.max(300, Math.min(620, bounds.width - infoPanelWidth - 460))
web\src\App.tsx:295:      const maxWidth = Math.max(260, Math.min(540, bounds.width - controlPanelWidth - 460))
web\src\App.tsx:298:    const stopMove = () => {
web\src\App.tsx:307:  const selectSample = (index: number) => {
web\src\App.tsx:309:    const clampedIndex = Math.max(0, Math.min(index, mission.samples.length - 1))
web\src\App.tsx:315:  const selectNearestPlaybackSample = () => {
web\src\App.tsx:316:    const nearest = nearestSampleIndex(mission, normalizedTime)
web\src\App.tsx:320:  const sendProbeMotion = (direction: 'raise' | 'lower' | 'stop') => {
web\src\App.tsx:324:  const stopProbeMotion = () => {
web\src\App.tsx:332:  const startProbeMotion = (direction: 'raise' | 'lower') => {
web\src\App.tsx:342:  const exportMissionRoute = () => {
web\src\App.tsx:344:    const payload = exportMissionRoutePayload(mission, metricId)
web\src\App.tsx:345:    const blob = new Blob([JSON.stringify(payload, null, 2)], { type: 'application/json' })
web\src\App.tsx:346:    const url = URL.createObjectURL(blob)
web\src\App.tsx:347:    const anchor = document.createElement('a')
web\src\App.tsx:354:  const appendRunEvent = (state: RunState, message: string) => {
web\src\App.tsx:355:    const timestampUtc = new Date().toISOString()
web\src\App.tsx:367:  const resetRun = (message = 'Run reset') => {
web\src\App.tsx:373:  const markRunPrepared = () => {
web\src\App.tsx:380:  const armRunMode = () => {
web\src\App.tsx:386:  const startRunMode = () => {
web\src\App.tsx:393:  const pauseRunMode = () => {
web\src\App.tsx:399:  const abortRunMode = () => {
web\src\App.tsx:406:  const completeRunMode = () => {
web\src\App.tsx:414:  const exportRunSummary = () => {
web\src\App.tsx:423:  const applyProject = (project: AquaProjectFile, dirty = false) => {
web\src\App.tsx:424:    const cloned = cloneMissionForPlanning(project.mission)
web\src\App.tsx:440:  const markMissionChanged = (nextMission: AquaMission) => {
web\src\App.tsx:447:  const saveProject = () => {
web\src\App.tsx:449:    const project = createProjectFile({
web\src\App.tsx:463:  const loadProject = (projectId: string) => {
web\src\App.tsx:464:    const project = savedProjects.find((saved) => saved.id === projectId)
web\src\App.tsx:468:  const deleteProject = (projectId: string) => {
web\src\App.tsx:476:  const exportProjectBundle = () => {
web\src\App.tsx:478:    const project = createProjectFile({
web\src\App.tsx:489:  const loadProjectFile = async (file: File | undefined) => {
web\src\App.tsx:492:      const project = parseProjectFile(await file.text())
web\src\App.tsx:501:  const resetMissionPlan = () => {
web\src\App.tsx:503:    const cloned = cloneMissionForPlanning(loadedMission)
web\src\App.tsx:504:    markMissionChanged(cloned)
web\src\App.tsx:510:  const addWaypoint = () => {
web\src\App.tsx:512:    const index = selectedSampleIndex ?? Math.max(0, mission.samples.length - 1)
web\src\App.tsx:513:    const nextMission = insertWaypointAfter(mission, index)
web\src\App.tsx:514:    markMissionChanged(nextMission)
web\src\App.tsx:519:  const removeWaypoint = () => {
web\src\App.tsx:521:    const nextMission = deleteWaypoint(mission, selectedSampleIndex)
web\src\App.tsx:522:    markMissionChanged(nextMission)
web\src\App.tsx:527:  const reorderWaypoint = (direction: -1 | 1) => {
web\src\App.tsx:529:    const nextMission = moveWaypoint(mission, selectedSampleIndex, direction)
web\src\App.tsx:530:    const nextIndex = Math.max(0, Math.min(selectedSampleIndex + direction, nextMission.samples.length - 1))
web\src\App.tsx:531:    markMissionChanged(nextMission)
web\src\App.tsx:536:  const editSelectedWaypoint = (patch: Parameters<typeof updateWaypoint>[2]) => {
web\src\App.tsx:538:    markMissionChanged(updateWaypoint(mission, selectedSampleIndex, patch))
web\src\App.tsx:542:  const moveWaypointLocal = (index: number, localX: number, localZ: number) => {
web\src\App.tsx:544:    const sample = mission.samples[index]
web\src\App.tsx:546:    const nextGeo = localToGeo(mission.geoReference, localX, localZ, sample.altitude)
web\src\App.tsx:547:    markMissionChanged(updateWaypoint(mission, index, { latitude: nextGeo.latitude, longitude: nextGeo.longitude, altitude: nextGeo.altitude }))
web\src\App.tsx:552:  const exportMissionPlan = (format: 'json' | 'csv') => {
web\src\App.tsx:554:    const contents = format === 'json' ? exportMissionPlanJson(mission) : exportMissionPlanCsv(mission)
web\src\App.tsx:555:    const blob = new Blob([contents], { type: format === 'json' ? 'application/json' : 'text/csv' })
web\src\App.tsx:559:  const prepareExecution = () => {
web\src\App.tsx:560:    markRunPrepared()
web\src\App.tsx:563:  const loadDemoMission = async () => {
web\src\App.tsx:565:      const loaded = await loadMissionFromUrl('/missions/demo-mission.csv')
web\src\App.tsx:566:      const cloned = cloneMissionForPlanning(loaded)
web\src\App.tsx:584:  const reloadResearchModels = () => {
web\src\App.tsx:589:  const buildRunSummaryPayload = () => ({
web\src\App.tsx:605:  const exportReviewReport = () => {
web\src\App.tsx:648:        const cloned = cloneMissionForPlanning(loaded)
web\src\App.tsx:662:    void loadResearchModelBackend(researchModelMetadataUrl).then((backend) => {
web\src\App.tsx:672:    const timer = window.setInterval(() => {
web\src\App.tsx:674:        const next = value + 1 / durationSeconds / 12
web\src\App.tsx:683:    const timer = window.setInterval(() => {
web\src\App.tsx:691:    const timer = window.setTimeout(() => {
web\src\App.tsx:692:      const timestampUtc = new Date().toISOString()
web\src\App.tsx:710:      const timer = window.setTimeout(updateAllPanelHandles, 0)
web\src\App.tsx:713:    const resizeObserver = new ResizeObserver(updateAllPanelHandles)
web\src\App.tsx:714:    const controlPanel = controlPanelRef.current
web\src\App.tsx:715:    const infoPanel = infoPanelRef.current
web\src\App.tsx:718:    const timer = window.setTimeout(updateAllPanelHandles, 0)
web\src\App.tsx:727:    const project = createProjectFile({
web\src\App.tsx:736:    const timer = window.setTimeout(() => setAutosavedAt(project.savedAtUtc), 0)
web\src\App.tsx:740:  const loadFile = async (file: File | undefined) => {
web\src\App.tsx:743:      const loaded = await loadMissionFromFile(file)
web\src\App.tsx:744:      const cloned = cloneMissionForPlanning(loaded)
web\src\App.tsx:760:  const connectionLabel =
web\src\App.tsx:921:                      <button className="primary-button" onClick={() => void loadDemoMission()}>
web\src\App.tsx:928:                        <input type="file" accept=".csv,.json" onChange={(event) => void loadFile(event.target.files?.[0])} />
web\src\App.tsx:1082:                <button className="secondary-button" disabled={!isPreflightReady || runState === 'running'} onClick={markRunPrepared}>
web\src\App.tsx:1283:                  <input type="file" accept=".csv,.json" onChange={(event) => void loadFile(event.target.files?.[0])} />
web\src\App.tsx:1385:                    <button className="icon-button" title="Select nearest playback sample" disabled={!mission} onClick={selectNearestPlaybackSample}>
web\src\App.tsx:1460:                    <input type="file" accept=".json,.aquascan.json" onChange={(event) => void loadProjectFile(event.target.files?.[0])} />
web\src\App.tsx:1549:                  const next = mission.samples[index + 1]
web\src\App.tsx:1744:function slugify(value: string) {
web\src\App.tsx:1745:  const slug = value
web\src\App.tsx:1753:function optionalNumber(value: string) {
web\src\App.tsx:1755:  const parsed = Number(value)
web\src\App.tsx:1759:function downloadText(filename: string, contents: string, type: string) {
web\src\App.tsx:1760:  downloadBlob(filename, new Blob([contents], { type }))
web\src\App.tsx:1763:function downloadBlob(filename: string, blob: Blob) {
web\src\App.tsx:1764:  const url = URL.createObjectURL(blob)
web\src\App.tsx:1765:  const anchor = document.createElement('a')
web\src\App.tsx:1772:function summarizeRunProgress(mission: AquaMission | undefined, normalizedTime: number) {
web\src\App.tsx:1781:  const nearestIndex = nearestSampleIndex(mission, normalizedTime) ?? 0
web\src\App.tsx:1782:  const currentIndex = Math.min(nearestIndex, mission.samples.length - 1)
web\src\App.tsx:1783:  const remainingFromIndex = mission.samples.slice(currentIndex + 1).reduce((distance, sample, index) => {
web\src\App.tsx:1784:    const previous = mission.samples[currentIndex + index]
web\src\App.tsx:1787:  const totalDuration = missionDurationSeconds(mission)
web\src\App.tsx:1796:function waypointDistance(a: { localPosition: [number, number, number] }, b: { localPosition: [number, number, number] }) {
web\src\App.tsx:1797:  const dx = b.localPosition[0] - a.localPosition[0]
web\src\App.tsx:1798:  const dz = b.localPosition[2] - a.localPosition[2]
web\src\App.tsx:1802:function buildModelFeatureReport(definition: ResearchModelDefinition, mission: AquaMission | undefined): ModelFeatureReport {
web\src\App.tsx:1803:  const availableFeatures = definition.featureOrder.filter((feature) => isModelFeatureAvailable(feature, mission))
web\src\App.tsx:1804:  const missingFeatures = definition.featureOrder.filter((feature) => !availableFeatures.includes(feature))
web\src\App.tsx:1813:function isModelFeatureAvailable(feature: string, mission: AquaMission | undefined) {
web\src\App.tsx:1819:  const metricId = modelFeatureMetricId(feature)
web\src\App.tsx:1823:function modelFeatureMetricId(feature: string) {
web\src\App.tsx:1824:  const map: Record<string, string> = {
web\src\App.tsx:1838:function friendlyFeatureName(feature: string) {
web\src\App.tsx:1846:function clamp(value: number, min: number, max: number) {
web\src\App.tsx:1850:function getPanelHandleMetrics(panelElement: HTMLElement, handleElement: HTMLElement) {
web\src\App.tsx:1851:  const scrollableDistance = Math.max(0, panelElement.scrollHeight - panelElement.clientHeight)
web\src\App.tsx:1852:  const trackHeight = Math.max(0, handleElement.clientHeight - 16)
web\src\App.tsx:1853:  const thumbHeight = scrollableDistance > 1 && panelElement.scrollHeight > 0 ? clamp((panelElement.clientHeight / panelElement.scrollHeight) * trackHeight, 44, 118) : trackHeight
web\src\App.tsx:1854:  const thumbOffset = scrollableDistance > 1 ? (panelElement.scrollTop / scrollableDistance) * Math.max(0, trackHeight - thumbHeight) : 0
web\src\App.tsx:1858:function buildOperatorAlerts({
web\src\App.tsx:1887:  const alerts: OperatorAlert[] = []
web\src\App.tsx:1888:  const planErrors = planWarnings.filter((warning) => warning.severity === 'error')
web\src\App.tsx:1889:  const planWarns = planWarnings.filter((warning) => warning.severity === 'warn')
web\src\App.tsx:1890:  const joystickActive = Math.hypot(joystick[0], joystick[1]) > 0.05
web\src\App.tsx:1891:  const liveExecution = liveMode || runState === 'running' || runState === 'armed' || runState === 'paused'
web\src\App.tsx:2004:      detail: `Battery is ${status.batteryPercent.toFixed(0)}%. Avoid starting long routes.`,
web\src\App.tsx:2033:  if (joystickActive && (!liveMode || socketState !== 'connected' || !armed)) {
web\src\App.tsx:2074:function alertSeverityRank(severity: OperatorAlertSeverity) {
web\src\App.tsx:2081:function formatAge(ageMs: number) {
web\src\App.tsx:2085:function formatLiveSensorValue(value: number | undefined, decimals: number, unit = '') {
web\src\App.tsx:2090:function formatAlertStatus(activeAlerts: OperatorAlert[], primaryAlert: OperatorAlert) {
web\src\App.tsx:2092:  const criticalCount = activeAlerts.filter((alert) => alert.severity === 'critical').length
web\src\App.tsx:2097:function OperatorAlertBanner({ alert }: { alert: OperatorAlert }) {
web\src\App.tsx:2109:function OperatorAlertPanel({ alerts }: { alerts: OperatorAlert[] }) {
web\src\App.tsx:2110:  const activeAlerts = alerts.filter((alert) => alert.severity !== 'ok')
web\src\App.tsx:2111:  const criticalCount = activeAlerts.filter((alert) => alert.severity === 'critical').length
web\src\App.tsx:2140:function StatusPill({ icon, label, tone }: { icon: ReactNode; label: string; tone: 'neutral' | 'good' | 'warn' | 'bad' }) {
web\src\App.tsx:2149:function ResizeHandle({
web\src\App.tsx:2179:function TabButton({ id, label, icon, active, onClick }: { id: TabId; label: string; icon: ReactNode; active: boolean; onClick: (id: TabId) => void }) {
web\src\App.tsx:2188:function Field({
web\src\App.tsx:2192:  type = 'text',
web\src\App.tsx:2209:function LayerToggle({ label, checked, onChange }: { label: string; checked: boolean; onChange: (checked: boolean) => void }) {
web\src\App.tsx:2218:function Readout({ label, value }: { label: string; value: string }) {
web\src\App.tsx:2227:function ResearchModelStatusCard({ status }: { status: ResearchModelBackendStatus }) {
web\src\App.tsx:2228:  const tone = status.state === 'ready' ? 'good' : status.state === 'loading' ? 'warn' : status.state === 'error' ? 'bad' : 'neutral'
web\src\App.tsx:2256:type ModelFeatureReport = {
web\src\App.tsx:2263:function ModelIntegrationControls({
web\src\App.tsx:2326:function ResearchPhenomenonCard({ analysis }: { analysis: ResearchPhenomenonAnalysis }) {
web\src\App.tsx:2357:function ResearchList({ title, items }: { title: string; items: string[] }) {
web\src\App.tsx:2368:function TelemetryHistory({ history }: { history: Array<{ receivedAtMs: number; packetAgeMs: number; lastSeq: number; leftMicros: number; rightMicros: number; rssi?: number }> }) {
web\src\App.tsx:2369:  const recent = history.slice(0, 5)
web\src\domain\researchPhenomena.ts:1:import type { AquaMission, AquaSample } from '../types/aqua'
web\src\domain\researchPhenomena.ts:4:export type ResearchPhenomenonId = 'nighttime_oxygen_trap' | 'stormwater_fingerprint_atlas'
web\src\domain\researchPhenomena.ts:6:export type ResearchSignal = {
web\src\domain\researchPhenomena.ts:12:export type ResearchPhenomenonAnalysis = {
web\src\domain\researchPhenomena.ts:25:export function analyzeResearchPhenomena(mission: AquaMission | undefined): ResearchPhenomenonAnalysis[] {
web\src\domain\researchPhenomena.ts:29:function analyzeNighttimeOxygenTrap(mission: AquaMission | undefined): ResearchPhenomenonAnalysis {
web\src\domain\researchPhenomena.ts:30:  const samples = mission?.samples ?? []
web\src\domain\researchPhenomena.ts:31:  const missingFields = missingMetricFields(mission, ['do', 'depth'], ['conductivity', 'tds', 'turbidity', 'light', 'precipitation'])
web\src\domain\researchPhenomena.ts:32:  const oxygenValues = samples.map((sample) => metricValue(sample, 'do')).filter(isNumber)
web\src\domain\researchPhenomena.ts:33:  const lowOxygenCount = oxygenValues.filter((value) => value < 5).length
web\src\domain\researchPhenomena.ts:34:  const nightCount = samples.filter(isNightSample).length
web\src\domain\researchPhenomena.ts:35:  const depthCount = samples.filter((sample) => (sample.depthMeters ?? metricValue(sample, 'depth') ?? 0) > 0).length
web\src\domain\researchPhenomena.ts:36:  const conductivityAnomalyCount = anomalyCount(samples, 'conductivity', 1.25) + anomalyCount(samples, 'tds', 1.25)
web\src\domain\researchPhenomena.ts:37:  const readinessPercent = readiness(mission, ['do', 'depth'], ['conductivity', 'tds', 'turbidity', 'light', 'precipitation'])
web\src\domain\researchPhenomena.ts:38:  const status =
web\src\domain\researchPhenomena.ts:72:function analyzeStormwaterFingerprints(mission: AquaMission | undefined): ResearchPhenomenonAnalysis {
web\src\domain\researchPhenomena.ts:73:  const samples = mission?.samples ?? []
web\src\domain\researchPhenomena.ts:74:  const missingFields = missingMetricFields(mission, ['conductivity', 'turbidity'], ['uv', 'light', 'temperature', 'do', 'tds', 'salinity'])
web\src\domain\researchPhenomena.ts:75:  const readinessPercent = readiness(mission, ['conductivity', 'turbidity'], ['uv', 'light', 'temperature', 'do', 'tds', 'salinity'])
web\src\domain\researchPhenomena.ts:76:  const phenotypes = classifyStormwaterPhenotypes(samples)
web\src\domain\researchPhenomena.ts:77:  const dominant = phenotypes.sort((a, b) => b.count - a.count)[0]
web\src\domain\researchPhenomena.ts:78:  const status =
web\src\domain\researchPhenomena.ts:113:function classifyStormwaterPhenotypes(samples: AquaSample[]) {
web\src\domain\researchPhenomena.ts:114:  const conductivityValues = samples.map((sample) => readAny(sample, ['conductivity', 'tds', 'salinity'])).filter(isNumber)
web\src\domain\researchPhenomena.ts:115:  const turbidityValues = samples.map((sample) => metricValue(sample, 'turbidity')).filter(isNumber)
web\src\domain\researchPhenomena.ts:116:  const tempValues = samples.map((sample) => metricValue(sample, 'temperature')).filter(isNumber)
web\src\domain\researchPhenomena.ts:117:  const conductivityHigh = percentile(conductivityValues, 0.75)
web\src\domain\researchPhenomena.ts:118:  const turbidityHigh = percentile(turbidityValues, 0.75)
web\src\domain\researchPhenomena.ts:119:  const tempHigh = percentile(tempValues, 0.75)
web\src\domain\researchPhenomena.ts:120:  const tempLow = percentile(tempValues, 0.25)
web\src\domain\researchPhenomena.ts:122:  const counts = new Map<string, number>([
web\src\domain\researchPhenomena.ts:131:    const conductivity = readAny(sample, ['conductivity', 'tds', 'salinity'])
web\src\domain\researchPhenomena.ts:132:    const turbidity = metricValue(sample, 'turbidity')
web\src\domain\researchPhenomena.ts:133:    const temp = metricValue(sample, 'temperature')
web\src\domain\researchPhenomena.ts:134:    const oxygen = metricValue(sample, 'do')
web\src\domain\researchPhenomena.ts:145:function missingMetricFields(mission: AquaMission | undefined, requiredAny: string[], useful: string[]) {
web\src\domain\researchPhenomena.ts:146:  const present = new Set<string>()
web\src\domain\researchPhenomena.ts:151:  const missingRequired = requiredAny.filter((field) => !present.has(field))
web\src\domain\researchPhenomena.ts:152:  const missingUseful = useful.filter((field) => !present.has(field))
web\src\domain\researchPhenomena.ts:156:function readiness(mission: AquaMission | undefined, required: string[], optional: string[]) {
web\src\domain\researchPhenomena.ts:158:  const present = new Set<string>()
web\src\domain\researchPhenomena.ts:163:  const requiredScore = required.filter((field) => present.has(field)).length / required.length
web\src\domain\researchPhenomena.ts:164:  const optionalScore = optional.length > 0 ? optional.filter((field) => present.has(field)).length / optional.length : 1
web\src\domain\researchPhenomena.ts:168:function isNightSample(sample: AquaSample) {
web\src\domain\researchPhenomena.ts:169:  const light = readAny(sample, ['light', 'solar_radiation'])
web\src\domain\researchPhenomena.ts:171:  const hour = new Date(sample.timestamp).getHours()
web\src\domain\researchPhenomena.ts:175:function anomalyCount(samples: AquaSample[], metricId: string, ratio: number) {
web\src\domain\researchPhenomena.ts:176:  const values = samples.map((sample) => metricValue(sample, metricId)).filter(isNumber)
web\src\domain\researchPhenomena.ts:177:  const med = median(values)
web\src\domain\researchPhenomena.ts:182:function signal(label: string, value: string, tone: ResearchSignal['tone']): ResearchSignal {
web\src\domain\researchPhenomena.ts:186:function countPhenotype(phenotypes: Array<{ label: string; count: number }>, label: string) {
web\src\domain\researchPhenomena.ts:190:function phenotypeTone(phenotypes: Array<{ label: string; count: number }>, label: string): ResearchSignal['tone'] {
web\src\domain\researchPhenomena.ts:194:function increment(counts: Map<string, number>, key: string) {
web\src\domain\researchPhenomena.ts:198:function readAny(sample: AquaSample, ids: string[]) {
web\src\domain\researchPhenomena.ts:199:  for (const id of ids) {
web\src\domain\researchPhenomena.ts:200:    const value = metricValue(sample, id)
web\src\domain\researchPhenomena.ts:206:function percentile(values: number[], p: number) {
web\src\domain\researchPhenomena.ts:208:  const sorted = [...values].sort((a, b) => a - b)
web\src\domain\researchPhenomena.ts:212:function median(values: number[]) {
web\src\domain\researchPhenomena.ts:216:function isNumber(value: number | undefined): value is number {
web\src\components\Joystick.tsx:3:type JoystickProps = {
web\src\components\Joystick.tsx:9:export function Joystick({ value, disabled, onChange }: JoystickProps) {
web\src\components\Joystick.tsx:10:  const ref = useRef<HTMLDivElement | null>(null)
web\src\components\Joystick.tsx:11:  const activePointerIdRef = useRef<number | undefined>(undefined)
web\src\components\Joystick.tsx:13:  const updatePointer = useCallback(
web\src\components\Joystick.tsx:15:      const rect = ref.current?.getBoundingClientRect()
web\src\components\Joystick.tsx:17:      const x = ((clientX - rect.left) / rect.width) * 2 - 1
web\src\components\Joystick.tsx:18:      const y = -(((clientY - rect.top) / rect.height) * 2 - 1)
web\src\components\Joystick.tsx:19:      const magnitude = Math.hypot(x, y)
web\src\domain\geo.ts:1:import type { GeoReference, Vec3 } from '../types/aqua'
web\src\domain\geo.ts:3:const earthRadius = 6378137
web\src\domain\geo.ts:5:export function degreesToRad(degrees: number) {
web\src\domain\geo.ts:9:export function geoToLocal(
web\src\domain\geo.ts:17:  const latRad = degreesToRad(latitude)
web\src\domain\geo.ts:18:  const lonRad = degreesToRad(longitude)
web\src\domain\geo.ts:19:  const originLatRad = degreesToRad(originLatitude)
web\src\domain\geo.ts:20:  const originLonRad = degreesToRad(originLongitude)
web\src\domain\geo.ts:21:  const x = earthRadius * (lonRad - originLonRad) * Math.cos(originLatRad)
web\src\domain\geo.ts:22:  const z = earthRadius * (latRad - originLatRad)
web\src\domain\geo.ts:23:  const y = altitude - originAltitude
web\src\domain\geo.ts:27:export function offsetToLocal(reference: GeoReference, latitude: number, longitude: number, altitude?: number) {
web\src\domain\geo.ts:38:export function localToGeo(reference: GeoReference, x: number, z: number, altitude?: number) {
web\src\domain\geo.ts:39:  const originLatRad = degreesToRad(reference.originLatitude)
web\src\domain\geo.ts:40:  const latitude = reference.originLatitude + (z / earthRadius) * (180 / Math.PI)
web\src\domain\geo.ts:41:  const longitude = reference.originLongitude + (x / (earthRadius * Math.cos(originLatRad))) * (180 / Math.PI)
web\src\domain\preflight.ts:1:import type { AquaMission, DriveStatus, TelemetryHealth } from '../types/aqua'
web\src\domain\preflight.ts:2:import type { MissionPlanWarning } from './missionPlanner'
web\src\domain\preflight.ts:4:export type PreflightCheck = {
web\src\domain\preflight.ts:11:export function buildPreflightChecks({
web\src\domain\preflight.ts:28:  const planErrors = planWarnings.filter((warning) => warning.severity === 'error')
web\src\domain\preflight.ts:29:  const planWarns = planWarnings.filter((warning) => warning.severity === 'warn')
web\src\domain\preflight.ts:70:export function preflightReady(checks: PreflightCheck[]) {
web\src\domain\ai.ts:2:import type { AquaMission, AquaSample, PredictionResult } from '../types/aqua'
web\src\domain\ai.ts:4:const fallbackBackend = 'Heuristic fallback'
web\src\domain\ai.ts:6:export function predictWaterQuality(mission: AquaMission | undefined, current: AquaSample | undefined): PredictionResult {
web\src\domain\ai.ts:9:  const temperature = readMetric(current, 'temperature', 18)
web\src\domain\ai.ts:10:  const oxygen = readMetric(current, 'do', 8)
web\src\domain\ai.ts:11:  const ph = readMetric(current, 'ph', 7.4)
web\src\domain\ai.ts:12:  const tds = readMetric(current, 'tds', 320)
web\src\domain\ai.ts:13:  const turbidity = readMetric(current, 'turbidity', 3)
web\src\domain\ai.ts:14:  const light = readMetric(current, 'light', 0)
web\src\domain\ai.ts:15:  const depth = current.depthMeters ?? readMetric(current, 'depth', 1)
web\src\domain\ai.ts:16:  const wind = readMetric(current, 'wind_speed', 2)
web\src\domain\ai.ts:17:  const precipitation = readMetric(current, 'precipitation', 0)
web\src\domain\ai.ts:18:  const solar = readMetric(current, 'solar_radiation', light)
web\src\domain\ai.ts:19:  const doDelta = estimateDelta(mission.samples, current, 'do')
web\src\domain\ai.ts:20:  const tempDelta = estimateDelta(mission.samples, current, 'temperature')
web\src\domain\ai.ts:21:  const stratification = Math.max(0, temperature - (temperature - 0.22 * Math.max(0, depth - 0.5)))
web\src\domain\ai.ts:23:  const thermalPressure = Math.max(0, temperature - 20) * 0.045
web\src\domain\ai.ts:24:  const depthPressure = Math.max(0, depth - 2.5) * 0.05
web\src\domain\ai.ts:25:  const stormPressure = Math.max(0, precipitation - 0.25) * 0.04
web\src\domain\ai.ts:26:  const trendPressure = Math.max(0, -doDelta) * 0.35
web\src\domain\ai.ts:27:  const mixingRelief = clamp01(wind / 8) * 0.12
web\src\domain\ai.ts:29:  const oxygen30 = oxygen - thermalPressure - depthPressure - stormPressure - trendPressure + mixingRelief
web\src\domain\ai.ts:30:  const oxygen60 = oxygen30 - thermalPressure * 0.8 - depthPressure * 0.6 - stormPressure * 0.8
web\src\domain\ai.ts:31:  const oxygen120 = oxygen60 - thermalPressure * 0.7 - depthPressure * 0.7 - Math.max(0, stratification) * 0.05
web\src\domain\ai.ts:54:    backendName: fallbackBackend,
web\src\domain\ai.ts:59:function unavailable(reason: string): PredictionResult {
web\src\domain\ai.ts:67:    backendName: fallbackBackend,
web\src\domain\ai.ts:72:function estimateDelta(samples: AquaSample[], current: AquaSample, metricId: string) {
web\src\domain\ai.ts:73:  const currentValue = current.metrics[metricId]
web\src\domain\ai.ts:75:  const currentSeconds = sampleSeconds(current)
web\src\domain\ai.ts:77:    const sample = samples[i]
web\src\domain\ai.ts:79:    const previousValue = sample.metrics[metricId]
web\src\domain\ai.ts:85:function readMetric(sample: AquaSample, metricId: string, fallback: number) {
web\src\domain\ai.ts:89:function inverseLerp(a: number, b: number, value: number) {
web\src\domain\ai.ts:94:function clamp01(value: number) {
web\src\hooks\useLocalStorageState.ts:3:export function useLocalStorageState<T>(key: string, fallback: T) {
web\src\hooks\useLocalStorageState.ts:4:  const [value, setValue] = useState<T>(() => {
web\src\hooks\useLocalStorageState.ts:6:      const raw = localStorage.getItem(key)
web\src\domain\spool.ts:1:export type SpoolGeometry = {
web\src\domain\spool.ts:11:export const defaultSpoolGeometry: SpoolGeometry = {
web\src\domain\spool.ts:21:export function estimateDepthMeters(measuredRotations: number, geometry: Partial<SpoolGeometry> = {}) {
web\src\domain\spool.ts:22:  const sanitized = sanitizeGeometry(geometry)
web\src\domain\spool.ts:26:export function estimateCableLengthMeters(measuredRotations: number, geometry: Partial<SpoolGeometry> = {}) {
web\src\domain\spool.ts:27:  const sanitized = sanitizeGeometry(geometry)
web\src\domain\spool.ts:34:  const wrapsPerLayer = Math.max(1, Math.floor(sanitized.spoolWidthMeters / sanitized.cableDiameterMeters))
web\src\domain\spool.ts:39:    const rotationsThisLayer = Math.min(remainingRotations, wrapsPerLayer)
web\src\domain\spool.ts:40:    const layerCenterRadius = sanitized.coreRadiusMeters + sanitized.cableDiameterMeters * (0.5 + layer)
web\src\domain\spool.ts:49:export function rotationsFromDegrees(degrees: number) {
web\src\domain\spool.ts:53:export function rotationsFromEncoderTicks(ticks: number, ticksPerRevolution: number) {
web\src\domain\spool.ts:57:function sanitizeGeometry(geometry: Partial<SpoolGeometry>): SpoolGeometry {
web\src\domain\spool.ts:84:function clamp01(value: number) {
ML\aquascan_ml\train.py:17:from .model import AquaScanMultiTaskModel, AquaScanOnnxWrapper
ML\aquascan_ml\train.py:70:    model = AquaScanMultiTaskModel(len(TEMPORAL_FEATURES), len(CONTEXT_FEATURES))
ML\aquascan_ml\train.py:108:def train_model(model: AquaScanMultiTaskModel, dataset: Dataset, epochs: int, batch_size: int) -> None:
ML\aquascan_ml\train.py:136:def evaluate_model(model: AquaScanMultiTaskModel, dataset: Dataset) -> dict[str, object]:
ML\aquascan_ml\train.py:156:def export_and_validate_onnx(model: AquaScanMultiTaskModel, dataset: Dataset, output_path: Path) -> dict[str, object]:
ML\aquascan_ml\train.py:194:def write_prediction_sample(model: AquaScanMultiTaskModel, dataset: Dataset, path: Path) -> None:
web\src\domain\missionUploadProtocol.ts:1:import type { AquaMission, AquaSample } from '../types/aqua'
web\src\domain\missionUploadProtocol.ts:4:export type MissionUploadBegin = {
web\src\domain\missionUploadProtocol.ts:13:export type MissionUploadWaypoint = {
web\src\domain\missionUploadProtocol.ts:27:export type MissionUploadCommit = {
web\src\domain\missionUploadProtocol.ts:34:export type MissionUploadAbort = {
web\src\domain\missionUploadProtocol.ts:41:export type MissionUploadAck = {
web\src\domain\missionUploadProtocol.ts:49:export type MissionUploadProgress = {
web\src\domain\missionUploadProtocol.ts:57:export type MissionUploadMessage = MissionUploadBegin | MissionUploadWaypoint | MissionUploadCommit | MissionUploadAbort
web\src\domain\missionUploadProtocol.ts:59:export type MissionUploadPlan = {
web\src\domain\missionUploadProtocol.ts:67:export function buildMissionUploadPlan(mission: AquaMission, startingSeq = 1): MissionUploadPlan {
web\src\domain\missionUploadProtocol.ts:68:  const missionId = stableMissionId(mission)
web\src\domain\missionUploadProtocol.ts:69:  const checksum = missionChecksum(mission)
web\src\domain\missionUploadProtocol.ts:71:  const messages: MissionUploadMessage[] = [
web\src\domain\missionUploadProtocol.ts:101:export function abortUploadMessage(missionId: string, seq: number, reason: string): MissionUploadAbort {
web\src\domain\missionUploadProtocol.ts:105:function waypointMessage(sample: AquaSample, index: number, missionId: string, seq: number): MissionUploadWaypoint {
web\src\domain\missionUploadProtocol.ts:121:function stableMissionId(mission: AquaMission) {
web\src\domain\missionUploadProtocol.ts:125:function missionChecksum(mission: AquaMission) {
web\src\domain\missionUploadProtocol.ts:133:function hashText(text: string) {
Assets\Scripts\Visualization\BoatTrackRenderer.cs:11:    public class BoatTrackRenderer : MonoBehaviour
Assets\Scripts\Visualization\BoatTrackRenderer.cs:39:        private void Awake()
Assets\Scripts\Visualization\BoatTrackRenderer.cs:44:        private void OnEnable()
Assets\Scripts\Visualization\BoatTrackRenderer.cs:49:        private void EnsureLineRenderer()
Assets\Scripts\Visualization\BoatTrackRenderer.cs:59:        public void RenderTrack(AquaMission mission)
Assets\Scripts\Visualization\BoatTrackRenderer.cs:80:        public void ToggleVisibility(bool visible)
Assets\Scripts\Visualization\BoatTrackRenderer.cs:93:        public void UpdateBoatPosition(AquaSample from, AquaSample to, float tLerp)
Assets\Scripts\Visualization\BoatTrackRenderer.cs:121:                var rot = Quaternion.LookRotation(flatDir, Vector3.up);
Assets\Scripts\Visualization\BoatTrackRenderer.cs:140:        private void EnsureProbeVisuals()
Assets\Scripts\Visualization\BoatTrackRenderer.cs:239:        private void UpdateProbeTether(AquaSample from, AquaSample to, float tLerp, Vector3 boatPosition)
Assets\Scripts\Visualization\BoatTrackRenderer.cs:292:        private void UpdateDepthRings(Vector3 top, float visibleDepth)
Assets\Scripts\Visualization\BoatTrackRenderer.cs:308:        private static void WriteCircle(LineRenderer ring, Vector3 center, float radius)
Assets\Scripts\Visualization\BoatTrackRenderer.cs:318:        private void SetProbeVisible(bool visible)
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
