ubparot/AQUAScan/(list of files, cad)

Other CAD files:
Assets/Alstra Infinite/Props LowPoly/Source/LowPoly_Furnace.blend
