ubparot/AQUAScan/outputs/graph-data-workbooks/pond-Pond_Operations.png

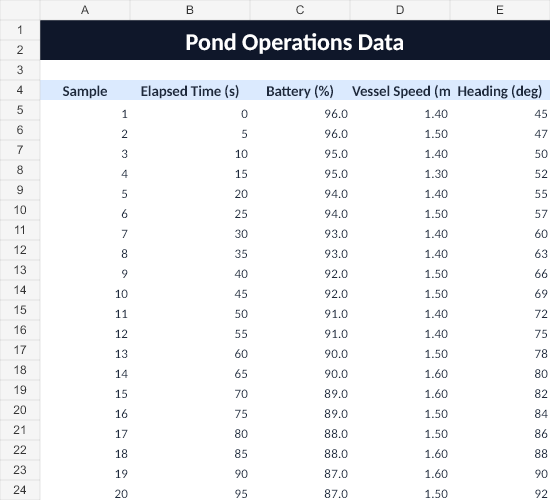
outputs/graph-data-workbooks/pond-Pond_Operations.png
