ubparot/AQUAScan/outputs/graph-data-workbooks/pool-Pool_Operations.png

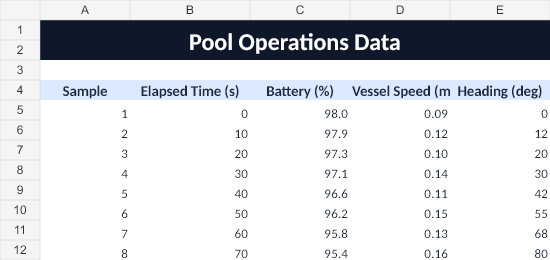
outputs/graph-data-workbooks/pool-Pool_Operations.png
