ubparot/AQUAScan/PortfolioAreaGraphs/operations_overview.png

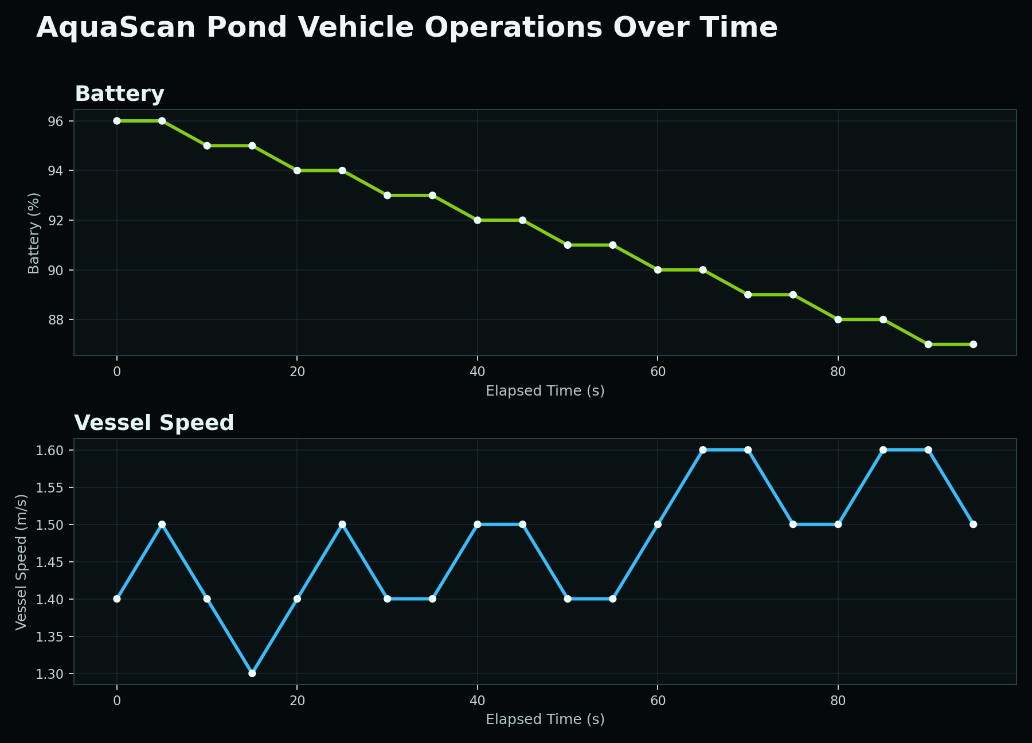
PortfolioAreaGraphs/operations_overview.png
