ubparot/AQUAScan/PortfolioGraphs/operations_overview.png

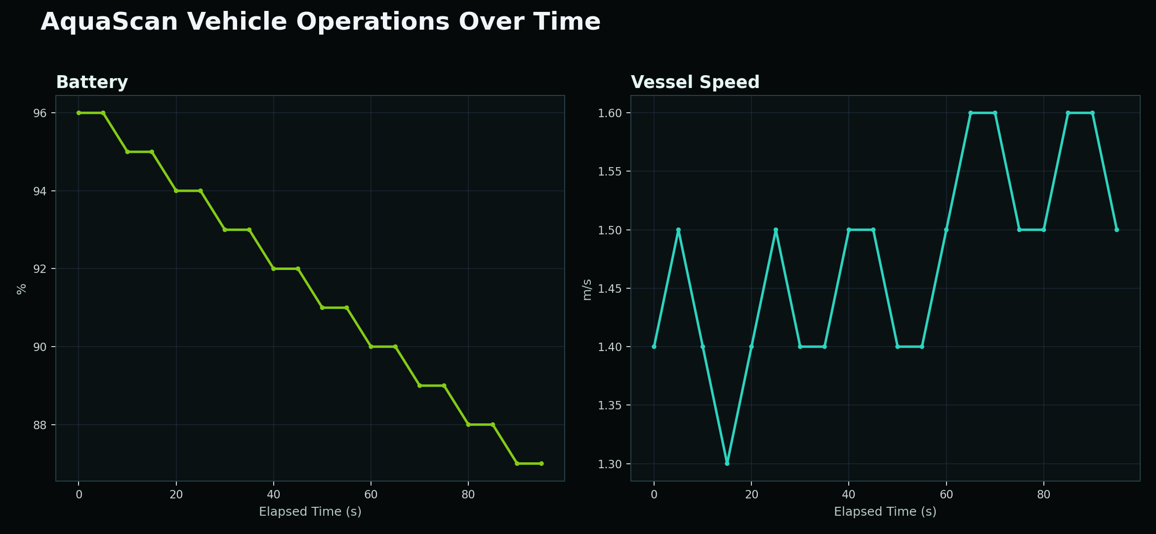
PortfolioGraphs/operations_overview.png
