ubparot/AQUAScan/PortfolioGraphsPool/operations_overview.png

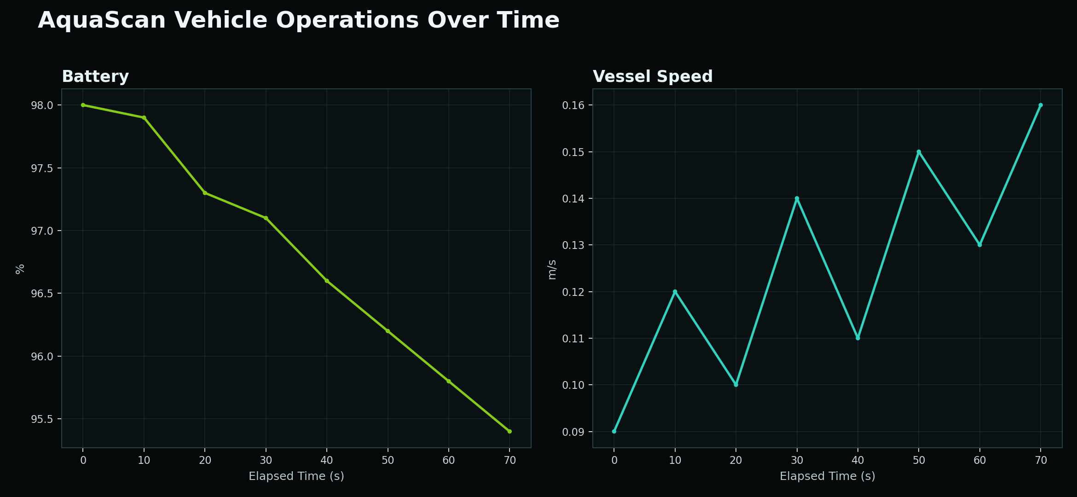
PortfolioGraphsPool/operations_overview.png
