ubparot/AQUAScan/deliverables/maris-visuals/maris-validation-map.png

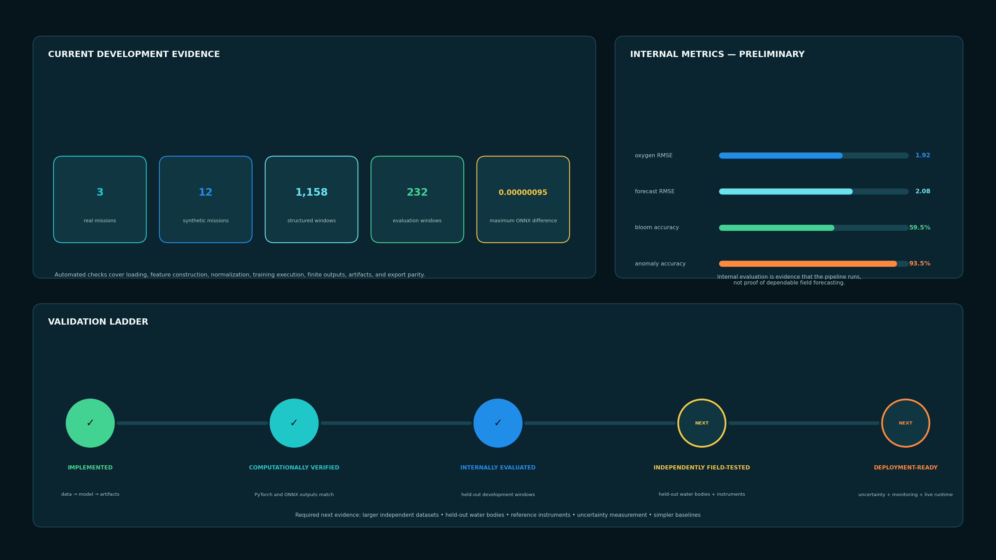
deliverables/maris-visuals/maris-validation-map.png
