ubparot/AQUAScan/tmp/docx-render-worklog/page-2.png

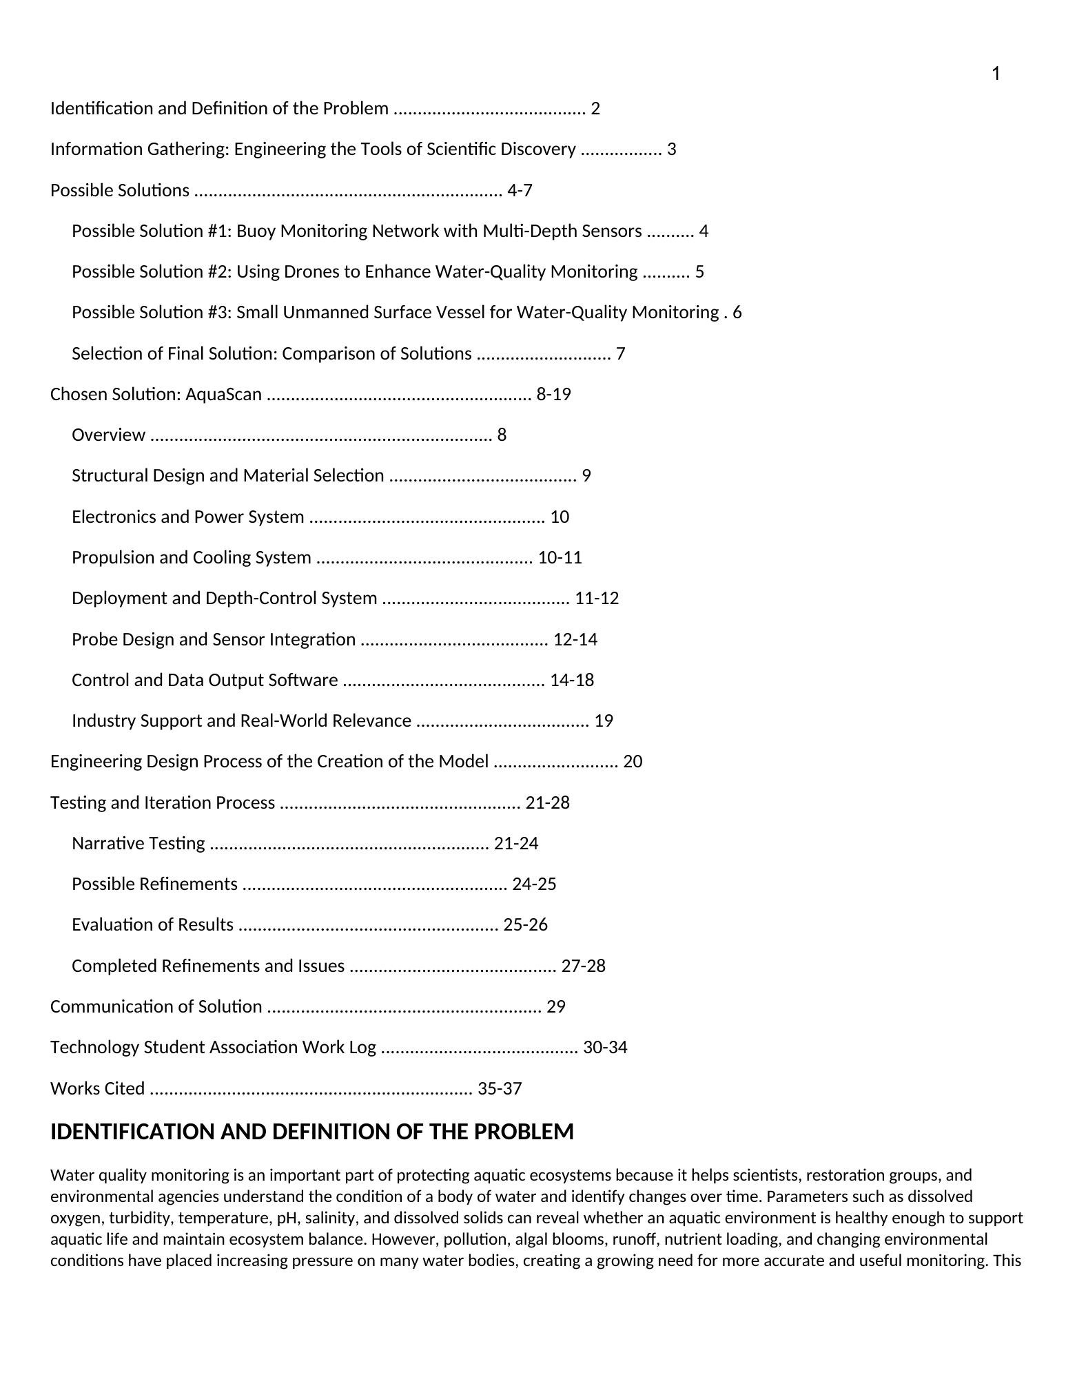
tmp/docx-render-worklog/page-2.png
