ubparot/AQUAScan/tmp/docx-render-worklog/page-3.png

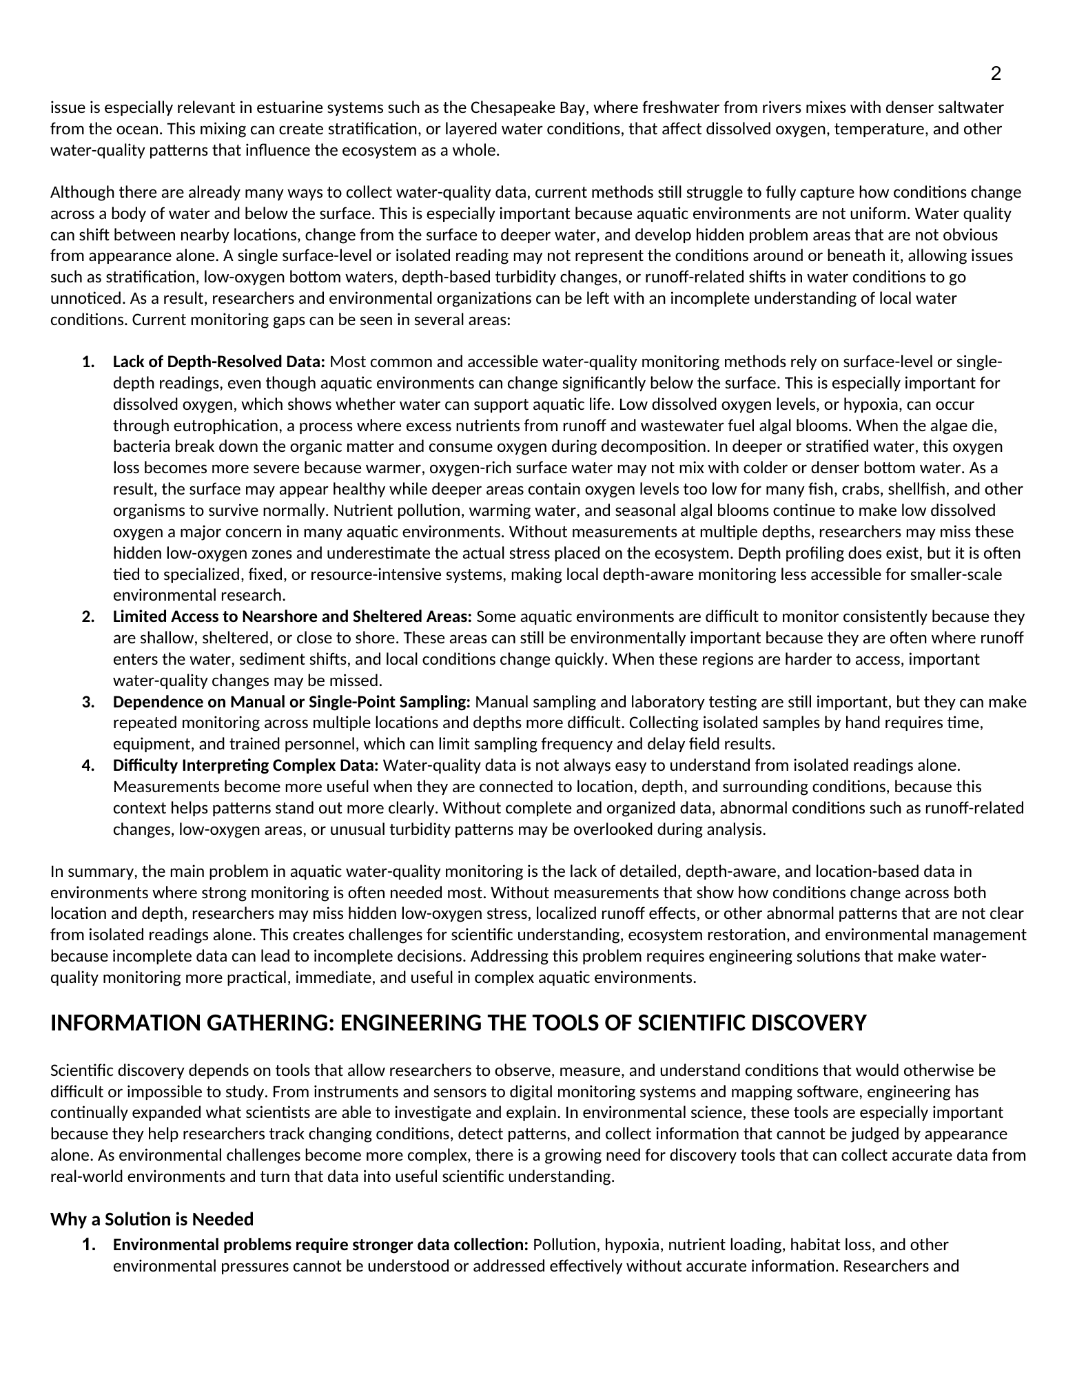
tmp/docx-render-worklog/page-3.png
