ubparot/AQUAScan/tmp/docx-render-worklog/page-4.png

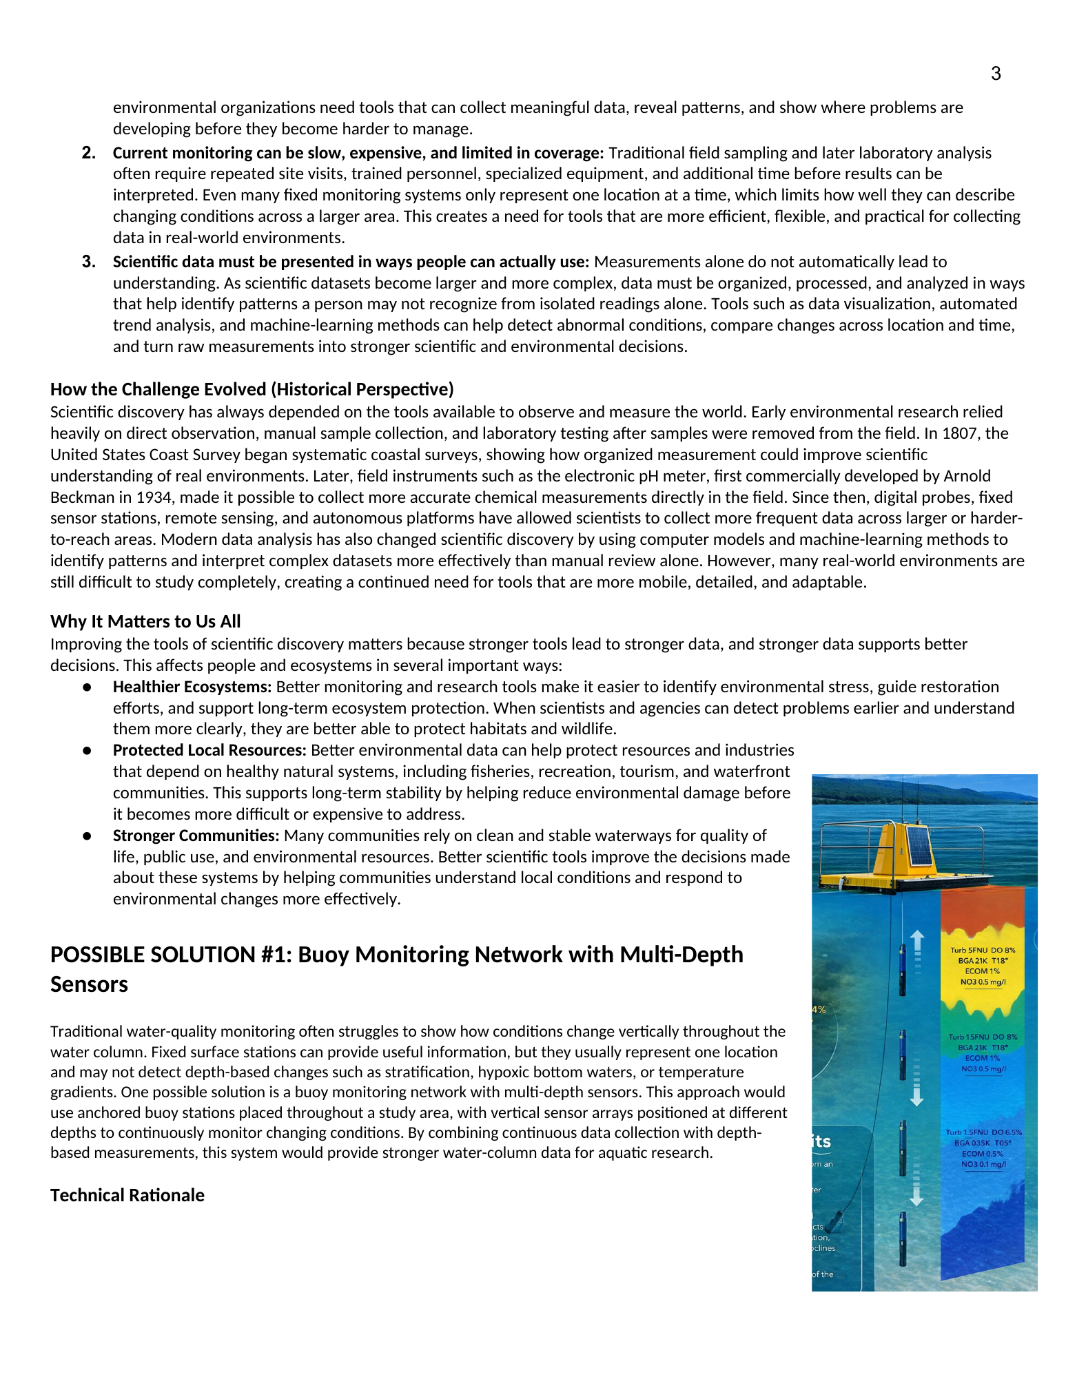
tmp/docx-render-worklog/page-4.png
