ubparot/AQUAScan/tmp/docx-render-worklog/page-5.png

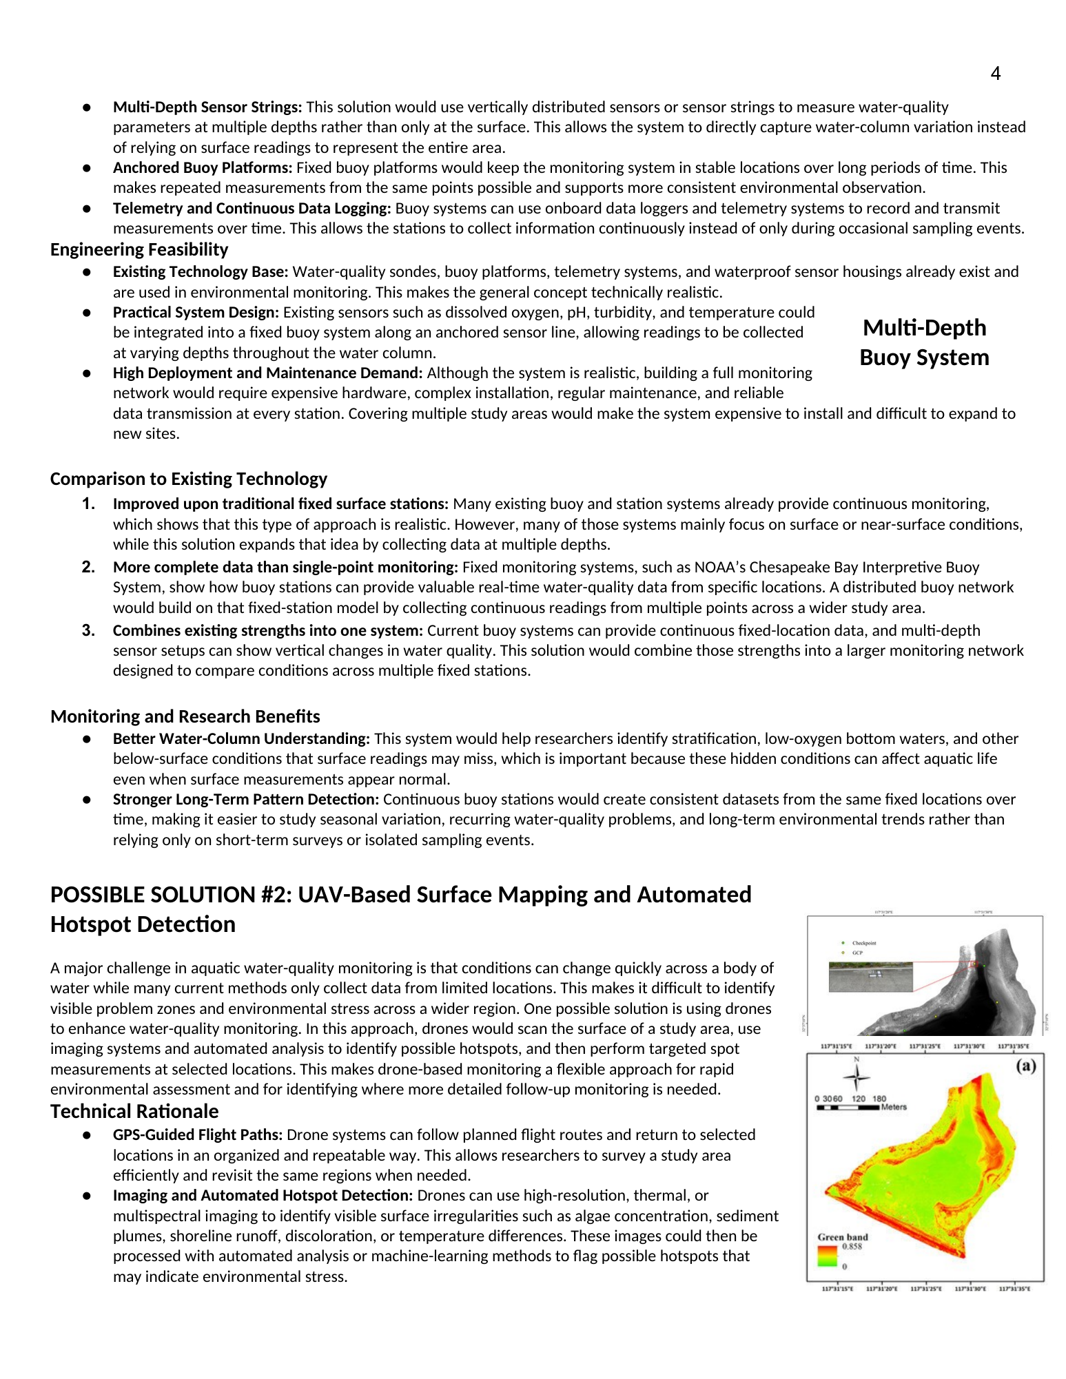
tmp/docx-render-worklog/page-5.png
