ubparot/AQUAScan/tmp/docx-render-worklog/page-6.png

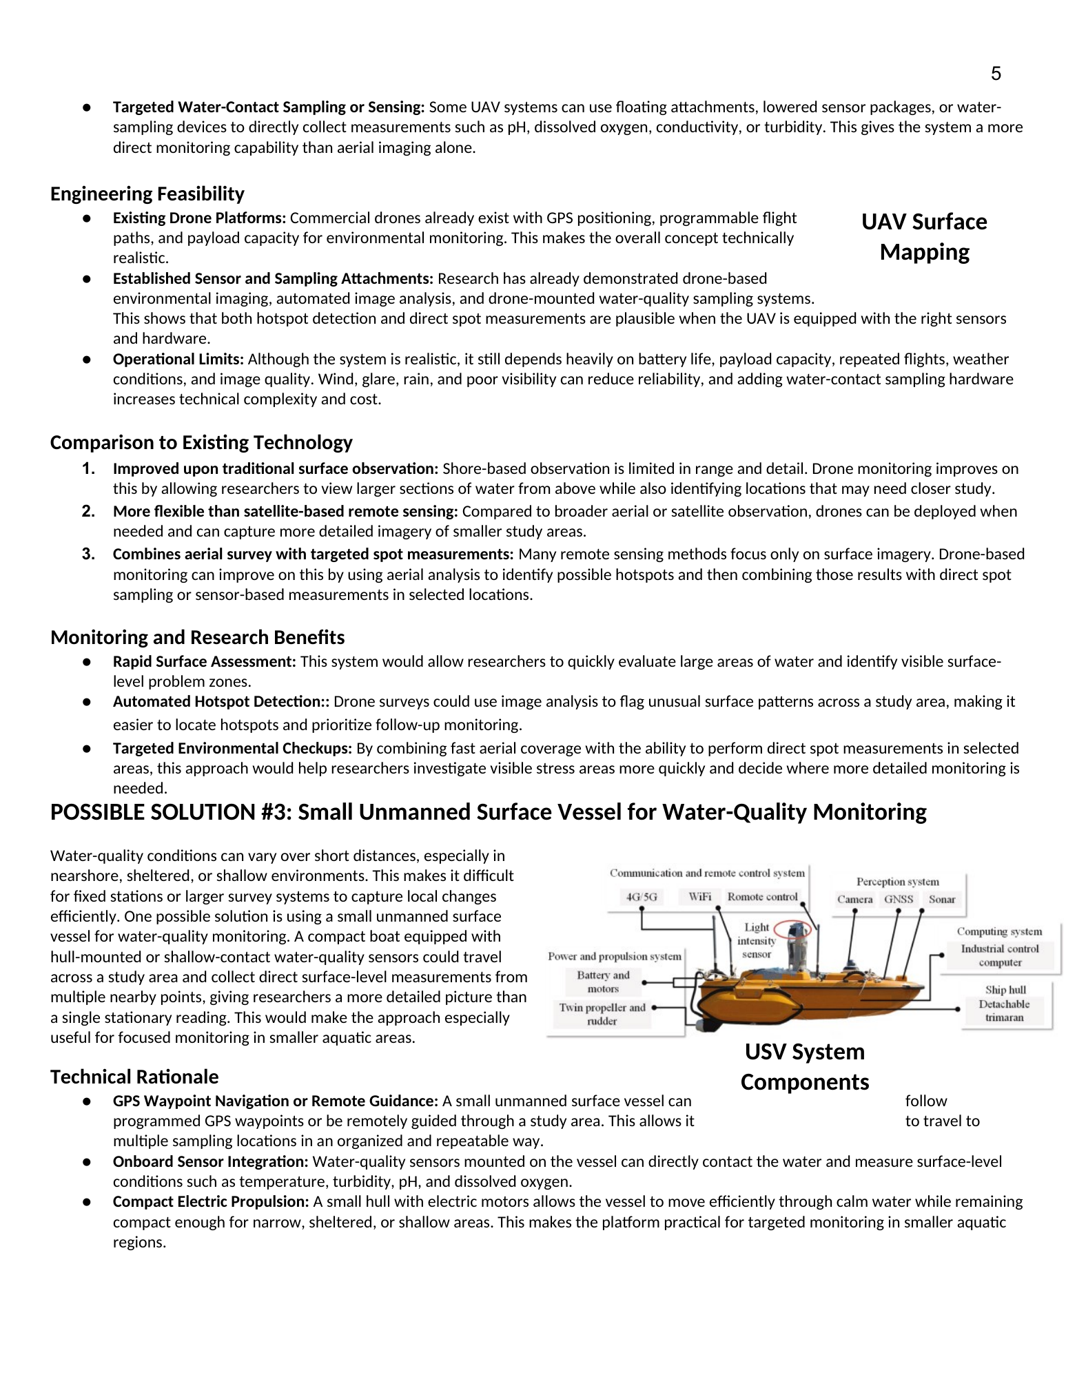
tmp/docx-render-worklog/page-6.png
