ubparot/AQUAScan/tmp/docx-render-worklog/page-7.png

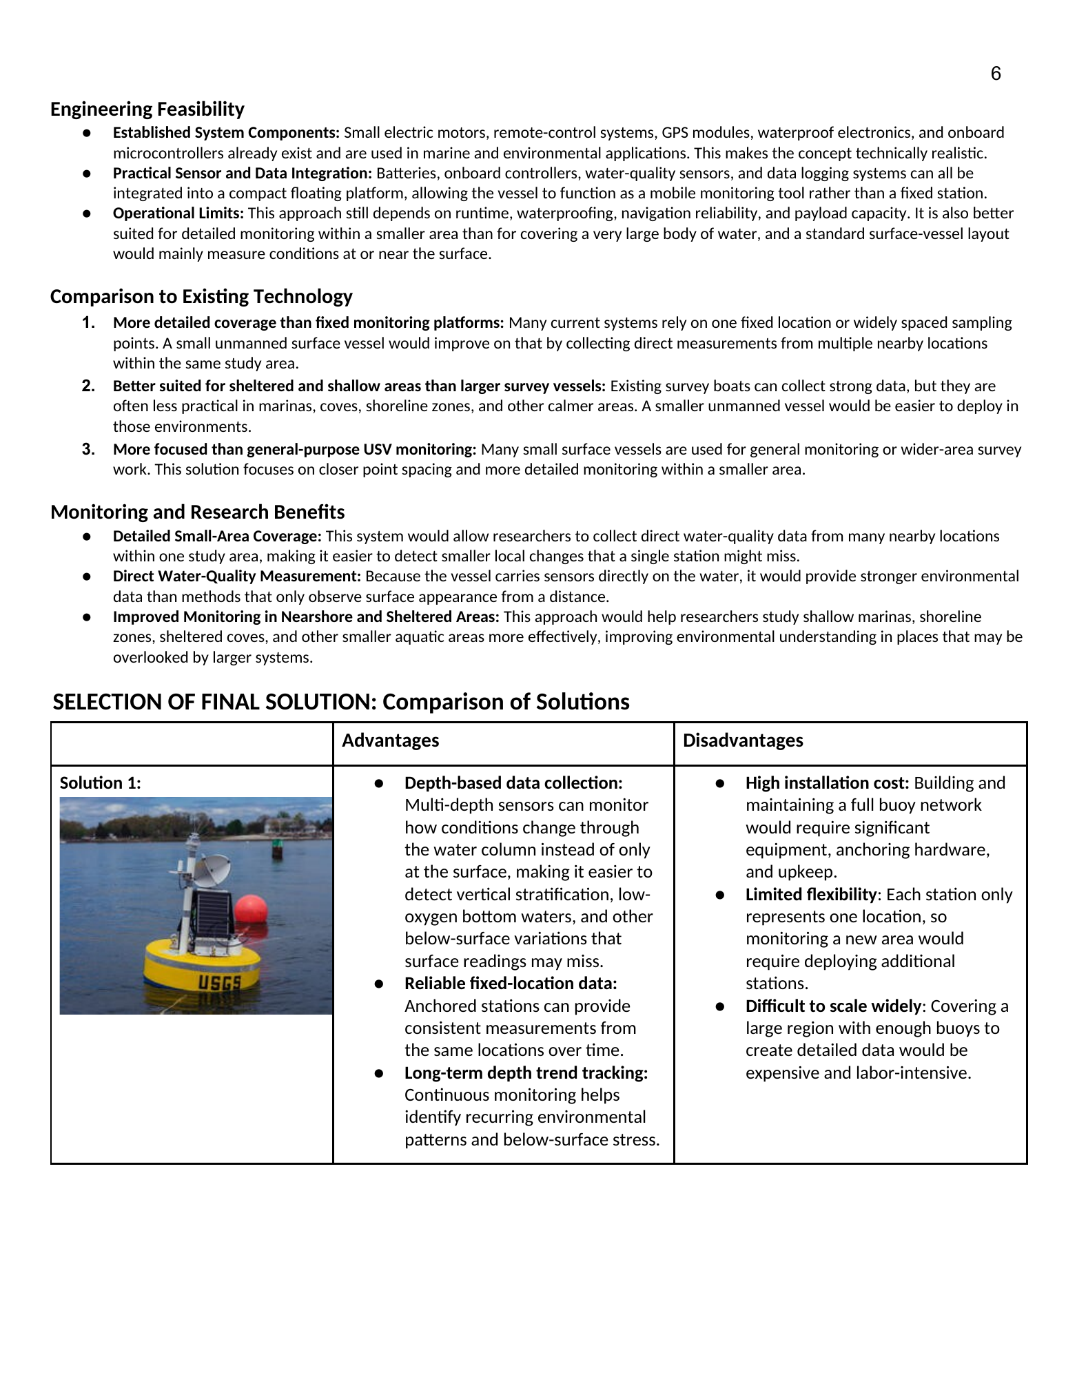
tmp/docx-render-worklog/page-7.png
