ubparot/AQUAScan/tmp/docx-render-worklog/page-8.png

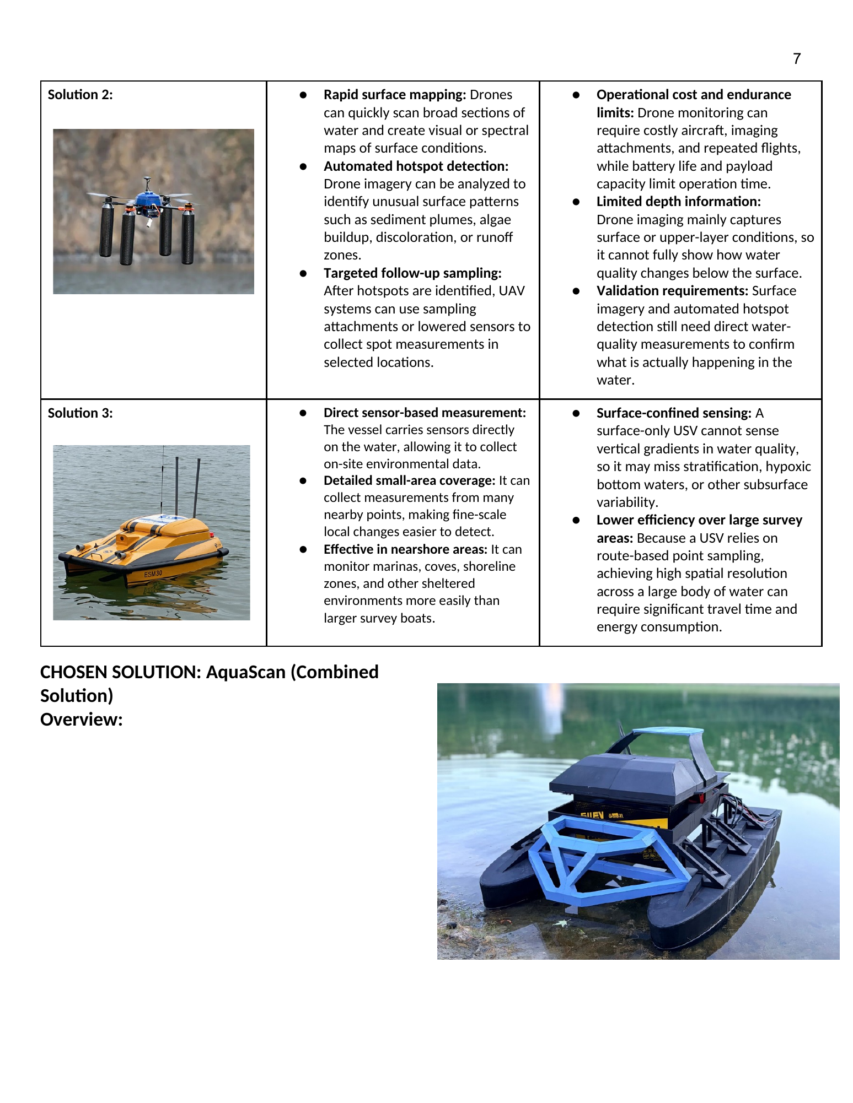
tmp/docx-render-worklog/page-8.png
