ubparot/AQUAScan/tmp/docx-render-worklog/page-9.png

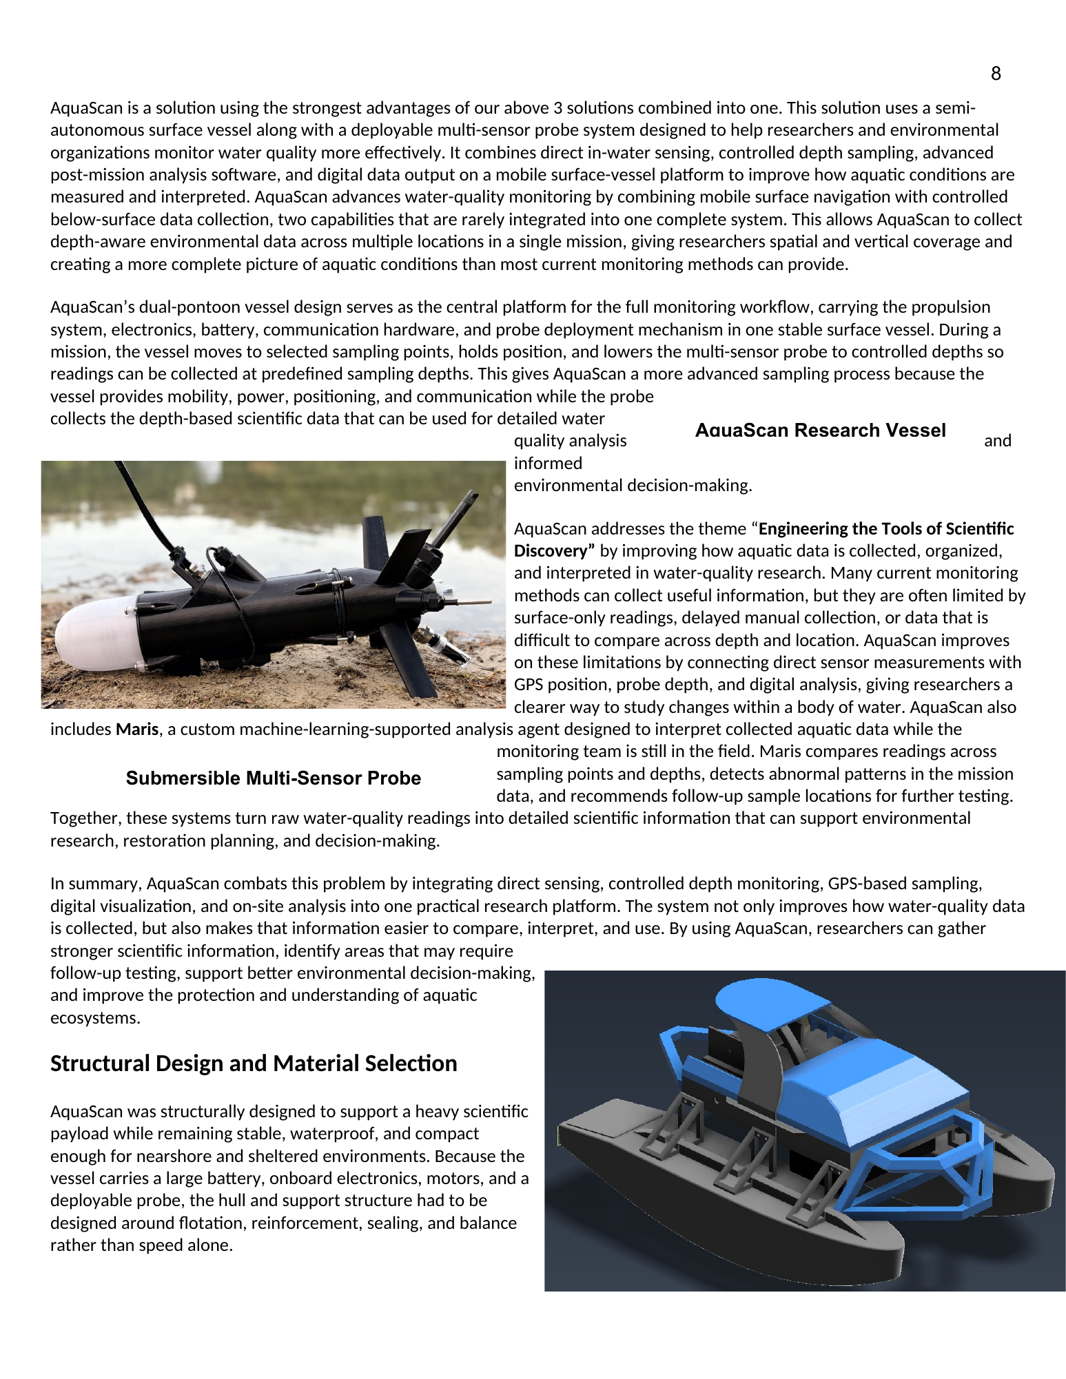
tmp/docx-render-worklog/page-9.png
