ubparot/AQUAScan/tmp/docx-render-worklog/page-10.png

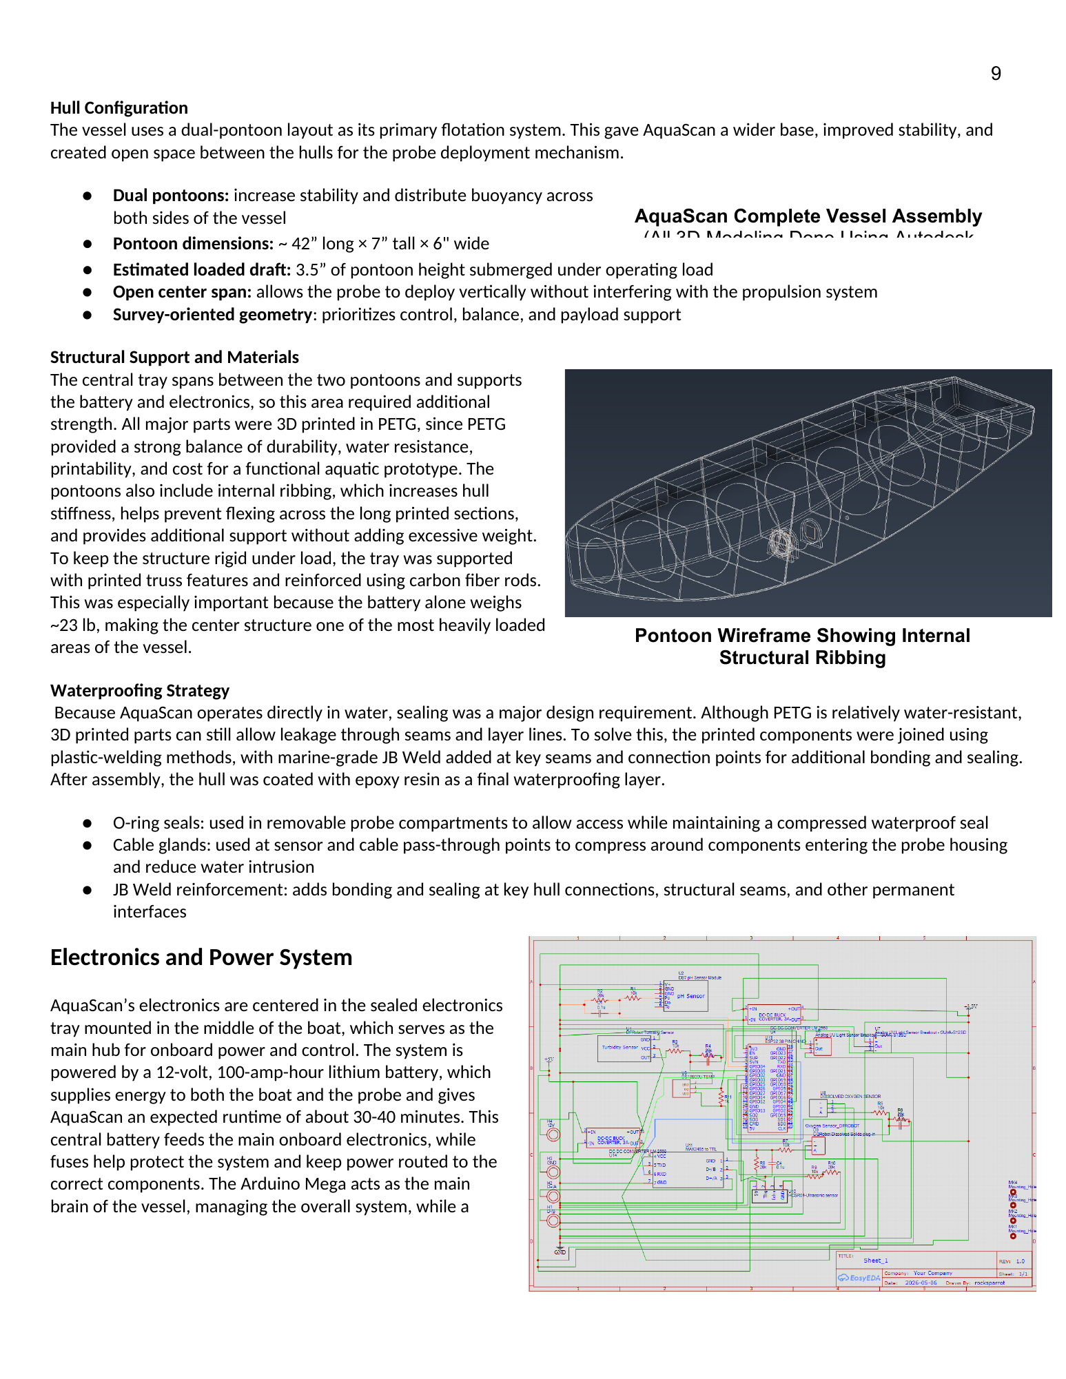
tmp/docx-render-worklog/page-10.png
