ubparot/AQUAScan/tmp/docx-render-worklog/page-11.png

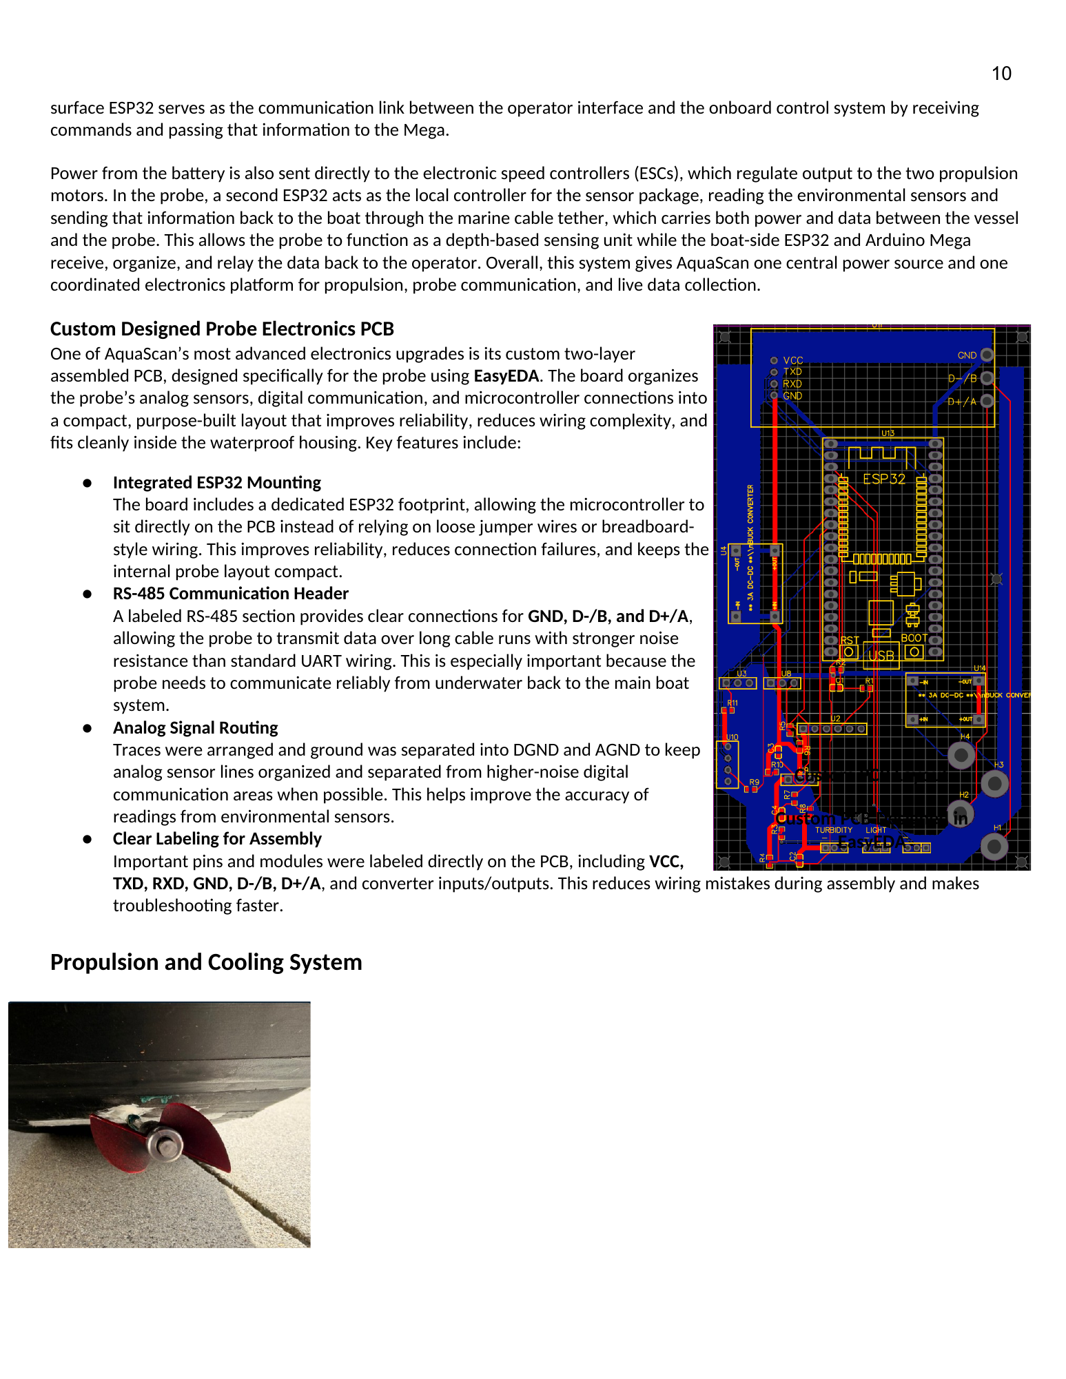
tmp/docx-render-worklog/page-11.png
