ubparot/AQUAScan/tmp/docx-render-worklog/page-12.png

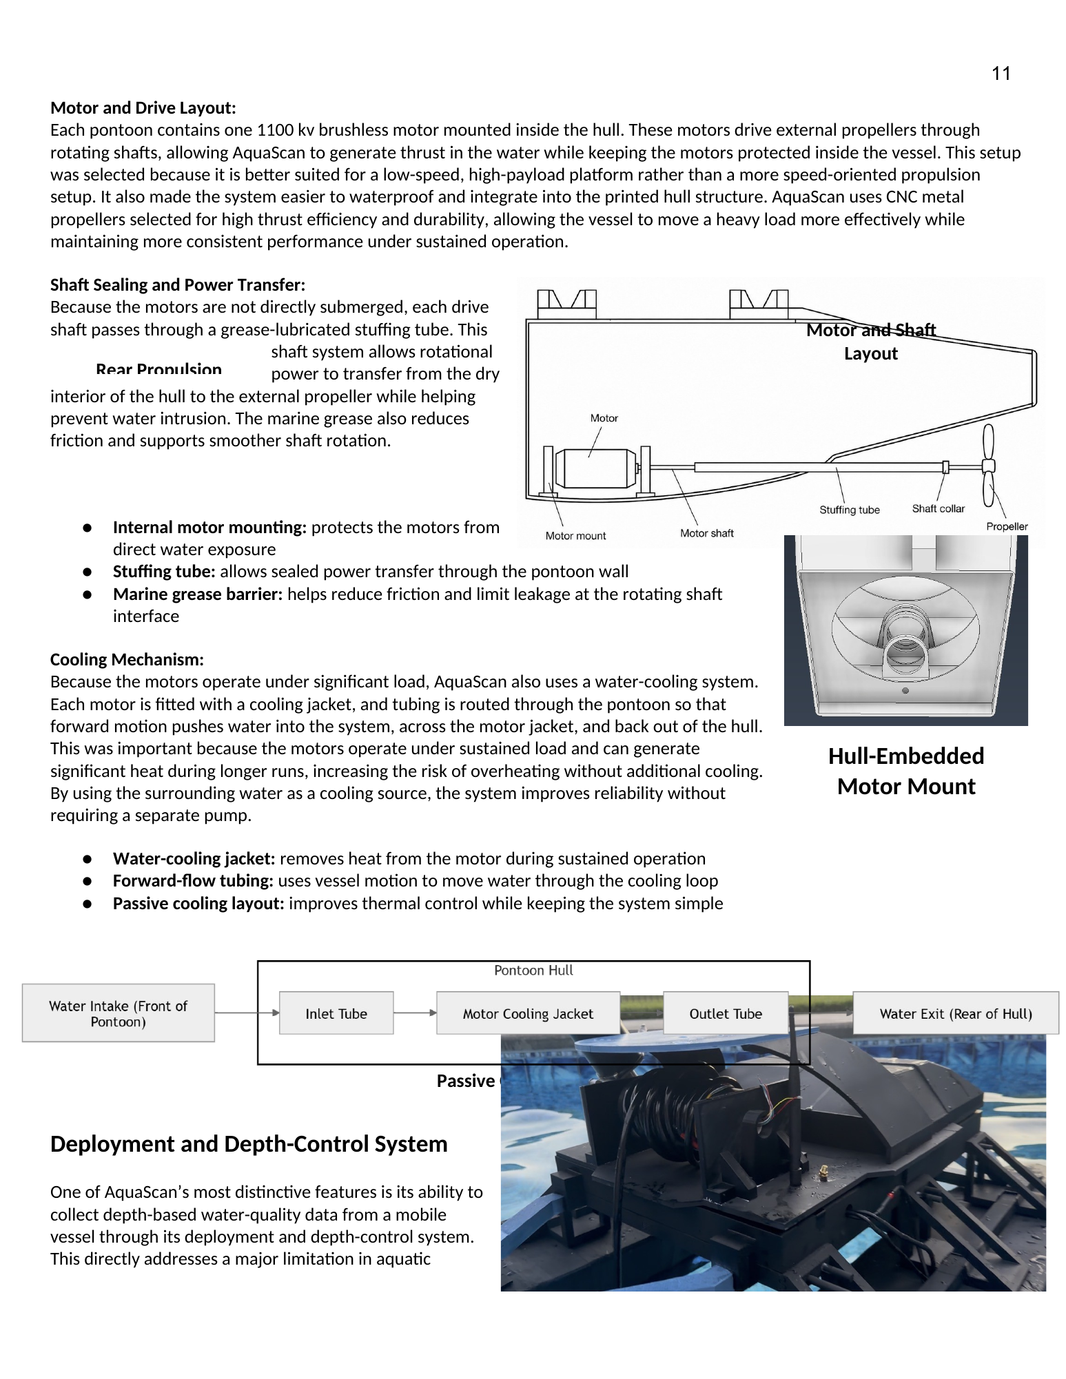
tmp/docx-render-worklog/page-12.png
