ubparot/AQUAScan/tmp/docx-render-worklog/page-13.png

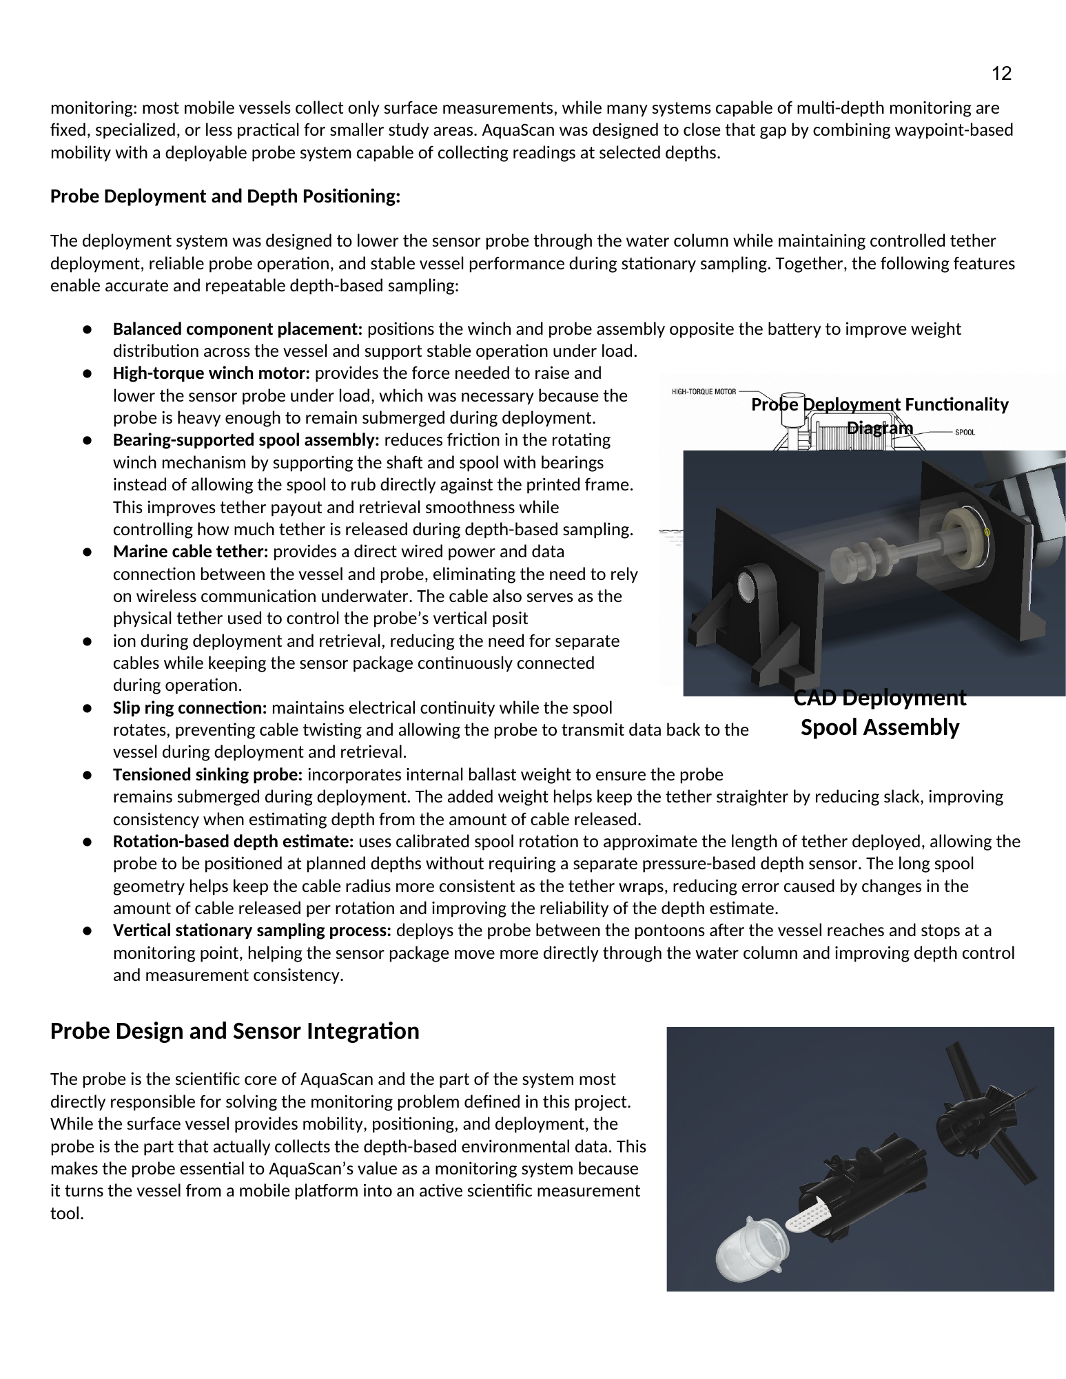
tmp/docx-render-worklog/page-13.png
