ubparot/AQUAScan/tmp/docx-render-worklog/page-14.png

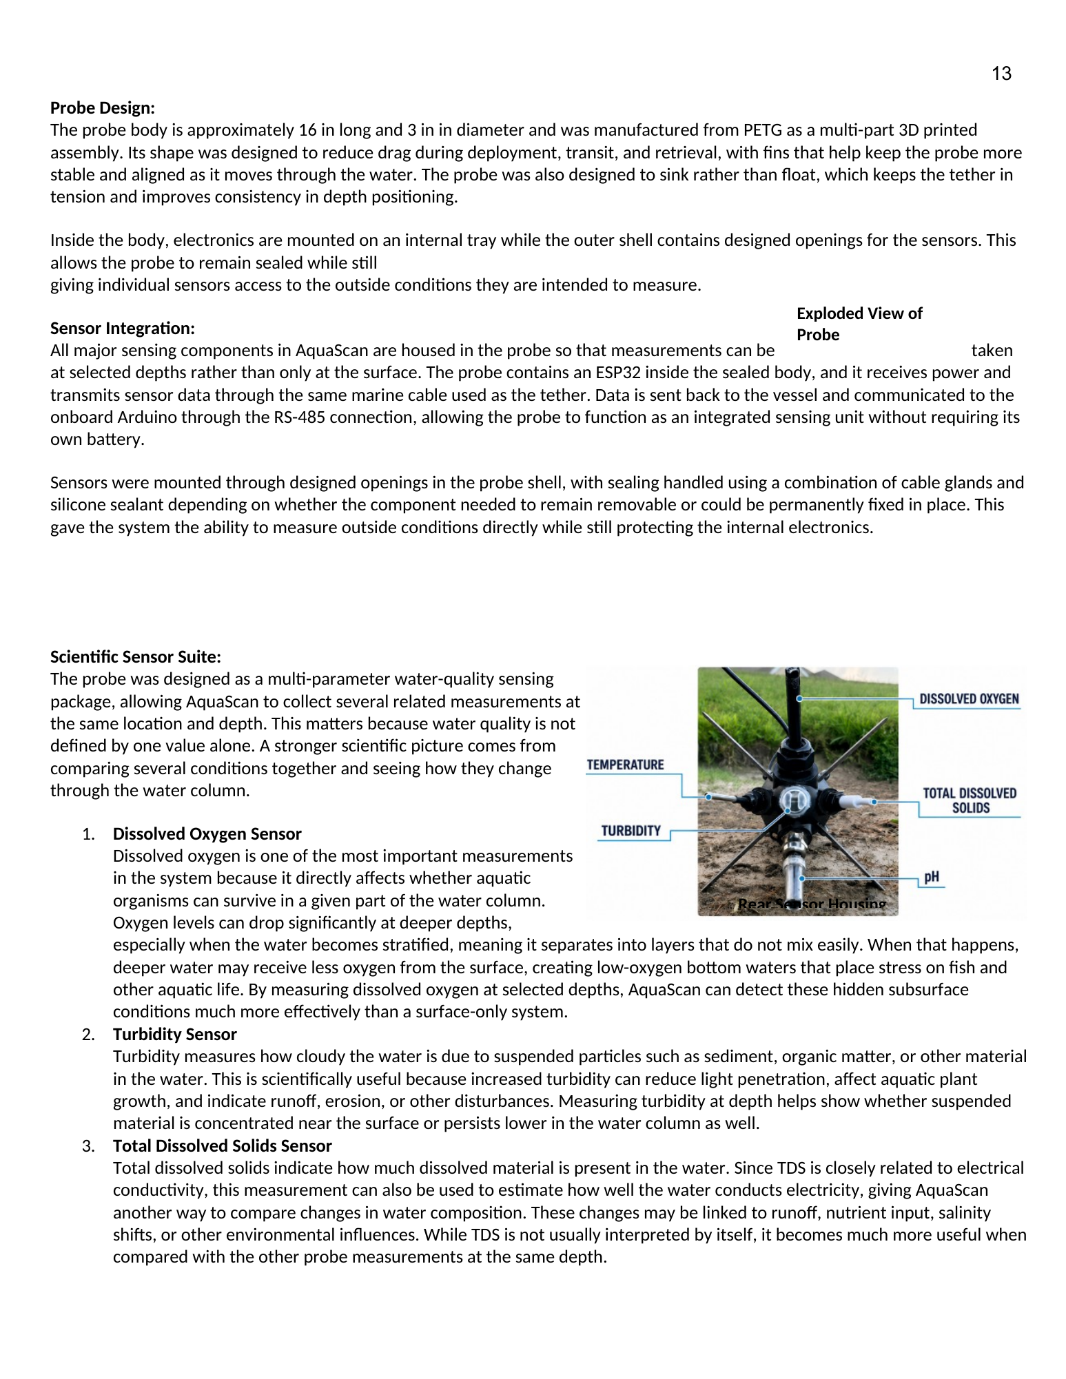
tmp/docx-render-worklog/page-14.png
