ubparot/AQUAScan/tmp/docx-render-worklog/page-15.png

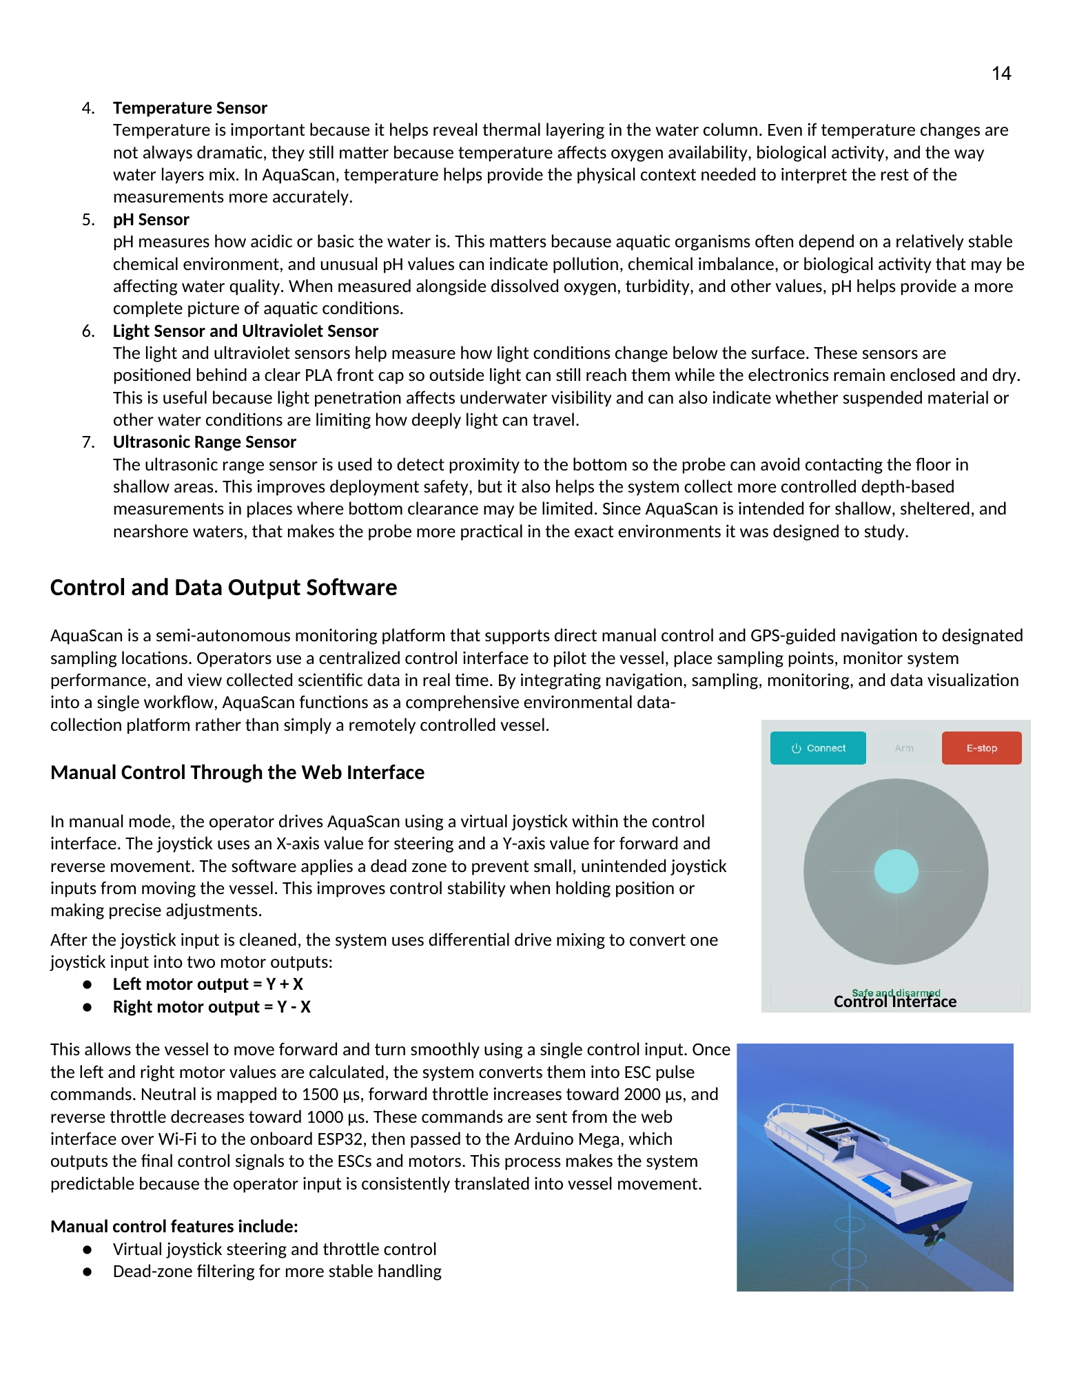
tmp/docx-render-worklog/page-15.png
