ubparot/AQUAScan/tmp/docx-render-worklog/page-16.png

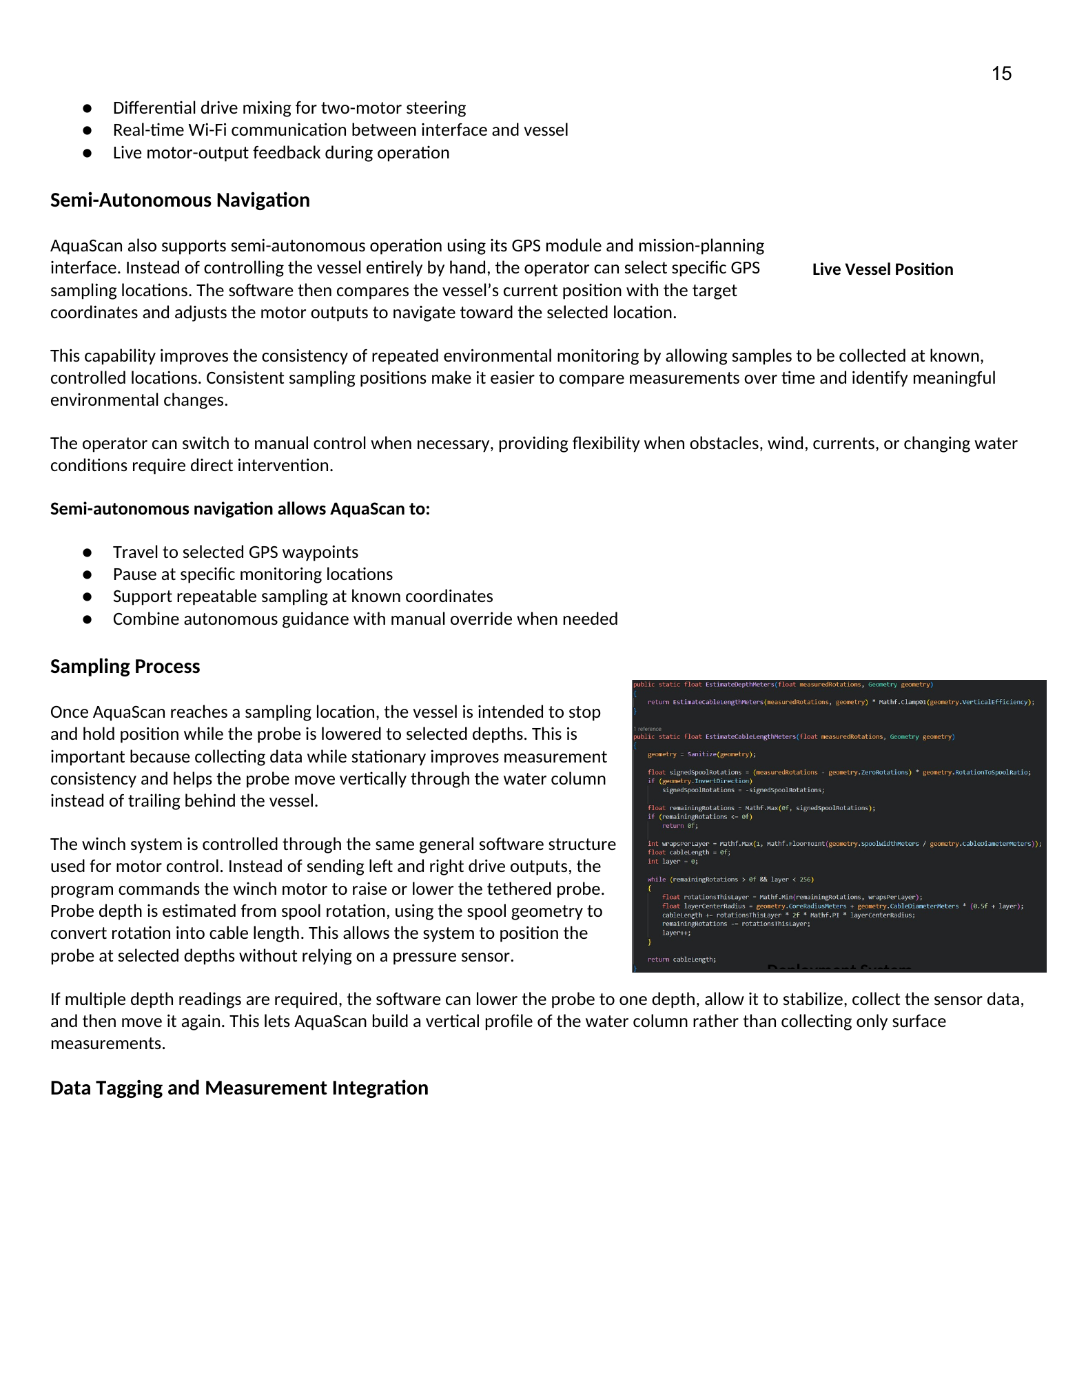
tmp/docx-render-worklog/page-16.png
