ubparot/AQUAScan/tmp/docx-render-worklog/page-17.png

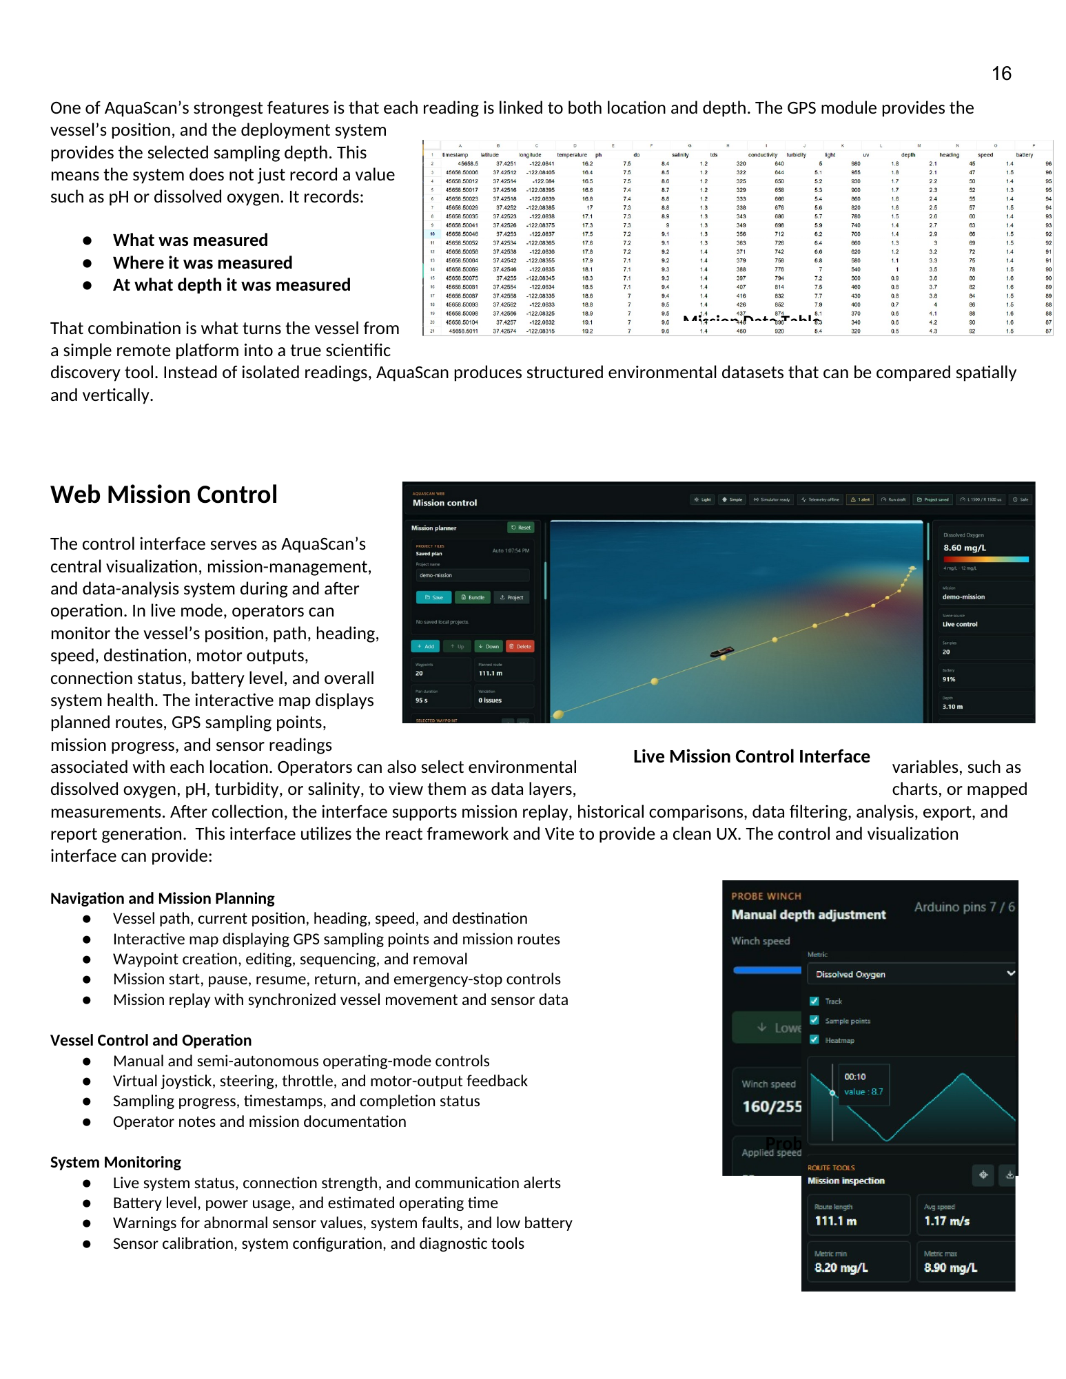
tmp/docx-render-worklog/page-17.png
