ubparot/AQUAScan/tmp/docx-render-worklog/page-18.png

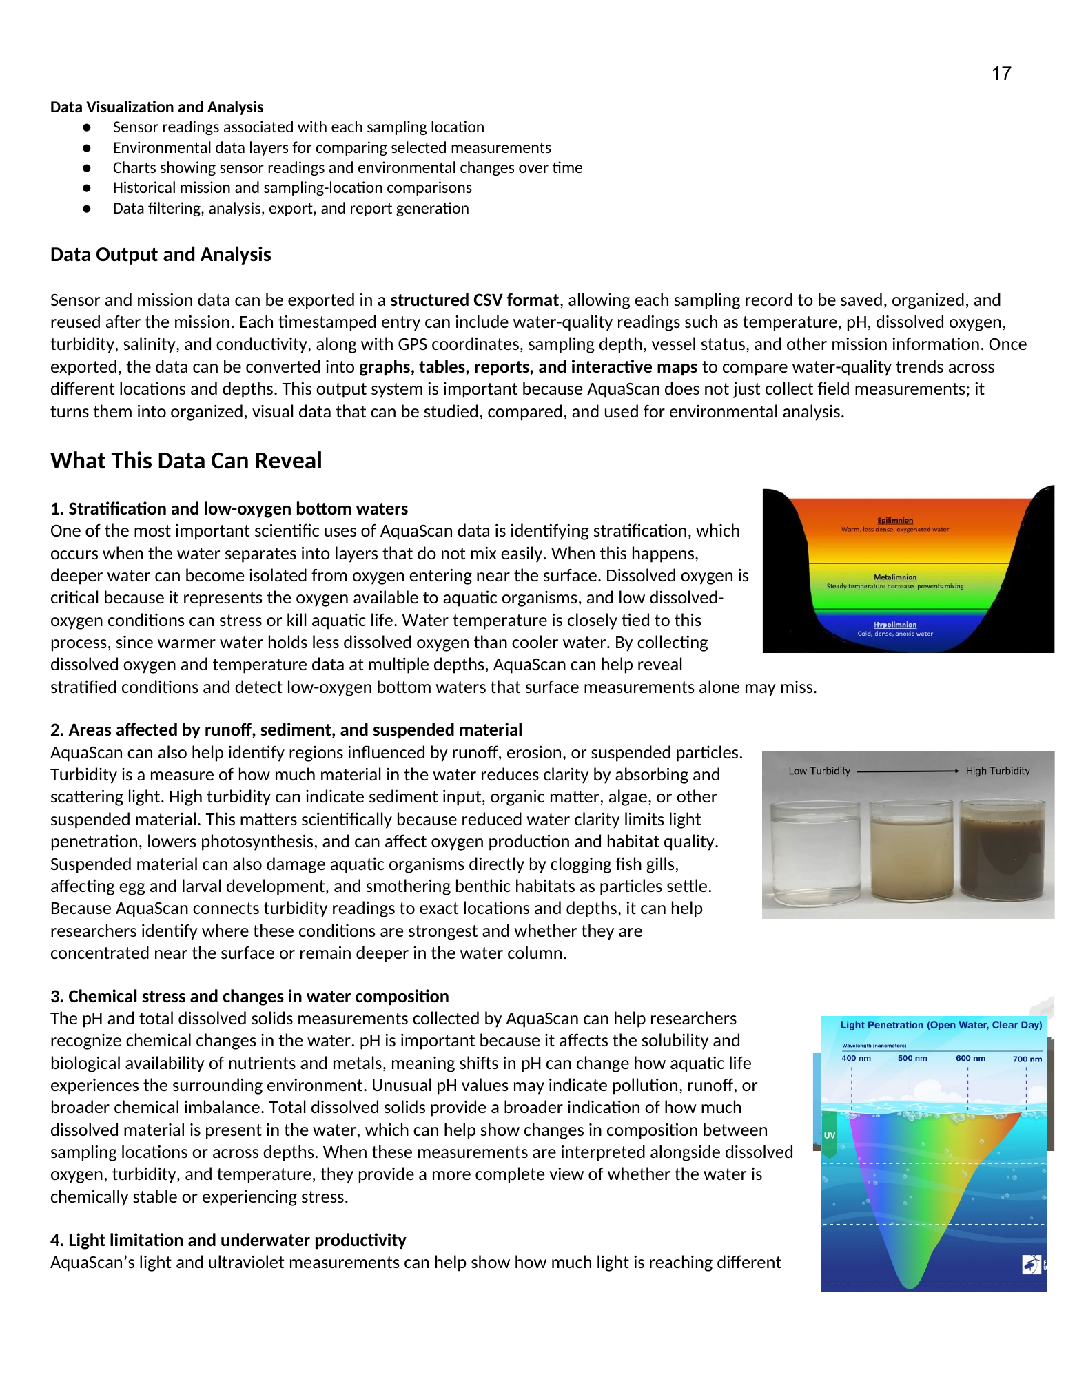
tmp/docx-render-worklog/page-18.png
