ubparot/AQUAScan/tmp/docx-render-worklog/page-19.png

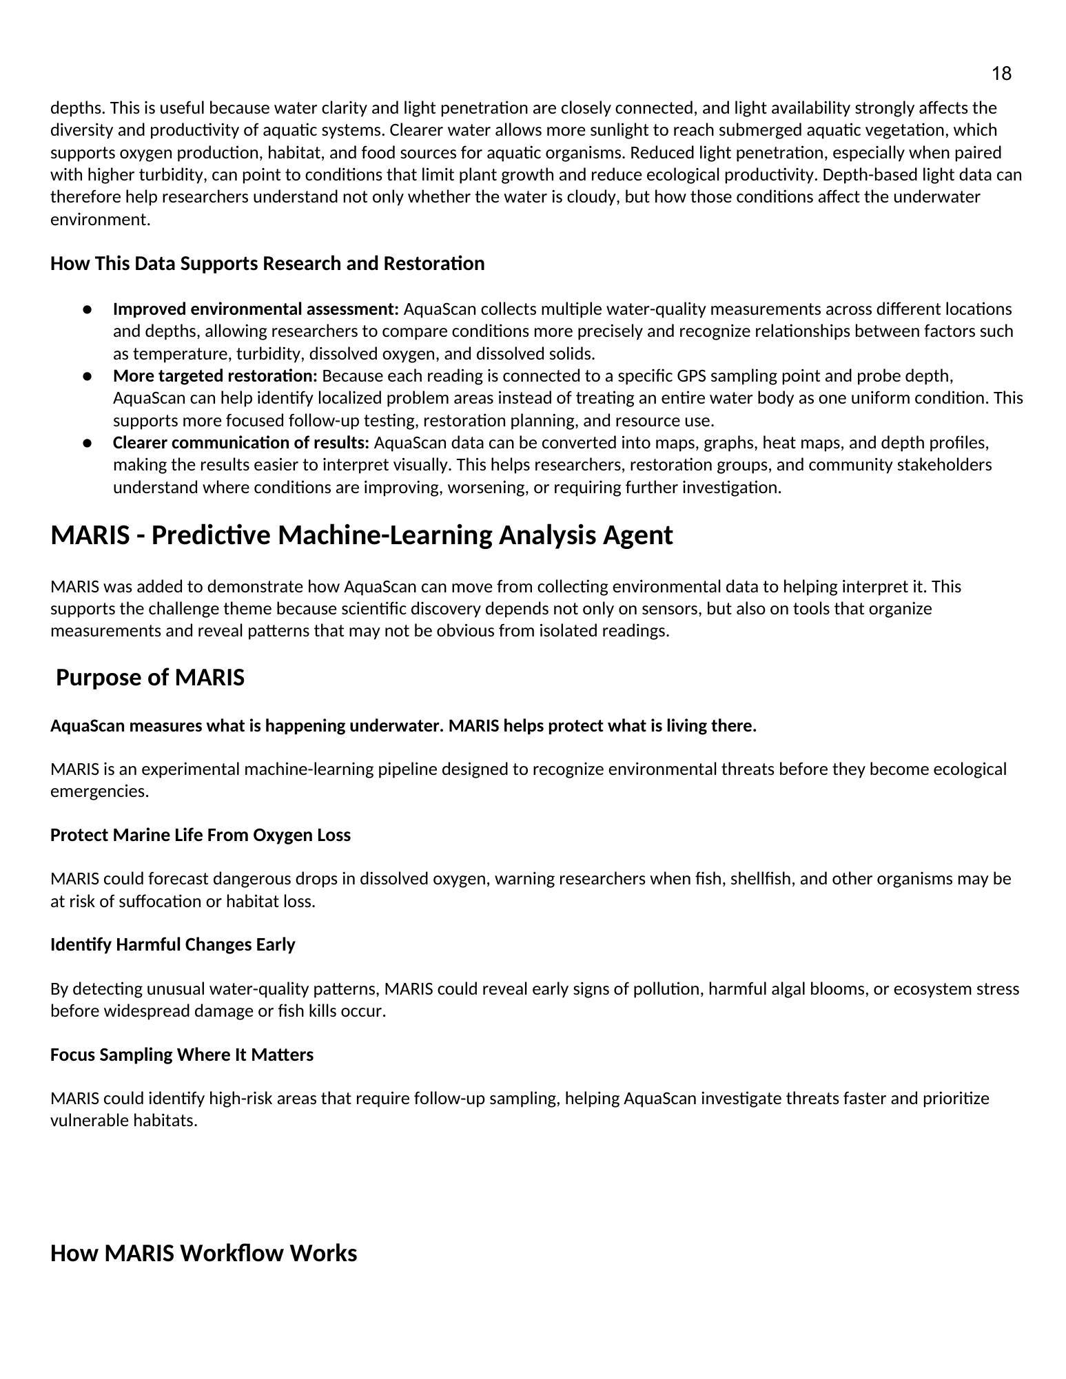
tmp/docx-render-worklog/page-19.png
