ubparot/AQUAScan/tmp/docx-render-worklog/page-20.png

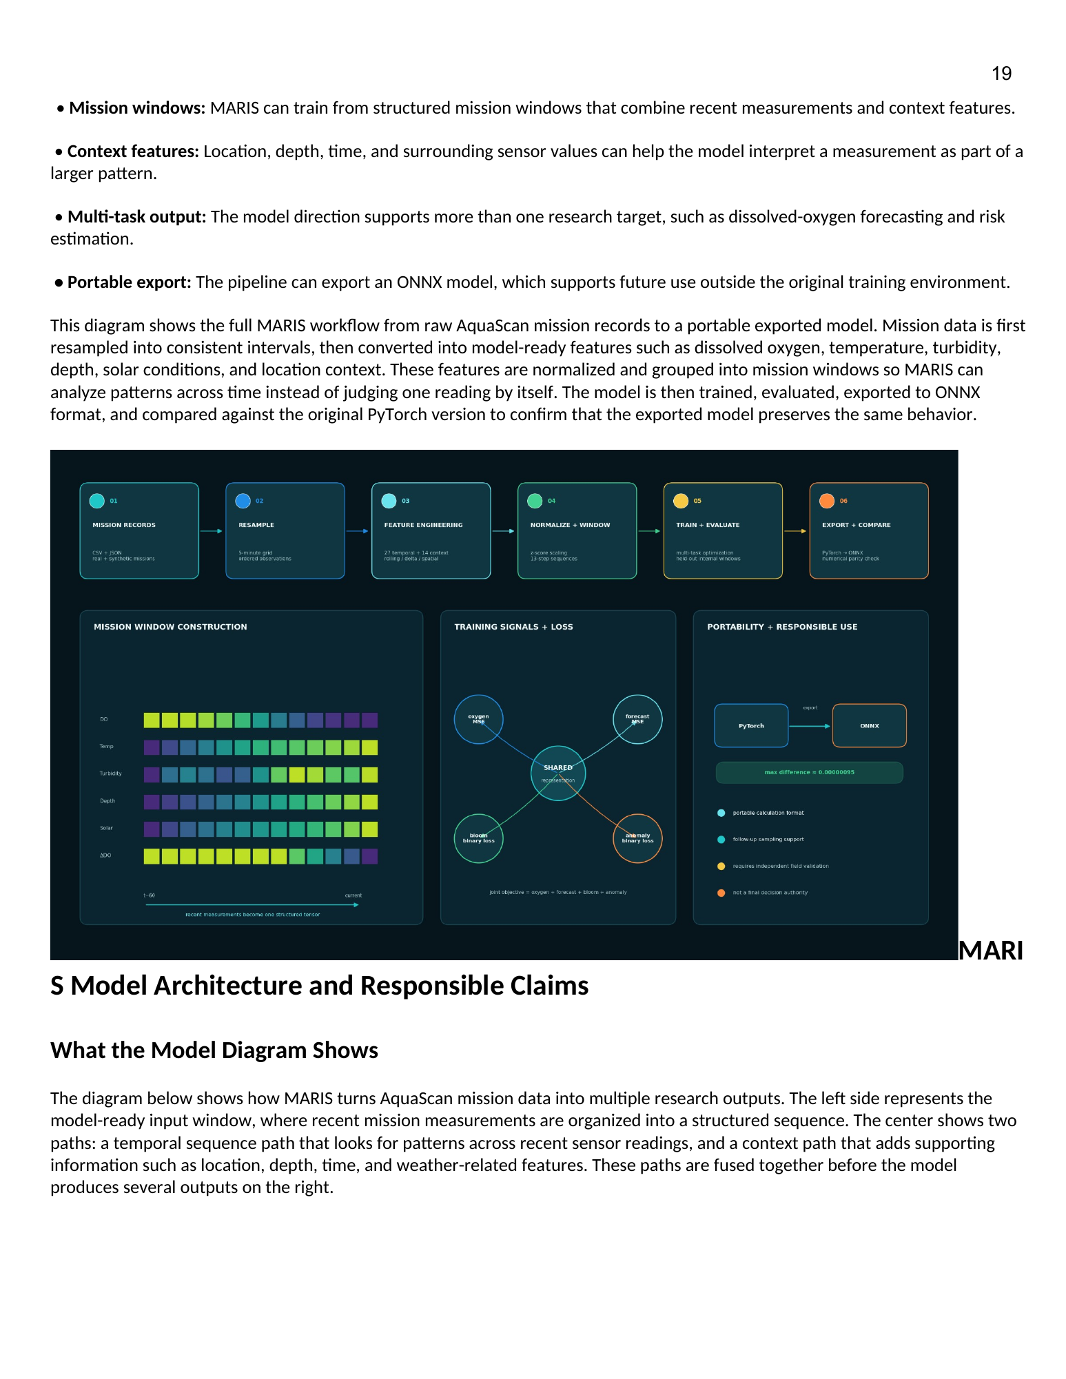
tmp/docx-render-worklog/page-20.png
