ubparot/AQUAScan/tmp/docx-render-worklog/page-21.png

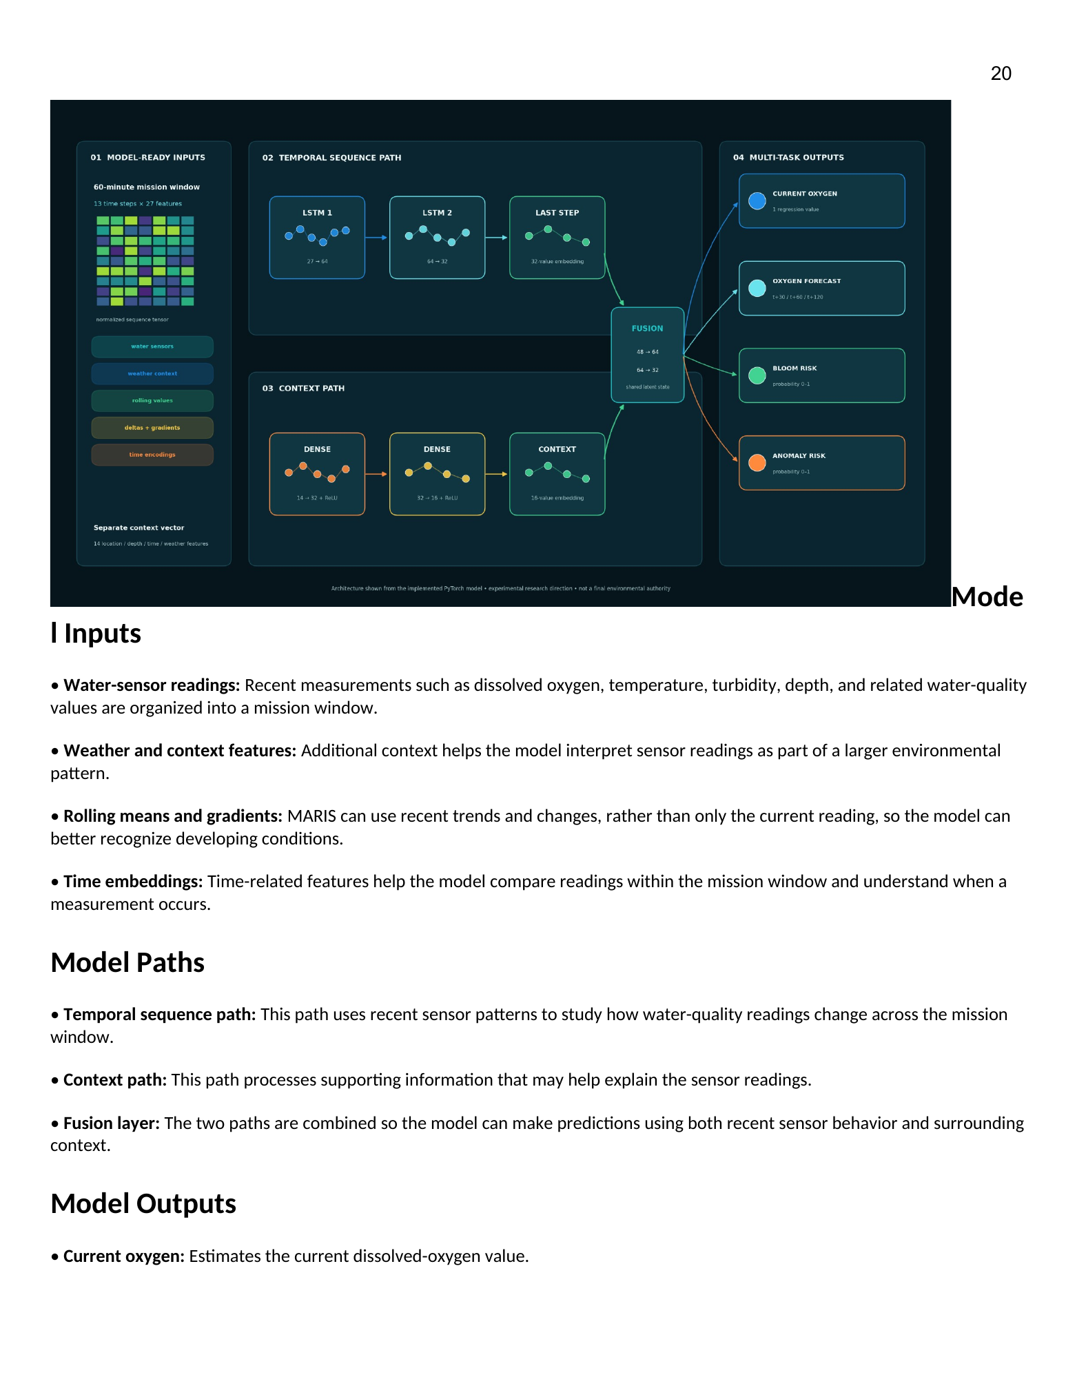
tmp/docx-render-worklog/page-21.png
