ubparot/AQUAScan/tmp/docx-render-worklog/page-22.png

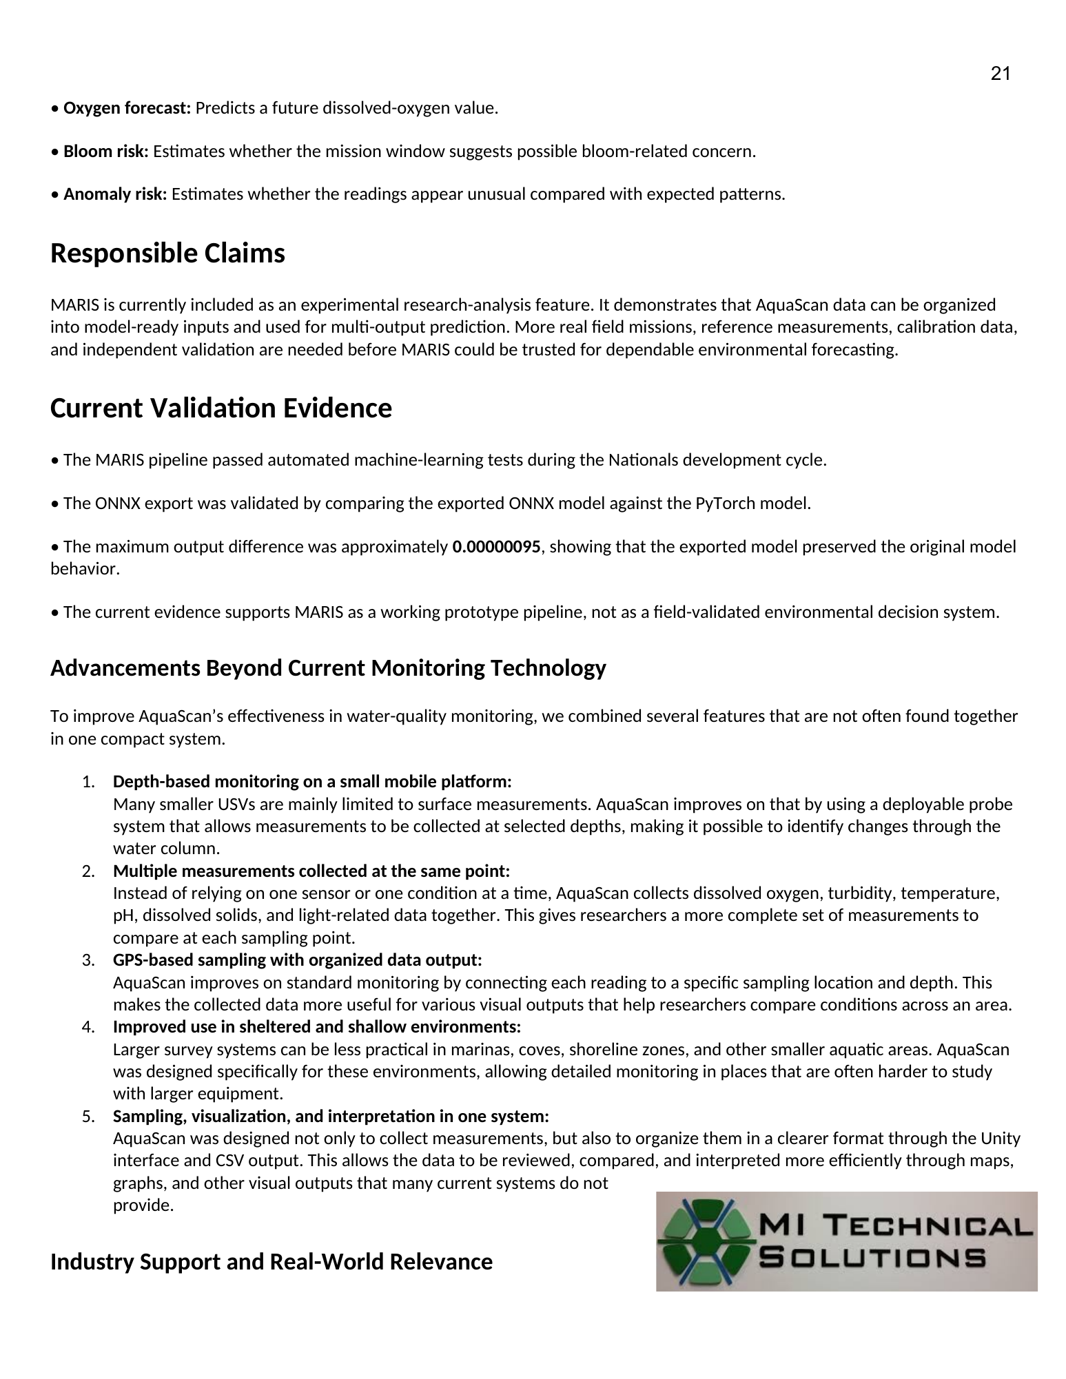
tmp/docx-render-worklog/page-22.png
