ubparot/AQUAScan/tmp/docx-render-worklog/page-23.png

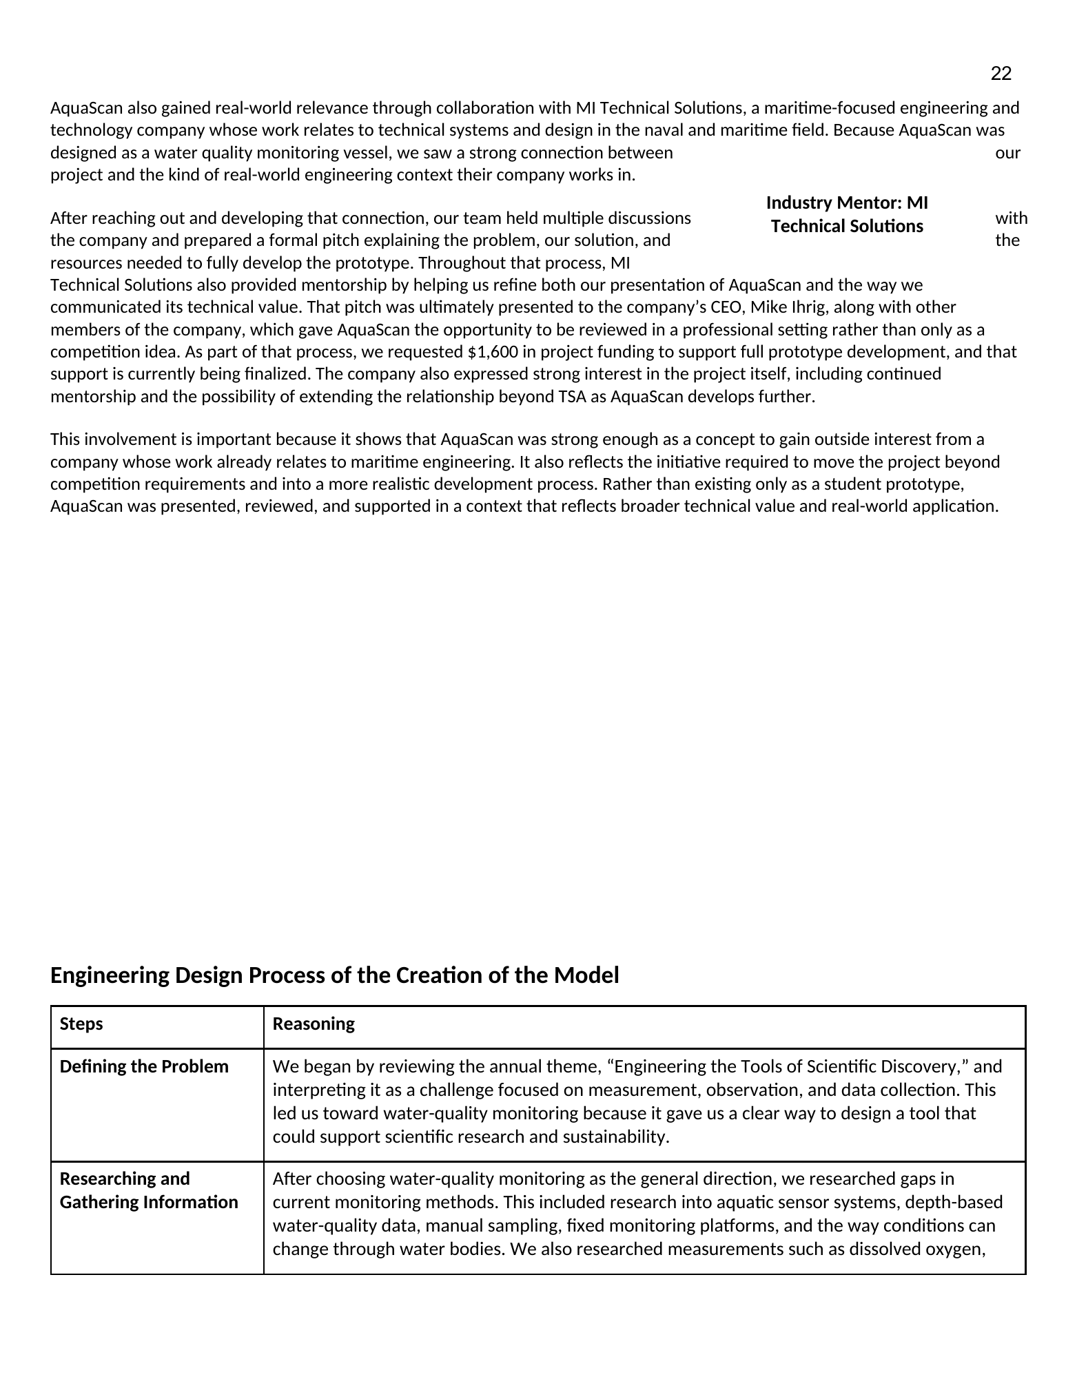
tmp/docx-render-worklog/page-23.png
