ubparot/AQUAScan/tmp/docx-render-worklog/page-24.png

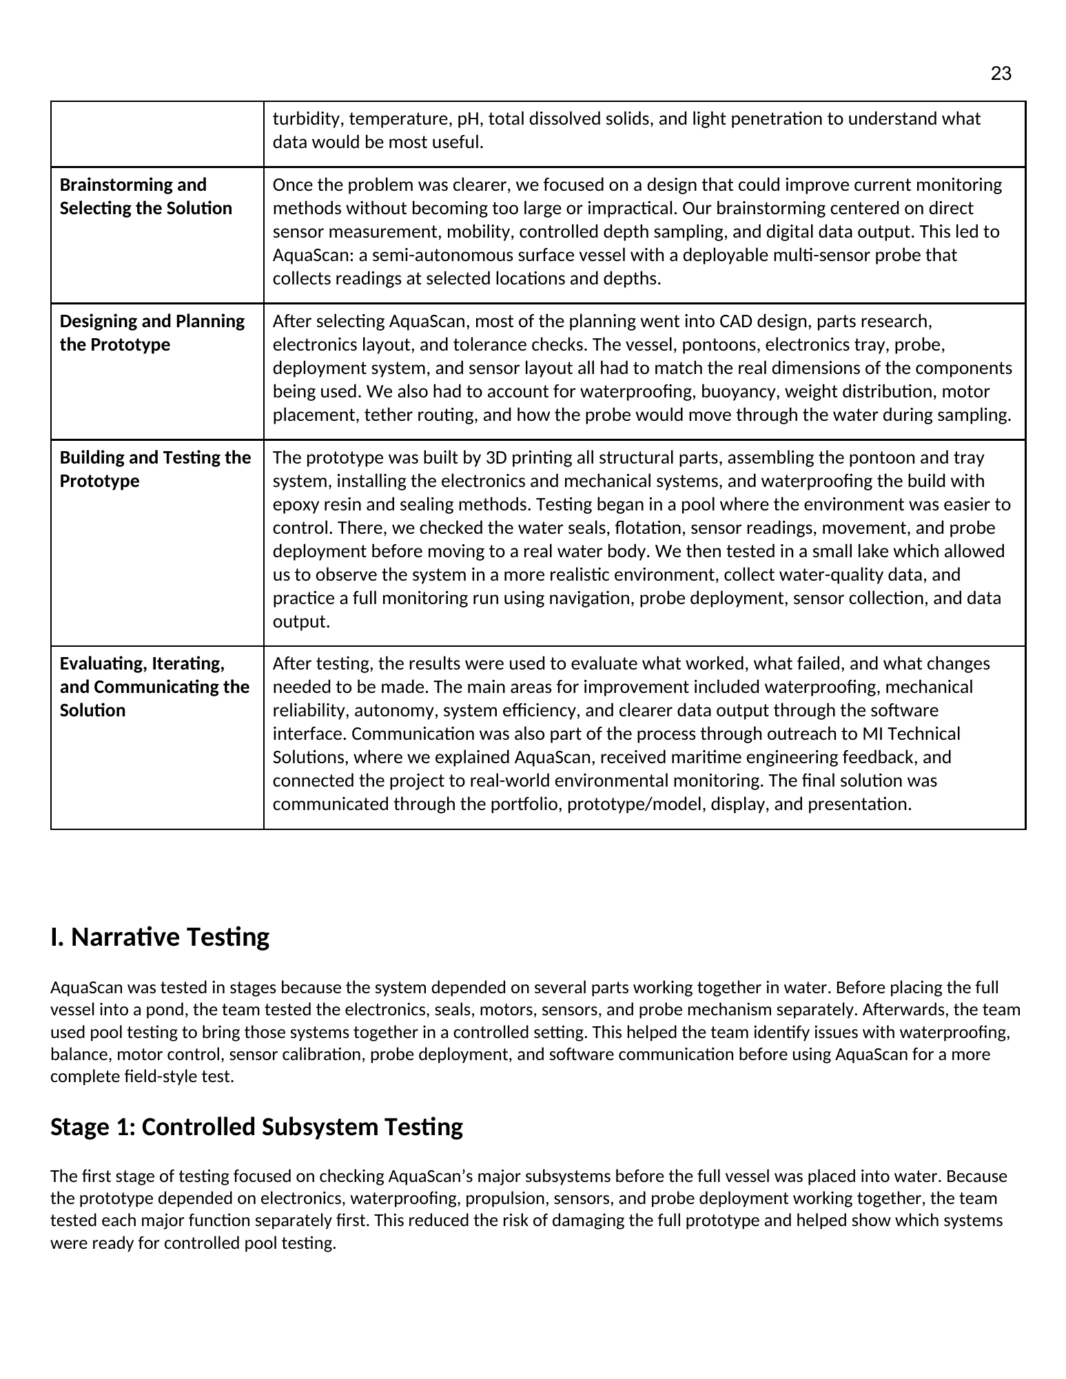
tmp/docx-render-worklog/page-24.png
