ubparot/AQUAScan/tmp/docx-render-worklog/page-25.png

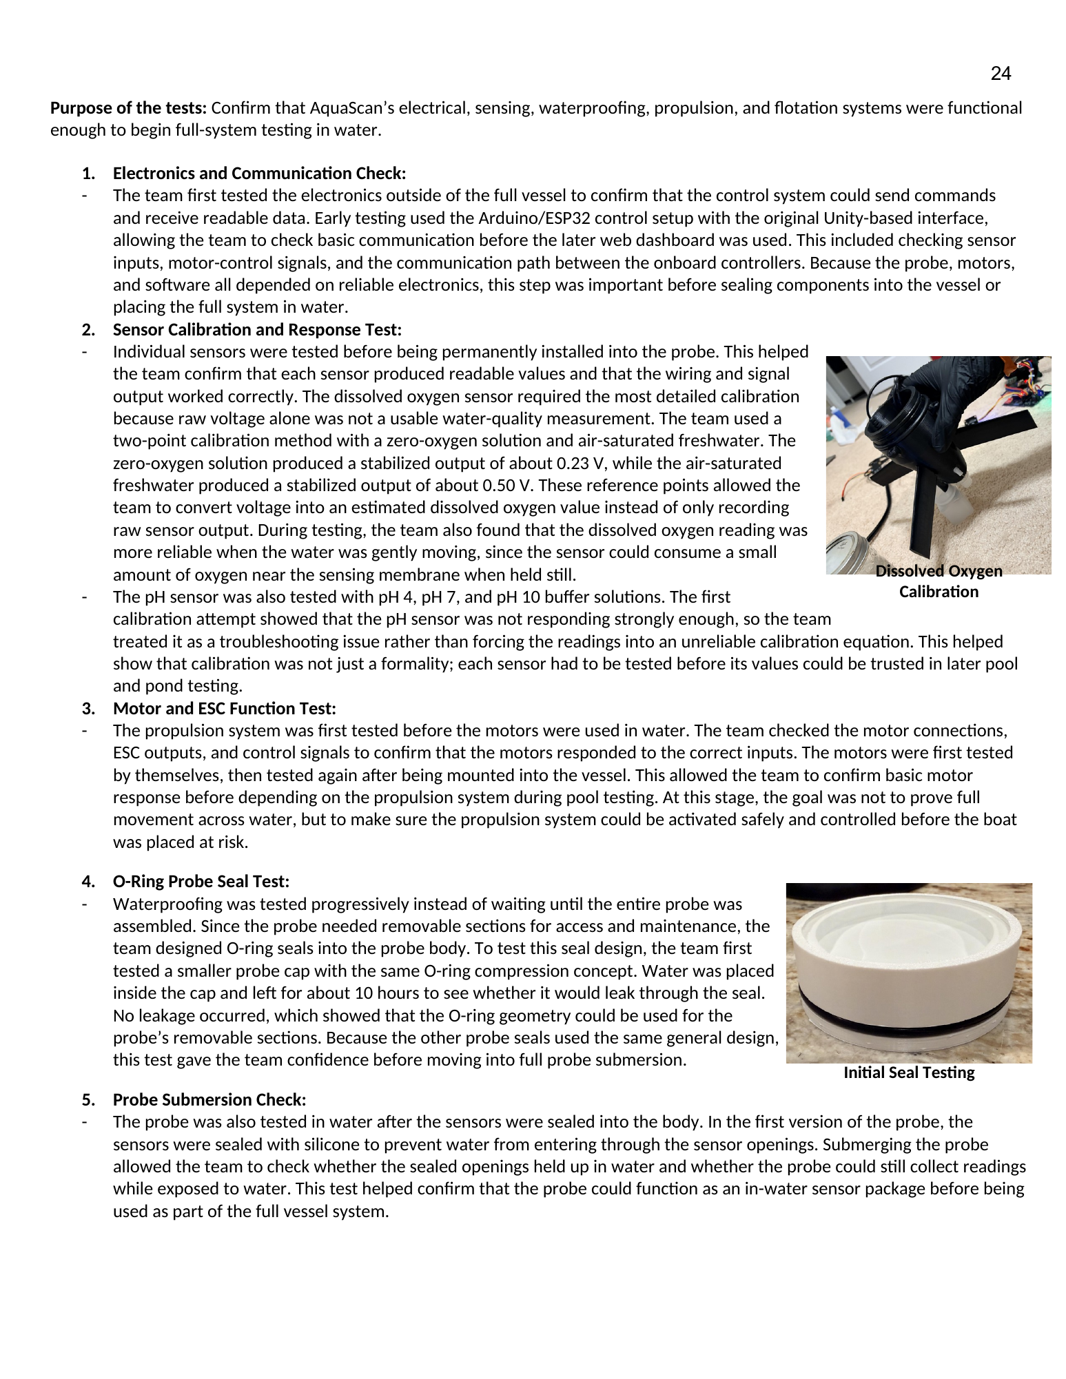
tmp/docx-render-worklog/page-25.png
