ubparot/AQUAScan/tmp/docx-render-worklog/page-26.png

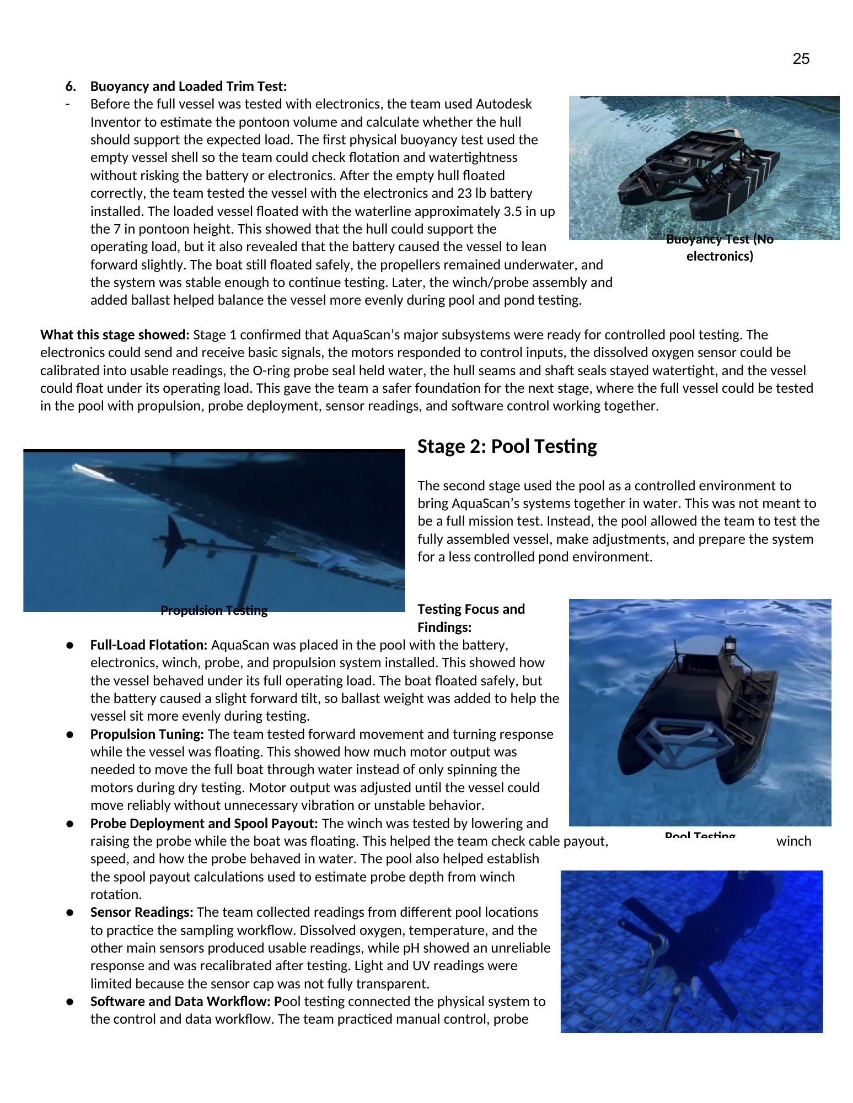
tmp/docx-render-worklog/page-26.png
