ubparot/AQUAScan/tmp/docx-render-worklog/page-27.png

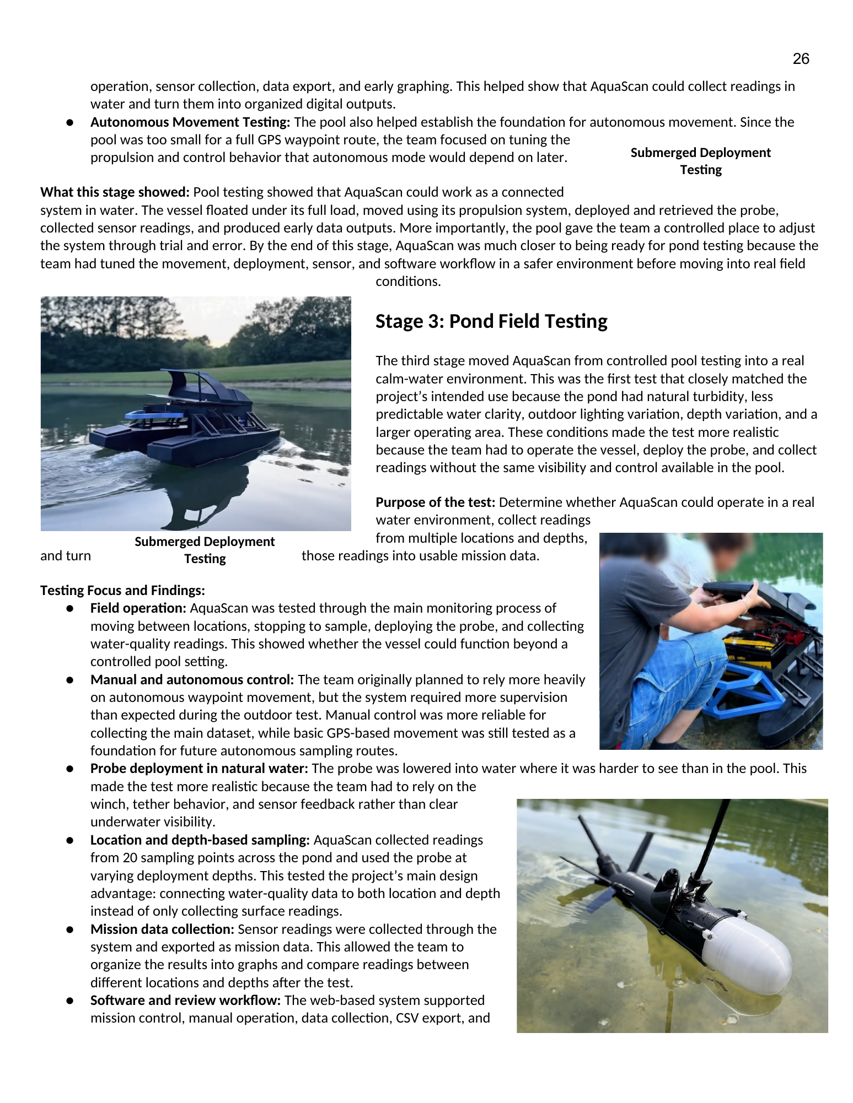
tmp/docx-render-worklog/page-27.png
