ubparot/AQUAScan/tmp/docx-render-worklog/page-28.png

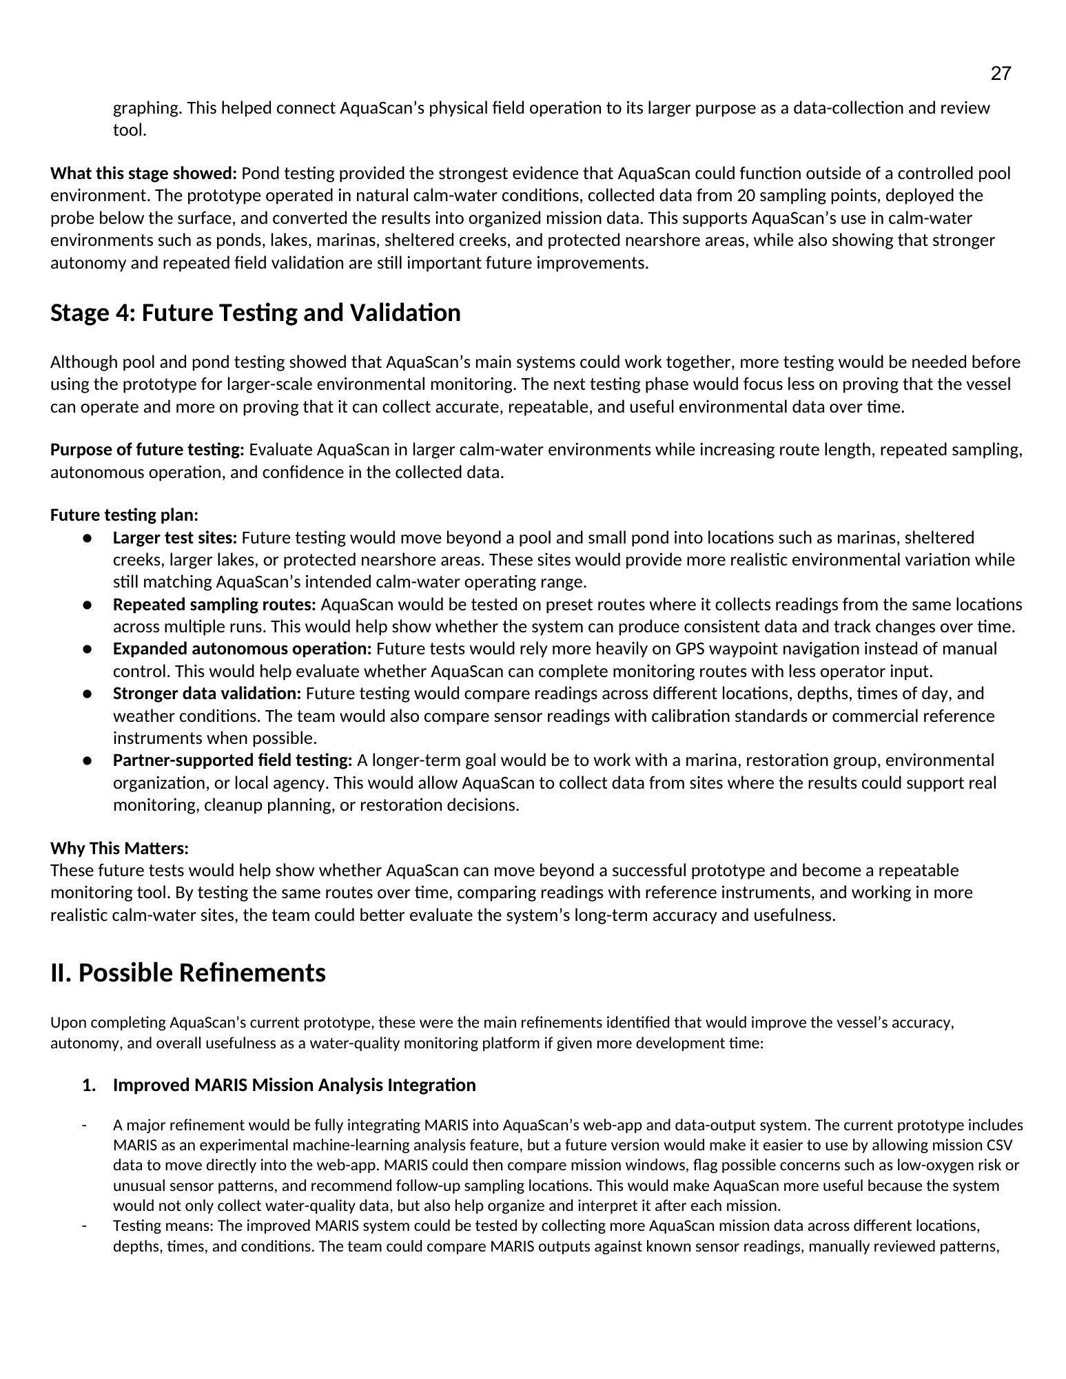
tmp/docx-render-worklog/page-28.png
