ubparot/AQUAScan/tmp/docx-render-worklog/page-29.png

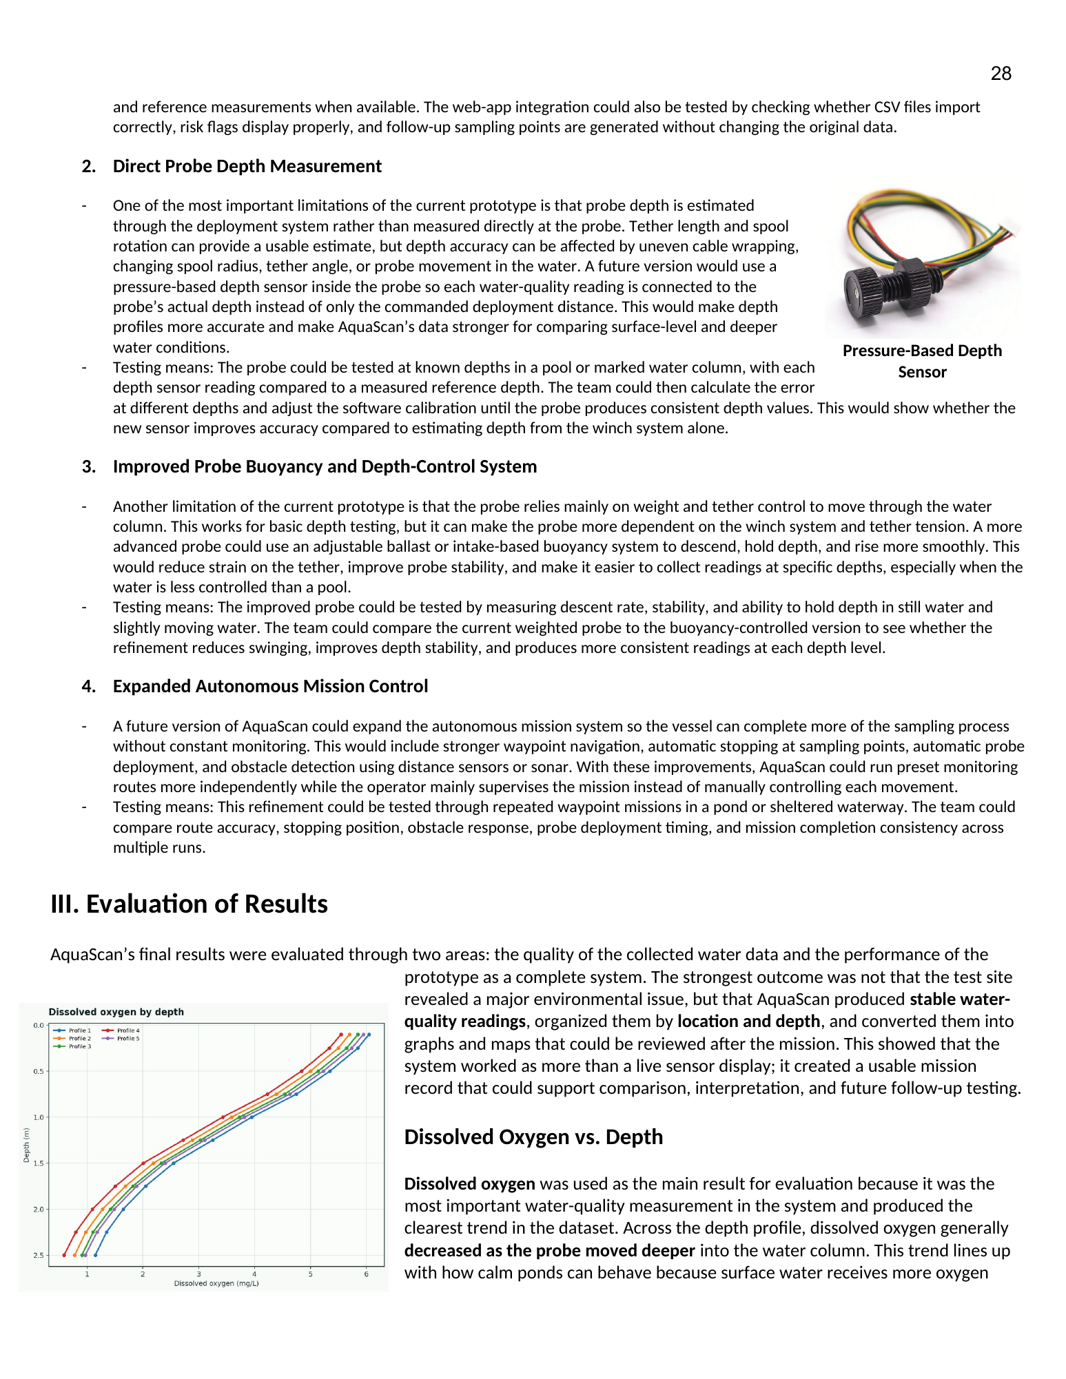
tmp/docx-render-worklog/page-29.png
