ubparot/AQUAScan/tmp/docx-render-worklog/page-30.png

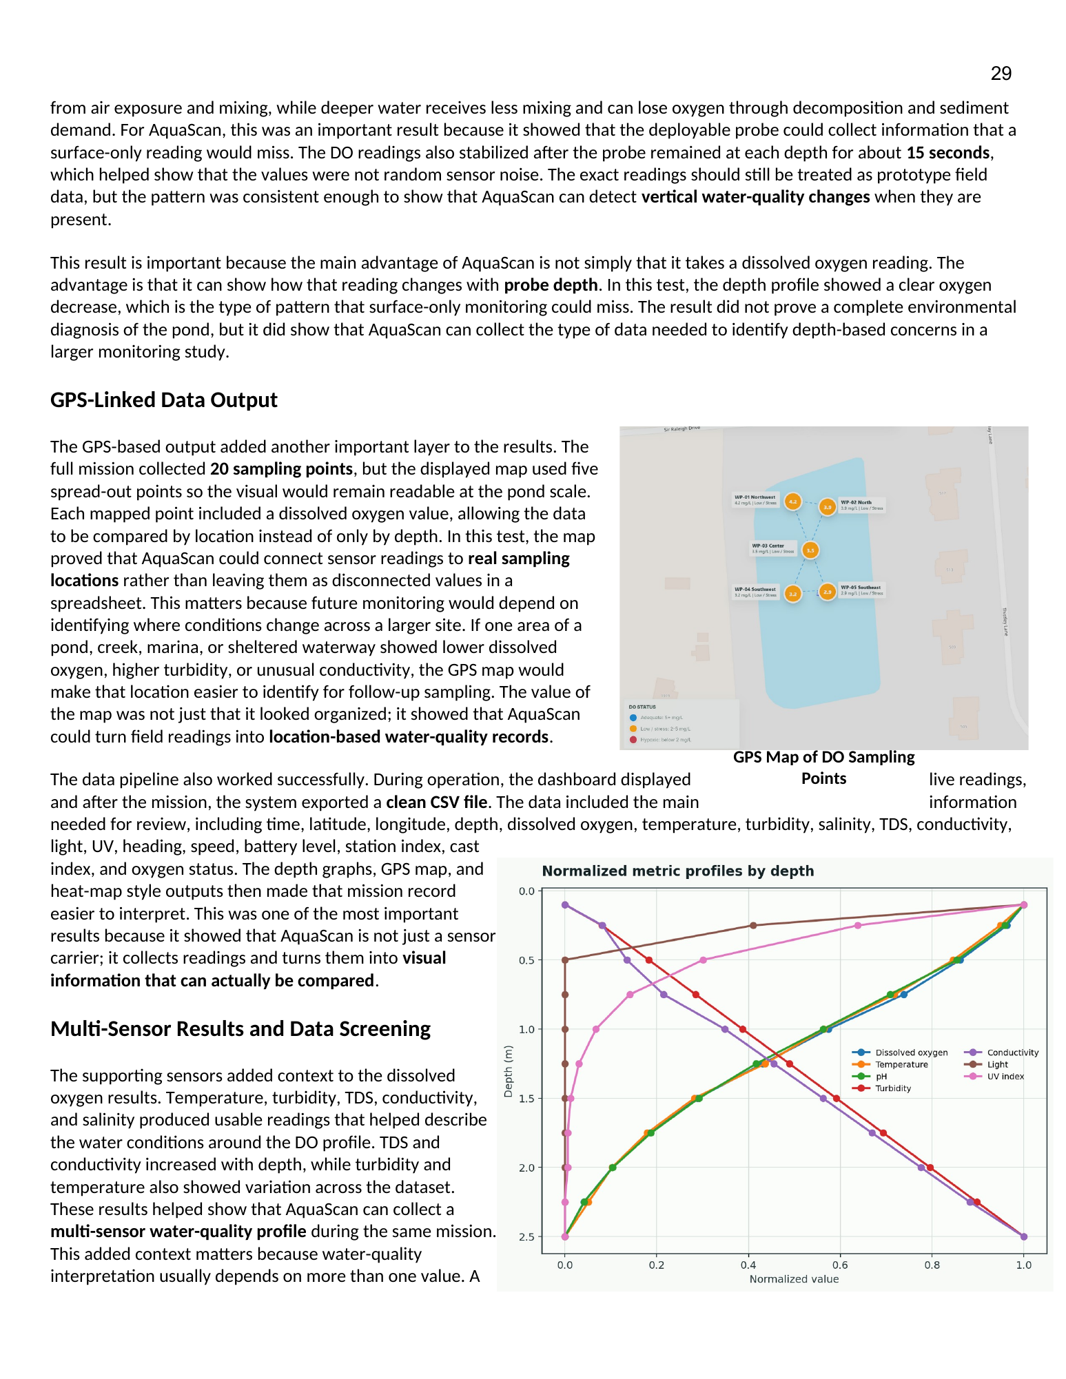
tmp/docx-render-worklog/page-30.png
