ubparot/AQUAScan/tmp/docx-render-worklog/page-31.png

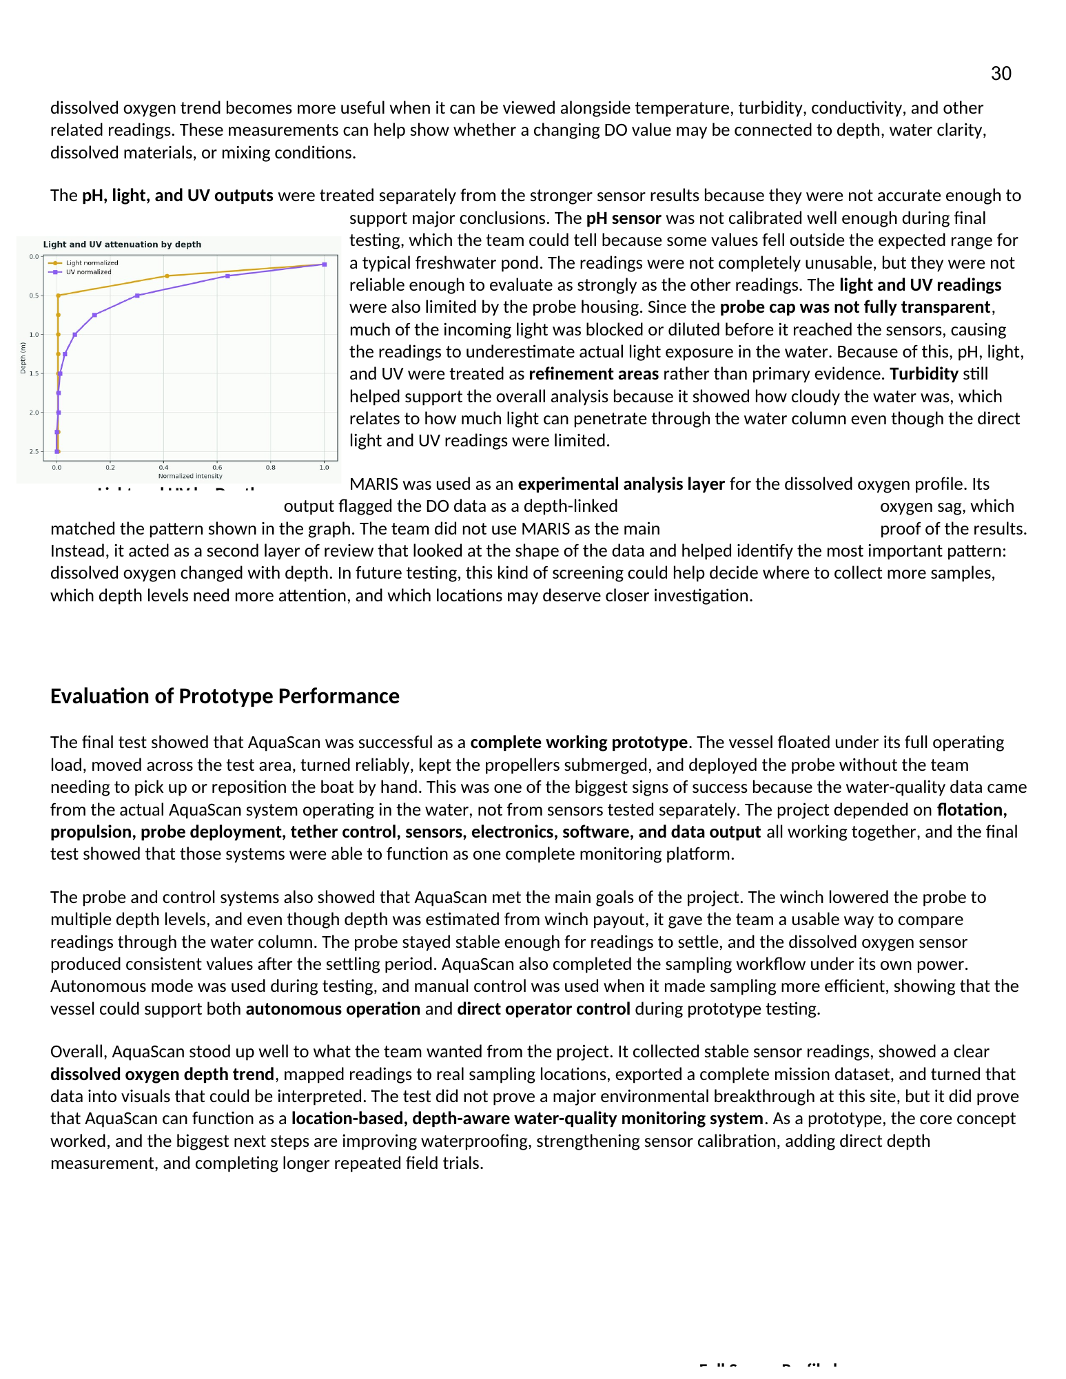
tmp/docx-render-worklog/page-31.png
