ubparot/AQUAScan/tmp/docx-render-worklog/page-32.png

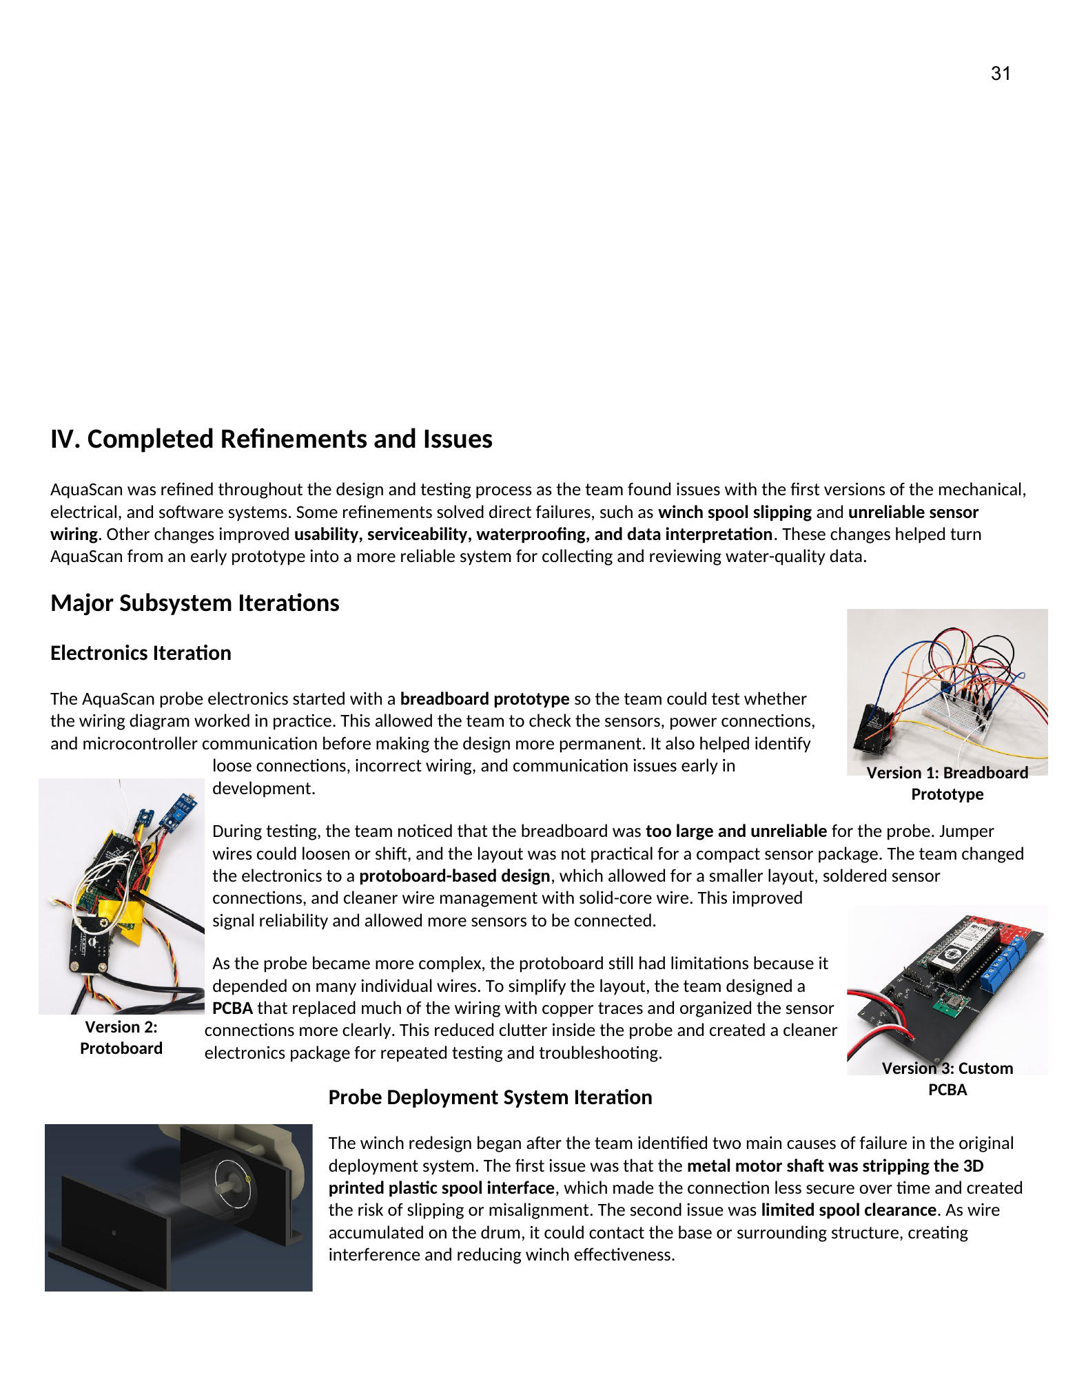
tmp/docx-render-worklog/page-32.png
