ubparot/AQUAScan/tmp/docx-render-worklog/page-33.png

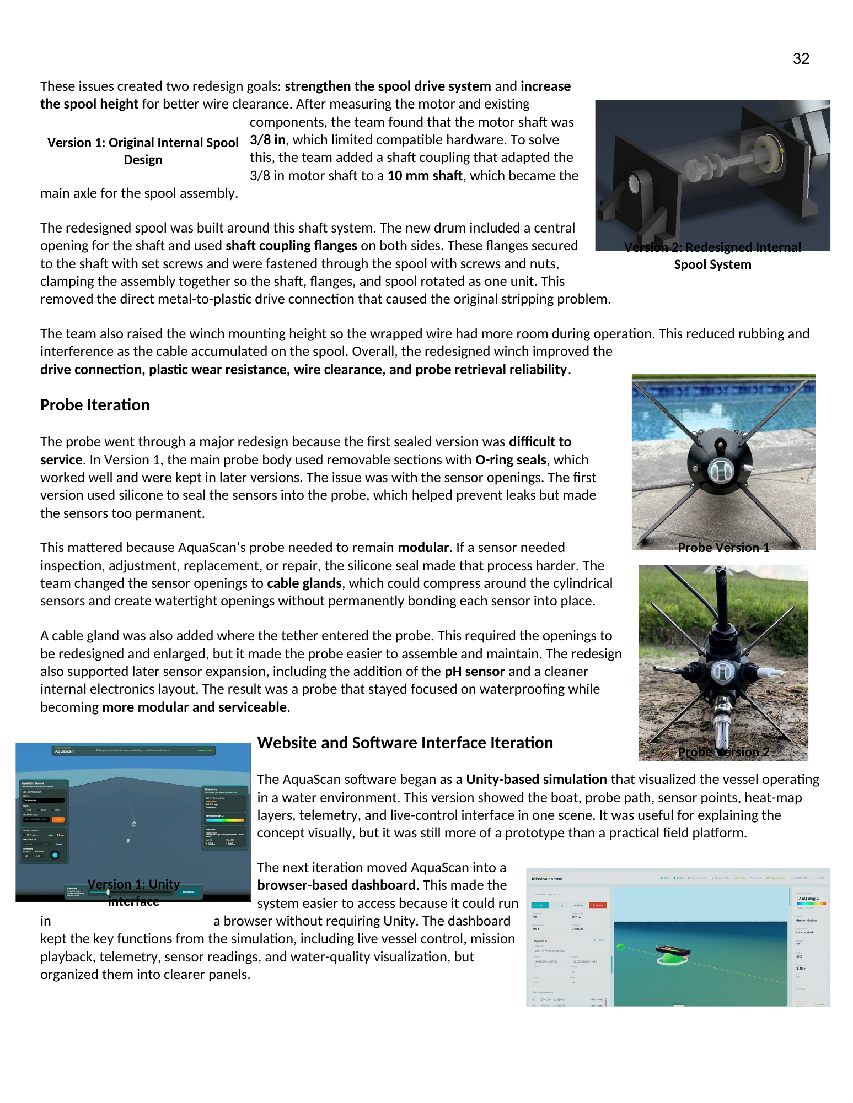
tmp/docx-render-worklog/page-33.png
