ubparot/AQUAScan/tmp/docx-render-worklog/page-34.png

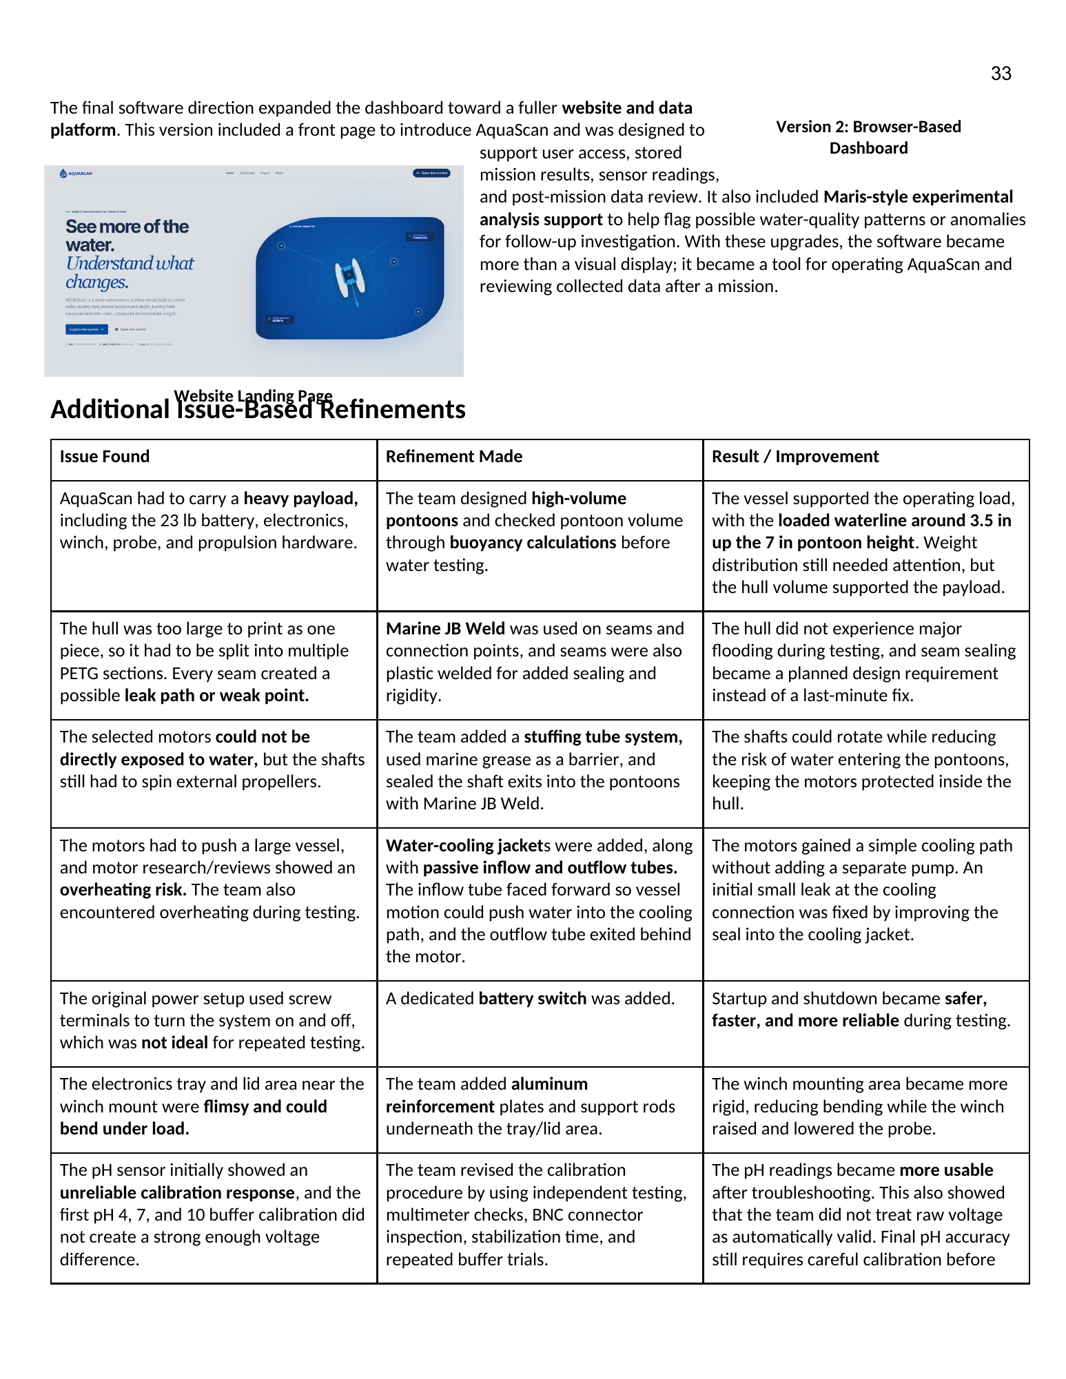
tmp/docx-render-worklog/page-34.png
