ubparot/AQUAScan/tmp/docx-render-worklog/page-35.png

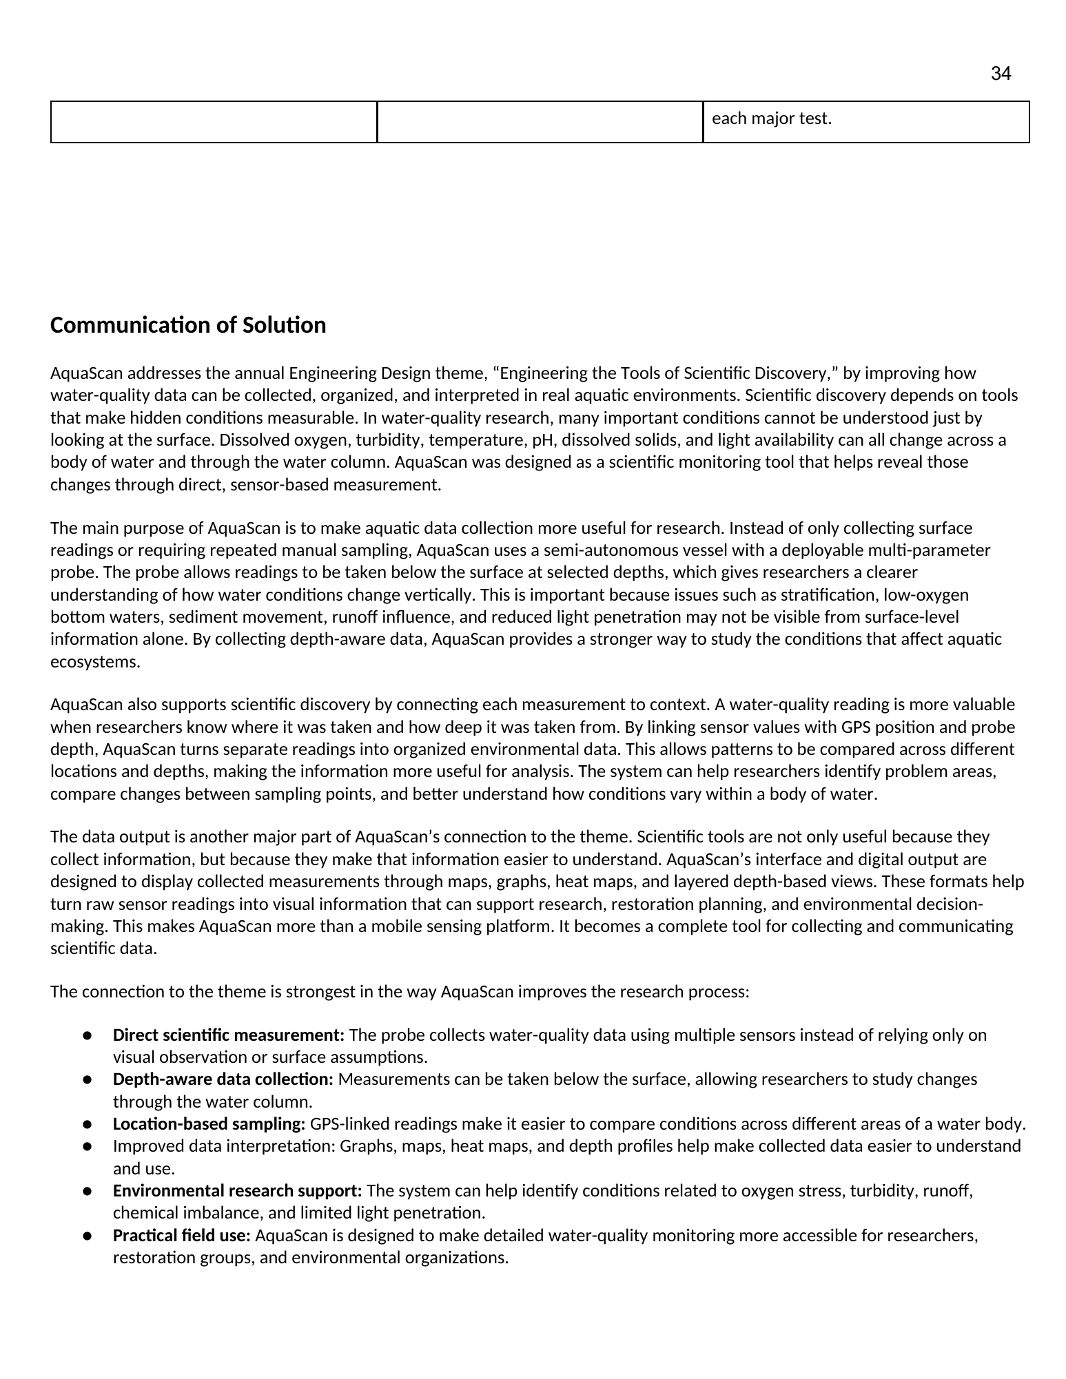
tmp/docx-render-worklog/page-35.png
