ubparot/AQUAScan/tmp/docx-render-worklog/page-36.png

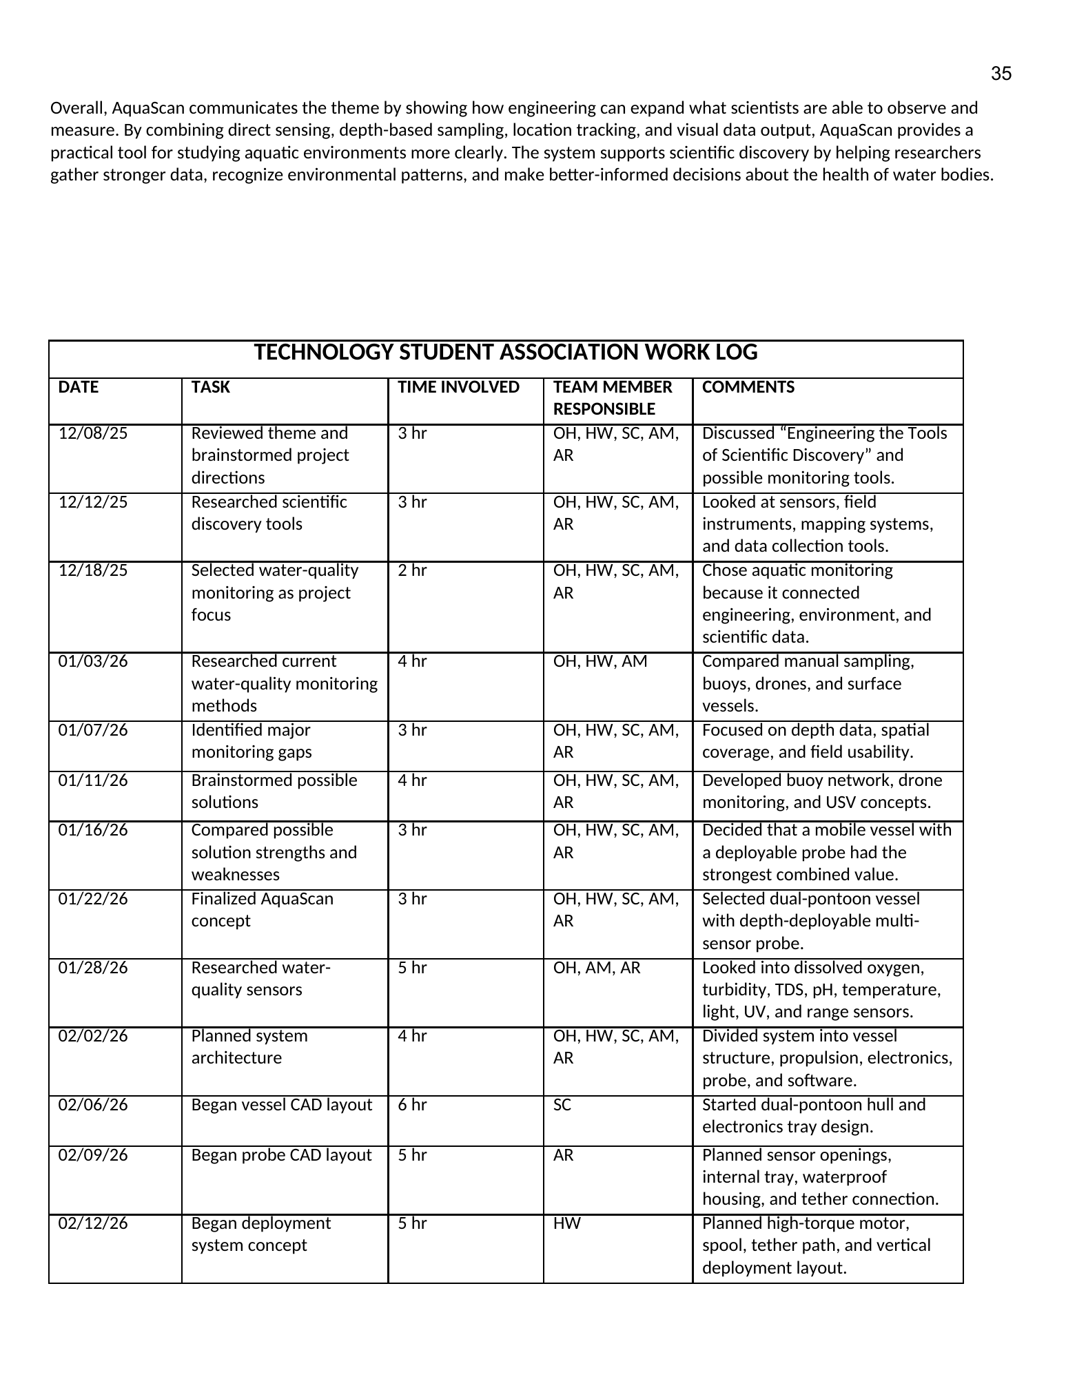
tmp/docx-render-worklog/page-36.png
