ubparot/AQUAScan/tmp/docx-render-worklog/page-37.png

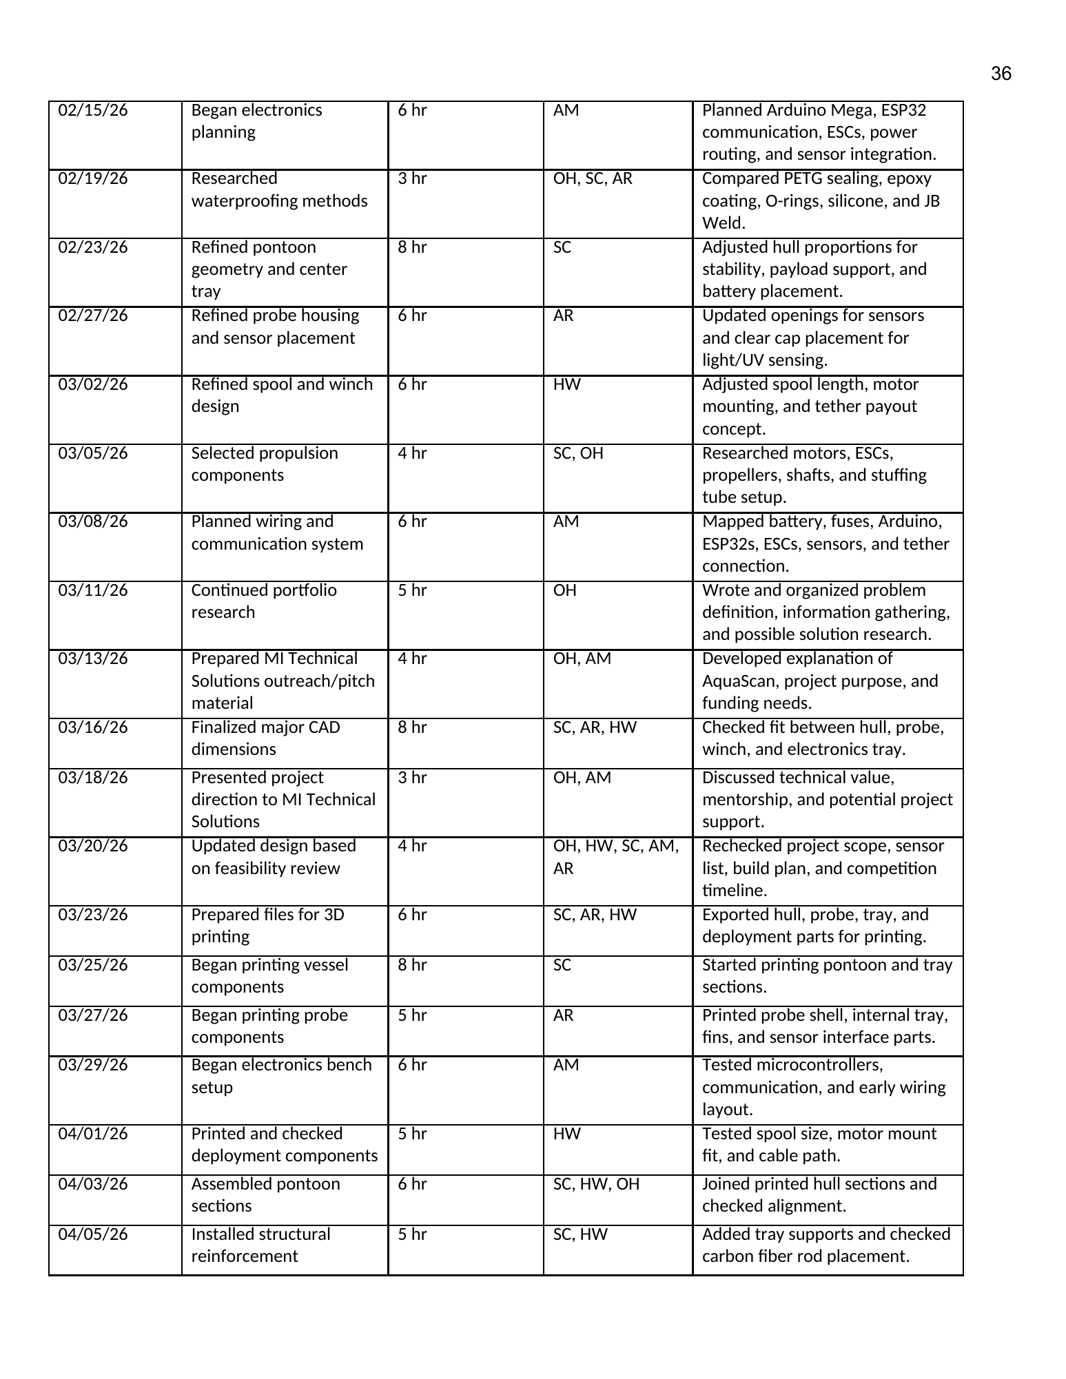
tmp/docx-render-worklog/page-37.png
