ubparot/AQUAScan/tmp/docx-render-worklog/page-38.png

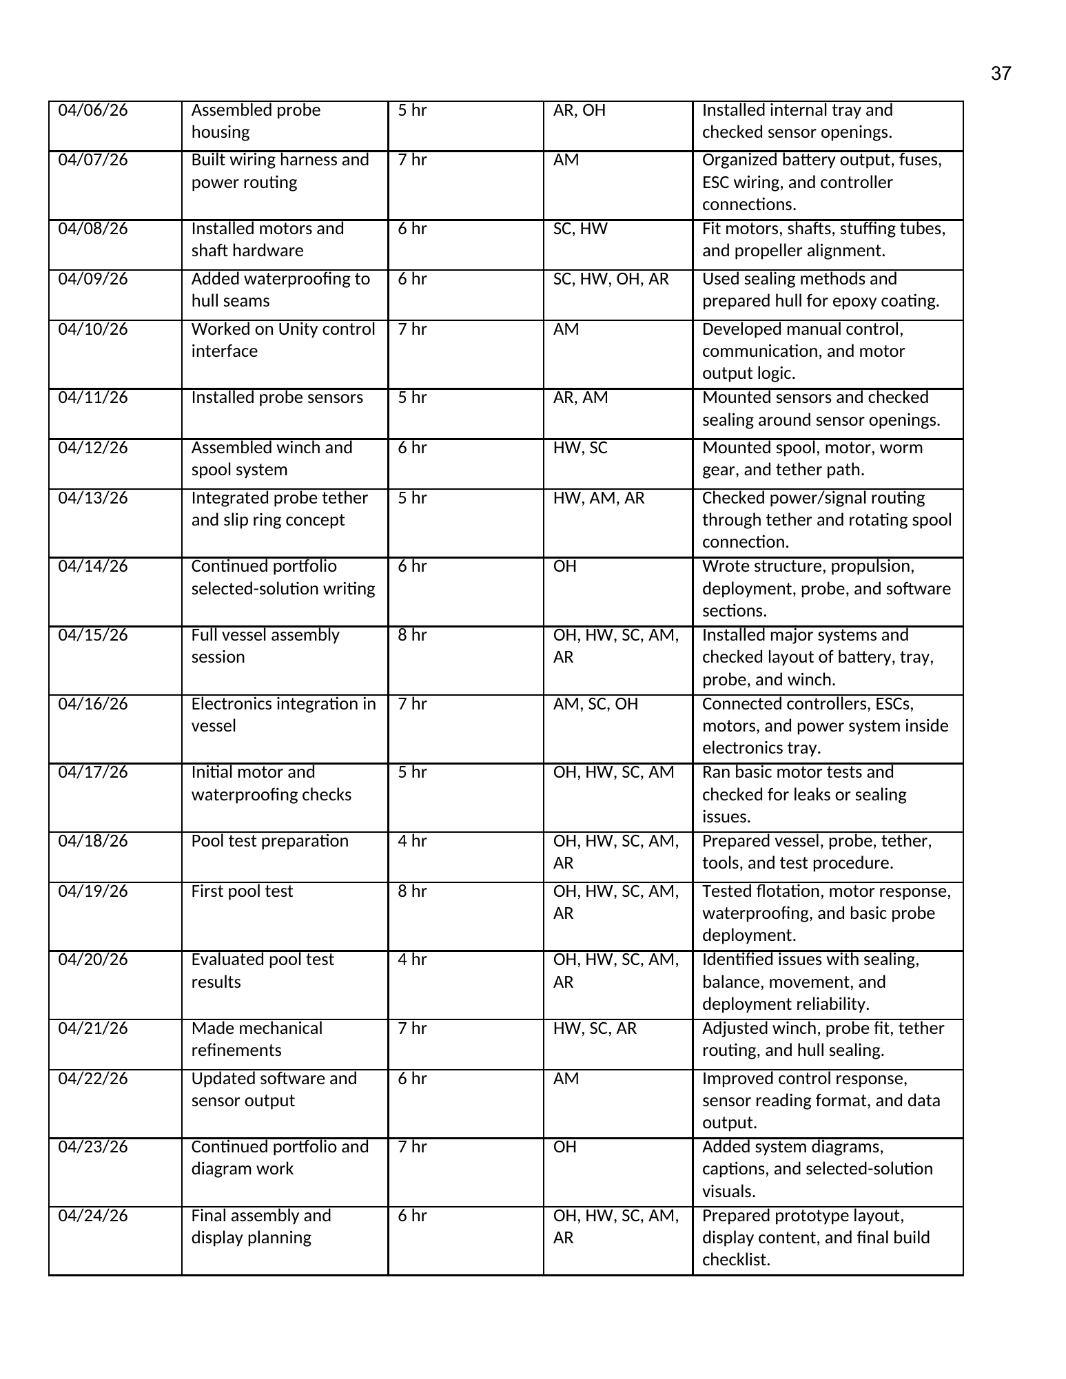
tmp/docx-render-worklog/page-38.png
