ubparot/AQUAScan/tmp/docx-render-worklog/page-39.png

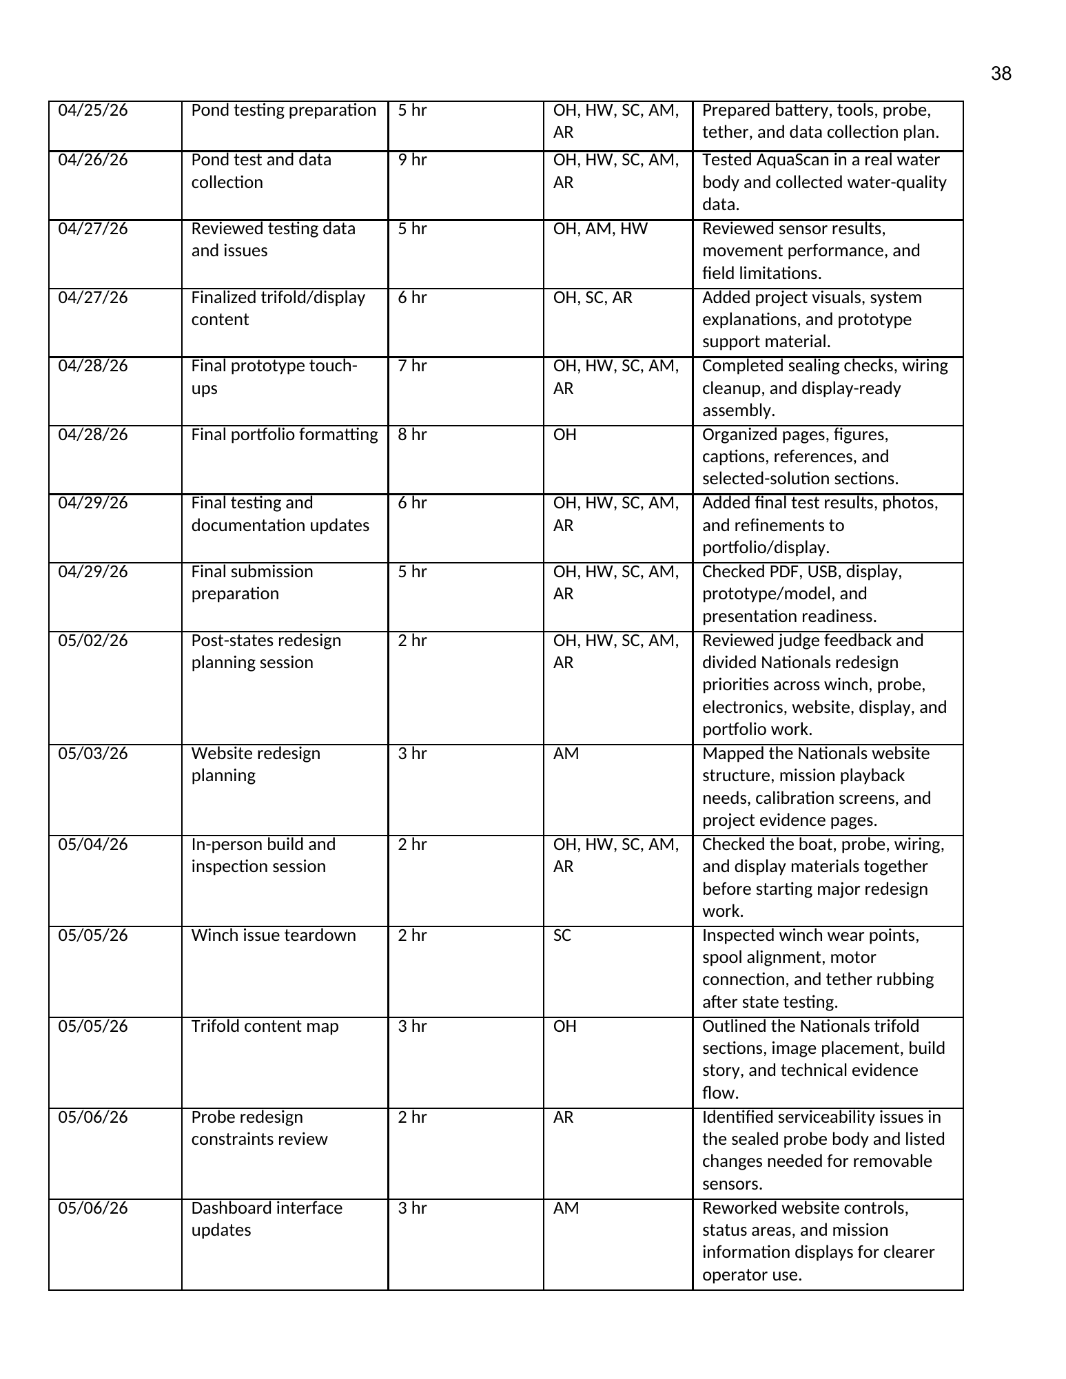
tmp/docx-render-worklog/page-39.png
