ubparot/AQUAScan/tmp/docx-render-worklog/page-40.png

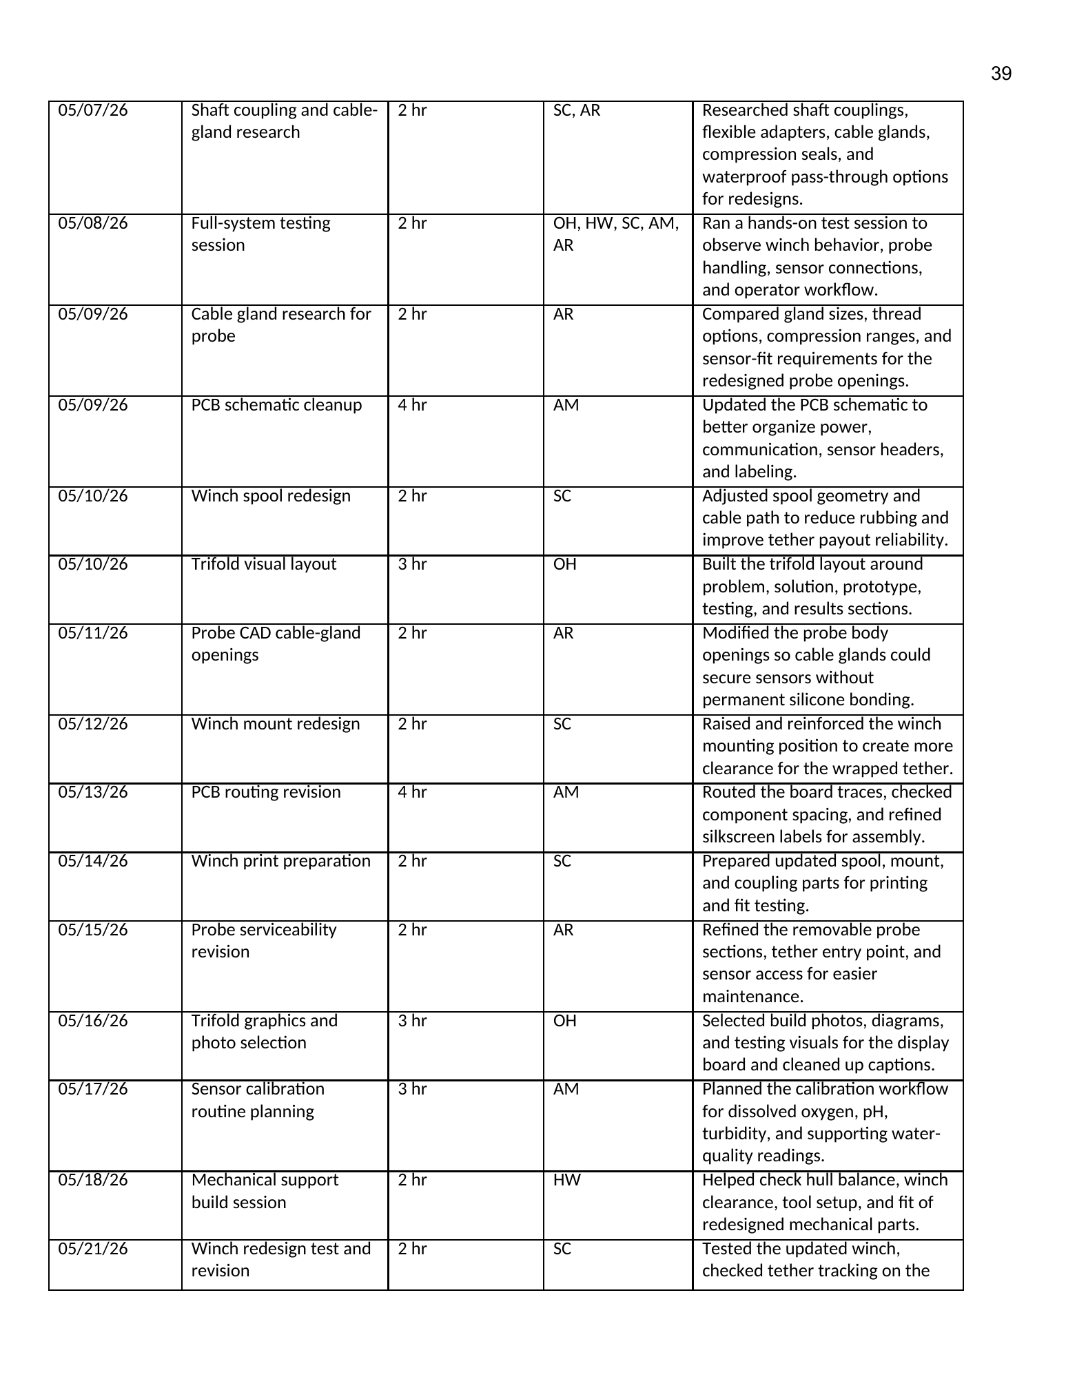
tmp/docx-render-worklog/page-40.png
