ubparot/AQUAScan/tmp/docx-render-worklog/page-41.png

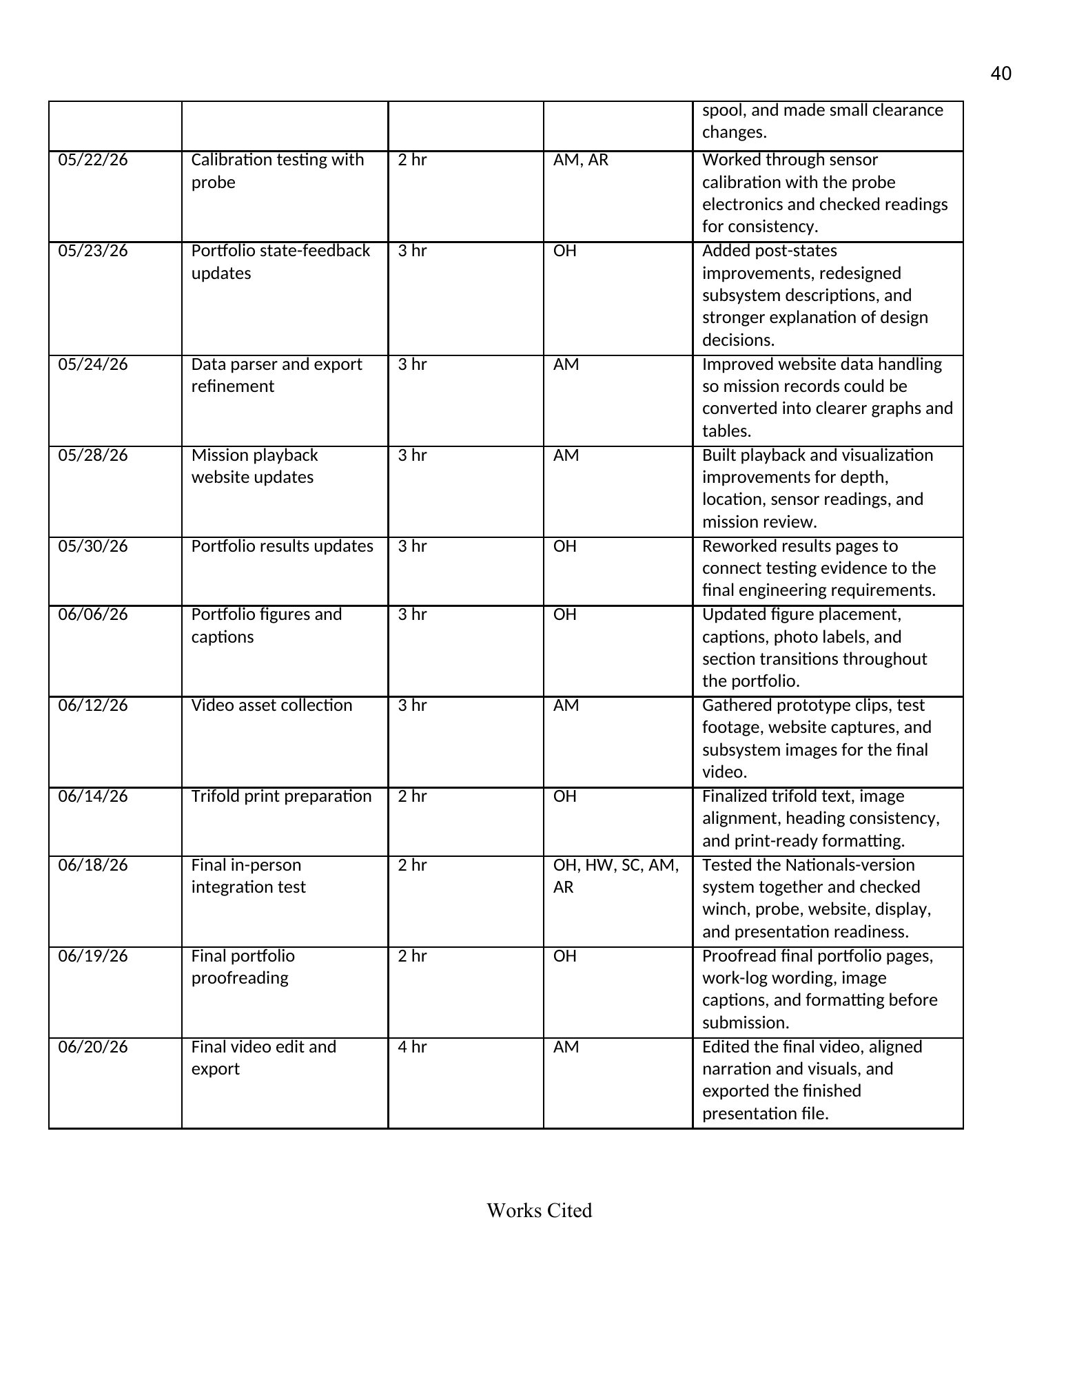
tmp/docx-render-worklog/page-41.png
