ubparot/AQUAScan/tmp/docx-render-worklog/page-42.png

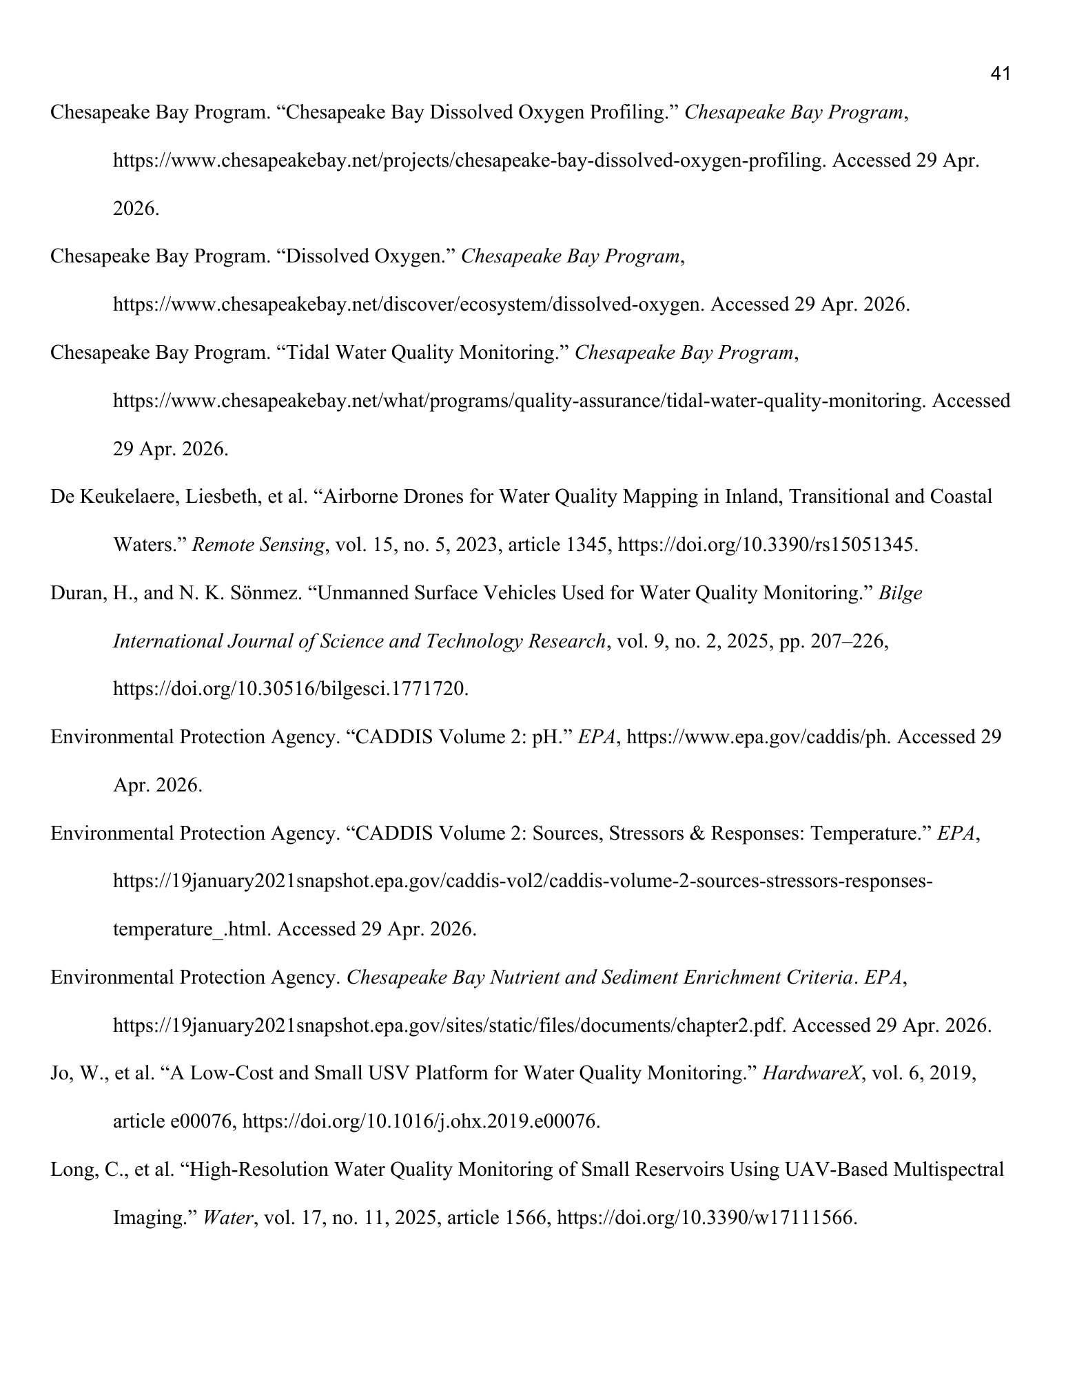
tmp/docx-render-worklog/page-42.png
