ubparot/AQUAScan/tmp/docx-render-worklog/page-43.png

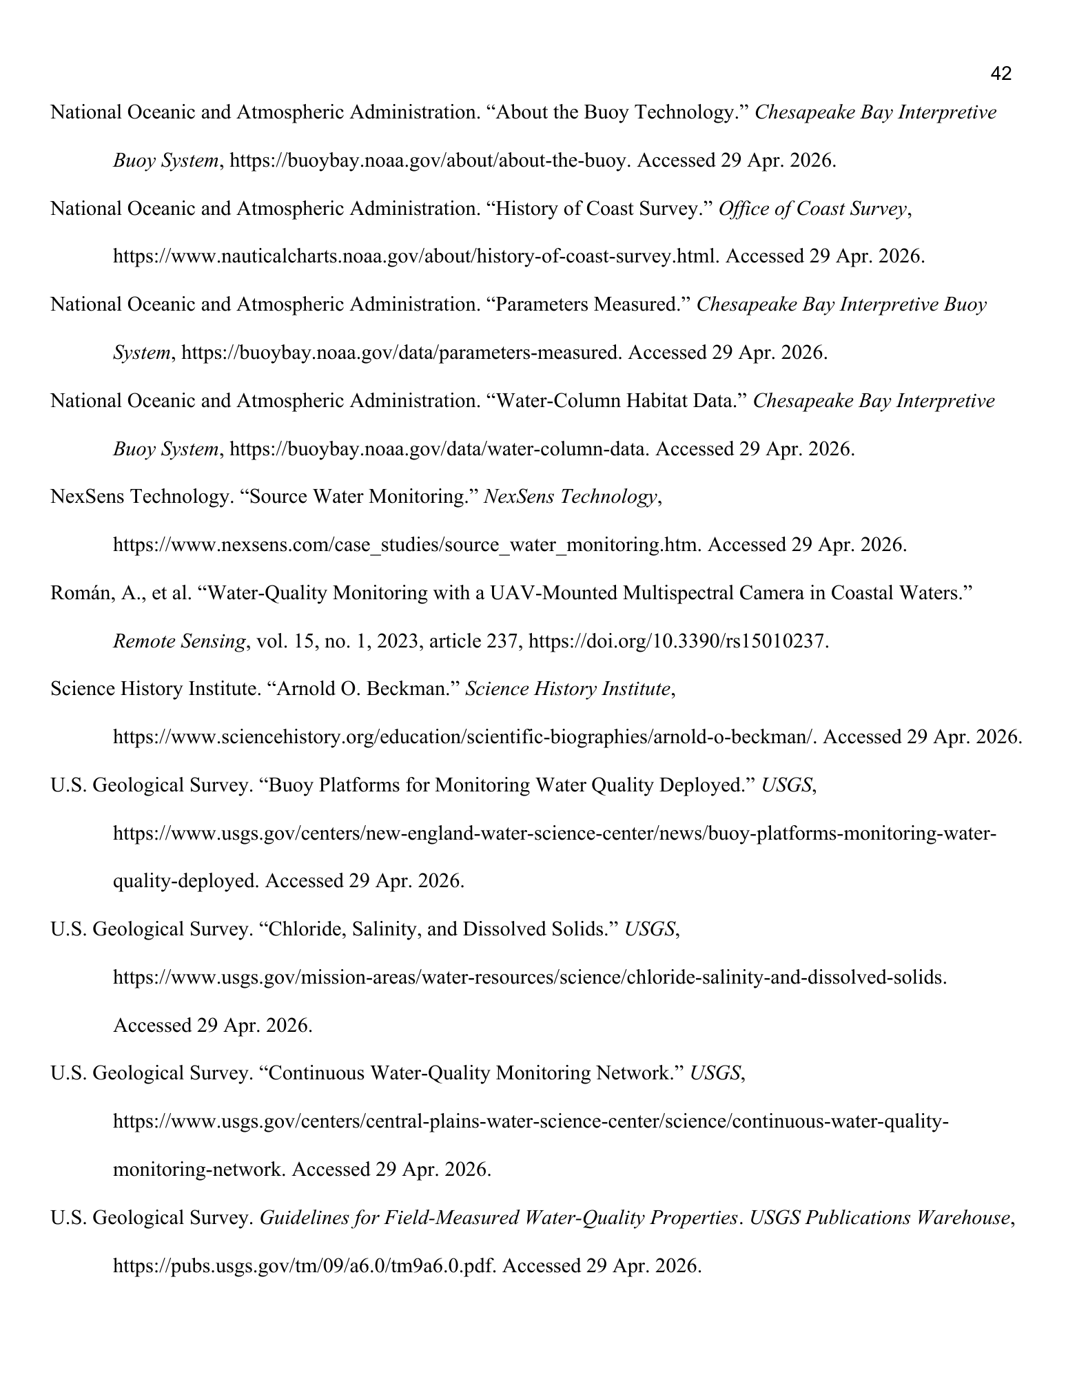
tmp/docx-render-worklog/page-43.png
