ubparot/AQUAScan/tmp/docx-render-worklog/page-44.png

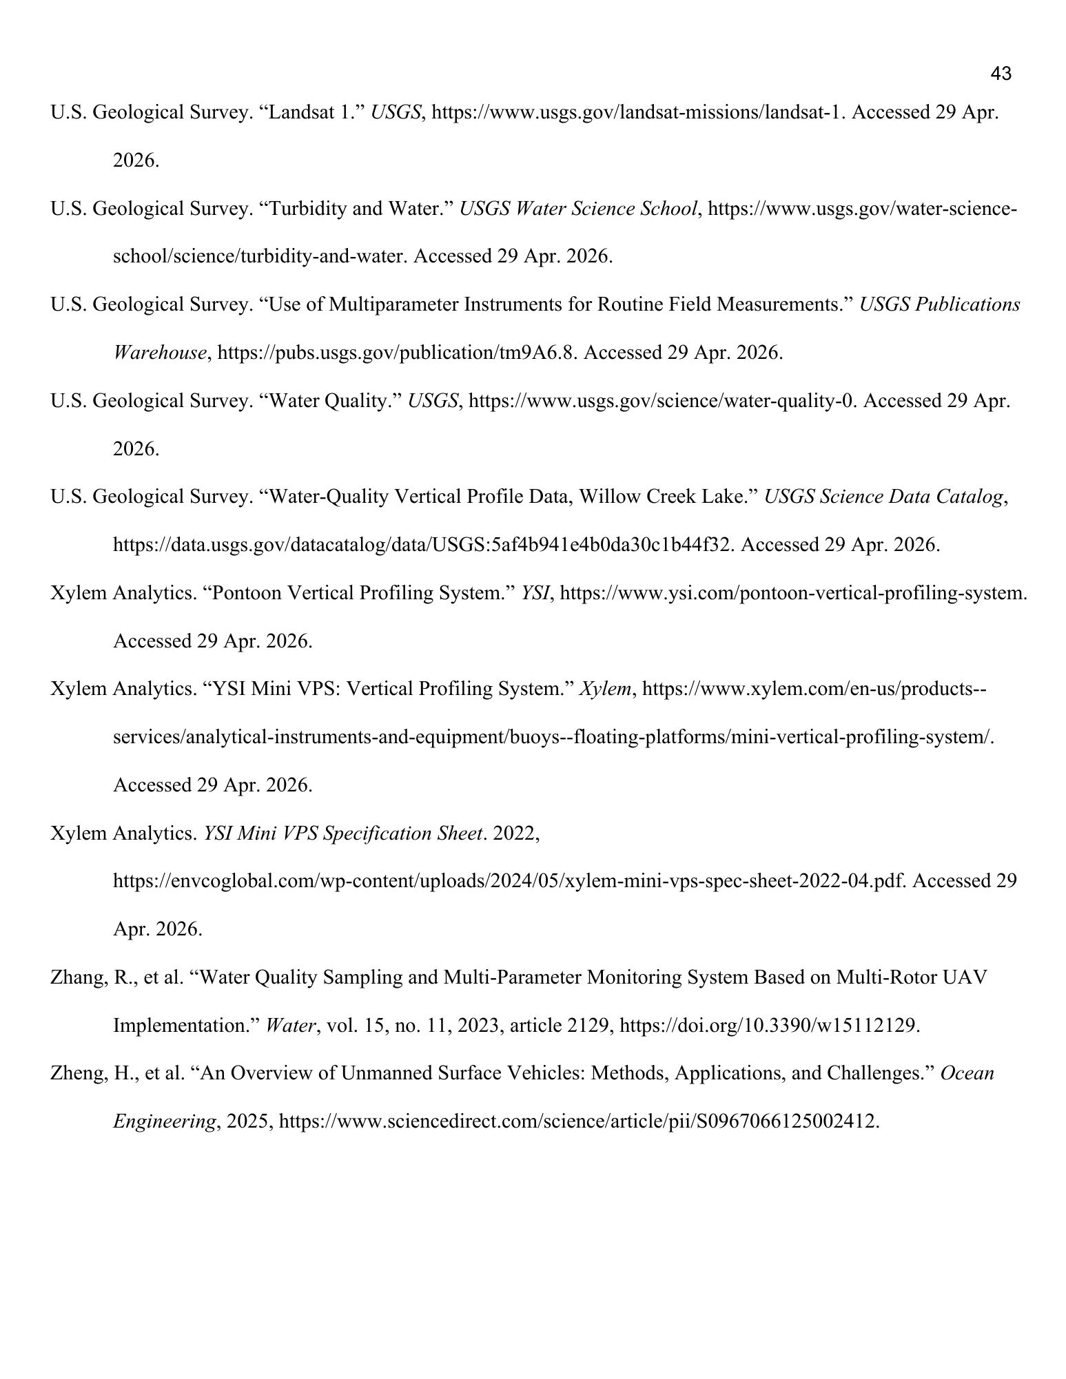
tmp/docx-render-worklog/page-44.png
