ubparot/AQUAScan/tmp/docx-render-worklog/page-45.png

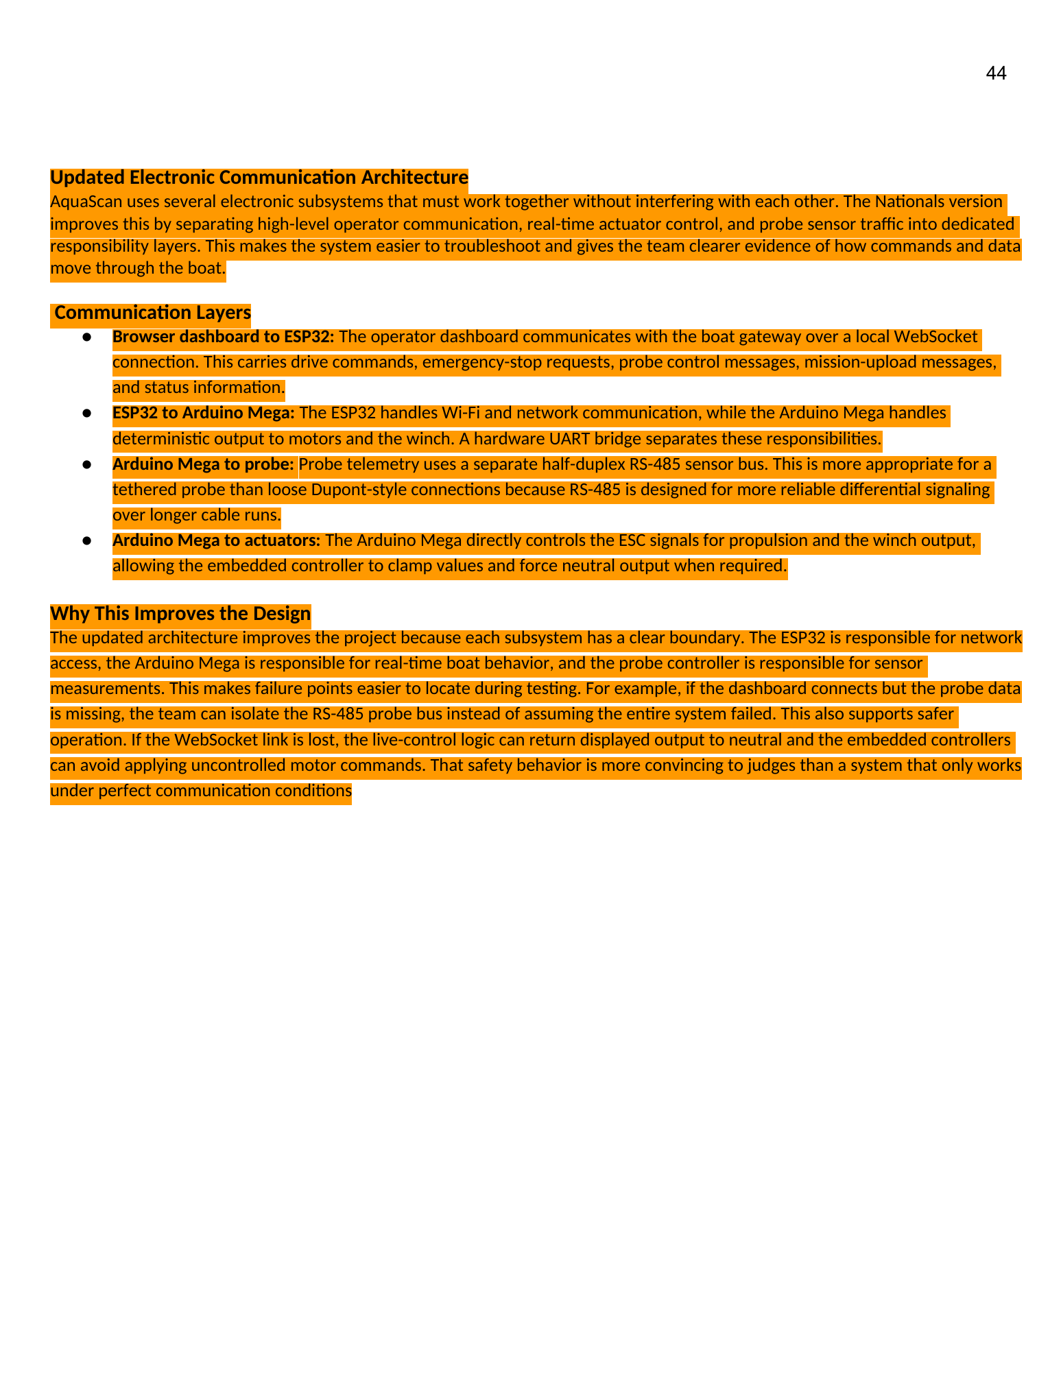
tmp/docx-render-worklog/page-45.png
