ubparot/AQUAScan/tmp/pdfs/updated-worklog-page-43.png

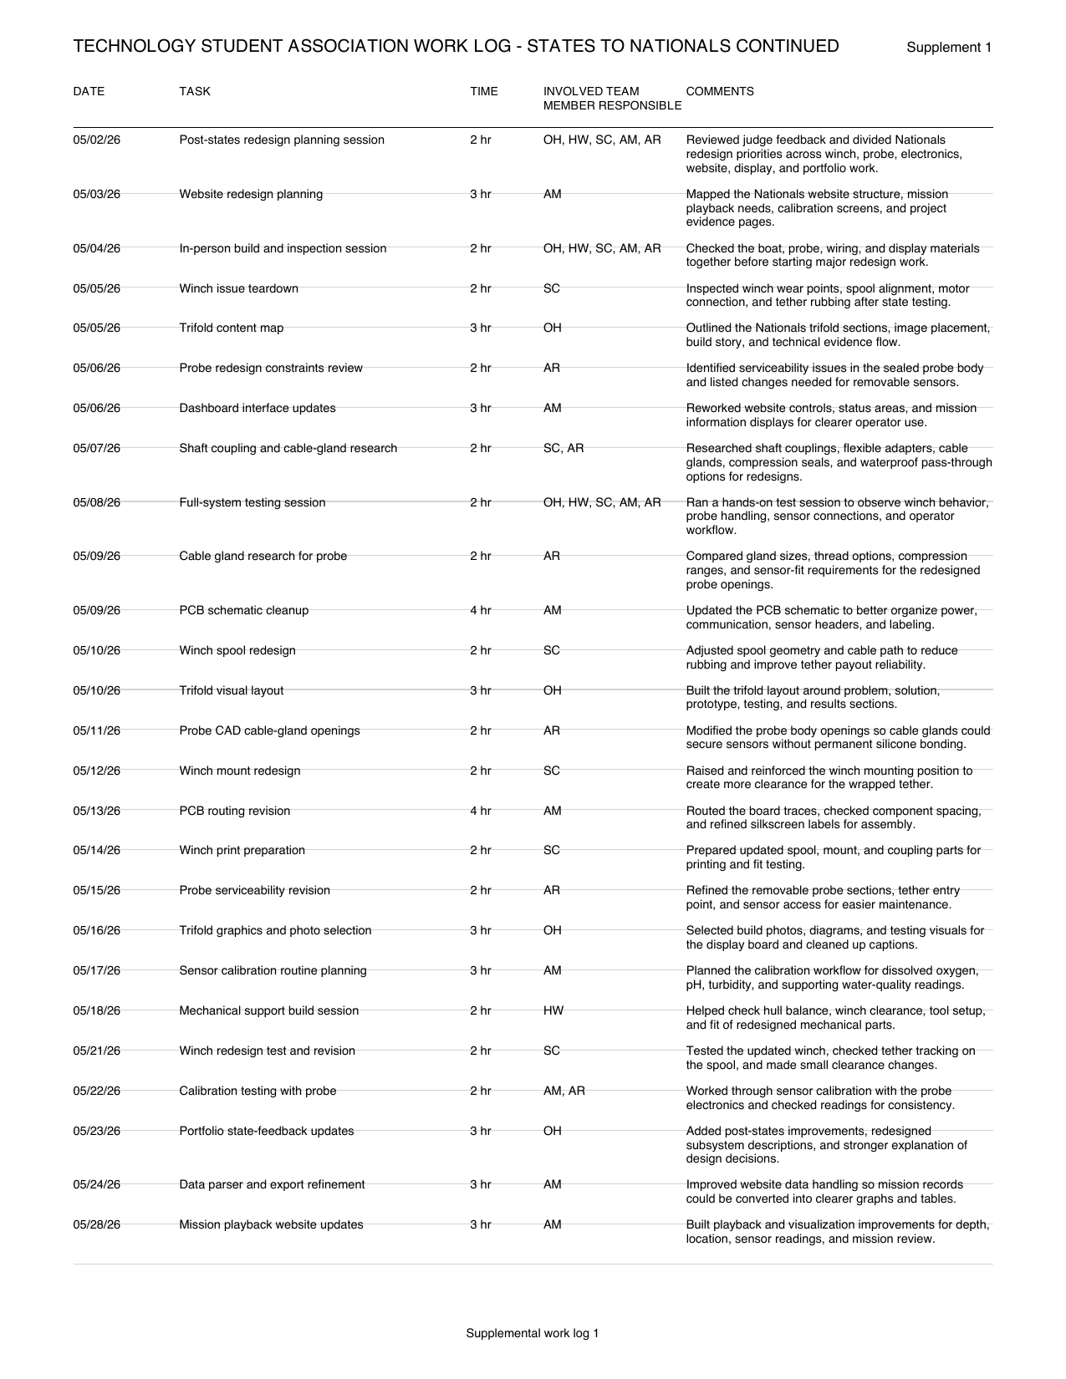
tmp/pdfs/updated-worklog-page-43.png
