ubparot/AQUAScan/tmp/pdfs/updated-worklog-page-44.png

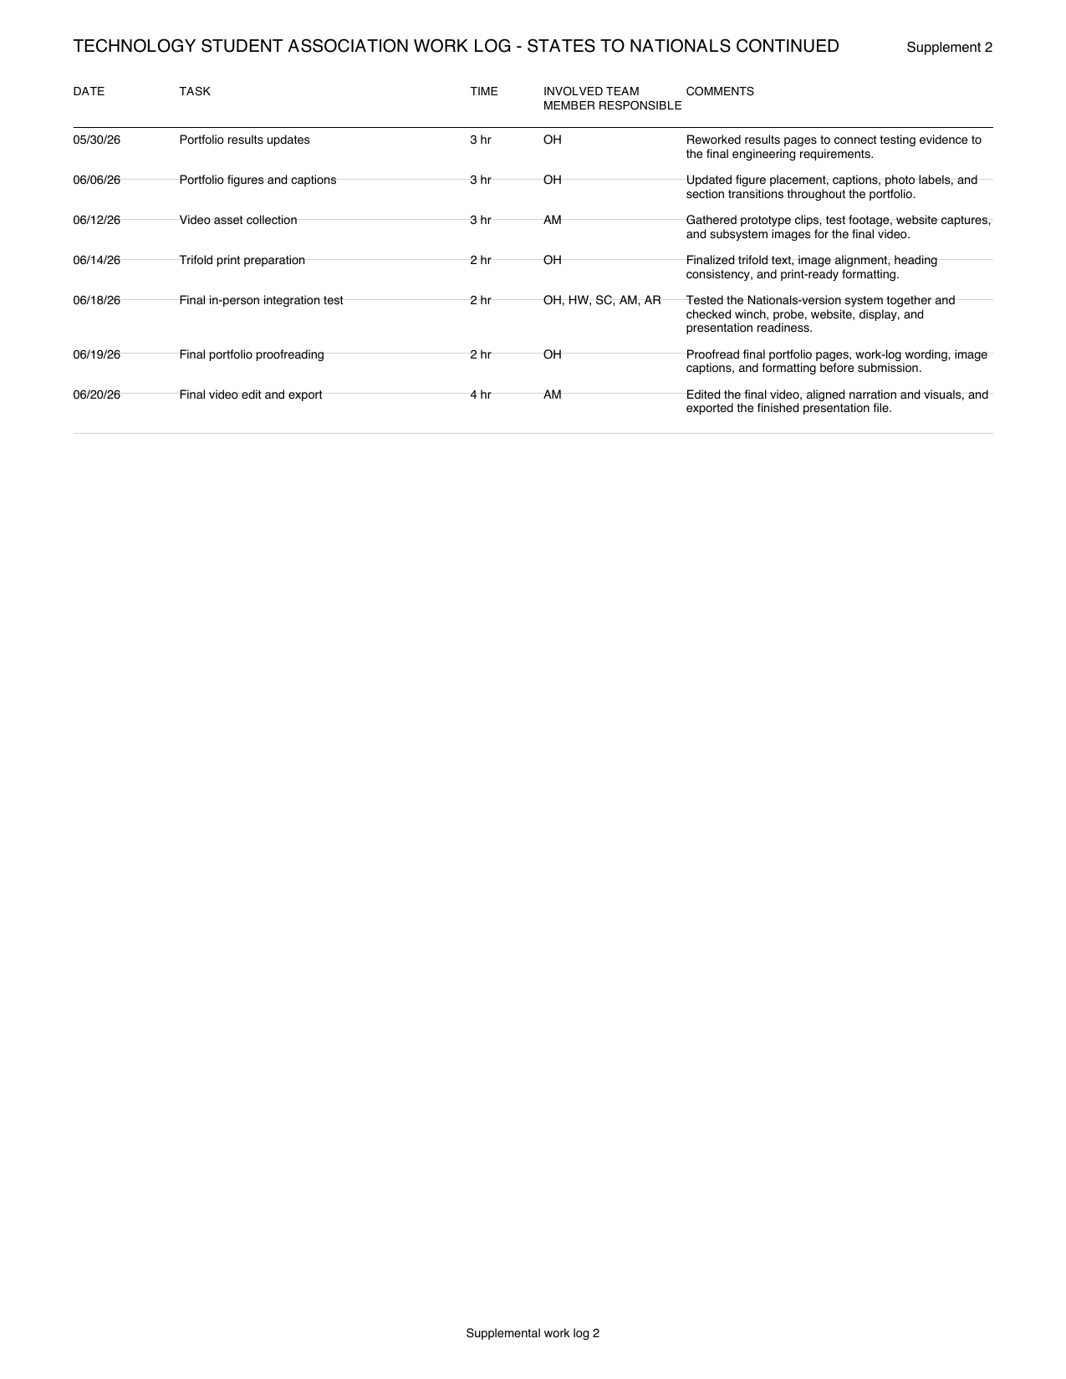
tmp/pdfs/updated-worklog-page-44.png
