ubparot/AQUAScan/(commit log)

2025-12-23 Add Alstra Infinite LowPoly Boats asset pack
    Added new folder 'Alstra Infinite' containing LowPoly Boats asset pack, including models, materials, textures, prefabs, and a showcase scene. Also added supporting scripts, documentation, and demo mission files for integration and visualization.
    [demo-mission.csv]
2025-12-23 Improve heatmap mesh blending and water visuals
    Enhanced the HeatmapSurface mesh generation to provide smoother blending at data edges and improved edge feathering. Updated the StylizedWater shader for better heatmap visibility and water appearance. Adjusted material and URP settings to support new visual features. Added a new Unity scene file.
2025-12-23 Add orbit camera and improve heatmap visualization
    Introduces CameraBoatOrbit for orbit/zoom camera control around the boat marker. Refactors HeatmapSurface to use smoother data blending and edge fading, and updates the shader for improved heatmap tinting, emission, and alpha blending. MetricRegistry now uses a high-detail thermal gradient for temperature visualization. Minor fixes to SamplePointCloud for particle color assignment.
2026-04-30 Add Live Control, WebSocket client, and metrics
    Introduce a live-control feature and richer metric support alongside documentation updates. Adds a new Control namespace (AquaOperationMode, VirtualJoystick, DifferentialDriveMixer, DriveCommand/DriveStatus, EscPulseMapper, LiveTransportEvent) and an Esp8266WebSocketClient to send/receive JSON drive/status frames. AquaMissionController was extended to manage Live vs Playback modes, UI bindings, preferences, drive command sequencing, time-based sending, and status handling. MetricRegistry was expanded with many default metrics, improved gradients, and consistent units. Large overhaul of Assets/Docs/AQUAScan.md to document topology, contracts, op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
    [demo-mission.csv]
2026-05-07 Add AQUAScan web dashboard
    [demo-mission.csv, pool-demo-mission.csv]
2026-06-07 Add RS-485 sensor pipeline and UI telemetry
    Integrate RS-485 probe telemetry end-to-end and expose it in the web UI. Key changes:
    - Firmware/Arduino/AQUAScanEscBridge: added Serial3 RS-485 receive (RX3/TX3 plus DE/RE control), forwarding of probe lines to the ESP32 (prefixed with 'R,'), RS-485 diagnostics, read budgets and larger line buffer, increased bridge/debug baud consistency (19200), and extended timeouts/status intervals. Also only neutralize drive on command timeout when armed.
    - Firmware/ESP32/AQUAScanESP32: accept forwarded 'R' sensor packets, parse CSV floats, store detailed sensor fields, broadcast sensor-only messages over websockets, include sensor fields in status JSON, saf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
2026-06-18 Add autonomous mission and sensor CSV recording
2026-06-24 Control auth: wildcard and local bypass
    Allow any Firebase-authenticated email for control in production or when VITE_AQUASCAN_ALLOWED_EMAILS='*', and add a local auth bypass for localhost when VITE_AQUASCAN_DISABLE_LOCAL_AUTH=true. Update firebaseAuth to short-circuit checks (isEmailAllowed, setup checks, subscribe, signOut) when appropriate and add a local dev user. Add unit tests for email allowlist behavior, update .env.example and README to document the wildcard and local-bypass options, and tweak the website auth note. Also add generated output artifacts (PDF/DOCX/images) from worklog rendering.
2026-10-10 Redesign AquaLabs site with 3D probe hero and new Maris
    Rebuild the marketing site in an Apple-inspired style: new global nav with
    the AquaLabs logo, AquaScan chapter nav, photography from the engineering
    portfolio, tech specs, and redesigned Applications, Company, Newsroom,
    Contact, legal and sign-in pages. Pages live in src/site/.
    The home hero is a real-time model of the probe built from its CAD files
    (public/models/aquascan-probe.glb) that expands into an exploded view on
    scroll, with smooth wheel scrolling via Lenis.
    Maris is rebuilt as a water-quality analysis tool inside the site: sample
    missions or uploaded CSV/JSON, station map, depth profiles, time series,
    findings computed from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
2026-10-10 Center the ESP32 on the probe PCB model
    Move the ESP32 dev board to the middle of the board's width, in the empty
    upper half, so traces fan out from both pin rows instead of running under
    the module. Tether pads are centered above it, test points sit beside it,
    and the ground ring now closes around the whole board edge.
2026-10-10 Rework home page around AquaLabs with AquaScan intro band
    - Hero describes AquaLabs; a field-footage loop replaces the boat title
    - "Introducing AquaScan" band: photo fading into black, metallic
    "Introducing" that shifts with scroll, three key points
    - Exploding probe section moves to the home page, ahead of the statement
    - Survey link, TSA recognition, depth graphic, and window-framed screens
    across the product, applications, about, news, and contact pages
    - Fresh field photos and Maris/control screenshots
2026-10-11 Add scroll-driven mission animation and simplify AquaScan pages
    - AquaScan page: shorter hero with a fuller description and the award
    under the buttons; the highlights become a side-view 3D mission that
    plays with the scroll (drive, lower the probe, read, map oxygen),
    using a new Blender-built boat model and the real probe
    - Applications: replace the depth illustration with a single headline
    stat; drop the testing section from the AquaScan page
    - Award reads "Top 5 Nationally"; Maris leaves the top nav; darker home
    video and whiter "Introducing"; Explore tiles reordered
